Zer0-Dayy/Hydroponics-Monitoring-System/PCB Design/Documentation/PCB Design.png

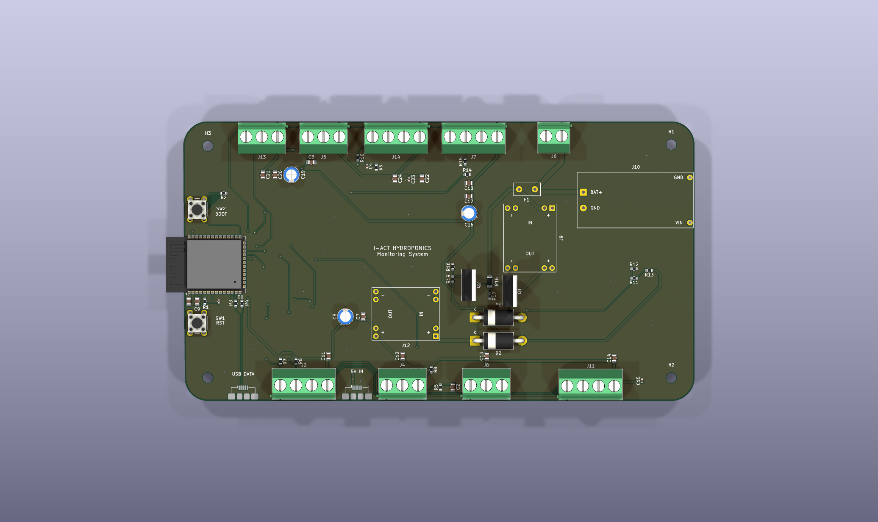
PCB Design/Documentation/PCB Design.png
