Zer0-Dayy/Hydroponics-Monitoring-System/PCB Design/Documentation/PCB Back.png

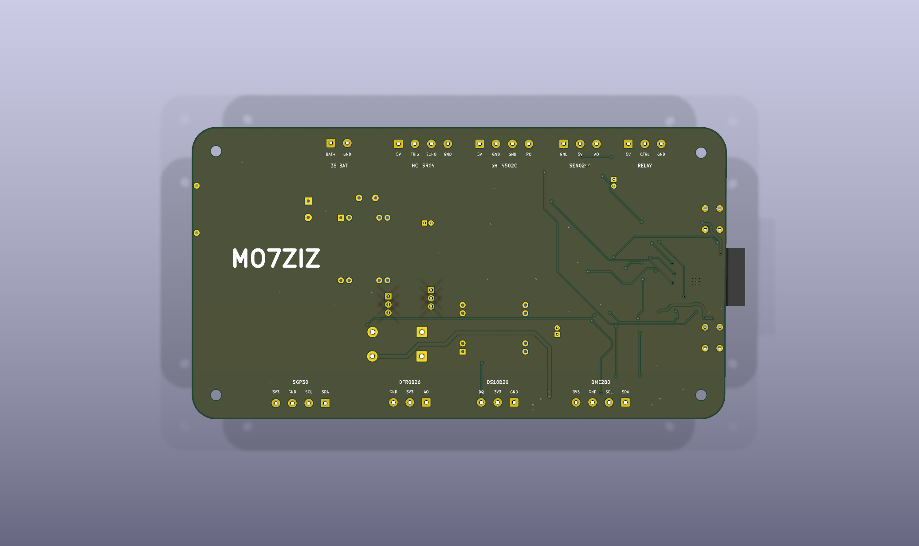
PCB Design/Documentation/PCB Back.png
