Zer0-Dayy/Hydroponics-Monitoring-System/README.md

# Hydroponics Monitoring System

The [project handover](Project%20Handover/Source%20Code/HANDOVER.md) contains earlier source material for reference.
