Zer0-Dayy/Hydroponics-Monitoring-System/Documentation/Power Tree Analysis.pdf

Choice | CN3303
Voltage | 5.00V | Voltage | 12.60V
Current | 3.00E+0 A | Current | 937.07E-3 A
65 W charger: 5 V / 3 A + 5 V / 2 A | Power | 15.00W | Power | 11.81W
Input Voltage | 5V | 3.56E+0 A | 3.00E+0 A | Charger | Boost | 3.00W | 952.38E-3 A | HX-3S-FL25A-A
937.07E-3 A | LiPo 3S 5200 mAh 35C
937.07E-3 A
I-Boost Budget | 0.95238095238
Security Coefficient | 1.2 | Efficiency | 80.0% | R (reference) | 0.100Ω | 0.094 V
Voltage | 12.600V | Voltage | 12.51V
Current | 952.38E-3 A | Current | 937.07E-3 A
Power | 12.00W | Power | 11.72W
587.08E-6 A | Q1 gate network | 489.24E-6 A 220R + 10k | 1
15.31E-3 A | Battery Auxiliaries | 12.76E-3 A Idle (A) | 0.000155
Choice | MP1584
Voltage | 5.00V | Voltage | 4.48V
Current | 423.04E-3 A | Current | 423.04E-3 A
Power | 2.12W | Power | 1.89W
423.04E-3 A | 1N5822 (D1) | 0.53V | 423.04E-3 A | 423.04E-3 A | P3V3 | Buck | 0.28W
487.61E-3 A | 426.00E-3 A | ESP32-S3
355.00E-3 A
WROOM-1 | 1
Efficiency | 90% | Efficiency | 85.0%
Voltage | 4.48V | Voltage | 3.300V | 856.80E-6 A | Air T / RH / P
714.00E-6 A
Current | 423.04E-3 A | Current | 487.61E-3 A | BME280 | 1
Power | 1.89W | Power | 1.61W
1.80E-3 A | Water temperature
1.50E-3 A
DS18B20 | 1
58.56E-3 A | Air quality (ref.)
48.80E-3 A
SGP30 | 1
396.00E-6 A | Ambient light
330.00E-6 A
DFR0026 | 1
96.06E-3 A | SL-C relay coil
80.05E-3 A
SRD-05VDC | 1
Voltage | 5.00V
Current | 37.20E-3 A
Power | 0.19W
37.20E-3 A | USB 5 V
37.20E-3 A | 18.00E-3 A | Ultrasonic
15.00E-3 A
| | HC-SR04 | 1
R (ideal) | 0.000Ω | 0.000 V
Voltage | 5.00V
Current | 37.20E-3 A
Power | 0.19W
Voltage | 5.00V
Current | 19.20E-3 A
Power | 0.10W
19.20E-3 A
Ferrite bead
19.20E-3 A | 12.00E-3 A | pH sensor
10.00E-3 A
| | PH-4502C | 1
DCR | 0.100Ω | 0.002 V
Voltage | 5.00V | 7.20E-3 A | TDS sensor
6.00E-3 A
Current | 19.20E-3 A | SEN0244 | 1
Power | 0.10W

| | | | | Choice | MP1584 | | | | | | Choice | MP1584
Voltage | 11.10V | Voltage | 11.08V | Voltage | 5.00V | Voltage | 4.99V | Voltage | 4.46V
Current | 225.35E-3 A | Current | 225.17E-3 A | Current | 424.04E-3 A | Current | 424.04E-3 A | Current | 424.04E-3 A
LiPo 3S 5200 mAh, 35C (11.1 V nominal) | Power | 2.50W | Power | 2.49W | Power | 2.12W | Power | 2.12W | 5V MAIN | Power | 1.89W
Input Voltage | 11.1V | 225.35E-3 A | HX-3S-FL25A-A / 2 A fuse | 225.35E-3 A | P5V00 | Buck | 0.37W

424.04E-3 A
| | | | | | | | IRLZ44N (Q2)

424.04E-3 A
1N5822 (D2) | 0.53V
424.04E-3 A | 424.04E-3 A
P3V3 | Buck | 0.28W
487.61E-3 A | 426.00E-3 A | ESP32-S3
355.00E-3 A
WROOM-1 | 1
Security Coefficient | 1.2 | R (reference) | 0.100Ω | 0.023 V | Efficiency | 85.0% | Rds | 0.025Ω | 0.011 V | Efficiency | 89% | Efficiency | 85.0%
Voltage | 11.08V | Voltage | 5.000V | Voltage | 4.99V | Voltage | 4.46V | Voltage | 3.300V | 856.80E-6 A | Air T / RH / P
714.00E-6 A
Current | 225.35E-3 A | Current | 424.04E-3 A | Current | 424.04E-3 A | Current | 424.04E-3 A | Current | 487.61E-3 A | BME280 | 1
Power | 2.50W | Power | 2.12W | Power | 2.12W | Power | 1.89W | Power | 1.61W
1.80E-3 A | Water temperature
1.50E-3 A
DS18B20 | 1
176.61E-6 A | Battery auxiliaries
147.18E-6 A
Idle (A) | 0.0000375 | 58.56E-3 A | Air quality (ref.)
48.80E-3 A
SGP30 | 1
396.00E-6 A | Ambient light
330.00E-6 A
USB absent: relay, HC-SR04 and pH/TDS OFF. | DFR0026 | 1
