Zer0-Dayy/Hydroponics-Monitoring-System/Documentation/Hydroponics Firmware.pdf

# Writing

# ESP32 Firmware

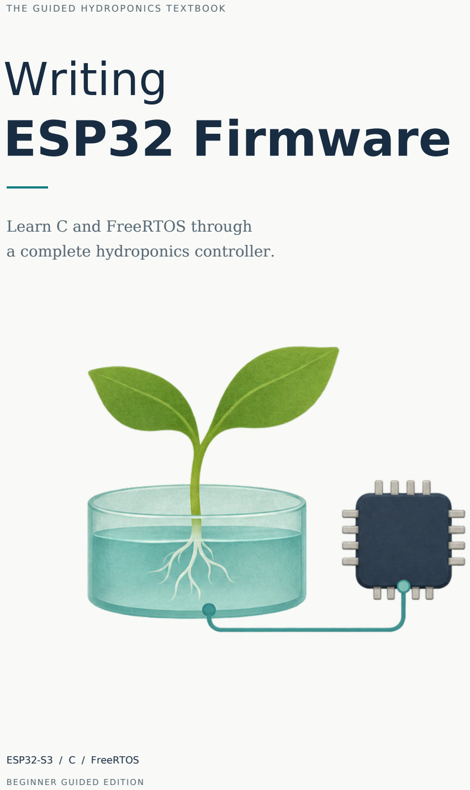
[picture p4: page 1]

THE GUIDED HYDROPONICS TEXTBOOK

## Learn C and FreeRTOS through

a complete hydroponics controller.

ESP32-S3 / C / FreeRTOS

BEGINNER GUIDED EDITION

# You are going to read

a complete controller.

### A line of firmware should tell you what changes, when it changes and which earlier fact makes that change valid. When a line is difficult, we will slow down and supply the

missing C or RTOS concept before asking you to follow it.

### The opening lessons build small examples you can calculate yourself. Then each chapter turns to the production files that use those ideas. We will read their complete source in

manageable sections. You will see declarations, normal paths, error paths and cleanup, rather than only the attractive part of a function.

### The program is a hydroponics controller for an ESP32-S3. It uses C for most application

code, FreeRTOS for task execution, and two C++ adapters for BLE and Wi-Fi libraries.

### Seven physical sensors produce ten metrics. Acquisition obtains observations; Safety

owns the relay decision; other services coordinate power, settings and communication.

### You need basic familiarity with variables, an if statement and a loop. Pointers, storage duration, queues, notifications, driver tables, callbacks and state machines are developed as the controller needs them. You can pause and use the linked earlier lesson

when a detail has faded.

### The source here is the reference implementation carried by the supplied Hydroponics firmware book. File paths and line numbers name that fixed source. We preserve its code while examining its assumptions. A comment about a design budget or a past

measurement is not a new measurement made by reading the program.

### Keep a notebook or editor beside the book. At each guard, predict which branch a concrete input takes. At each state update, name the object that changes. At each return, name the next caller that can make progress. Those small predictions connect

the language to the system.

WRITING ESP32 FIRMWARE | 2

# Read with two questions: why, then how?

### Lessons before the production files

### Begin each chapter with the worked concept lessons. The following source readings use that vocabulary immediately. The source contents pages let you reopen a file directly

when reviewing the controller.

### Every source range has a location

### The code boxes show the path and original line numbers. Every line in the supplied application, adapters, bring-up programs and native tests is present. A grey > marks a

visual continuation. It is not a character to type into the source.

### Use the links as memory aids

### Blue lesson references include printed page numbers. Function calls inside production listings also link to their implementation when the target is unambiguous. Your viewer's Back command returns from a jump. Margin notes appear only for a useful tip, pitfall or

reminder; other pages use the full reading width.

### Keep teaching code and production code distinct

### A teaching example simplifies one question. Production listings carry their real file paths. The small learning program is a separate target; its fabricated input helps you

observe task communication before connecting a probe.

### Keep the original files nearby

Reference_Firmware_Source.zip and Learning_Program.zip are embedded in this PDF.

### Extract them from a desktop PDF viewer's Attachments panel when you want to compile or compare the files. The printed ranges are for reading; the archive supplies exact

bytes.

### Ask what the next owner is allowed to assume

A copied value may still be stale. A READY driver may still report a failed observation. A

### queued command may still be waiting to apply. Each chapter follows those distinctions into the next relevant caller without requiring you to understand an unseen

implementation first.

# Contents

01 Make One Decision | 13

Begin with a value and a decision that you can trace yourself.

02 Read C As Instructions | 17

Read declarations, branches and arithmetic by predicting their results.

03 Use Addresses And Records | 22

Give a value an address, then put related values into one record.

04 Make State And Files Predictable | 28

Understand what survives a call and how a program is assembled.

05 Let Two Jobs Share A CPU | 39

Learn what the scheduler saves, selects and waits for.

06 Move Values Through Queues | 52

Make a sender and receiver exchange an actual copy.

07 Wake For A Reason Or A Deadline | 60

Use notifications for prompts, clocks for due times, and retained state for facts.

# Contents / continued

08 Protect Shared State | 70

Choose protection from the operation that must stay indivisible.

09 Write A Driver In Steps | 78

Replace a physical wait with remembered state and a due time.

10 Decide Whether A Reading Is Usable | 90

A number needs identity, timing and a validity verdict.

11 Build The Light Measurement | 114

Use one analog path to connect voltage, time, filtering and a Reading.

12 Read The BME280 Over I2C | 149

Separate bus transactions from conversion and compensation.

13 Wait For Water Temperature | 182

Use a long conversion without freezing the acquisition service.

14 Turn A pH Voltage Into A Claim | 213

Recover the module voltage, then justify its calibration.

# Contents / continued

15 Compensate The TDS Estimate | 234

Make a measurement dependency explicit instead of assuming 25 degrees.

16 Keep The SGP30 On Its Cadence | 269

Understand a driver whose past affects its present result.

17 Measure An Ultrasonic Pulse | 309

Separate microsecond edge timing from task scheduling.

18 Read The Acquisition Engine | 338

Bring the individual drivers together without giving up their timing rules.

19 Give Safety The Final Decision | 393

Combine a lamp request, alarm state and input validity in one output owner.

20 Survive A Power Transition | 463

Move ownership only after the old owner stops using shared hardware.

21 Save And Apply Configuration | 519

Separate accepting a request, storing it and using it.

# Contents / continued

22 Encode And Decode Messages | 567

Move between bounded bytes and explicit application requests.

23 Build The BLE Device Link | 628

Keep callback work short and deliver commands through their owners.

24 Manage A Wi-Fi Station | 675

Reconnect in bounded steps without borrowing the sensor path.

25 Bring The Controller To Life | 697

Start dependencies in order and observe meaningful progress.

26 Test The Pure Behaviour | 744

Supply controlled inputs and inspect the exact returned state.

27 Follow Complete Controller Events | 817

Connect code you have read into full execution paths.

# Production source contents

src/domain/types.h | 36
include/app_config.h | 47
src/drivers/sensor_driver.h | 84
src/drivers/sensor_driver.c | 89
src/domain/reading.h | 94
src/domain/reading.c | 99
src/services/snapshot_store.h | 105
src/services/snapshot_store.c | 106
src/domain/sensor_set.h | 108
src/domain/sensor_set.c | 110
src/hal/adc_channel.h | 118
src/hal/adc_channel.c | 120
src/domain/calibration.h | 122
src/domain/calibration.c | 125
src/drivers/light.h | 130
src/drivers/light.c | 133
test/bringup/bringup_harness.h | 142
test/bringup/light_main.c | 147
src/hal/i2c_bus.h | 155
src/hal/i2c_bus.c | 157
src/drivers/bme280.h | 162
src/drivers/bme280.c | 164
test/bringup/bme280_main.c | 179
src/hal/onewire_bus.h | 187
src/hal/onewire_bus.c | 189

# Production source contents

src/domain/ds18b20_codec.h | 196
src/domain/ds18b20_codec.c | 198
src/drivers/ds18b20.h | 200
src/drivers/ds18b20.c | 202
test/bringup/ds18b20_main.c | 210
src/drivers/ph.h | 218
src/drivers/ph.c | 222
test/bringup/ph_main.c | 229
src/domain/tds_codec.h | 238
src/domain/tds_codec.c | 239
src/drivers/tds.h | 240
src/drivers/tds.c | 244
test/bringup/tds_main.c | 251
test/bringup/water_main.c | 255
src/domain/sgp30_codec.h | 272
src/domain/sgp30_codec.c | 273
src/drivers/sgp30.h | 275
src/drivers/sgp30.c | 280
test/bringup/sgp30_main.c | 296
test/bringup/climate_main.c | 299
src/domain/ultrasonic.h | 314
src/domain/ultrasonic.c | 315
src/hal/pulse_capture.h | 316
src/hal/pulse_capture.c | 319
src/drivers/hcsr04.h | 325

# Production source contents

src/drivers/hcsr04.c | 327
test/bringup/hcsr04_main.c | 335
src/hal/clock.h | 345
src/hal/clock.c | 346
src/domain/schedule.h | 347
src/domain/schedule.c | 349
src/services/acquisition.h | 352
src/services/acquisition.c | 357
src/domain/alarm.h | 398
src/domain/alarm.c | 401
include/policy_config.h | 403
src/domain/alarm_sticky.h | 407
src/domain/alarm_sticky.c | 409
src/domain/event_journal.h | 411
src/domain/event_journal.c | 413
src/domain/lamp_control.h | 415
src/domain/lamp_control.c | 417
src/domain/safety_core.h | 420
src/domain/safety_core.c | 426
src/hal/gpio_safe.h | 435
src/hal/gpio_safe.c | 436
src/hal/relay.h | 437
src/hal/relay.c | 438
src/services/safety.h | 439
src/services/safety.c | 442

# Production source contents

test/bringup/lamp_main.c | 458
src/services/rail_state.h | 467
src/services/rail_state.c | 468
src/domain/power_mode.h | 470
src/domain/power_mode.c | 475
src/services/power_coordinator.h | 483
src/services/power_coordinator.c | 485
test/bringup/power_sense_main.c | 493
src/domain/cal_capture.h | 522
src/domain/cal_capture.c | 524
src/domain/config_blob.h | 526
src/domain/config_blob.c | 531
src/services/flash_gate.h | 539
src/services/flash_gate.c | 540
src/services/configuration.h | 542
src/services/configuration.c | 546
src/domain/frame_codec.h | 570
src/domain/frame_codec.c | 572
src/domain/protocol_codec.h | 576
src/domain/protocol_codec.c | 583
src/transports/protocol.h | 619
src/transports/protocol.c | 620
src/transports/frames.h | 621
src/transports/frames.c | 623
src/transports/ble_gatt.h | 633

# Production source contents

src/transports/ble_gatt.cpp | 637
src/transports/ble_transport.h | 649
src/transports/ble_transport.c | 651
src/domain/backoff.h | 677
src/domain/backoff.c | 678
src/transports/wifi_lan.h | 680
src/transports/wifi_lan.cpp | 681
src/transports/wifi_mqtt.h | 683
src/transports/wifi_mqtt.c | 685
include/board_profile.h | 701
platformio.ini | 706
src/hal/arduino_entry.h | 713
src/main.c | 714
src/diagnostics/logger.h | 718
src/diagnostics/logger.c | 719
src/diagnostics/progress.h | 723
src/diagnostics/progress.c | 724
src/services/supervisor.h | 725
src/services/supervisor.c | 727
tools/serial_log.py | 740
.gitattributes | 742
.gitignore | 743
test/native/test_domain/test_main.c | 746
test/native/test_power/test_main.c | 776
test/native/test_protocol/test_main.c | 787

CHAPTER 01 / MAKE ONE DECISION

# What must your program actually do?

### Suppose the water temperature is 24.5 degrees Celsius. Your first job is to obtain that number. Your second job is to decide whether it is suitable for a control decision. Those are different jobs: a disconnected probe can leave an old 24.5 in memory even while the

water is heating.

Teaching example - C
float waterC = 24.5f;
bool tooWarm = waterC >= 30.0f;

### Read the first line as: reserve an object named waterC that holds an approximate real number, and initialise it to 24.5. The f suffix asks for a float constant. Read the second line as: compare waterC with

30.0, then store the comparison result in tooWarm. For this input,

### tooWarm is false. If waterC becomes 31.0 before the comparison, the

result is true.

### Nothing in those two lines reads a sensor. You supplied the number yourself. This is useful: you can first check your decision with known inputs. Later, the sensor driver will supply the number. Keeping that substitution possible is the first reason to separate a decision from

hardware access.

### Why the real firmware carries more fields

### To act on a value, you will eventually need its unit, its age and an indication of whether the measurement succeeded. We will build that record after learning structures. For now, keep one question in mind: what evidence would make this number safe to use?

### In the project, DS18B20 is the water-temperature sensor. The driver produces observations; a service decides how to use them. You do not need either file yet. We will open the driver in the water-temperature chapter (p. 182), when a long conversion gives us

a reason to organise time.

TIP

The 30.0 threshold is a
teaching value. It is not a commissioned limit for
your plants.

COMMON PITFALL

A plausible number is not
proof of a connected or
working sensor.

CHAPTER 01 / MAKE ONE DECISION

# Why one long wait causes trouble

Start with one loop. It asks for a water-temperature conversion,

### waits 750ms, reads the result, and checks the lamp. Assume the

instruction that waits really prevents this loop from advancing.

Teaching pseudocode - helper bodies deliberately omitted
for (;;) {
beginWaterConversion();
waitUntilWaterIsReady(); // up to 750ms readWaterResult();
updateLampDecision();
}

### If you press a lamp-off button 1ms after the wait begins, this loop cannot reach the lamp decision for roughly another 749ms. Making the CPU clock twice as fast does not halve a sensor's physical

conversion time. The delay is in the order of operations.

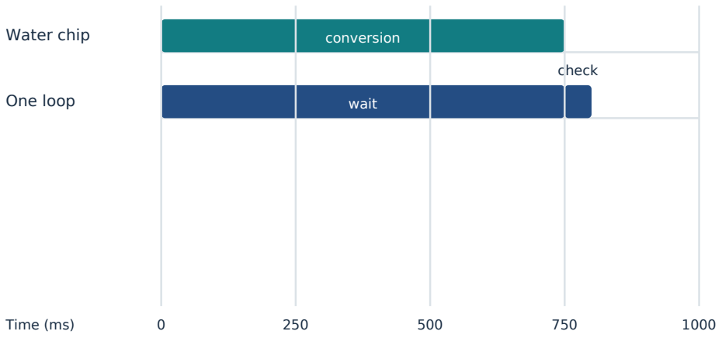
[picture p5: figure]
Water chip; conversion; One loop; wait; check; Time (ms)

Worked example: the sensor is busy while the loop postpones the lamp check.

You have two possible repairs. First, turn the sensor operation into steps: start it, remember when it should finish, and return to other work. Second, put independent work into separate RTOS tasks so one task can wait while another runs. Our firmware uses both repairs. A task organises a service; a stepped driver avoids making

that service wait for every physical conversion.

### Do not choose a task merely because you have a sensor. Seven sensors do not automatically require seven tasks. They may share

buses and benefit from one owner. We will earn that design later, after a two-task example makes waiting concrete.

REMEMBER

A loop only advances when
the current call returns.
Other RTOS tasks may run
if that call blocks through the RTOS.

CHAPTER 01 / MAKE ONE DECISION

# Separate the question from the pin

Teaching example - C
bool waterIsTooWarm(float waterC) { return waterC >= 30.0f;
}

### Call waterIsTooWarm(24.5f). The argument 24.5 is copied into the parameter waterC. The comparison produces false, and return hands that result to the caller. Call it with 31.0f and it returns true. The

function neither knows a GPIO number nor reads a bus.

### Now imagine the physical probe moves to a different pin. You should change the hardware setup, not the comparison. Conversely, a new agreed limit should not force you to rewrite the sensor protocol. That

is a concrete reason for the project's folders.

Folder | Question it answers
hal/ | How do I operate this ESP32 peripheral?
drivers/ | How do I ask this sensor for a measurement?
domain/ | What does this value or event mean?
services/ | When do operations run, and who owns their state?
transports/ | How do external messages enter and leave?

### HAL means hardware abstraction layer: a small set of functions that

hide the peripheral-specific calls. For example,

### adcChannelReadMilliVolts() obtains a voltage. The light driver uses that voltage to produce a Reading. Safety later decides whether the

lamp should be on. Each step has a different reason to change.

### For the next few chapters, we will write tiny functions like the one above. We will not start by memorising the folder tree. When we return to the tree in startup (p. 697), you will already understand the

operations it connects.

COMMON PITFALL

Putting every function in a separate file does not
create a good architecture. Separate responsibilities
that need different
information or change for
different reasons.

CHAPTER 01 / MAKE ONE DECISION

# Trace the value before adding machinery

### Here is a complete small C program for your computer. It uses invented input, so you can check the decision without a sensor or an

ESP32.

Teaching example - C
#include <stdbool.h>

#include <stdio.h>

static bool waterIsTooWarm(float waterC) { return waterC >= 30.0f;
}

int main(void) {
float waterC = 31.0f;
bool tooWarm = waterIsTooWarm(waterC); printf("warm=%d\n", (int)tooWarm); return 0;
}

### Execution enters main(), creates waterC, and calls the function with its value. The called function creates its parameter, evaluates 31.0 >= 30.0, and returns true. printf prints warm=1. The cast (int) makes the intended integer argument explicit. main returns zero to

report normal termination to your computer.

### On a PC with GCC, save this as first.c and run gcc -std=c11 -Wall -Wextra first.c -o first, then run ./first. Change only 31.0f to 24.5f; the printed result becomes warm=0. If you remove the function call, no

decision is computed automatically.

### The ESP32 project starts differently: Arduino calls setup(), and setup creates long-lived tasks. We will reach that entry point in the boot chapter (p. 697). The function call and value-copy rules you just

traced stay the same.

### You can now explain a tiny path from input to output. The next chapter adds enough C to express that path reliably. We will

introduce each operator where it changes the program's behaviour.

TIP

main() here is a PC entry
point. Do not paste it into the production firmware as another entry point.

CHAPTER 02 / READ C AS INSTRUCTIONS

# A declaration gives a value a place

Teaching example - C
#include <stdint.h>

#include <stdbool.h>

uint32_t elapsedMs = 750;
float waterC = 24.5f;
bool valid = true;

### uint32_t is an unsigned integer type with exactly 32 bits. It can represent 0 through 4294967295. It has no negative values. float can represent fractions, approximately. bool holds false or true. Choosing a type states which values you expect and which operations make

sense.

### The text after = is an initializer. It supplies an object's first value. An ordinary local declaration such as uint32_t elapsedMs; does not give you a meaningful starting number. Reading that local before

assigning a value is an error. Set a starting value when you create it.

### Names and types do different jobs

Teaching example - C
typedef uint64_t MonoMs;
MonoMs now = 1000;
MonoMs deadline = now + 750;

### typedef gives an existing type another name. MonoMs helps you remember that the number is monotonic milliseconds: elapsed time within this run, unaffected by a correction to the calendar clock. It does not create a clock and does not prevent you from accidentally

assigning microseconds. In this example, deadline becomes 1750. Our project defines this alias in src/domain/types.h.

### A semicolon ends a declaration or expression statement. Braces group a function body or control-flow body. Indentation helps you read the grouping; C uses the braces, not the indentation, to decide it. We will use braces even around short if bodies in teaching

examples.

### The exact-width types come from stdint.h; bool in this C11-style source comes from stdbool.h. An include makes those declarations

available to the compiler. It does not read a sensor or run a function.

COMMON PITFALL

uint32_t is a type, not a
unit. A variable containing 750 could mean
milliseconds, microseconds or ADC counts; your
naming and interface must
say which.

CHAPTER 02 / READ C AS INSTRUCTIONS

# Read a function call in both directions

Teaching example - C
static float echoToMm(uint32_t widthUs) { return (float)widthUs * 343.0f / 2000.0f; }

float distanceMm = echoToMm(1000);

At the call, evaluate the argument 1000. Copy it into widthUs. Enter the body. Convert the integer to float, multiply by 343.0, divide by 2000.0, then return 171.5. The caller stores that result in distanceMm. A return type tells you what comes back; the parameter list tells you what must go in.

void as a return type means there is no returned value. void in an otherwise empty parameter list means the function takes no parameters. A function can still change objects through pointer parameters; we will introduce that mechanism in output parameters (p. 23).

### A local name does not escape with the result

widthUs is a parameter local to this call. Returning its calculated value does not give the caller access to that parameter object. If another call uses 2000, it gets its own parameter value and returns 343.0. Keep this copy behaviour in mind: a normal argument does not let the function rewrite the caller's variable.

A grey > at the start of a displayed code line marks a wrapped continuation. It is a page-layout mark, not a character to type into your C source. The attached source retains its original lines.

The initial static makes this function name private to this C translation unit. For now, read it as: this helper is for this file. We will separate that meaning from persistent storage in the static lesson (p. 28).

This calculation will be useful in the ultrasonic chapter (p. 309). There, an interrupt will provide widthUs. The arithmetic will remain simple because we will have separated obtaining the pulse width from converting it.

### The speed 343m/s is the reference firmware's nominal value. It is not temperature

compensated.

CHAPTER 02 / READ C AS INSTRUCTIONS

# Reject a bad input before using it

Teaching example - C
bool accepted = false;
if (valid && waterC >= 30.0f) { accepted = true;
}

### && means logical AND. C evaluates valid first. If it is false, the second comparison is not evaluated. If it is true, C evaluates waterC >= 30.0f. Only two true operands enter the body. This evaluation

order is called short-circuit evaluation.

### Read valid && waterC >= 30.0f in order: first decide whether the observation is eligible; then compare its number. A guard is an early check that rejects an input before an operation that requires it. The next chapter will apply the same order to a pointer: check that an

object exists before reading through its address.

Expression | Meaning
a = b | Assign b to a.
a == b | Compare for equality.
a != b | Compare for inequality.
!ready | True when ready is false.
a || b | True when either operand is true.

### A comparison does not remember a previous decision. Each evaluation uses the values available then. To keep the lamp's previous command inside a threshold band, we will need a stored state, not just a longer condition. You will see that in lamp hysteresis

(p. 393).

COMMON PITFALL

if (ready = true) assigns
true and then tests it. It usually enters the branch. Use == for comparison, or
simply if (ready).

REMEMBER

&& and || can skip their
right operand. Put a
required safety check
before the operation it
protects.

CHAPTER 02 / READ C AS INSTRUCTIONS

# Units decide the arithmetic

Teaching example - C
uint32_t widthUs = 1000;
float wrong = widthUs / 2000;
float right = (float)widthUs / 2000.0f;

### Both operands of the first division are integers. The quotient is the integer 0; assigning it to float later gives 0.0. The second expression performs floating-point division and gives 0.5. The destination type

does not change an operation that has already happened.

### For distance, multiply by speed as well: 1000 microseconds times 343 metres per second equals 343000 micrometres. Divide by two for the outgoing and returning path, then by 1000 to convert micrometres to millimetres. That gives 171.5mm. The code combines

those last factors as /2000.0f.

### Bits are useful when several yes/no facts travel together

Teaching example - C
uint16_t flags = 0;
flags |= (1u << 3);
bool late = (flags & (1u << 3)) != 0;

1u << 3 moves the one bit three places left: binary 00001000,

### decimal 8. |= keeps existing set bits and adds this one. & keeps only

the bit positions present in both operands. Here late becomes true.

### The firmware uses this pattern for qualityFlags; a measurement may

be both uncompensated and late.

### Integer overflow is another reason to inspect operands. If a

multiplication needs 64 bits, cast an operand before multiplying.

### Writing uint64_t result = (uint64_t)a * b makes that multiplication

wide; casting the already-overflowed result would be too late.

COMMON PITFALL

0.1 is not stored exactly in ordinary binary float.
Compare measured values
with meaningful
tolerances, not equality
tests against every decimal you expect.

REMEMBER

& has two meanings:
bitwise AND between
values, and address-of
before one object. The
position tells you which
meaning applies.

CHAPTER 02 / READ C AS INSTRUCTIONS

# Read a byte before interpreting it

Teaching example - hexadecimal notation
uint16_t raw = 0x0190; | // the same number as 400
uint8_t high = 0x01; | // 1
uint8_t low | = 0x90; | // 144
// 1 * 256 + 144 = 400

The prefix 0x writes an integer in base 16. Its digits are 0 through 9,

### then A through F for ten through fifteen. Moving one digit left

multiplies its place value by 16. Thus 0x90 means 9 times 16, or 144.

### Hexadecimal does not change the number stored; it gives you a

convenient way to see groups of four bits.

On this target, a byte is eight bits. Two hexadecimal digits describe one byte, and a sixteen-bit quantity occupies two bytes. high and low above name the numerical parts of 400. A device protocol still decides which byte travels first. DS18B20 sends low first; the gas protocol sends its word's high byte first. We will decode each from its

own documented order.

### The suffix u, as in 1u, requests an unsigned integer constant. The f in 24.5f requests float. These suffixes affect C arithmetic types; neither suffix adds a physical unit. A field called raw could contain ADC counts, a temperature code or microseconds, so its interface must

state the interpretation.

REMEMBER

Representation comes first: bytes, order and scale. The physical unit comes from
the driver contract.

CHAPTER 03 / USE ADDRESSES AND RECORDS

# A pointer stores an address

Teaching example - C
float waterC = 24.5f;
float *p = &waterC;
*p = 26.0f;

### waterC is the object holding a float. &waterC asks for its address. p is a second object, a pointer, which stores that address. *p means the float object at the address stored in p. The final assignment therefore

changes waterC to 26.0. It does not replace p's address.

Pointer p
stores 0x1000

Object value
26.0 at 0x1000

*p

&value gives the address; *p uses the object there.

Illustrative addresses: the actual numeric addresses depend on the build.

### In a declaration, float *p says that p has pointer-to-float type. In an expression, *p accesses the pointed-to object. The same symbol appears in two different grammatical roles. Read the full statement

before deciding what the star does.

### Copying p copies an address. It does not create another waterC. If q = p, then *q and *p refer to the same float. Changing that object through either pointer is visible through the other. This will matter

when two tasks receive addresses into shared memory.

### A pointer is useful only while the target object exists and the address is appropriate for that type. NULL is a deliberate missing pointer. An uninitialised pointer is not a useful substitute for NULL. Do not

dereference either one.

### We will use & when asking a queue to copy an object, and * when a helper fills caller-owned storage. Neither operation means that a

task automatically gets private or protected memory.

COMMON PITFALL

float *p creates a pointer object. It does not reserve another float for p to point to. Supply the address of a real object before using *p.

CHAPTER 03 / USE ADDRESSES AND RECORDS

# Let a function fill your object

Teaching example - C
static bool readFake(float *out) { if (out == NULL) {
return false;
}
*out = 24.5f;
return true;
}

float waterC = 0.0f;
bool ok = readFake(&waterC);

### At the call, &waterC is copied into out. The pointer itself is passed by

value, just like the earlier integer parameter. Inside the function,

### *out = 24.5f follows that copied address and changes the caller's

waterC. The function returns true separately to report success.

### You now have two outputs with different purposes: waterC contains the measurement, and ok tells you whether the function supplied one. If readFake returns false, the caller must not pretend a fresh

result exists. This is the pattern behind many HAL functions.

### This will be useful when the ultrasonic HAL writes the captured width into a variable supplied by its caller. We will already understand the output-parameter syntax when we reach

pulseCapturePoll().

COMMON PITFALL

readFake(waterC) passes
the number.
readFake(&waterC) passes
its address. The function
declaration tells you which one it needs.

REMEMBER

Return values often report success or status; pointer parameters can carry the
actual data.

CHAPTER 03 / USE ADDRESSES AND RECORDS

# Keep facts about one result together

Teaching example - C
typedef struct {
float valueC;
uint64_t measuredMs;
bool valid;
} Sample;

Sample a = { .valueC = 24.5f, .measuredMs = 1000,
.valid = true };

### A structure groups several fields into one object. a.valueC selects the float field inside a. a.measuredMs selects its timestamp. The dot in the initializer names the field being initialised; the dot in a.valueC selects the field later. Initializers with field names make a long

record easier to check.

Teaching example - C
Sample b = a;
a.valueC = 99.0f;

### The assignment copies the record's field values. b.valueC remains 24.5. b does not become another name for a. This is the reason a queue can pass a small measurement by copy: the receiver can own

its own record after the sender continues.

### Be careful when a structure contains pointers. Copying such a structure copies its pointer fields, not the objects those pointers

identify. Two copied pointer fields can still reach the same buffer.

### Our simple Sample has only values, so it avoids that extra ownership

problem.

### The project's Reading is a larger record with the same purpose. It keeps a value, identity, unit, timing and validity information together. We will open its complete declaration in the Reading lesson

(p. 90), after we know why tasks need a message.

COMMON PITFALL

Do not send a native C
structure directly as a
network format. Padding,
byte order and type
representation need an
explicit encoding.

REMEMBER

The compiler may insert
padding between fields to
meet alignment rules.
sizeof(Sample) can exceed
the sum of field sizes.

CHAPTER 03 / USE ADDRESSES AND RECORDS

# Read the arrow and const precisely

Teaching example - C
Sample a = { .valueC = 24.5f, .valid = true }; Sample *p = &a;
p->valueC = 26.0f;

p->valueC means (*p).valueC: follow the pointer, then select a field.

### The arrow combines those two operations. a.valueC uses a structure object directly. p->valueC uses a pointer to one. The final line

changes a.valueC to 26.0.

Teaching example - C
const Sample *view = &a;
Sample *const fixed = &a;

### Through view, you may read the Sample but may not change its fields. You may assign view another address. fixed is a pointer whose stored address cannot change after initialisation, but its target remains writable. Thus fixed->valueC = 27.0f is allowed; fixed =

anotherPointer is not.

Declaration | What is restricted?
const Sample *p | Changes through p to the Sample.
Sample *const p | Changes to p's address.
const Sample *const p | Both forms of change through this declaration.

### const describes access through a declaration. It is not a lock. If another permitted pointer changes a, view can observe the new value. It also does not extend a's lifetime. We will use const Reading * when a rule should inspect a measurement without editing the

supplied record.

### When you see const SensorDriverOps *ops later, read it as a pointer to an operations table that this access path cannot modify. We will build that table only after a stepped driver gives us a reason to call

different implementations.

COMMON PITFALL

const does not make a
shared record immune to
concurrent writes.
Synchronisation is a
separate question.

CHAPTER 03 / USE ADDRESSES AND RECORDS

# Read a real output-parameter call

You can now read both the output pointers and the arrow in a real HAL helper. AdcChannel is a

### record describing one ADC channel. Its pin_ field holds the assigned GPIO number. We will

examine the ADC setup and clipping threshold in the analog chapter; here, follow where the returned information is written.

Original firmware - src/hal/adc_channel.c, lines 23-32
bool adcChannelReadMilliVolts(AdcChannel* ch, uint32_t* mv, bool* saturated) { if (mv) *mv = 0;
if (saturated) *saturated = false;
if (ch->pin_ < 0) return false;
// eFuse-calibrated conversion (esp_adc_cal). One conversion, a few tens of us. const uint32_t value = analogReadMilliVolts((uint8_t)ch->pin_);
if (mv) *mv = value;
if (saturated) *saturated = value >= kSaturationMv;
return true;
}

### Here mv and saturated are output pointers. The HAL can return a voltage through one and a

clipping indication through the other. if (mv) tests whether the pointer is non-null before writing through it. value is an ordinary local number returned by the Arduino ADC function.

The source allows omitted outputs by accepting NULL, but a teaching helper does not have to. Decide whether an output is required and enforce the contract. A pointer parameter alone does not tell you whether NULL is permitted.

### Follow a successful call with local variables voltageMv and clipped. The caller supplies &voltageMv and &clipped. Inside the function, mv and saturated hold those addresses. *mv

writes the voltage into the first caller object; *saturated writes a true/false clipping result into the second. The returned bool is a third result: whether the call could perform this operation.

### The earlier readFake example (p. 23) required its output pointer. This HAL permits either

output to be omitted. Read the null checks in each interface rather than assuming every pointer parameter follows the same rule.

CHAPTER 03 / USE ADDRESSES AND RECORDS

# Arrays provide storage; pointers do not count it

Teaching example - C
uint32_t samples[4] = {100, 101, 99, 102};
uint32_t first = samples[0];
size_t count = sizeof(samples) / sizeof(samples[0]);

### This array reserves four consecutive uint32_t objects. The valid indices are 0, 1, 2 and 3. samples[4] is outside the array. first becomes 100, and count becomes 4 because the expression still sees

the actual array object.

Teaching example - C
static float mean(const uint32_t *values, size_t n) { uint64_t sum = 0;
for (size_t i = 0; i < n; ++i) {
sum += values[i];
}
return n ? (float)sum / (float)n : 0.0f; }

### At a call such as mean(samples, 4), the array expression supplies a pointer to its first element. The function does not receive the array's size automatically. n is the length the caller promises. The loop visits exactly n elements. A false promise can make it read outside valid

storage.

++i adds one to i. The condition i < n is checked before each visit.

### The ?: operator chooses its middle expression when n is nonzero and

its last expression when n is zero. Here it prevents division by zero,

### although a production interface might report an explicit error

instead.

### size_t is an unsigned integer type used for object sizes and array lengths; sizeof produces a size_t result. Include stddef.h when a standalone C file needs that type. A size_t can hold a size supported

by the target, but it does not make an incorrect buffer length safe.

### Strings are byte arrays with a zero byte marking the end. A char buffer[8] can hold at most seven ordinary single-byte characters plus that terminator. A received radio payload is not automatically a terminated string; later we will pass an explicit length into its

decoder.

COMMON PITFALL

A pointer and a length
must agree. Checking n
alone does not prove that
values points to n real
elements.

REMEMBER

sizeof(pointer) is the size of an address object, not the length of the buffer behind it.

CHAPTER 04 / MAKE STATE AND FILES PREDICTABLE

# What static actually keeps

Teaching example - C
static uint32_t countVisits(void) { static uint32_t count = 0; ++count;
return count;
}

Call this function three times during one run. It returns 1, then 2,

### then 3. The local static count exists for the program's lifetime, even

while no call is executing. Its name is visible only inside this function. A normal local initialised to zero would start over on each call.

The first static, before the function's return type, has a different role.

### It gives the function name internal linkage: another separately compiled C file cannot call it by that name. It does not make a private

task stack or prevent two tasks from calling the function together.

Teaching example - C
static Sample latest; // file scope

At file scope, static keeps the name private to this translation unit.

### The object also has static storage duration. A file-scope object without static would still live for the program's lifetime; the visibility of its name would differ. Static-storage objects without an explicit

initializer are zero-initialised before application execution.

Persistent in this context means until reset or program termination.

### It does not mean saved in flash. To retain calibration across an ESP32 reboot, the Configuration service writes NVS, which we will

study in saved configuration (p. 520).

### If two tasks call countVisits(), they share the same count. ++count is a read-modify-write sequence. Without protection, concurrent calls can lose an increment. A private C name is not a synchronisation mechanism. This distinction will matter when we inspect the

acquisition module's static driver objects.

COMMON PITFALL

static is not one copy per task. A static local belongs to the program, even when
its declaration sits inside a task function.

CHAPTER 04 / MAKE STATE AND FILES PREDICTABLE

# Keep an address valid for long enough

Teaching counterexample - deliberately incorrect
static Sample *badAddress(void) {
Sample temporary = { .valueC = 24.5f }; return &temporary; // invalid after return }

### temporary has automatic storage duration. Once the function returns, that object's lifetime ends. Its old address does not become safe because the bytes happen to remain unchanged for a while. A

later call may reuse the storage. Do not use the returned pointer.

Storage | When does the object stop existing?
Automatic local | At the end of its enclosing block; each call has its own instance.
Static object | At program termination or reset in this firmware.
Allocated heap block | When released with the matching allocator's free operation.

### A task keeps its current automatic locals while it is blocked. Blocking is not returning from the function. The RTOS preserves the task's execution state so it can resume. This is why a local variable inside a

task loop can still be valid after xQueueReceive waits.

Heap allocation asks for storage at runtime. You must check failure,

### decide who owns the block, and free it exactly once when appropriate. The project often supplies static queue storage and task stacks instead. That makes much of its memory reservation visible

before tasks begin.

Static allocation does not prove that the reservation is large enough. Stack overflow is still possible, and a buffer index can still be wrong.

### We will inspect actual stack usage and checks in debugging memory

(p. 699).

REMEMBER

A queue that copies a
record can safely copy a
local before it goes out of scope. A queue that copies its pointer does not extend that local's life.

CHAPTER 04 / MAKE STATE AND FILES PREDICTABLE

# A header lets the compiler check a call

Teaching example - two files shown together
// water.h
#pragma once

#include <stdbool.h>

bool waterIsTooWarm(float waterC);

// water.c
#include "water.h"

bool waterIsTooWarm(float waterC) { return waterC >= 30.0f;
}

### The header declares the interface: function name, return type and parameter types. The .c file defines the body. A caller includes water.h so the compiler can check its arguments. The compiler builds each source file into an object file; the linker then resolves

calls between those object files.

### #include is a preprocessing operation. It makes header text available

while compiling. It does not call the functions declared there.

### pragma once prevents a header from being processed repeatedly in one translation unit on this toolchain. A translation unit is one source

file after its includes and preprocessing have been applied.

Teaching example - C
// in a header
extern uint32_t sampleCount; // in exactly one .c file
uint32_t sampleCount = 0;

COMMON PITFALL

Do not put ordinary
writable global definitions in a header included by
several .c files. You may
create multiple definitions rather than one shared
object.

CHAPTER 04 / MAKE STATE AND FILES PREDICTABLE

### A header lets the compiler check a call / continued

extern declares an externally defined object without making another ordinary definition here. Prefer functions that return copies of shared state when you can; a globally writable object makes ownership harder to see. The firmware's snapshotPeek() interface is an example we will read in the snapshot store (p. 57).

You will also see small function bodies written as static inline in a header. static gives each

### translation unit its own internally linked helper. inline allows the compiler to consider

expanding that helper at a call site; it does not guarantee that choice or create a task. The shared types header uses this form for small timestamp comparisons.

If compilation fails, ask whether a declaration or type is visible. If linking fails with an undefined reference, ask whether the defining source was built and whether its symbol has the expected linkage. These are different stages, so they need different repairs.

CHAPTER 04 / MAKE STATE AND FILES PREDICTABLE

# Name outcomes instead of guessing numbers

Teaching example - C
typedef uint8_t Status;
enum { STATUS_OK = 0, STATUS_PENDING, STATUS_FAULT };

Status st = STATUS_PENDING;
if (st == STATUS_PENDING) {
// The operation has not finished yet. }

### The anonymous enum supplies named integer constants. With the

explicit zero first, STATUS_PENDING is 1 and STATUS_FAULT is 2.

### The typedef makes Status an alias for uint8_t. This project uses that

pattern to keep record fields small and their intent readable.

### The name is a reading aid, not a distinct type barrier: Status and another uint8_t alias can still be assigned to one another in C. Use clear parameter names and checks where an accidental interchange

would matter.

### Completion and validity are different questions

### A driver can finish an operation and report that the measurement failed. In this project, DRIVER_READY means the driver has an outcome available. The returned Reading may carry HEALTH_TIMEOUT or HEALTH_FAULT. READY does not guarantee

a usable physical value.

### Why keep both? The acquisition engine needs to know when it can collect an outcome and start scheduling the next job. A consumer needs to know whether the stored number may be used. Combining

those questions into one boolean would hide useful information.

### The production driver interface will use a PollResult record

containing a status and the earliest sensible time to poll again.

### Before opening that interface, read two more C operations used throughout these files: selecting a named status and copying a byte

range. Then we can ask what an RTOS task does while it waits.

COMMON PITFALL

Do not write if (status)
unless the interface defines truthiness. STATUS_OK is
zero here, so a successful outcome would test false.

CHAPTER 04 / MAKE STATE AND FILES PREDICTABLE

# Choose one branch with switch

Teaching example - uses Status from the previous lesson
static const char *statusName(Status st) { switch (st) {
case STATUS_OK: | return "OK";
case STATUS_PENDING: return "PENDING";
default: | return "FAULT";
}
}

### switch evaluates st, then begins at the case whose integer constant matches. With STATUS_PENDING, execution starts at the second case and returns the string "PENDING". default handles a value that matches no listed case. Here the return type is a pointer to

characters that this function does not permit you to change.

A case label does not automatically end its branch. In this example,

### return ends the whole function. In a branch that should continue

after the switch, break exits just the switch. Without either,

### execution continues into the following case; this is called

fall-through.

Teaching fragment - accepted is a previously declared bool
switch (st) {
case STATUS_OK:
case STATUS_PENDING:
accepted = true;
break;
default:
accepted = false;
break;
}

### The two adjacent labels deliberately share one body. Either OK or

PENDING assigns true, then break skips the default branch. Later,

### reading.c groups several metric labels this way because one BME280 produces temperature, humidity and pressure. You now know why

several cases can lead to one return.

COMMON PITFALL

A missing break can
execute the next case
body. Check where every
branch actually ends.

CHAPTER 04 / MAKE STATE AND FILES PREDICTABLE

# Copy the bytes of a complete object

Teaching fragment - Sample was defined in the records lesson
#include <string.h>

Sample a = { .valueC = 24.5f,
.measuredMs = 1000, .valid = true }; Sample copied;
memset(&copied, 0, sizeof(copied)); memcpy(&copied, &a, sizeof(copied));

### memset receives a destination address, a byte value and a byte count. This call fills every byte of copied with zero. It does not fetch a

measurement. memcpy then receives destination, source and count; it replaces those bytes with the complete representation of a. string.h declares both functions.

After the copy, copied.valueC is 24.5, copied.measuredMs is 1000 and copied.valid is true. Changing a.valueC afterward does not change copied.valueC. For this record, copied = a would be the clearer ordinary assignment. The byte functions matter because you will also see fixed buffers, queue storage and checksum-covered

records.

The count is sizeof(copied), the size of the whole destination object,

### including any padding. sizeof(&copied) would instead give the size of a pointer and copy the wrong amount. Both addresses must name enough live storage; memcpy does not check your promise. Its ranges must not overlap. Use memmove when the ranges can

overlap, as when shifting an existing byte history.

### Zero-filled bytes are not a universal constructor for every C type. Use the type's initializer or reset helper when you need a meaningful

initial state. In this example the complete copy follows immediately, so we do not interpret the intermediate zero-filled record. Later,

### ConfigBlob deliberately initialises its bytes before calculating a

checksum that also covers padding.

REMEMBER

A byte count describes
storage. It does not prove that the address points to that much storage.

CHAPTER 04 / MAKE STATE AND FILES PREDICTABLE

# Choose code before the program runs

Teaching fragment - preprocessing choices
#define SAMPLE_PERIOD_MS 1000u

#ifdef FW_ENABLE_BLE

void startRadio(void);
#endif

### A macro is a name the preprocessor replaces while preparing a source file for compilation. SAMPLE_PERIOD_MS becomes the token 1000u wherever this macro is used. The define does not create a writable variable, reserve a timer or make a task periodic. A later

function call must use that value to do something.

### #ifdef asks whether a macro name is defined. Its enclosed text

reaches the compiler only in that case. #endif closes the choice;

### else can supply another branch. This differs from a C if statement: an ordinary if chooses while the program runs, whereas

preprocessing chooses which source is compiled into the image.

### A build option such as -D FW_ENABLE_BLE=1 defines the name without adding a define line to the source. With #ifdef, even defining it as zero still counts as defined. The firmware uses these choices to omit radio implementations from isolated bring-up images. You will

recognise those blocks before needing to understand their contents.

### The shared types header follows the enum lesson because it uses enum, typedef and static inline together. Later headers reuse those names through #include. The chain is now concrete: preprocessing supplies declarations, compilation checks each file, and linking

connects the built functions.

Reference: WG14: public C11 committee draft N1570 (https://www.open-std.org/jtc1/sc22/wg14/www/docs/n1570.pdf)

COMMON PITFALL

Changing a macro changes
the next build. It cannot
change the program
already flashed onto the
board.

CHAPTER 04 / MAKE STATE AND FILES PREDICTABLE

# Give time an explicit representation

### You can now read typedef, enum, static inline and a header declaration. This production header combines those ideas into the vocabulary every other file uses: timestamps, sensor identity, metric

identity and units.

### A Reading uses these names later; for now recognise which category each field belongs to. Review the enum lesson (p. 32) for the

numbered names before following their production lists.

src/domain/types.h / lines 1-14
1 // Basic shared types. Domain layer: pure C, no
> Arduino/FreeRTOS includes.
2 //
3 // Enumerations are stored as uint8_t (the typedefs below) > with the values in
4 // an anonymous enum. This keeps every record exactly the > size it had with the
5 // C++ `enum class X : uint8_t` types (queue item sizes, > RAM).
6 #pragma once
7 #include <stdbool.h>
8 #include <stdint.h>

9
10 // Monotonic milliseconds since boot. Used for every age and > deadline.
11 // Never wall-clock/NTP time (§8). 64-bit so it does not
> wrap in practice.
12 typedef uint64_t MonoMs;

13
14 static inline bool monoReached(MonoMs now, MonoMs deadline) monoReached > { return now >= deadline; }

MonoMs names a 64-bit unsigned integer whose unit is milliseconds.

### The alias makes intent visible while leaving ordinary integer arithmetic available. monoReached compares two timestamps; it does not wait or schedule anything. If now is 1749 and deadline is

1750, the return is false. At 1750 it is true.

The inline helper lives in the header so each caller sees its definition. static keeps a separate internal name in each translation unit.

### Neither keyword creates an RTOS task. We will supply now from the

monotonic clock rather than a calendar clock.

COMMON PITFALL

A type alias cannot detect a microsecond value
accidentally assigned to a millisecond variable.

CHAPTER 04 / MAKE STATE AND FILES PREDICTABLE

# Name sensors separately from measurements

src/domain/types.h / lines 15-41

15
16 typedef uint8_t SensorId; 17 enum {
18 | SENSOR_BME280 = 0,
19 | SENSOR_DS18B20,
20 | SENSOR_LIGHT, | // DFR0026
21 | SENSOR_HCSR04,
22 | SENSOR_PH, | // pH-4502C
23 | SENSOR_TDS, | // SEN0244
24 | SENSOR_SGP30, | // TVOC / CO2eq (replaced the MQ-7, D18)
25 | SENSOR_COUNT

26 };

27
28 // One entry per published metric. A sensor may produce > several metrics.
29 typedef uint8_t MetricId;
30 enum {
31 | METRIC_AIR_TEMPERATURE = 0, | // BME280
32 | METRIC_AIR_HUMIDITY, | // BME280
33 | METRIC_AIR_PRESSURE, | // BME280
34 | METRIC_WATER_TEMPERATURE, | // DS18B20
35 | METRIC_LIGHT_LEVEL, | // DFR0026 (mV until
> | calibrated, then lux)
36 | METRIC_WATER_DISTANCE, | // HC-SR04
37 | METRIC_PH, | // pH-4502C
38 | METRIC_TDS, | // SEN0244
39 | METRIC_TVOC, | // SGP30, ppb
40 | METRIC_CO2EQ, | // SGP30, ppm (estimate, not
> | measured CO2)
41 | METRIC_COUNT

### SensorId identifies a physical device. MetricId identifies one reported quantity. Count the BME280 entries: one sensor produces temperature, humidity and pressure. SGP30 contributes TVOC and

CO2eq. This is why the counts differ.

### The enumeration starts at an explicit zero and increments each following value. SENSOR_COUNT and METRIC_COUNT are sentinels used for array bounds; they are not real devices or observations. A loop with index < METRIC_COUNT visits every valid

metric index without visiting the sentinel.

COMMON PITFALL

SensorId and MetricId are
both uint8_t aliases. Their different names explain
intent but do not make
accidental interchange a C type error.

REMEMBER

Review named status
values (p. 32) for enum
numbering and number
notation (p. 21) for the
byte representation.

CHAPTER 04 / MAKE STATE AND FILES PREDICTABLE

# Keep the unit beside the number

src/domain/types.h / lines 42-57

42 };

43
44 typedef uint8_t Unit;
45 enum {
46 | UNIT_NONE = 0,
47 | UNIT_DEG_C,
48 | UNIT_PERCENT_RH,
49 | UNIT_PASCAL,
50 | UNIT_MILLIVOLT,
51 | UNIT_MILLIMETRE,
52 | UNIT_PH,
53 | UNIT_PPM,
54 | UNIT_ADC_RAW,
55 | UNIT_PPB,
56 | UNIT_LUX | // light after an on-device fit (WP8 calibration). Appended: values above
> | unchanged

57 };

The Unit constants label the interpretation of Reading.value. The same float storage can hold 24.5 degrees Celsius or 24.5 millivolts, but consumers must not compare those as though they meant the same physical quantity.

### Notice that UNIT_LUX is appended. Stable numeric identifiers matter when records or

protocols use existing values. In a new design you could use a different representation, but

### while reviewing this one, do not casually reorder an enum whose values cross a module or

communication boundary.

CHAPTER 05 / LET TWO JOBS SHARE A CPU

# Name the work the kernel will organise

### Firmware is the program that makes this controller operate its hardware after reset. In this project, the Arduino framework already starts FreeRTOS. Your setup function creates application tasks within that running system. You do not need to start a second

scheduler.

### RTOS means real-time operating system. Its kernel keeps task execution state and implements scheduling and communication operations. The scheduler selects which eligible task runs on each core. Application code still decides which reading is usable, which

deadline matters and what a failed operation should do.

Real-time asks whether a result arrives in time to serve its purpose.

### A water conversion can legitimately take 750ms. An ultrasonic edge needs a much finer timestamp. Giving both the same task priority or wait duration would ignore the physical jobs they perform. You will learn to separate elapsed conversion time, occupied CPU time and

allowed response delay.

Responsibility | Owner in this project
Keep task state and select execution | FreeRTOS kernel and scheduler
Start and collect sensor operations | The active acquisition worker
Choose the final relay command | Safety
Save accepted settings | Configuration

### Read the next task function as ordinary C executed in a

kernel-managed context. We will first watch it wait and resume.

### Then we will create a second task and follow the messages that

connect them.

Reference: Espressif: ESP-IDF FreeRTOS SMP, v4.4.2 (S3) (https://docs.espressif.com/projects/esp-idf/en/v4.4.2/esp32s3/api-guides/freertos-smp.html)

REMEMBER

A task has execution state. A sensor is a physical
device. The architecture
decides how many devices
one task manages.

CHAPTER 05 / LET TWO JOBS SHARE A CPU

# A task is a resumable function

Teaching fragment - checkLatestValue is a stand-in
static void readerTask(void *arg) { (void)arg;
for (;;) {
checkLatestValue();
vTaskDelay(pdMS_TO_TICKS(100)); }
}

### This function repeatedly checks a value and asks the RTOS to wait. A

task is more than the function body: the kernel also keeps its stack,

### current execution position, saved CPU registers and scheduling information. That saved context lets it pause here and resume after

the wait.

The stack is the task's working storage for nested calls and automatic local variables. For example, a local Sample inside readerTask must survive while that task is blocked in a wait. The kernel preserves the task's saved execution context so the same call can continue with its existing locals. A later function return, unlike a

wait, can end a local object's lifetime.

### At the delay, readerTask becomes Blocked. The kernel can run a

different Ready task on that core. When the delay expires,

### readerTask becomes Ready. It resumes only when the scheduler

selects it; expiry does not promise immediate execution.

### (void)arg deliberately ignores an unused parameter. The void * parameter is a generic pointer accepted by the task API. We will pass a real address through such a parameter when needed. for (;;) is an infinite loop: none of its three optional control expressions is

supplied.

### A normal helper returns to its caller. A long-lived task usually loops instead. If a finite task finishes its work, it should use the port's task-deletion API rather than return from its task entry function. In

our first controller both tasks live until reset.

### The RTOS does not rewrite your code into parallel instructions. Each

core still executes one task at a time, interrupted when necessary. On one core, two tasks make progress by taking turns. On two cores, two eligible tasks may actually execute at the same time.

Reference: Espressif: ESP-IDF FreeRTOS SMP, v4.4.2 (S3) (https://docs.espressif.com/projects/esp-idf/en/v4.4.2/esp32s3/api-guides/freertos-smp.html)

REMEMBER

Task context is the
execution state needed to
resume a task. A normal C
function call does not
create a task.

CHAPTER 05 / LET TWO JOBS SHARE A CPU

# Ready is permission, not execution

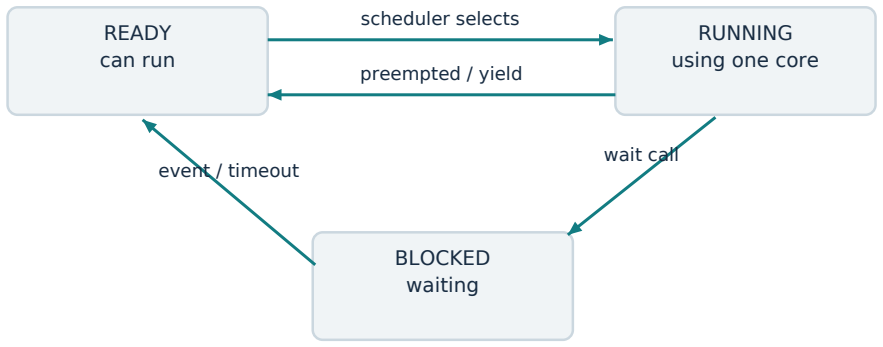
[picture p6: figure]
READY can run; RUNNING using one core; BLOCKED waiting; scheduler selects; preempted / yield; wait call; event / timeout

The three states needed for our examples. Suspended is a separate explicit state.

### Running means the task is currently executing on a core. Ready means it could execute if selected. Blocked means it is waiting for an event or a time limit and is not a scheduling candidate. Suspended means an explicit suspend operation has removed it from normal

scheduling until resumed.

Suppose Reader waits on an empty queue for 100ms. At 40ms,

### Producer inserts a value. Reader becomes Ready because the event arrived. If a higher-priority eligible task still needs the core, Reader remains Ready until that task blocks or is preempted by another

event.

### If no value arrives, the timeout instead makes Reader Ready at the relevant tick. When Reader eventually runs, the queue call can return failure. The return value tells you whether it actually obtained

an item; simply resuming is not proof of success.

### Blocked time consumes elapsed time, not CPU execution

### A blocked task still has its allocated stack and kernel record. It simply does not use instructions to repeatedly test its condition. If all application tasks block, the idle task gets the core; the system may

then use its configured power-saving behaviour.

### This will be useful for the ultrasonic driver: the acquisition task can wait until the next useful poll time while an interrupt records the echo edges. We will separate the event measurement from the task's

later processing of it.

Reference: Espressif: ESP-IDF FreeRTOS SMP, v4.4.2 (S3) (https://docs.espressif.com/projects/esp-idf/en/v4.4.2/esp32s3/api-guides/freertos-smp.html)

COMMON PITFALL

A task becoming Ready
does not mean the
instruction after its wait has executed. Keep that
delay in your
response-time reasoning.

CHAPTER 05 / LET TWO JOBS SHARE A CPU

# Priority chooses among eligible tasks

### In the application table, Safety has priority 6, acquisition has priority 4, and SerialLogger has priority 1. A larger number means a higher application task priority. When all three are Ready and pinned to

core1, Safety runs first. Once Safety blocks, acquisition can run. Once acquisition blocks, the logger can run.

Core | Ready application tasks | Highest eligible choice
0 | PowerCoord 5; BLE 2; Supervisor 1 | PowerCoord
1 | Safety 6; AcqNormal 4; Logger 1

Safety

This is a worked scheduling snapshot, not a complete system trace.

### ESP32 framework tasks and interrupts also exist. Core affinity restricts where an application task may run: a task pinned to core1 cannot fill unused time on core0. The two largest priority numbers across the whole application are therefore not always the two

running tasks.

Preemption means a higher-priority eligible task can replace the current task without waiting for it to finish its function. The kernel preserves the interrupted context. Time slicing gives eligible equal-priority tasks opportunities to run, but the ESP-IDF dual-core implementation has affinity-related details; do not depend on an

exact alternating order.

### Priority is not CPU speed. A priority-6 task executes the same addition at the same clock rate as a priority-1 task. Priority changes when it gets CPU time. If the high-priority task remains Ready

forever, lower-priority work can starve.

### The source table documents a reason for pinning Safety to core1: the project had observed Wi-Fi startup interference on core0. Treat that comment as project history, not a fresh latency measurement from

this edition. Pinning still does not remove every possible delay.

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

REMEMBER

Eligible means Ready and
allowed on this core.
Interrupts are not ordinary Ready tasks.

CHAPTER 05 / LET TWO JOBS SHARE A CPU

# Read the task-creation call

Teaching example - C
TaskHandle_t handle = NULL;
BaseType_t ok = xTaskCreatePinnedToCore( readerTask, "Reader", 4096, NULL,
2, &handle, 1);
if (ok != pdPASS) {
// Do not continue as if Reader exists. }

### The first argument is the entry function, not a call to it. readerTask names the function; readerTask(...) would call it now. The second is a

diagnostic name. On this ESP-IDF port, 4096 specifies stack bytes. NULL is the argument delivered to readerTask. 2 is the task priority. &handle lets the kernel write back a task handle. 1 pins it to core1.

### BaseType_t is a FreeRTOS integer typedef used for many API

outcomes and flags. Here ok records the task-creation outcome;

### pdPASS is the success value this API documents. Later queue calls compare their result with pdTRUE. Read each API's promised result

instead of treating these names as a measurement-valid flag.

### StaticTask_t, used by the static creation API, holds the kernel's task bookkeeping; the separate stack array holds the task's working

storage.

### A handle identifies a kernel object. It is not the measurement that the task produces. You use a task handle with APIs such as xTaskNotifyGive(). You use a queue handle with queue APIs. Keep those roles distinct even if both are represented by pointer-like

typedefs.

COMMON PITFALL

Creating a task twice
makes two execution
contexts. An initialisation function should guard
against accidental
repeated creation.

CHAPTER 05 / LET TWO JOBS SHARE A CPU

### Read the task-creation call / continued

### This dynamic creation API allocates the task's memory. The original firmware usually uses

xTaskCreateStaticPinnedToCore(), supplying persistent stack storage and a StaticTask_t control block itself. That gives the application control over the storage; the resulting task still uses the same scheduling states.

A created task can run before the creation function's caller has finished its next line. Initialise objects it depends on first. For our learning program, create the queue before creating either task. Later, production setup() also creates and publishes configuration before starting its consumers.

Stack depth units differ between vanilla FreeRTOS and ESP-IDF. Read the API for the pinned version you actually compile. Do not multiply a byte count by four because another tutorial used words.

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

CHAPTER 05 / LET TWO JOBS SHARE A CPU

# A wait is not a spin loop

Teaching example - C
while (!ready) {
// Rechecks continuously: remains Ready/Running. }

vTaskDelay(pdMS_TO_TICKS(100));
// Blocks this task for a tick-based interval.

### The while loop is a scheduling sketch: assume ready is obtained through a valid sharing mechanism. An ordinary bool shared between tasks is not, by itself, that mechanism. We will examine shared-state protection in the volatile lesson (p. 71). Here, compare

repeatedly checking a condition with asking the kernel to block.

The empty while loop spends CPU time loading ready and testing it.

### A blocking RTOS wait removes the task from the Ready set until its condition or timeout changes. That gives other tasks a useful

opportunity to run.

### The RTOS measures many waits in ticks. If the configured tick rate

were 100Hz, one tick would be 10ms; at 1000Hz it would be 1ms.

### pdMS_TO_TICKS converts a duration to the tick count used by the build. It does not create a microsecond timer. Read the configured

rate rather than assuming one.

### Conversion can round small values down to zero. A zero-time queue receive checks immediately. vTaskDelay(0) does not request a positive delay; it can yield to an eligible equal-priority task, but it does not make lower-priority work win over a still-Ready

higher-priority task. taskYIELD() has the same basic limitation.

### Even a positive one-tick delay is not a guaranteed minimum physical delay of one full tick period from the instant you call it; the call may

occur just before a tick. For minimum sensor conversion waits,

### remember the absolute due time and check the monotonic clock

again before reading.

### A measured interval and a wake request have different precision. We will use microsecond timestamps to measure an ultrasonic pulse and a coarse wait to decide when a task should inspect the finished result. That separation avoids trying to time a 1000us pulse with a

scheduler tick.

Reference: Espressif: ESP-IDF FreeRTOS SMP, v4.4.2 (S3), (https://docs.espressif.com/projects/esp-idf/en/v4.4.2/esp32s3/api-guides/freertos-smp.html) FreeRTOS: delay-until API (https://www.freertos.org/Documentation/02-Kernel/04-API-references/02-Task-control/02-vTaskDelayUntil)

REMEMBER

Yield means give the
scheduler another choice.
Block means stop being
eligible until something
changes.

CHAPTER 05 / LET TWO JOBS SHARE A CPU

# Select the running task on each core

Use a simplified scheduling snapshot with only five application tasks. PowerCoord has priority 5 on core0; BLE has priority 2 on core0. Safety has priority 6 on core1; acquisition has priority 4 on core1;

### logger has priority 1 on core1. Ignore interrupts, framework tasks

and equal-priority ties for this calculation.

Change | Core0 runs | Core1 runs
Initially: PowerCoord, BLE, acquisition and logger Ready; Safety Blocked | PowerCoord | Acquisition

Safety becomes Ready;
other states unchanged
PowerCoord | Safety

PowerCoord blocks;
Safety stays Ready
BLE | Safety

Safety blocks;
acquisition stays Ready
BLE | Acquisition

### In the first row, Safety's larger priority does not help because it is

Blocked. In the second, it preempts acquisition on core1.

### PowerCoord cannot move to core1, and acquisition cannot occupy core0 when PowerCoord blocks. Affinity and readiness are checked

before comparing priorities for that core.

These rows are predictions under stated conditions, not a measured controller trace. The table gives you a method to use when reading TaskSpec: list each core's eligible candidates, select its highest priority, and update the candidates after every block or wake. An unpinned task introduces an additional rule: one task cannot execute

on both cores at once.

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

REMEMBER

A high-priority Blocked task uses no core. A pinned
Ready task must wait for
its assigned core.

CHAPTER 05 / LET TWO JOBS SHARE A CPU

# Separate release periods from call budgets

### You have learned what a task and a timeout are. This header now shows the controller's actual scheduling and memory choices. Read the constants as the application's intended budgets; the later driver

and service chapters show how they are used.

### Configuration values do not enforce themselves. Find the call that

consumes each value before assuming it changes runtime behaviour.

include/app_config.h / lines 1-25
1 // Application timing, queue and task budgets.
2 // Source: Firmware Architecture §6 (tasks), §7 (schedule), > §8 (staleness),
3 // §9 (queues), §11 (power). These are DESIGN BUDGETS, not > measurements:
4 // replace with measured values as each stage is validated. 5 //
6 // Pure C (no Arduino headers).
7 #pragma once
8 #include <stdint.h>

9
10 // ---- Schedule (§7)
> | ----------------------------------------------------------
> | -
11 #define CFG_FRAME_PERIOD_MS ((uint32_t)1000) | //
> | ordinary sensors
12 #define CFG_BME280_PERIOD_MS ((uint32_t)250) | // fast
> | climate check
13 #define CFG_BME280_BUDGET_MS ((uint32_t)12) | //
> | conversion + read
14 #define CFG_DS18B20_CONVERSION_MAX_MS ((uint32_t)750) | //
> | 12-bit
15 #define CFG_DS18B20_BUDGET_MS ((uint32_t)20)
16 #define CFG_HCSR04_TIMEOUT_MS ((uint32_t)30)
17 #define CFG_ANALOG_GROUP_BUDGET_MS ((uint32_t)5) 18 #define CFG_SNAPSHOT_BUDGET_MS ((uint32_t)10) 19 #define CFG_FRAME_RESERVATION_MS ((uint32_t)150) 20 #define CFG_SERVICE_STEP_TARGET_MS ((uint32_t)5)

21
22 // ---- Staleness (§8)
> | ----------------------------------------------------------
> | --
23 #define CFG_STALE_BME280_MS ((uint32_t)1000)
24 #define CFG_STALE_ORDINARY_MS ((uint32_t)3000)

25

COMMON PITFALL

Do not add all elapsed
conversion times as if the worker spends CPU time on
every one of them.

CHAPTER 05 / LET TWO JOBS SHARE A CPU

### Separate release periods from call budgets / continued

### The ordinary frame repeats every 1000ms; climate slots repeat every 250ms. These say how often work is requested. A 750ms DS18B20 conversion allowance says how long a physical

conversion can take. A 20ms transaction budget describes a shorter piece of CPU or bus work. Those are different dimensions of the schedule.

include/app_config.h / lines 26-34
26 // ---- Queues (§9) ---------------------------------------------------------------27 #define CFG_ALARM_DETAIL_QUEUE_LEN ((uint32_t)16)
28 #define CFG_ALARM_JOURNAL_LEN ((uint32_t)64)
29 #define CFG_COMMAND_QUEUE_LEN ((uint32_t)8)
30 #define CFG_TELEMETRY_BACKLOG_LEN ((uint32_t)60)
31 #define CFG_LOG_QUEUE_LEN ((uint32_t)32)

32
33 // ---- Power transitions (§11) ---------------------------------------------------34 #define CFG_POWER_LOSS_DEBOUNCE_MS ((uint32_t)50)

A 5ms service-step target is a design goal, not proof that every call finishes in 5ms. When the source later admits a longer blocking operation, acquisition uses overlap guards rather than pretending that a macro made it short.

Here an ordinary frame means a recurring release of the ordinary sensor jobs. A climate slot

### is one opportunity to release the faster BME280 job. Starting a frame does not mean every

sensor finishes together. The communication chapter will also use frame for a length-prefixed

### message; that is a different use of the word. We will trace the actual sensor releases in

acquisition scheduling (p. 340).

CHAPTER 05 / LET TWO JOBS SHARE A CPU

# Choose how long information may wait

include/app_config.h / lines 35-58
35 #define CFG_POWER_RETURN_STABLE_MS ((uint32_t)500) 36 #define CFG_TRANSITION_ACK_MS ((uint32_t)200)
37 #define CFG_NETWORK_SHUTDOWN_ACK_MS ((uint32_t)2000)

38
39 // ---- Network (§15) -------------------------------------------------------------40 #define CFG_MQTT_BACKOFF_INITIAL_MS ((uint32_t)1000)
41 #define CFG_MQTT_BACKOFF_MAX_MS ((uint32_t)60000)
42 #define CFG_BLE_STATE_PERIOD_MS ((uint32_t)2000)
43 #define CFG_BLE_TELEMETRY_PERIOD_MS ((uint32_t)3000)

44
45 // ---- Safety / supervision (§10, §16) -------------------------------------------46 #define CFG_SAFETY_HEALTH_CHECK_MS ((uint32_t)100)
47 #define CFG_SUPERVISOR_PERIOD_MS ((uint32_t)1000)
48 #define CFG_TASK_WATCHDOG_MS ((uint32_t)5000)

49
50 // ---- Tasks (§6). Higher number = higher priority. Stack in bytes. --------------51 typedef uint8_t TaskId;
52 enum {
53 | TASK_ID_SAFETY = 0,
54 | TASK_ID_POWER_COORDINATOR,
55 | TASK_ID_ACQUISITION_NORMAL,
56 | TASK_ID_ACQUISITION_LOW_POWER,
57 | TASK_ID_WIFI_MQTT,
58 | TASK_ID_BLE_TRANSPORT,

The stale limits describe when a retained observation stops being eligible. The queue lengths describe storage capacity. Debounce and stable-return values describe power qualification. A task can wake for one purpose while checking another limit against the monotonic clock.

### The detail queue has 16 slots, while the journal retains 64 events. The two buffers serve

different readers and failure contracts. A full queue does not imply the journal is full, and increasing the journal does not prevent an immediate detail-queue overflow.

CHAPTER 05 / LET TWO JOBS SHARE A CPU

# Assign names to the task table

include/app_config.h / lines 59-85
59 | TASK_ID_CONFIGURATION,
60 | TASK_ID_SUPERVISOR,
61 | TASK_ID_SERIAL_LOGGER,
62 | TASK_ID_COUNT

63 };

64
65 typedef struct TaskSpec {
66 | const char* name;
67 | uint8_t core;
68 | uint8_t priority;
69 | uint32_t stackBytes;
70 } TaskSpec;

71
72 static inline const TaskSpec* cfgTaskSpec(TaskId id) { cfgTaskSpec
73 | // Indexed by TaskId. Keep order in sync with the enum
> | above.
74 | static const TaskSpec kTaskSpecs[TASK_ID_COUNT] = {
75 | // Core 1 since 28 Oct 2026 (D14 fallback): the Wi-Fi
> | driver's start-up
76 | // starved Safety on core 0 for 40-110 ms; on core 1
> | the worst case is
77 | // 145 us. Frozen-header change made on the project
> | owner's decision.
78 | {"Safety", 1, 6, 3 * 1024},
79 | {"PowerCoord", 0, 5, 4 * 1024},
80 | {"AcqNormal", 1, 4, 4 * 1024},
81 | {"AcqLowPower", 0, 4, 4 * 1024},
82 | {"WifiMqtt", 0, 2, 6 * 1024},
83 | {"BleTransport", 0, 2, 6 * 1024},
84 | {"Configuration", 0, 2, 4 * 1024},
85 | {"Supervisor", 0, 1, 3 * 1024},

TaskId supplies array indices for a fixed table of TaskSpec records.

### Each record groups a diagnostic name, core, priority and stack-byte budget. A caller passes its TaskId to cfgTaskSpec and obtains a

pointer to the matching constant record.

### The function returns an address, not a new task. A later service uses that address to obtain creation parameters. This is a useful place to pause: declaration, configuration lookup and task creation are three

separate operations.

COMMON PITFALL

The helper assumes id is
within its enum range. It is an internal lookup, not a
validator for arbitrary
external input.

CHAPTER 05 / LET TWO JOBS SHARE A CPU

# Read the actual priority and affinity choices

include/app_config.h / lines 86-92
86 | {"SerialLogger", 1, 1, 2 * 1024},
87 | };
88 | return &kTaskSpecs[id];

89 }

90
91 // ---- CPU frequency (§13) - 80 MHz low power is only a > candidate --------------------
92 #define CFG_CPU_MHZ_NORMAL ((uint32_t)160)

### Safety is assigned core 1 and priority 6; normal acquisition uses core 1 and priority 4. Power coordination uses core 0 and priority 5. The active worker, framework tasks and interrupts still determine the

real execution trace.

### The source comment records a past observation about Wi-Fi startup interference. It explains why this project chose an affinity. It is not a guarantee for another board, another SDK or another execution path. Use the table to predict eligibility, then use measurements to

assess delay.

COMMON PITFALL

The declared stackBytes
values use this port's byte convention. Keep that
convention consistent with the allocation and creation call.

CHAPTER 06 / MOVE VALUES THROUGH QUEUES

# Reserve space for messages

Teaching example - C
QueueHandle_t samples = xQueueCreate(
4, sizeof(Sample));
if (samples == NULL) {
// Allocation failed: no queue is available. }

### A queue is a kernel-managed buffer with a maximum number of items and a fixed item size. This call reserves four slots, each large enough for a Sample. The queue also has internal bookkeeping. It is

not just a plain array that both tasks update without coordination.

### The first parameter is the number of messages, not bytes. The

second is bytes per message, not a pointer to the type.

### sizeof(Sample) asks the compiler for the actual record size, including alignment padding. Every send and receive must use storage

compatible with that size.

### For a FIFO queue, a successful send to the back adds an item after

existing items; a receive removes the oldest one. FIFO means first in,

### first out. A queue can preserve order among accepted messages, but it cannot accept an unlimited stream if the consumer is slower than

the producer.

COMMON PITFALL

A successful queue
creation does not mean it
contains an item. A new
queue starts empty.

CHAPTER 06 / MOVE VALUES THROUGH QUEUES

### Reserve space for messages / continued

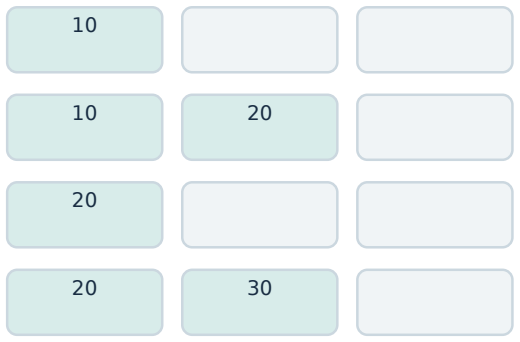
[picture p7: figure]

send 10

send 20

receive

send 30

Each row shows the queue after the named operation. The left slot is oldest.

The production snapshot store instead needs one latest value. It creates a one-item queue and overwrites that item. We will compare that contract with a FIFO after first following an ordinary send and receive.

The teaching program uses dynamic creation for a short listing. The production snapshot queue has caller-supplied static storage.

Reference: FreeRTOS: queue concepts (https://www.freertos.org/Documentation/02-Kernel/02-Kernel-features/02-Queues-mutexes-and-semaphores/01-Queues)

CHAPTER 06 / MOVE VALUES THROUGH QUEUES

# Sending copies bytes from your object

Teaching example - C
Sample sent = { .valueC = 24.5f,
.measuredMs = 1000, .valid = true }; BaseType_t ok = xQueueSend(samples, &sent, 0); sent.valueC = 99.0f;

### The queue was created with sizeof(Sample). If send succeeds, it copies that many bytes from the address &sent into a queue slot before returning. Changing sent.valueC afterward does not change the stored record. The final argument 0 says: do not wait for space if

the queue is full.

Change producer value to 99.0 The queue copy remains 24.5

The addresses are illustrative. The three records occupy different storage.

### The API accepts a pointer because it needs to know where the source bytes are. That does not mean the queue stores that pointer as the

message. The queue's configured item size decides what it copies.

COMMON PITFALL

&sent is the source
address for a record copy. &p is the source address
for a pointer copy. Match
both to the queue's item
size.

CHAPTER 06 / MOVE VALUES THROUGH QUEUES

### Sending copies bytes from your object / continued

Teaching contrast - a queue of pointers
QueueHandle_t addresses = xQueueCreate(4, sizeof(Sample *)); Sample *p = &sent;
xQueueSend(addresses, &p, 0);

This second queue copies only the pointer object p. Its receiver can still reach the same sent object, whose value may now be 99.0. You must define how long sent lives and who may modify it. For small sensor records, copying the value avoids that extra agreement.

This is why the Hydroponics Reading contains plain values rather than a pointer to a temporary text buffer. A queued copy can outlive the driver function that produced it.

Reference: FreeRTOS: queue concepts (https://www.freertos.org/Documentation/02-Kernel/02-Kernel-features/02-Queues-mutexes-and-semaphores/01-Queues)

CHAPTER 06 / MOVE VALUES THROUGH QUEUES

# Check what the wait actually returned

Teaching fragment - useSample/reportNoNewSample are stand-ins
Sample received = {0};
BaseType_t got = xQueueReceive(
samples, &received, pdMS_TO_TICKS(100)); if (got == pdTRUE) {
useSample(&received);
} else {
reportNoNewSample();
}

### If a message is already queued, receive copies it into received and removes it immediately. If the queue is empty, the task can block for

up to the requested tick interval. An arriving item can wake it early. The task then resumes according to priority and core eligibility.

### If the wait ends without an item, the call returns failure and does not supply a fresh Sample. The previous contents of received are not evidence of a new result. The else branch matters even if the last

successful value still looks plausible.

### Trace a successful wake

### At 0ms Reader calls receive on an empty queue. At 40ms Producer sends 24.5. Reader becomes Ready. When it runs, receive returns

pdTRUE, and received.valueC is 24.5. The queue slot is now free.

### The 100ms timeout was an upper waiting budget, not an instruction

to delay for the full 100ms.

### Trace a timeout

### No producer sends anything. The timeout expires; Reader becomes Ready. When it runs, receive returns failure. Your code must choose what to do: retry later, retain the previous display with an age, or declare missing data. The kernel does not choose the application's

fault policy.

### useSample() is a placeholder for the action being taught. It is not a

FreeRTOS API or an original project function.

Reference: FreeRTOS: queue concepts (https://www.freertos.org/Documentation/02-Kernel/02-Kernel-features/02-Queues-mutexes-and-semaphores/01-Queues)

REMEMBER

An output parameter only
contains a new result when the function's success
contract says it does.

CHAPTER 06 / MOVE VALUES THROUGH QUEUES

# Keep the latest state for many readers

Original firmware - src/services/snapshot_store.c, lines 10-24
bool snapshotStoreInit(void) {
if (s_queue == NULL) {
s_queue = xQueueCreateStatic(1, sizeof(Snapshot), > s_queueStorage, &s_queueControl);
}
| return s_queue != NULL;
}

void snapshotPublish(const Snapshot* snapshot) {
| if (s_queue != NULL) xQueueOverwrite(s_queue, snapshot);
}

bool snapshotPeek(Snapshot* out) {
| if (s_queue == NULL || out == NULL) return false;
| return xQueuePeek(s_queue, out, 0) == pdTRUE;
}

### This is the complete behaviour that matters in snapshot_store.c. The static storage declarations above it reserve one Snapshot item and

its queue control block. snapshotStoreInit creates the queue once.

### snapshotPublish replaces the current item. snapshotPeek copies the

current item into caller-owned storage and leaves the queue full.

### Use xQueueReceive when a message should be consumed. Use xQueuePeek when the item should remain available. Safety and BLE can each peek the latest Snapshot without stealing it from one another. Their copies may come from different publications if

acquisition updates the queue between the two peeks.

COMMON PITFALL

A latest-value mailbox
cannot preserve every
alarm transition. A later
healthy state could
overwrite a brief fault
before a reader sees it.

CHAPTER 06 / MOVE VALUES THROUGH QUEUES

### Keep the latest state for many readers / continued

xQueueOverwrite is intended for a queue of length one. It is a good match here because the question is: what is the newest retained system state? If acquisition publishes A, B and C before BLE reads, BLE gets C. Losing A and B is allowed by this interface.

A Snapshot is one coherent memory copy, not simultaneous sensing. Its ten readings may have different acquisition times. A water-temperature value can be older than the air-temperature

### value beside it. Consumers must check each reading's timing instead of assuming the frame

timestamp makes every field fresh.

We will return to this store in the result path (p. 343). For now you can read its purpose without knowing every field of Snapshot: one writer publishes a retained copy; several readers copy it without consuming it.

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

CHAPTER 06 / MOVE VALUES THROUGH QUEUES

# Choose what happens when the queue is full

### Suppose Producer sends 10 samples per second and Consumer handles 6 per second. The backlog grows by four samples per second. A queue with 16 initially empty slots fills after roughly 4s of this steady mismatch. A larger queue postpones the failure; it does

not fix the rate mismatch.

Need | Useful behaviour
Newest state only | One slot; overwrite the previous state.
Every accepted command in order | FIFO; reject or back-pressure when full.
A wake-up to inspect retained state | Notification; store the state separately.
A critical trip despite detail loss | Retained trip state plus a bounded detail path.

### A blocking send can slow the producer while space becomes available. That is back-pressure: the consumer's capacity limits the sender. It is useful when waiting is acceptable. It is a poor choice inside a measurement path that must promptly return to other

sensor deadlines.

A zero-wait send returns failure if no slot is free. The caller must then do something defined. Telemetry can count dropped records; a command interface can return busy. A safety trip needs a stronger fallback than silently losing the event. The original Safety service uses a retained sticky path, which we will explain only after alarms

themselves make sense.

### Queue length is therefore an architectural choice. Ask what information may be lost and what delay the sender can tolerate

before choosing the API. The RTOS protects the queue mechanism; you still choose its meaning.

TIP

Rate arithmetic here
assumes steady rates and
no initial backlog. Bursts need a separate worst-case backlog calculation.

COMMON PITFALL

Ignoring xQueueSend's
result turns a documented
capacity limit into silent data loss.

CHAPTER 07 / WAKE FOR A REASON OR A DEADLINE

# A notification tells one task to look

Teaching example - C
// Sender, after storing the new state: xTaskNotifyGive(readerHandle);

// Reader:
uint32_t count = ulTaskNotifyTake( pdTRUE, pdMS_TO_TICKS(100));

Each task has notification state managed by the kernel. In this usage,

### give increments a notification value. take waits for that value to become nonzero or for its timeout. It returns the value observed before consuming it. The notification is directed to one task

identified by readerHandle.

### If three gives arrive before take runs, the value can be 3. With

pdTRUE, take returns 3 and clears the value to zero. With pdFALSE,

### it returns 3 and decrements the value to 2; the next take can return

immediately. These are different consumption rules.

For a wake-up that means inspect the latest retained state, clearing all accumulated gives is often appropriate. The current state can already include all changes. For counted independent work, you may need one decrement per unit or a queue containing actual work records. A notification count does not hold three different

temperature values.

### If a give happens before the task starts waiting, the pending notification remains available. That helps avoid a simple lost-wakeup race. It does not fix a design that sends the wake-up before making

the referenced state visible.

### In the firmware, Safety wakes on a submitted event or after its

100ms health-check interval. The event detail is stored separately.

### When Safety wakes, it drains the available work and checks the

latest state. The wake-up is a prompt, not the event record.

Reference: FreeRTOS: ulTaskNotifyTake (https://www.freertos.org/Documentation/02-Kernel/04-API-references/05-Direct-to-task-notifications/03-ulTaskNotifyTake)

COMMON PITFALL

ulTaskNotifyTake returns
zero on timeout. A nonzero count means notifications
were pending, not that a
particular queue receive
must succeed.

CHAPTER 07 / WAKE FOR A REASON OR A DEADLINE

# Store the fact before waking its reader

Teaching producer fragment
xQueueOverwrite(latestQueue, &sample); xTaskNotifyGive(readerHandle);

### The ordering is deliberate. First place the sample in the queue; then send the prompt. A higher-priority Reader may run as soon as the give unblocks it. It should find the state that caused the wake already

available.

Teaching consumer fragment
ulTaskNotifyTake(pdTRUE, pdMS_TO_TICKS(100)); Sample local;
if (xQueuePeek(latestQueue, &local, 0) == pdTRUE) { inspectSample(&local);
}

### The consumer still checks peek. At boot, no sample may have been published. A timeout may cause the pass. Another allowed path may have sent a notification for a different reason. Checking the data

source keeps those cases explicit.

### Why not simply receive from a one-item FIFO? That works well for one consumer that should consume each accepted message. The retained queue plus notification is useful when several services should inspect the newest state, or when the same task must wake

for commands and periodic health checks as well as new data.

### If two publications happen before Reader runs, it can inspect only the newest retained sample and consume both prompts at once. That is correct only when intermediate states may be skipped. We will

keep alarm trip details on their separate path.

### This is the reason for a later line such as safetySubmitEvent(&event):

it first retains the safety information, then attempts the detail queue,

### then wakes Safety. We will read that actual ordering in alarm

delivery (p. 395).

COMMON PITFALL

Reversing these two
producer lines can wake a
reader that finds only the previous state.

REMEMBER

A wake-up answers when
to look. The queue or
protected object answers
what happened.

CHAPTER 07 / WAKE FOR A REASON OR A DEADLINE

# An early wake does not move a deadline

Suppose a sensor starts at 1000ms and may be read after 1750ms.

### You want to sleep until that due time, but a configuration change may wake you early. If you wake at 1300ms, only 300ms elapsed. The

chip still needs another 450ms.

Teaching fragment - small, bounded interval assumed
MonoMs due = 1750;
MonoMs now = monoNowMs();
if (now < due) {
uint32_t remaining = (uint32_t)(due - now); ulTaskNotifyTake(pdTRUE, pdMS_TO_TICKS(remaining)); }
now = monoNowMs();
if (now >= due) {
// It is now time to inspect completion. }

### The notification can end the wait early, so the code reads the clock again. It does not subtract a nominal wait duration and assume that time passed. An absolute deadline is a timestamp; a timeout

argument is the maximum time this particular wait should block.

### In a real worker loop, handle the event that woke you, calculate the next useful deadline, and wait again. If the interval can exceed uint32_t, bound it before casting rather than truncating a 64-bit difference. The firmware's ordinary schedule intervals are small, but

that fact should be part of your reasoning.

Tick rounding can produce a zero wait for a positive remaining interval. Then a loop that repeatedly recalculates the same near deadline can stay Ready until the clock advances. For a minimum physical wait, check absolute time and choose a deliberate rounding or peripheral-timer strategy. Do not interpret the RTOS conversion

macro as a deadline guarantee.

COMMON PITFALL

A notification is not a
deadline-expired event
unless your design
explicitly makes it one.

REMEMBER

monoNowMs() is the
project clock wrapper. Its definition is linked in the clock lesson (p. 93).

CHAPTER 07 / WAKE FOR A REASON OR A DEADLINE

# Keep periodic work on a time grid

### Imagine a task whose work takes 20ms. If it then delays 1000ms, its starts occur near 0, 1020, 2040 and 3060ms. The work duration

accumulates into the period. Variable work produces variable drift.

Teaching fragment - periodic RTOS task
TickType_t previous = xTaskGetTickCount();
for (;;) {
doOneShortPass();
vTaskDelayUntil(&previous, pdMS_TO_TICKS(1000)); }

### Delay-until uses a reference release time rather than adding the period after the work finishes. If the work stays within budget and scheduling allows, its intended releases remain on a 1000ms grid. It still cannot force a task to execute at an exact instant when a

higher-priority task occupies the core.

### The Hydroponics scheduler uses its own monotonic jobs and skips expired releases. Suppose the next BME280 slot was 250ms, the period is 250ms, and the worker gets to it at 820ms. Lateness is 570ms. Two further grid points, 500 and 750, have passed. It runs

one current job and advances the next due time to 1000ms.

### It does not issue three old conversions in a burst to pretend it measured the past. A skipped observation cannot be recreated by reading the sensor three times now. The schedule records the

skipped count so you can see that the timing budget was missed.

We will read scheduleJobMarkRun() in the acquisition chapter (p. 340). Here the important choice is already visible: periodic intent, late execution and missed observations are separate facts.

Reference: FreeRTOS: delay-until API (https://www.freertos.org/Documentation/02-Kernel/04-API-references/02-Task-control/02-vTaskDelayUntil)

COMMON PITFALL

An absolute schedule
prevents one kind of drift. It does not prove deadlines are met. Record lateness
and measure execution
time.

CHAPTER 07 / WAKE FOR A REASON OR A DEADLINE

# Run the two-task learning program

### Here is a complete small program you can run after the notification lessons. It uses synthetic water values so you can observe a retained record, a wake-up and a stale-data check before introducing sensor faults. The production source readings begin in the same chapters as

their corresponding devices.

Complete learning platformio.ini - reference S3 N16R8 board
[env:learning]
platform = espressif32@6.12.0
framework = arduino
board = esp32-s3-devkitc-1 board_build.arduino.memory_type = qio_opi board_build.flash_size = 16MB board_upload.flash_size = 16MB board_build.partitions = default_16MB.csv monitor_speed = 115200
build_flags = -D BOARD_HAS_PSRAM

### From the directory extracted from Learning_Program.zip, run pio run -e learning. Then use pio run -e learning -t upload -t monitor with the board's configured console connection. This version prints

through the framework's standard UART0 console at 115200baud.

### Check the correct port if you use a board connection configured

differently.

### Extract Learning_Program.zip, the separate attachment named on the navigation page. Run the commands from its directory containing platformio.ini and src/main.c. Its learning environment is not defined in Reference_Firmware_Source.zip. Read the next three source

sections as that one main.c.

### The synthetic input cycles through 24.0, 25.0, 26.0 and 27.0. warm is

a teaching decision, not a relay command.

REMEMBER

You can observe an RTOS
handoff without first
debugging a sensor.

CHAPTER 07 / WAKE FOR A REASON OR A DEADLINE

# Learning program / objects and producer

Learning main.c - lines 1-25
#include <stdbool.h>

#include <stdint.h>

#include <stdio.h>

#include <stdlib.h>

#include <esp_timer.h>

#include <freertos/FreeRTOS.h> #include <freertos/queue.h>

#include <freertos/task.h>

void setup(void) __asm__("_Z5setupv"); void loop(void) __asm__("_Z4loopv");

typedef struct {
float valueC;
uint64_t measuredMs;
uint32_t sequence;
bool valid;
} Sample;

static QueueHandle_t latest; static TaskHandle_t readerHandle;

static uint64_t nowMs(void) {
return (uint64_t)(esp_timer_get_time() / 1000); }

Learning main.c - lines 27-39
static void producer(void *arg) { (void)arg;
uint32_t sequence = 0;
for (;;) {
Sample s = { .valueC = 24.0f + (float)(sequence % 4), .measuredMs = nowMs(),
.sequence = sequence, .valid = true }; xQueueOverwrite(latest, &s); xTaskNotifyGive(readerHandle); ++sequence;
vTaskDelay(pdMS_TO_TICKS(1000)); }
}

COMMON PITFALL

The ordinary 1s delay in
this small lab includes
work-time drift. The
production engine uses its release grid because its
cadence requirements are
stricter.

CHAPTER 07 / WAKE FOR A REASON OR A DEADLINE

### Learning program / objects and producer / continued

The includes supply types and API declarations. The two assembler-labelled declarations match the symbols Arduino expects from its C++ entry code. Sample is the message type. latest is a queue handle, while readerHandle identifies the task to notify.

Each producer iteration creates a local Sample, copies it into the retained queue, then wakes Reader. sequence%4 is the remainder after division by four, producing 0, 1, 2, 3 repeatedly. Adding 24.0 gives the synthetic temperatures. The task's local s can be reused on the next iteration because overwrite already copied its bytes.

### Read the two __asm__ labels as a connection to the Arduino framework. They tell this GNU

compiler which linker names to give setup and loop so the framework can call them. They do not

### execute assembly instructions here. Keep them unchanged for the lab; the production entry

header (p. 713) explains why this particular build needs them.

CHAPTER 07 / WAKE FOR A REASON OR A DEADLINE

# Learning program / reader and freshness

Learning main.c - lines 41-59
static void reader(void *arg) { (void)arg;
uint32_t seen = UINT32_MAX;
bool wasStale = false;
for (;;) {
ulTaskNotifyTake(pdTRUE, pdMS_TO_TICKS(100)); Sample s;
if (xQueuePeek(latest, &s, 0) != pdTRUE) continue; bool stale = nowMs() - s.measuredMs > 1500;
bool warm = s.valid && !stale && s.valueC >= 26.0f; if (s.sequence != seen || stale != wasStale) { printf("seq=%lu water=%.1f state=%s warm=%d\n", (unsigned long)s.sequence, (double)s.valueC, stale ? "STALE" : "FRESH", (int)warm); seen = s.sequence;
wasStale = stale;
}
}
}

### Reader wakes either because Producer gave a notification or because its 100ms health-check timeout expired. It peeks rather than receives, so the latest record remains available during a later health check. If no sample exists yet, continue goes directly to the next loop

iteration and its wait.

### The age calculation uses the current monotonic time minus the sample timestamp. A record becomes stale only after its age is greater than 1500ms. warm requires three facts together: valid input, acceptable age and temperature at least 26.0. The

short-circuit AND checks them in that order.

### The print condition suppresses identical repeated output. It prints on a new sequence or a freshness-state change. UINT32_MAX is an initial sentinel so the first ordinary sequence, zero, is recognised as new. The printf casts match the chosen format specifiers; floating

arguments are promoted to double.

Notice what is private: Reader's s is a copy on Reader's own stack.

### Producer cannot alter that record by writing its own local. The queue handle is shared, but the RTOS controls access to its stored item. No

shared live pointer to a producer local is needed.

REMEMBER

This loop still checks
freshness when no new
sample arrives. That is the purpose of the timeout, not a requirement to process
empty data.

CHAPTER 07 / WAKE FOR A REASON OR A DEADLINE

# Learning program / startup and first trace

Learning main.c - lines 61-74
void setup(void) {
latest = xQueueCreate(1, sizeof(Sample));
if (latest == NULL) abort();
BaseType_t ok = xTaskCreatePinnedToCore(
reader, "Reader", 4096, NULL, 3, &readerHandle, 1); if (ok != pdPASS) abort();
ok = xTaskCreatePinnedToCore(
producer, "Producer", 4096, NULL, 2, NULL, 1);
if (ok != pdPASS) abort();
}

void loop(void) {
vTaskDelay(portMAX_DELAY); }

### Create the one-slot queue first. Then create Reader, which may run immediately and block waiting for data. Its handle is established before Producer can notify it. Create Producer last. Failure calls abort rather than pretending the partially started demonstration is

healthy.

COMMON PITFALL

Suspending or blocking
Producer does not stop
Reader. Accidentally
blocking Reader would test a different failure.

CHAPTER 07 / WAKE FOR A REASON OR A DEADLINE

### Learning program / startup and first trace / continued

Publication | Synthetic value | Expected fresh decision
sequence 0 | 24.0 | warm=0
sequence 1 | 25.0 | warm=0
sequence 2 | 26.0 | warm=1
sequence 3 | 27.0 | warm=1
sequence 4 | 24.0 | warm=0

Those are logical expected values, not a measured serial trace. Their observation times vary with tick phase, logging and scheduling. A latest-value queue allows intermediate publications to be skipped if Reader is delayed for long enough.

### To expose the stale path, add if (sequence == 6) vTaskDelay(portMAX_DELAY); immediately after ++sequence in Producer. Reader keeps its own 100ms health check. Once the retained result is older than 1500ms and Reader gets CPU time, it prints STALE with warm=0. The

numeric temperature can remain 25.0; its age changed, not its stored value.

Remove that deliberate stall for normal runs. Reset restarts the sequence. This one experiment connects elapsed time, a retained queue, notification coalescing and the meaning of a health check without depending on any physical sensor.

CHAPTER 08 / PROTECT SHARED STATE

# Two correct lines can lose an update

Teaching example - C
// Shared object, initially zero: static uint32_t count = 0;
// Task A and Task B each execute: ++count;

Think of ++count as read, add one, write. A reads zero. B reads zero.

### A computes one. B computes one. Both write one. Two increments occurred, but the stored result is one. This is a race: the result

depends on an interleaving that the code did not control.

On two cores the reads can overlap in real time. On one core, preemption between read and write can create the same problem.

### Pinning tasks to one core does not make a multi-instruction update

indivisible.

Step | Task A | Task B
1 | Read 0
2 | | Read 0
3 | Write 1
4 | | Write 1

### Even if a single aligned word load is indivisible on your target, a compound operation on it may not be. A multi-field record has another problem: a reader can see a new value with an old

timestamp if the writer updates the fields separately.

### You can avoid shared mutation by sending a record copy to one owner. When shared access is necessary, use a primitive whose contract covers the operation: an atomic operation for suitable small state, a brief critical section for a tiny shared update, or a mutex for

task-level exclusive access.

### The project uses queue copies for snapshots and short portMUX-protected regions for several cross-core records. We will

inspect that distinction before applying it to a driver handover.

COMMON PITFALL

Testing the race once and
seeing count=2 proves
only that one interleaving happened to work.

CHAPTER 08 / PROTECT SHARED STATE

# volatile does not make a conversation safe

Teaching counterexample - incomplete synchronisation
static volatile bool ready;
static Sample shared;

// Writer:
shared.valueC = 24.5f;
ready = true;

### volatile tells the compiler that accesses to that volatile object have observable significance. It is used for things such as hardware registers and some low-level interrupt-visible state. It does not automatically establish a correct shared-memory protocol for the

non-volatile Sample beside it.

### If another task waits for ready and then reads shared, you must also reason about ordering, visibility, concurrent writers and the lifetime of every field. Marking ready volatile does not turn shared into one

coherent published record. It does not make ++count atomic either.

For application code, a queue copy is often easier to reason about.

### The RTOS provides the communication operation; the sender finishes writing its local record before sending it. The receiver gets its own

copy when receive or peek succeeds.

### The original firmware contains volatile fields in specialised ISR and diagnostic paths. Do not copy that keyword into every shared variable and assume the problem is solved. Inspect each path's writer, reader, affinity, width and publication rules. A source

comment is a claim to review, not a substitute for that reasoning.

### const and volatile answer different questions. const restricts modification through a declaration. volatile affects how accesses are treated by the compiler. Neither one is the same as a mutex, a queue

or a complete atomic publication protocol.

COMMON PITFALL

A busy loop over a volatile flag can still starve the task expected to set it.

REMEMBER

Before choosing a keyword, name both actors and the
exact data they exchange.

CHAPTER 08 / PROTECT SHARED STATE

# A mutex gives one task temporary ownership

Teaching fragment - mutex previously created
if (xSemaphoreTake(busMutex, pdMS_TO_TICKS(20)) == pdTRUE) { performBoundedTransaction();
xSemaphoreGive(busMutex);
} else {
// No ownership was obtained. Do not use the bus. }

### A mutex is an exclusive-access object for tasks. A successful take gives this task permission to enter the protected operation. Another task attempting a blocking take can sleep until the mutex becomes available or its timeout expires. The holder must give it back on

every completion and error path.

### Why not protect only individual I2C bytes? Suppose the first task

writes a register address, a second task changes the device's pointer,

### then the first reads. The bytes may each be electrically valid while the logical transaction is wrong. Protect the whole operation that

must remain together.

### FreeRTOS mutexes provide priority inheritance: a low-priority holder can temporarily inherit a waiting higher priority under the mutex rules. That can reduce priority inversion, where urgent work waits behind less urgent work holding a resource. It does not make long

lock holds harmless or remove all possible deadlocks.

### The Hydroponics acquisition engine normally avoids bus competition by giving one worker all sensor drivers. Its flash gate is a different mutex: a ping holds it across the echo window so Configuration cannot start a flash write at the same time. The gate protects a

timing condition, not just a data structure.

### Mutexes are task-level objects. Do not take a blocking mutex in an interrupt. Interrupt code must finish promptly and use primitives

permitted in that context.

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

COMMON PITFALL

If Task A holds lock X and waits for Y while Task B
holds Y and waits for X,
neither can progress.
Define a consistent lock
order.

CHAPTER 08 / PROTECT SHARED STATE

# See why the lock holder may need a higher priority

### Take three tasks on one core: Low at priority 1, Medium at 4 and High at 6. Low already holds a mutex for a resource. High becomes Ready, preempts Low, tries to take that same mutex with a blocking

wait and becomes Blocked. High cannot finish until Low releases it.

### Without priority inheritance, a Ready Medium could keep winning over Low even though High is waiting for Low's resource. High's urgency would not help Low reach its release line. This dependency

is priority inversion.

Step with a FreeRTOS mutex | Effect in this one-mutex example
High blocks waiting for Low's mutex | Low temporarily inherits High's priority.
The scheduler selects the boosted Low | Low can finish its protected operation ahead of Medium.
Low gives its only held mutex | High can become Ready and acquire it; Low returns to its base priority.

### The mechanism shortens this particular delay. It cannot make a

blocked peripheral finish or repair a circular lock dependency.

### FreeRTOS uses simplified inheritance; multiple held mutexes have additional rules. Keep the lock order and completion paths understandable instead of relying on inheritance to repair an

arbitrary design.

### In the controller, the flash gate coordinates an echo interval with Configuration's flash write. The declaration of the lock does not tell you its whole cost. Follow the owner from successful take through

normal completion, timeout and cancellation to the matching give.

Reference: FreeRTOS: mutexes and priority inheritance (https://freertos.org/Real-time-embedded-RTOS-mutexes.html)

COMMON PITFALL

A binary semaphore does
not provide a mutex's
ownership and
priority-inheritance
contract.

CHAPTER 08 / PROTECT SHARED STATE

# Keep a critical section tiny

Teaching example - C
static portMUX_TYPE mux = portMUX_INITIALIZER_UNLOCKED; static uint32_t completed;

portENTER_CRITICAL(&mux);
++completed;
portEXIT_CRITICAL(&mux);

### In this ESP-IDF port, portMUX-based critical sections combine interrupt control on the current core with a spinlock that coordinates

the other core. A competing core can spin while the holder finishes. This is not the sleeping wait of a blocking mutex take.

### Use this for a few simple loads or stores, such as copying a small status record. Keep the protected region short, with a clear entry and exit. Both readers and writers that need the invariant must use the same protection. Locking only the writer does not stop an

unprotected reader from observing a partial update.

### Do not log, wait on a queue, write NVS, or run a sensor transaction while holding a portMUX. Any of those can take too long or call code that is not valid inside the critical section. Copy the required facts

under the lock; perform slow work afterward.

### For a large Snapshot, the project uses the queue mechanism instead of hand-writing a huge lock-protected copy protocol. For acquisition statistics, it uses a short critical section. Those choices follow the operation being protected, not a rule that one primitive is always

better.

### A driver will keep persistent state that one owner advances. Before reading that interface, compare the remaining signalling tools in this chapter. They organise events and conditions; they do not supply

another owner for the same driver.

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

REMEMBER

Critical sections on a
dual-core chip need
cross-core coordination.
Disabling interrupts on just one core is insufficient by itself.

CHAPTER 08 / PROTECT SHARED STATE

# Choose a token or an owner

### A binary semaphore holds either zero or one available token. An event producer can give it; a task can take it and optionally block while no token exists. Unlike a mutex, it is not an ownership lock

with priority inheritance.

Teaching fragment - include freertos/semphr.h
SemaphoreHandle_t done = xSemaphoreCreateBinary();
// New binary semaphore starts empty. Check done != NULL.

// Event producer in task context: xSemaphoreGive(done);

// Waiting task:
if (xSemaphoreTake(done, pdMS_TO_TICKS(100)) == pdTRUE) { // At least one completion token was obtained.
}

### If the producer gives twice before a take, a binary semaphore cannot retain two tokens. The second give can fail because the one-token capacity is full. This is suitable for a coalesced event, but not for

preserving every independent completion.

A counting semaphore can hold up to a configured maximum count.

### If you have three interchangeable free buffers, start with three tokens. Taking one reserves a buffer opportunity; giving one returns it. The semaphore tracks quantity, so you still need a separate way to

identify which specific buffer was reserved.

### A mutex instead expresses: this task owns this protected resource until it releases it. Its priority-inheritance behaviour is useful for task-level exclusion. Do not replace a bus mutex with a binary semaphore merely because both APIs have Take and Give in their

names.

### For waking one known worker, a direct task notification is often simpler and avoids another kernel object. Choose by the required semantics: ownership, event count, actual message contents, or a

retained state prompt.

Reference: FreeRTOS: binary semaphores (https://www.freertos.org/Documentation/02-Kernel/02-Kernel-features/02-Queues-mutexes-and-semaphores/02-Binary-semaphores)

COMMON PITFALL

A semaphore token does
not contain the sensor
result. You still need
defined storage and
publication for the data.

CHAPTER 08 / PROTECT SHARED STATE

# Wait for named conditions together

### An event group stores a set of bits. Each bit can represent a condition, such as network ready or configuration loaded. A task can

wait for any selected bit or all selected bits. The bits are conditions; repeated sets of the same bit do not count repeated events.

Teaching fragment - group created; include freertos/event_groups.h
const EventBits_t NET = 1u << 0;
const EventBits_t CFG = 1u << 1;
EventBits_t wanted = NET | CFG;
EventBits_t bits = xEventGroupWaitBits(
group, wanted, pdFALSE, pdTRUE, pdMS_TO_TICKS(500)); bool both = (bits & wanted) == wanted;

pdFALSE asks not to clear the requested bits on a successful exit.

### pdTRUE asks to wait for all requested bits. At 100ms, NET may be set while CFG is still clear. The task remains blocked. If CFG is set at

200ms, the all-bits condition is met and the task becomes Ready.

### If 500ms expires first, the returned bit value may contain NET

without CFG. Check the mask; do not treat every return as success.

### If you choose clear-on-exit, understand which bits are cleared when

the condition is met. Clearing changes what later waiters observe.

### This is useful for coarse readiness conditions. It is unsuitable for ten

distinct sensor results, command payloads, or a pulse-width history.

### Those need records or counters with the correct capacity. A group bit also does not prove that a condition remains true forever after a

task wakes.

### The reference acquisition design mainly uses notifications and copied records. Event groups are shown here so you can recognise an alternative RTOS tool without forcing it into a path that already

has a clear contract.

Reference: FreeRTOS: xEventGroupWaitBits (https://www.freertos.org/Documentation/02-Kernel/04-API-references/12-Event-groups-or-flags/04-xEventGroupWaitBits)

COMMON PITFALL

Event bits coalesce. Setting READY five times leaves
READY set once, not a
count of five.

CHAPTER 08 / PROTECT SHARED STATE

# Let a timer prompt work, then return

Teaching fragment - include freertos/timers.h
static void onTimer(TimerHandle_t timer) { (void)timer;
xTaskNotifyGive(workerHandle);
}

TimerHandle_t timer = xTimerCreate(
"Refresh", pdMS_TO_TICKS(1000), pdTRUE,
NULL, onTimer);
// Check timer != NULL, then check xTimerStart(timer, 0).

pdTRUE selects an auto-reload timer: after expiry it keeps running periodically until stopped or changed. A software-timer callback runs in the timer service task. A GPIO interrupt handler runs directly in interrupt context; this callback runs as task code in the shared timer service. The interrupt chapter will develop that distinction. Creating

a timer does not create a private task for its callback.

### That shared callback context must stay responsive. A blocking delay in one callback holds up other timer callbacks and command processing. Use a short action such as a notification, then let the

owning worker perform longer work.

### xTimerStart submits a command through the timer mechanism. A successful submission is not evidence that the callback has already run. Tick resolution and service-task scheduling affect when it executes. A 1s refresh prompt is an appropriate use; precise timing

of ultrasonic edges is not.

### The project instead stores many driver poll times in its acquisition scheduler. That keeps sensor scheduling decisions in one owner and makes overlap guards visible. You could use software timers to prompt that owner, but callbacks should not independently operate

the same driver objects.

### You now have several ways to arrange a future action. Use a task delay for the task's own waiting, a deadline scheduler for several stepped jobs, a software timer for a short deferred prompt, and a suitable peripheral or timestamped ISR for fine event timing. They

solve different time scales.

Reference: FreeRTOS: timer API header (https://github.com/FreeRTOS/FreeRTOS-Kernel/blob/main/include/timers.h)

COMMON PITFALL

Do not use a nonzero
queue or semaphore wait
from a software-timer
callback. It blocks the
shared timer service.

CHAPTER 09 / WRITE A DRIVER IN STEPS

# Remember enough to return later

Teaching example - C
typedef struct {
bool busy;
uint64_t dueMs;
float resultC;
} FakeDriver;

static void begin(FakeDriver *d, uint64_t nowMs) { d->busy = true;
d->dueMs = nowMs + 750;
}

### The sensor takes time, so begin stores the information a future call needs. If nowMs is 1000, the object remembers busy=true and dueMs=1750. The function then returns. The caller can service other

sensors or block the task instead of sitting in a wait loop.

At 1300ms, the driver is still busy and the due time has not arrived.

### At 1750ms or later, a poll function can collect the outcome. The driver object must live across those calls. That is why the acquisition module keeps its driver objects in static storage rather than as locals

that disappear after construction.

REMEMBER

Long elapsed conversion
time does not require long CPU execution time.

CHAPTER 09 / WRITE A DRIVER IN STEPS

### Remember enough to return later / continued

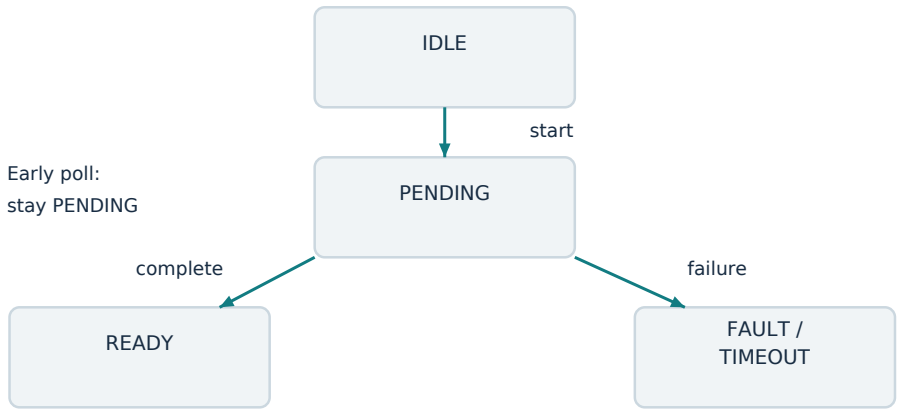
[picture p8: figure]
IDLE; PENDING; READY; FAULT /; TIMEOUT; start; complete; failure; Early poll:; stay PENDING

One operation moves from idle through pending to a completed or failed outcome.

A state machine is simply stored state plus rules for changing it when an event or time condition occurs. busy is enough for this toy. A more complex driver may store an enum for idle, measuring and reading a baseline. It still changes state one short step at a time.

begin does not create a task. The caller chooses when to call it and when to poll again. That distinction lets one acquisition task advance several independent physical operations.

CHAPTER 09 / WRITE A DRIVER IN STEPS

# Return both status and the next useful time

Teaching simplification - caller promises begin happened first
typedef struct {
bool ready;
uint64_t nextMs;
} FakePoll;

static FakePoll poll(FakeDriver *d, uint64_t nowMs) { if (d->busy && nowMs < d->dueMs) {
return (FakePoll){ false, d->dueMs }; }
d->busy = false;
d->resultC = 24.5f;
return (FakePoll){ true, nowMs }; }

### The return expressions are compound literals: (FakePoll){...} creates

a record value of the named type. The first return says: no result yet;

### do not bother again before dueMs. The second stores the invented

result and says it is available.

### Trace begin at 1000, poll at 1300, and poll at 1750. The first poll returns false with 1750. The second returns true with 1750 and stores 24.5. The caller did not need to poll every microsecond

between those times.

### The toy omits several checks to keep this trace small. A real driver must reject poll before start, handle a failed bus read, bound every call, and support cancellation. The original PollResult uses DRIVER_PENDING, DRIVER_READY and failure statuses rather than

a boolean.

### Cancellation matters when the rail disappears or a frame deadline passes. It must stop treating a later hardware event as part of the abandoned operation. In the ultrasonic chapter, disarming capture before the next ping prevents an old falling edge being credited to a

new measurement.

COMMON PITFALL

Returning PENDING without
a sensible future poll time can make the acquisition
worker spin. Returning a
far-future time can delay a result unnecessarily.

CHAPTER 09 / WRITE A DRIVER IN STEPS

# Let one caller use several drivers

Teaching fragment - driver is a persistent FakeDriver object
typedef struct {
void (*start)(FakeDriver *d, uint64_t nowMs); FakePoll (*poll)(FakeDriver *d, uint64_t nowMs); } FakeOps;

static const FakeOps ops = {
.start = begin,
.poll = poll
};

ops.start(&driver, 1000);

### void (*start)(...) declares a field named start that stores a pointer to a function. The pointed-to function returns void and accepts the listed parameters. The parentheses around *start are necessary: without

them, you would describe a different declaration.

### The initializer stores begin's address in the start field and poll's address in the poll field. It does not run either function. ops.start(...) later selects the stored function and calls it. This is indirect dispatch: the same calling code can choose a different implementation by

using a different table.

### Why do this? Acquisition needs to start, poll and collect results from

seven sensors. If every sensor exposes the same shape of interface,

### the acquisition loop can work through an array of driver pointers. It does not need a separate giant switch for every action on every

sensor.

### There is a cost: the table must point to functions with compatible types, and the correct state object must accompany each call. A bad cast does not make an incompatible function safe. The project uses a shared SensorDriver base and a table with a single agreed set of

signatures.

COMMON PITFALL

A function pointer is not a task handle. Calling
through it runs a normal
function in the calling task.

REMEMBER

Function name without call parentheses selects the
function. Parentheses with arguments request
execution.

CHAPTER 09 / WRITE A DRIVER IN STEPS

# Read the original operations table

Original firmware - src/drivers/sensor_driver.h, lines 51-62
DriverStatus (*init)(SensorDriver* self);

// Begin one measurement (e.g. trigger a conversion). Must
> | not block on it.
| DriverStatus (*start)(SensorDriver* self, MonoMs now);
| // Advance the measurement. Never blocks beyond the
> | documented budget.
| PollResult (*poll)(SensorDriver* self, MonoMs now);
| // Copy up to maxOut readings of the last completed
> | measurement.
| // Returns the number written. Health/quality are filled by
> | the driver;
| // powerEpoch/configRevision are stamped by the acquisition
> | service.
| uint8_t (*readResult)(SensorDriver* self, Reading* out,
> | uint8_t maxOut);

Original firmware - src/drivers/sensor_driver.h, lines 72-87
struct SensorDriver {
const SensorDriverOps* ops;
};

static inline SensorId sensorDriverId(const SensorDriver* d) { > return d->ops->id(d); }
static inline const char* sensorDriverName(const SensorDriver* > d) { return d->ops->name(d); }
static inline uint8_t sensorDriverMetricCount(const
> SensorDriver* d) { return d->ops->metricCount(d);

}
static inline DriverStatus sensorDriverInit(SensorDriver* d) { > return d->ops->init(d); }
static inline DriverStatus sensorDriverStart(SensorDriver* d, > MonoMs now) { return d->ops->start(d, now);

}
static inline PollResult sensorDriverPoll(SensorDriver* d, > MonoMs now) { return d->ops->poll(d, now);

}

COMMON PITFALL

A constructor fills the
object and its table pointer. It does not necessarily
configure the physical
sensor; init does that.

CHAPTER 09 / WRITE A DRIVER IN STEPS

### Read the original operations table / continued

SensorDriver contains an ops pointer. That pointer selects a constant SensorDriverOps table. In sensorDriverStart(), d->ops selects the table, ->start selects the function pointer in it, and (d, now) calls that function. now is the timestamp supplied by the acquisition owner.

Each concrete driver puts SensorDriver base as its first structure member. For example,

### LightDriver begins with SensorDriver base, then its configuration and private state. Its

constructor sets base.ops to the light table. Passing &light.base gives acquisition a generic view; the light implementation converts that initial-member pointer back to LightDriver * to reach its own fields.

This conversion relies on the actual object layout and the correct table/object pairing. It is not permission to cast any arbitrary pointer to any driver type. Keep base first and construct the object before calling through its table.

The interface asks init to configure the device, start to begin an operation, poll to advance it,

### readResult to copy completed records, cancel to abandon work, and preparePowerOff to make

interface pins suitable for a lost rail. These are ordinary calls made by the owning task.

We can now read sensor implementations without learning a new calling convention each time. Before opening the first one, we will define the result record they all return.

The source table also contains identity and metric-count functions. They let acquisition label a driver and allocate enough result space.

CHAPTER 09 / WRITE A DRIVER IN STEPS

# Distinguish progress from a valid measurement

### Every concrete driver must answer the same lifecycle questions. This is the shared interface that lets acquisition manage different devices

through an array of SensorDriver pointers.

### Read one operation at a time. The sensor chapters fill in the concrete

bodies behind this interface.

src/drivers/sensor_driver.h / lines 1-23
1 // Common sensor driver contract (Firmware Architecture §5, > §14).
2 // FROZEN CONTRACT - all seven drivers implement exactly > this interface.
3 //
4 // Rules for every driver:
5 // | - Know hardware, report status. No MQTT/BLE/WiFi
> | includes, no task
6 // | creation, no power-mode decisions, no relay changes.
7 // | - No hidden long delays. start() begins an operation;
> | poll() returns
8 // | Pending + the next time it is worth polling again. The
> | single
9 // | acquisition worker interleaves sensors using those
> | deadlines.
10 // | - Worst-case blocking of every call must be documented
> | and bounded.
11 // | - Configuration (bus, pins, address) is passed to the
> | constructor
12 // | (<name>DriverConstruct()).

13 //
14 // C object model: a driver is a struct whose FIRST member > is a SensorDriver.
15 // SensorDriver holds a pointer to the driver's const
> operations table (the
16 // "vtable"). Callers use the sensorDriver*() functions > below on a
17 // SensorDriver*, which dispatch through that table; the > driver casts the
18 // SensorDriver* back to its own type.
19 #pragma once
20 #include <stdbool.h>
21 #include <stdint.h>
22 #include "domain/reading.h"

23

COMMON PITFALL

Do not use if(status) as a universal success check;
DRIVER_OK is zero.

CHAPTER 09 / WRITE A DRIVER IN STEPS

### Distinguish progress from a valid measurement / continued

DriverStatus tells the caller what happened to the operation. OK means an operation such as

### start was accepted. PENDING means there is more work later. READY means an outcome can

be collected. The outcome itself still has a Health value, so READY can accompany a failed physical measurement.

src/drivers/sensor_driver.h / lines 24-37
24 typedef uint8_t DriverStatus;
25 enum {
26 | DRIVER_OK = 0, | // call accepted (init/start)
27 | DRIVER_PENDING, | // operation in progress, poll again at nextPollMs
28 | DRIVER_READY, | // result available via readResult()
29 | DRIVER_NOT_PRESENT, | // device missing / wrong identity
30 | DRIVER_FAULT, | // bus, CRC or range error
31 | DRIVER_TIMEOUT, | // exceeded its budget
32 | DRIVER_UNPOWERED, | // supply rail not available
33 | DRIVER_NOT_IMPLEMENTED | // stub (Stage 1 skeleton)

34 };

35
36 typedef struct PollResult {
37 DriverStatus status;

PollResult pairs that status with nextPollMs. If the driver is pending until 1750ms, returning that timestamp lets the caller do useful work or block until it becomes worth checking again.

CHAPTER 09 / WRITE A DRIVER IN STEPS

# Read a function-pointer member from its name

src/drivers/sensor_driver.h / lines 38-63
38 | MonoMs nextPollMs; | // meaningful when status ==
> | DRIVER_PENDING
39 } PollResult;

41 typedef struct SensorDriver SensorDriver;

43 typedef struct SensorDriverOps {
SensorId (*id)(const SensorDriver* self);
const char* (*name)(const SensorDriver* self);

// Number of Reading records this driver produces per > result.
uint8_t (*metricCount)(const SensorDriver* self);

// Probe and configure the device. May be called again > after a fault.
DriverStatus (*init)(SensorDriver* self);

// Begin one measurement (e.g. trigger a conversion). Must > not block on it.
DriverStatus (*start)(SensorDriver* self, MonoMs now);

// Advance the measurement. Never blocks beyond the > documented budget.
PollResult (*poll)(SensorDriver* self, MonoMs now);

// Copy up to maxOut readings of the last completed
> measurement.
// Returns the number written. Health/quality are filled > by the driver;
// powerEpoch/configRevision are stamped by the
> acquisition service.
uint8_t (*readResult)(SensorDriver* self, Reading* out, > uint8_t maxOut);

### In uint8_t (*readResult)(SensorDriver *self, Reading *out, uint8_t maxOut), readResult stores a function address. Calling it passes a generic driver pointer, destination records and a capacity, then

receives the number of records written.

COMMON PITFALL

A function table does not
enforce bounded
execution. Each concrete
implementation must keep
its promise.

CHAPTER 09 / WRITE A DRIVER IN STEPS

### Read a function-pointer member from its name / continued

src/drivers/sensor_driver.h / lines 64-70
64 | // Abandon any pending operation (deadline miss, quiesce request).
65 | void (*cancel)(SensorDriver* self);

66
67 | // Put the interface pins into a safe state before the rail is removed
68 | // (§12: no back-feeding an unpowered module).
69 | void (*preparePowerOff)(SensorDriver* self);
70 } SensorDriverOps;

init configures the hardware; start initiates one operation; poll advances it; readResult copies

### outcomes. cancel abandons a pending operation. preparePowerOff also makes interface pins

suitable for the lost rail. The driver owns protocol knowledge, while the acquisition owner chooses when to call these operations.

CHAPTER 09 / WRITE A DRIVER IN STEPS

# Follow the indirection without inventing a task

src/drivers/sensor_driver.h / lines 71-94

71
72 struct SensorDriver {
73 const SensorDriverOps* ops;

74 };

75
76 static inline SensorId sensorDriverId(const SensorDriver* d) sensorDriverId > { return d->ops->id(d); }
77 static inline const char* sensorDriverName(const sensorDriverName
> SensorDriver* d) { return d->ops->name(d); }
78 static inline uint8_t sensorDriverMetricCount(const sensorDriverMetricCount
> | SensorDriver* d) {
79 | return d->ops->metricCount(d);

80 }
81 static inline DriverStatus sensorDriverInit(SensorDriver* d) sensorDriverInit > { return d->ops->init(d); }
82 static inline DriverStatus sensorDriverStart(SensorDriver* sensorDriverStart
> | d, MonoMs now) {
83 | return d->ops->start(d, now);

84 }
85 static inline PollResult sensorDriverPoll(SensorDriver* d, sensorDriverPoll
> | MonoMs now) {
86 | return d->ops->poll(d, now);

87 }
88 static inline uint8_t sensorDriverReadResult(SensorDriver* sensorDriverReadResult
> | d, Reading* out, uint8_t maxOut) {
89 | return d->ops->readResult(d, out, maxOut);

90 }
91 static inline void sensorDriverCancel(SensorDriver* d) { sensorDriverCancel
> d->ops->cancel(d); }
92 static inline void sensorDriverPreparePowerOff(SensorDriver* sensorDriverPreparePowerOff > d) { d->ops->preparePowerOff(d); }

93
94 const char* driverStatusName(DriverStatus s); driverStatusName

SensorDriver contains one pointer to a constant operations table.

### sensorDriverStart reads that pointer, selects the start function and calls it with the original object address and now. The called body

executes in the current acquisition task.

### The thin inline wrappers make calling code readable without duplicating dispatch syntax everywhere. They assume a constructed

driver with a valid table; they do not check every pointer at runtime.

### A concrete constructor must establish base.ops before any wrapper

is used.

REMEMBER

The first-member base
conversion is explained in the lesson immediately
before this source reading.

CHAPTER 09 / WRITE A DRIVER IN STEPS

# Convert a status into a diagnostic string

This implementation supplies diagnostic names for the operation statuses. It is intentionally small because the lifecycle behaviour belongs to the concrete driver.

A readable log string is an interpretation of a stored enum; it is not a new status transition.

src/drivers/sensor_driver.c / lines 1-15
1 #include "drivers/sensor_driver.h"

3 const char* driverStatusName(DriverStatus s) { driverStatusName switch (s) {
case DRIVER_OK: return "OK";
case DRIVER_PENDING: return "PENDING";
case DRIVER_READY: return "READY";
case DRIVER_NOT_PRESENT: return "NOT_PRESENT"; case DRIVER_FAULT: return "FAULT";
case DRIVER_TIMEOUT: return "TIMEOUT";
case DRIVER_UNPOWERED: return "UNPOWERED";
case DRIVER_NOT_IMPLEMENTED: return "NOT_IMPLEMENTED";

}
return "?";

15 }

Each case returns a pointer to a string literal. Those literals have static storage duration, so the pointer remains valid after the function returns. The caller must treat the text as read-only.

The fallback handles an unexpected numeric value with a visible unknown marker. That makes diagnostics more robust, but it does not repair the invalid state that produced the value. Look at the status producer if this fallback appears in a log.

CHAPTER 10 / DECIDE WHETHER A READING IS USABLE

# Read the record in useful groups

Original firmware - src/domain/reading.h, lines 32-48
typedef struct Reading {
SensorId sensor;
MetricId metric;
Unit unit;
Health health;
uint16_t qualityFlags; | // QualityFlag bits
bool hasRaw;
float value; | // in `unit`; meaningless unless
> | health == Ok/Uncalibrated
int32_t raw; | // ADC counts / mV / raw register
> | value if hasRaw
MonoMs intervalStartMs; | // acquisition interval
MonoMs intervalEndMs;
MonoMs lastGoodMs; | // last usable result (OK or
> | UNCALIBRATED); 0 = never
uint32_t sequence; | // per-metric sample counter
uint32_t powerEpoch; | // rail epoch when measured (§12)
uint16_t configRevision;
uint16_t calibrationRevision;
} Reading;

### Start with sensor, metric and unit. A BME280 is one sensor, but it

publishes air temperature, humidity and pressure as three metrics. The unit tells you whether value is degrees Celsius, pascals,

### millivolts or something else. The same float type cannot tell those

apart.

REMEMBER

A record copy preserves
related fields together. It does not make the
underlying physical
measurements
simultaneous.

CHAPTER 10 / DECIDE WHETHER A READING IS USABLE

### Read the record in useful groups / continued

Next inspect health and qualityFlags. Health is the main verdict about this observation. Quality flags add qualifications such as uncompensated or saturated. hasRaw tells you whether raw is meaningful; raw's interpretation depends on the metric. For light it holds filtered pin millivolts, while for distance it holds pulse microseconds.

The interval fields bracket the operation. sequence distinguishes a newly published observation from a repeated peek at the same one. Acquisition increments the published sequence for failed observations as well, so a new fault does not disappear as an apparent resend of the previous good sample.

The revision fields identify the configuration and calibration used. powerEpoch identifies the rail history associated with the result. You do not need their full mechanisms yet; each is a tag that will let a consumer reject a result created under outdated conditions. We will give epoch its worked example in the power chapter (p. 463).

Reading is 56 bytes in this source layout. reading.c has a compile-time assertion for that size.

CHAPTER 10 / DECIDE WHETHER A READING IS USABLE

# Stored OK can become too old

Original firmware - src/domain/reading.c, lines 21-33
bool readingIsActionable(const Reading* r) { return r->health > == HEALTH_OK; }

Health readingHealthAt(const Reading* r, MonoMs now, uint32_t
> | staleLimitMs) {
| if (r->health != HEALTH_OK) return r->health;
| if (now > r->intervalEndMs && (now - r->intervalEndMs) >
> | staleLimitMs) {
| return HEALTH_STALE;
}
| return HEALTH_OK;
}

bool readingIsActionableAt(const Reading* r, MonoMs now,
> | uint32_t staleLimitMs) {
| return readingHealthAt(r, now, staleLimitMs) == HEALTH_OK;
}

### readingIsActionable() only checks stored health. readingHealthAt() also compares the observation's end time with the caller's current time. readingIsActionableAt() combines that age check with the OK requirement. Use the At form for decisions whose input can age

while no new sample arrives.

### Take an OK Reading whose intervalEndMs is 1000 and whose stale limit is 3000ms. At now=4000, its age is exactly 3000 and the source still returns OK. At 4001, the age is 3001 and it returns STALE. The

comparison is greater-than, not greater-than-or-equal.

### The function calculates an effective health; it does not write STALE into the original record. A different caller can evaluate the same retained record at another time. If the stored health is already

FAULT, the function returns FAULT before doing the age calculation.

### UNCALIBRATED means acquisition produced a useful raw or provisional value, but the numeric physical conversion is not accepted for ordinary rules. DEPENDENCY_INVALID means another

needed input, such as water temperature for TDS, was unsuitable.

### Neither should silently be relabelled OK because the float looks

reasonable.

### There is a specific exception for lamp control: its commissioned control quantity is pin millivolts, so it can use an uncalibrated light reading in those raw units. That is an explicit policy, not a rule that

every uncalibrated sensor may control an output.

COMMON PITFALL

lastGoodMs is historical
information. A current
FAULT does not become
actionable because a good
sample existed earlier.

CHAPTER 10 / DECIDE WHETHER A READING IS USABLE

# Measure ages with the monotonic clock

Original firmware - src/hal/clock.c, lines 1-5
#include "hal/clock.h"

#include <esp_timer.h>

MonoMs monoNowMs(void) { return (MonoMs)(esp_timer_get_time() / > 1000); }

esp_timer_get_time() provides microseconds since timer startup.

### Dividing by 1000 gives whole milliseconds. monoNowMs() names that conversion in one place so application code has a common time

source. MonoMs is the 64-bit unsigned alias introduced earlier.

### Use this clock for deadlines, age and elapsed intervals. Wall-clock time, such as a calendar time received from a network, can be corrected forward or backward. If a clock correction moves 20s backward, a freshness calculation based on that calendar time could

mistakenly keep an old reading fresh.

A monotonic timestamp still needs context. It starts again after reset;

### do not subtract a pre-reboot timestamp from a post-reboot timestamp as if they belonged to one continuous run. Logs and external consumers need a boot or session identity if they compare

records across restarts.

### Why use two resolutions?

### Sensor schedules and stale limits operate in milliseconds. An echo pulse is measured in microseconds. Converting the edge timestamps to milliseconds before subtracting would discard useful information: a 1000us pulse could collapse into only one tick or less of apparent

width. Keep the fine resolution until the width is calculated.

### The firmware's pulse HAL deliberately stores 32-bit microsecond timestamps and subtracts them unsigned. That shorter counter wraps; the interval operation can still work across one wrap for a suitably bounded pulse. We will calculate an example in the timeout

lesson (p. 313).

Reference: Espressif: high-resolution timer, v4.4.7 (S3) (https://docs.espressif.com/projects/esp-idf/en/v4.4.7/esp32s3/api-reference/system/esp_timer.html)

REMEMBER

The wrapper's resolution is 1ms. That does not
guarantee a task will wake or finish within 1ms.

CHAPTER 10 / DECIDE WHETHER A READING IS USABLE

# Name the observation verdict and its qualifications

### You have seen why a consumer needs more than a float. This header gives the production record its complete shape. Group the fields by

the question each one answers.

All drivers, acquisition, Safety and encoders share this contract.

COMMON PITFALL

A quality bit does not
cancel a health fault.
Consumers need a
declared acceptance policy for both fields.

CHAPTER 10 / DECIDE WHETHER A READING IS USABLE

### Name the observation verdict and its qualifications / continued

src/domain/reading.h / lines 1-28
1 // Reading contract and latest-snapshot record (Firmware Architecture §8). 2 // FROZEN CONTRACT - every driver, service and transport depends on it. 3 // Domain layer: pure C, no Arduino/FreeRTOS includes.
4 #pragma once
5 #include <stdbool.h>
6 #include <stdint.h>
7 #include "domain/types.h"

8
9 typedef uint8_t Health;
10 enum {
11 | HEALTH_STARTING = 0, | // no valid result yet
12 | HEALTH_WARMING, | // heater/filter/first conversion settling
13 | HEALTH_OK, | // fresh, valid, declared units/calibration
14 | HEALTH_STALE, | // last good value exceeded its age limit
15 | HEALTH_FAULT, | // transport, CRC, range or conversion error
16 | HEALTH_TIMEOUT, | // operation did not complete in its budget
17 | HEALTH_UNPOWERED, | // rail off or power epoch changed during measurement
18 | HEALTH_UNCALIBRATED, | // acquisition works, physical units not trustworthy
19 | HEALTH_DEPENDENCY_INVALID | // e.g. TDS without a valid water temperature

20 };

21
22 // Additional quality bits (combine with Health).
23 enum QualityFlag {
24 | kQualityNone = 0,
25 | kQualitySaturated = 1u << 0, | // ADC at/near rail
26 | kQualityUncompensated = 1u << 1, // compensation input missing
27 | kQualityFilterPartial = 1u << 2, // filter window not full
28 | kQualityLate = 1u << 3, | // completed after its deadline

Health is one main verdict: starting, warming, OK, stale, fault, timeout, unpowered, uncalibrated or dependency-invalid. QualityFlag adds independent details. Several quality bits can be set simultaneously because each occupies a different bit position.

src/domain/reading.h / lines 29-29

29 };

### The distinction prevents one enum from needing a separate value for every combination. A distance can be otherwise valid and still use nominal sound speed, so its health and

uncompensated flag answer different questions.

CHAPTER 10 / DECIDE WHETHER A READING IS USABLE

# Keep interpretation and history with the value

src/domain/reading.h / lines 30-48

30
31 // Fixed-size record, one per metric. Plain data: safe to > copy through queues.
32 typedef struct Reading {
33 | SensorId sensor;
34 | MetricId metric;
35 | Unit unit;
36 | Health health;
37 | uint16_t qualityFlags; | // QualityFlag bits
38 | bool hasRaw;
39 | float value; | // in `unit`; meaningless
> | unless health == Ok/Uncalibrated
40 | int32_t raw; | // ADC counts / mV / raw
> | register value if hasRaw
41 | MonoMs intervalStartMs; | // acquisition interval
42 | MonoMs intervalEndMs;
43 | MonoMs lastGoodMs; | // last usable result (OK or
> | UNCALIBRATED); 0 = never
44 | uint32_t sequence; | // per-metric sample counter
45 | uint32_t powerEpoch; | // rail epoch when measured
> | (§12)
46 | uint16_t configRevision;
47 | uint16_t calibrationRevision;
48 } Reading;

Reading stores identity, unit and health before the numeric fields.

### hasRaw says whether raw may be interpreted. intervalStartMs and intervalEndMs bracket the observation; lastGoodMs records the last

usable outcome; sequence identifies publication changes.

### powerEpoch, configRevision and calibrationRevision tag the conditions used for the result. They are not alternate clocks. A changed tag can make two equal numeric values represent different histories. We will use those tags when a configuration or rail

changes.

COMMON PITFALL

The old float can remain in memory after a new fault.
Health determines whether
that field currently
represents a usable
observation.

CHAPTER 10 / DECIDE WHETHER A READING IS USABLE

# A Snapshot is a retained collection

src/domain/reading.h / lines 49-68

49
50 // Latest-snapshot record published by the acquisition lease > holder (§8, §9).
51 // A coherent copy, NOT a simultaneous measurement of all
> sensors.
52 typedef struct Snapshot {
53 | uint32_t frameSequence;
54 | MonoMs publishedMs;
55 | uint32_t powerEpoch;
56 | Reading readings[METRIC_COUNT]; | // indexed by MetricId
57 } Snapshot;

58
59 // Initialise a record to STARTING with identity fields set. 60 void readingReset(Reading* r, SensorId sensor, MetricId readingReset
> metric, Unit unit);

61
62 // True if the stored health is OK. Does NOT check age: a > consumer that acts on
63 // the value (Safety, control rules) must use
> readingIsActionableAt() instead. readingIsActionableAt
64 bool readingIsActionable(const Reading* r); readingIsActionable

65
66 // True only for fresh, valid, calibrated data (eligible for > numeric rules):
67 // stored health OK and not older than staleLimitMs at `now` > (§10).
68 bool readingIsActionableAt(const Reading* r, MonoMs now, readingIsActionableAt
> uint32_t staleLimitMs);

### Snapshot groups the latest record for each metric in a fixed indexed array. publishedMs describes publication of that copy, not simultaneous conversion of all ten metrics. An air sample may have

completed much later than the retained water sample beside it.

The helper declarations expose reset and age-aware interpretation. readingIsActionable checks stored health only;

### readingIsActionableAt also considers the caller's now. A consumer

that can act after an arbitrary delay needs the latter question.

COMMON PITFALL

Do not refresh every metric merely by updating
Snapshot.publishedMs.

CHAPTER 10 / DECIDE WHETHER A READING IS USABLE

# Expose names and reset operations

src/domain/reading.h / lines 69-78

69
70 // Returns Stale if an Ok reading is older than staleLimitMs at `now`,
71 // otherwise the reading's current health.
72 Health readingHealthAt(const Reading* r, MonoMs now, uint32_t staleLimitMs); readingHealthAt

73
74 const char* healthName(Health h); healthName
75 const char* metricName(MetricId m); metricName
76 const char* unitName(Unit u); unitName

77
78 void snapshotReset(Snapshot* s); snapshotReset

The name helpers turn health, metric and unit identifiers into display strings. snapshotReset establishes the full collection's initial identity and starting states. These functions keep repeated initialisation and naming logic in one domain implementation.

The header declares what callers may request. It does not create a global Snapshot instance or start acquisition. We will now read the implementation to see exactly what each reset and age check changes.

CHAPTER 10 / DECIDE WHETHER A READING IS USABLE

# Start from a known record

### A helper this small is worth tracing completely. It establishes the boundary between a stored record and the consumer's current

interpretation.

### Keep a sample ending at 1000ms in mind while reading the age

checks.

src/domain/reading.c / lines 1-19
1 #include "domain/reading.h"

2
3 #include <string.h>

4
5 // The records must keep the layout they had in C++ (enum > class : uint8_t):
6 // they are copied through queues and sized into RAM
> budgets.
7 _Static_assert(sizeof(Reading) == 56, "Reading layout
> changed");
8 // 528 -> 584 bytes on 22 Oct 2026: MQ-7 CO signal replaced > by SGP30 TVOC + CO2eq.
9 _Static_assert(sizeof(Snapshot) == 584, "Snapshot layout > changed");

10
11 void readingReset(Reading* r, SensorId sensor, MetricId readingReset
> | metric, Unit unit) {
12 | memset(r, 0, sizeof(*r));
13 | r->sensor = sensor;
14 | r->metric = metric;
15 | r->unit = unit;
16 | r->health = HEALTH_STARTING;
17 | r->qualityFlags = kQualityNone;
18 | r->hasRaw = false;

19 }

### The compile-time size checks fail the build if Reading or Snapshot no

longer has the expected layout. memset zeroes the entire record,

### including padding, then explicit assignments establish identity and

HEALTH_STARTING.

### Zeroing alone would not communicate why a record is invalid. The explicit starting health says no accepted observation exists yet. The

record can be copied safely, but it is not yet a measurement.

COMMON PITFALL

A compile-time size
assertion checks layout,
not physical correctness or sufficient task stack space.

CHAPTER 10 / DECIDE WHETHER A READING IS USABLE

# Calculate effective health at the time of use

src/domain/reading.c / lines 20-33

20
21 bool readingIsActionable(const Reading* r) { return r->health == HEALTH_OK; } readingIsActionable

22
23 Health readingHealthAt(const Reading* r, MonoMs now, uint32_t staleLimitMs) { readingHealthAt
24 | if (r->health != HEALTH_OK) return r->health;
25 | if (now > r->intervalEndMs && (now - r->intervalEndMs) > staleLimitMs) {
26 | return HEALTH_STALE;
27 | }
28 | return HEALTH_OK;

29 }

30
31 bool readingIsActionableAt(const Reading* r, MonoMs now, uint32_t staleLimitMs) { readingIsActionableAt 32 return readingHealthAt(r, now, staleLimitMs) == HEALTH_OK; readingHealthAt

33 }

The stored-health helper returns true only for OK. readingHealthAt returns existing non-OK health immediately, then checks age only for OK. At exactly the stale limit the code retains OK; one millisecond beyond it becomes STALE.

The function does not edit the record through its const pointer. Different consumers can ask the same retained record about different now values. This is why a timed health check can discover staleness without waiting for another publication.

CHAPTER 10 / DECIDE WHETHER A READING IS USABLE

# Give diagnostics a stable vocabulary

src/domain/reading.c / lines 34-61

35 const char* healthName(Health h) { healthName
switch (h) {
case HEALTH_STARTING: return "STARTING"; case HEALTH_WARMING: return "WARMING"; case HEALTH_OK: return "OK";
case HEALTH_STALE: return "STALE";
case HEALTH_FAULT: return "FAULT";
case HEALTH_TIMEOUT: return "TIMEOUT";
case HEALTH_UNPOWERED: return "UNPOWERED";
case HEALTH_UNCALIBRATED: return "UNCALIBRATED";
case HEALTH_DEPENDENCY_INVALID: return "DEPENDENCY_INVALID";

}
return "?";

48 }

50 const char* metricName(MetricId m) { metricName
switch (m) {
case METRIC_AIR_TEMPERATURE: return "air_temperature"; case METRIC_AIR_HUMIDITY: return "air_humidity";
case METRIC_AIR_PRESSURE: return "air_pressure";
case METRIC_WATER_TEMPERATURE: return "water_temperature"; case METRIC_LIGHT_LEVEL: return "light_level";
case METRIC_WATER_DISTANCE: return "water_distance"; case METRIC_PH: return "ph";
case METRIC_TDS: return "tds";
case METRIC_TVOC: return "tvoc";
case METRIC_CO2EQ: return "co2eq";

### healthName and metricName use switches to return meaningful string literals. Read their mappings alongside types.h: the names are not inferred from the numeric values. An enum

constant and a protocol spelling are separate definitions that must stay consistent.

src/domain/reading.c / lines 62-65
case METRIC_COUNT: break;

}
return "?";

65 }

### The default path exposes an unexpected identifier as unknown. For a normal metric, the

returned literal can be used immediately in a bounded log or encoder. It should not be freed or modified.

CHAPTER 10 / DECIDE WHETHER A READING IS USABLE

# Label the numerical scale

src/domain/reading.c / lines 66-82

67 const char* unitName(Unit u) { unitName switch (u) {
case UNIT_NONE: return "";
case UNIT_DEG_C: return "degC"; case UNIT_PERCENT_RH: return "%RH"; case UNIT_PASCAL: return "Pa"; case UNIT_MILLIVOLT: return "mV"; case UNIT_MILLIMETRE: return "mm"; case UNIT_PH: return "pH";
case UNIT_PPM: return "ppm"; case UNIT_ADC_RAW: return "raw"; case UNIT_PPB: return "ppb"; case UNIT_LUX: return "lux";

}
return "?";

82 }

### unitName maps UNIT_PASCAL to Pa and UNIT_MILLIVOLT to mV, for example. It does not convert a number. A value of 101325 remains unchanged when you choose its label; any

conversion to another scale must be performed elsewhere.

Keeping naming separate from conversion avoids a display helper silently changing the control quantity. When reviewing telemetry, check the stored unit field as well as the name returned here.

CHAPTER 10 / DECIDE WHETHER A READING IS USABLE

# Recover the source device from a metric

src/domain/reading.c / lines 83-99

84 static SensorId metricSensor(MetricId m) { metricSensor switch (m) {
case METRIC_AIR_TEMPERATURE:
case METRIC_AIR_HUMIDITY:
case METRIC_AIR_PRESSURE: return SENSOR_BME280; case METRIC_WATER_TEMPERATURE: return SENSOR_DS18B20; case METRIC_LIGHT_LEVEL: return SENSOR_LIGHT;
case METRIC_WATER_DISTANCE: return SENSOR_HCSR04; case METRIC_PH: return SENSOR_PH;
case METRIC_TDS: return SENSOR_TDS;
case METRIC_TVOC:
case METRIC_CO2EQ: return SENSOR_SGP30; case METRIC_COUNT: break;

}
return SENSOR_COUNT;

99 }

Several case labels intentionally share one return. Temperature, humidity and pressure map to BME280; TVOC and CO2eq map to SGP30. This is a many-to-one relationship written directly as a switch.

### The sentinel return SENSOR_COUNT denotes no valid mapping. Callers must not use that sentinel as an array index without a range check. These mappings become useful when

configuration disables a whole sensor and every metric from it must change state.

CHAPTER 10 / DECIDE WHETHER A READING IS USABLE

# Reset all metric slots with their identities

src/domain/reading.c / lines 100-125

100
101 // The unit each driver publishes when calibrated. pH and light may publish 102 // mV while uncalibrated; the Reading's own unit field says which.
103 static Unit metricUnit(MetricId m) { metricUnit
104 | switch (m) {
105 | case METRIC_AIR_TEMPERATURE: return UNIT_DEG_C;
106 | case METRIC_AIR_HUMIDITY: return UNIT_PERCENT_RH;
107 | case METRIC_AIR_PRESSURE: return UNIT_PASCAL;
108 | case METRIC_WATER_TEMPERATURE: return UNIT_DEG_C;
109 | case METRIC_LIGHT_LEVEL: return UNIT_MILLIVOLT;
110 | case METRIC_WATER_DISTANCE: return UNIT_MILLIMETRE;
111 | case METRIC_PH: return UNIT_PH;
112 | case METRIC_TDS: return UNIT_PPM;
113 | case METRIC_TVOC: return UNIT_PPB;
114 | case METRIC_CO2EQ: return UNIT_PPM;
115 | case METRIC_COUNT: break;
116 | }
117 | return UNIT_NONE;

118 }

119
120 void snapshotReset(Snapshot* s) { snapshotReset
121 | memset(s, 0, sizeof(*s));
122 | for (uint8_t i = 0; i < METRIC_COUNT; ++i) {
123 | readingReset(&s->readings[i], metricSensor((MetricId)i), (MetricId)i, readingReset | metricSensor
> | metricUnit((MetricId)i)); metricUnit
124 | }

125 }

metricUnit supplies the initial unit expected for each metric. snapshotReset clears publication metadata, then walks through every valid metric index and calls readingReset with its sensor, metric and unit.

The light slot starts in millivolts because lux requires a fitted mapping. Later drivers may publish units and health that make their current calibration status explicit. The loop creates no sensor traffic; it only prepares RAM records.

CHAPTER 10 / DECIDE WHETHER A READING IS USABLE

# Publish and peek instead of exporting a writable global

This service gives other tasks a narrow way to obtain a complete retained copy. Its interface hides how the copy is stored.

Safety and the transports call this interface; they do not borrow the acquisition working object.

src/services/snapshot_store.h / lines 1-10
1 // Latest-snapshot mailbox (§8, §9). Length-one queue.
2 // Writer: the acquisition lease holder only (xQueueOverwrite). 3 // Readers: Safety, BLE, MQTT peek with zero wait - never consume. 4 #pragma once
5 #include <stdbool.h>
6 #include "domain/reading.h"

7
8 bool snapshotStoreInit(void); snapshotStoreInit
9 void snapshotPublish(const Snapshot* snapshot); snapshotPublish
10 bool snapshotPeek(Snapshot* out); // false if nothing published yet snapshotPeek

snapshotPublish accepts a const source because the store copies from it. snapshotPeek accepts a writable destination because the service fills caller-owned storage. A false result means no valid queue item was obtained; it does not supply a new Snapshot.

This ownership direction is visible in the parameter types. The interface never returns a pointer into its internal queue storage. The consumer receives a copy it can age-check without blocking the producer's future updates.

CHAPTER 10 / DECIDE WHETHER A READING IS USABLE

# Reserve the actual retained item

### The complete storage mechanism is one statically allocated queue item. You already know why overwrite and peek fit a latest-state

contract.

### Read the implementation with sizeof(Snapshot) as the item size, not

a pointer size.

src/services/snapshot_store.c / lines 1-15
1 #include "services/snapshot_store.h"

2
3 #include <freertos/FreeRTOS.h>
4 #include <freertos/queue.h>

5
6 static StaticQueue_t s_queueControl;
7 static uint8_t s_queueStorage[sizeof(Snapshot)]; 8 static QueueHandle_t s_queue = NULL;

9
10 bool snapshotStoreInit(void) { snapshotStoreInit
11 | if (s_queue == NULL) {
12 | s_queue = xQueueCreateStatic(1, sizeof(Snapshot), xQueueCreateStatic
> | s_queueStorage, &s_queueControl);
13 | }
14 | return s_queue != NULL;

15 }

### s_queueStorage has enough bytes for one Snapshot, and s_queueControl supplies the kernel bookkeeping. The queue handle begins null. The null guard makes repeated initialisation return the

existing queue rather than allocating another one.

### xQueueCreateStatic receives capacity one, item size, storage and control addresses. The item is initially absent: creating its storage is

not the same as publishing an initial Snapshot.

COMMON PITFALL

Static queue storage must
outlive the queue. A local array inside this init
function would not be
suitable.

CHAPTER 10 / DECIDE WHETHER A READING IS USABLE

# Copy into and out of the mailbox

src/services/snapshot_store.c / lines 16-24

16
17 void snapshotPublish(const Snapshot* snapshot) { snapshotPublish
18 if (s_queue != NULL) xQueueOverwrite(s_queue, snapshot); xQueueOverwrite

19 }

20
21 bool snapshotPeek(Snapshot* out) { snapshotPeek
22 | if (s_queue == NULL || out == NULL) return false;
23 | return xQueuePeek(s_queue, out, 0) == pdTRUE; xQueuePeek

24 }

Publish ignores a request if initialisation failed; otherwise overwrite installs the latest full copy. Peek rejects a missing queue or destination and asks for an immediate copy without removing the retained item.

### Multiple consumers can inspect the latest state independently. They may see different

publications if acquisition runs between their peeks, but each successful peek is one internally coordinated queue copy. A reader must still inspect individual Reading ages.

CHAPTER 10 / DECIDE WHETHER A READING IS USABLE

# Read a sensor set as several yes/no bits

Configuration and power policy often select whole groups of sensors. This header represents such a group as a bit mask.

### A sensor bit answers membership, while SensorId still identifies one

device.

src/domain/sensor_set.h / lines 1-27
1 // Fixed sensor set as the app sees it (FirmwareContract.md > v2, "Sensors").
2 // Pure C. Work package WP8 (Stage 5).
3 //
4 // Sensors are fixed by the board (pins in board_profile.h). > The app can only
5 // enable or disable them; the enabled set is a SensorMask > persisted by
6 // Configuration. Keys are the protocol names, stable across > firmware versions.
7 #pragma once
8 #include <stdbool.h>
9 #include <stddef.h>
10 #include <stdint.h>

11
12 #include "domain/reading.h"
13 #include "domain/types.h"

14
15 typedef uint8_t SensorMask; // bit per SensorId
16 #define SENSOR_MASK_ALL ((SensorMask)((1u << SENSOR_COUNT) -> 1u))
17 // Sensors on the external, switched 5 V rail (§14), gated > on the rail epoch.
18 #define SENSOR_MASK_RAIL_5V ((SensorMask)((1u <<
> SENSOR_HCSR04) | (1u << SENSOR_PH) | (1u << SENSOR_TDS)))

19
20 static inline bool sensorMaskHas(SensorMask mask, SensorId sensorMaskHas
> | s) {
21 | return s < SENSOR_COUNT && (mask & (1u << s)) != 0;

22 }

23
24 // Protocol key ("bme280", "ds18b20", "light", "hcsr04", > "ph", "tds", "sgp30").
25 const char* sensorKey(SensorId s); sensorKey
26 const char* sensorLabel(SensorId s); sensorLabel

27

### The mask constants combine 1u << SENSOR_... positions. OR builds a set; AND tests membership; complement can remove permitted

bits when intersected with a known all-sensors mask.
sensorMaskHas protects against shifting by an invalid sensor index.

COMMON PITFALL

Always constrain a
complemented mask to
supported bits. ~mask
alone also sets unrelated
high bits.

CHAPTER 10 / DECIDE WHETHER A READING IS USABLE

### Read a sensor set as several yes/no bits / continued

Worked mask - pH is SensorId 4 in types.h
uint8_t all = 0x7Fu; | // bits 0 through 6
uint8_t phBit = (uint8_t)(1u << 4); // 0x10
uint8_t withoutPh = (uint8_t)(all & ~phBit);
// withoutPh = 0x6F = 111

Read ~ as bitwise complement: it flips each bit of the promoted integer. It differs from logical !, which gives a true/false answer. AND with all keeps only the seven supported positions and clears bit 4. The result includes every supported sensor except pH. This same operation will produce Safety's disabled-sensor mask from the enabled set.

src/domain/sensor_set.h / lines 28-42
28 // What disabling this sensor does to the others (app warning), "" if nothing. 29 const char* sensorDependsNote(SensorId s); sensorDependsNote

30
31 // SENSOR_COUNT if the key (len bytes, not NUL-terminated) is unknown.
32 SensorId sensorFromKey(const char* key, size_t len); sensorFromKey

33
34 // Sensor that produces a metric; SENSOR_COUNT for an invalid metric.
35 SensorId sensorOfMetric(MetricId m); sensorOfMetric

36
37 // Consumer-side rail check (§12), on a snapshot copy: acquisition checks the 38 // epoch when it accepts a result, but the rail can fail after that. Every 5 V 39 // reading measured in another epoch than railEpoch, or any 5 V reading while 40 // the rail is not valid now, becomes UNPOWERED (never shown, captured or
41 // acted on). STARTING readings are left as they are.
42 void snapshotGateRail(Snapshot* s, bool railValid, uint32_t railEpoch); snapshotGateRail

The header also declares names, dependency descriptions and rail-gating helpers. These are

### mappings over existing records, not driver calls. Later the low-power policy can select

retained-rail sensors without teaching the protocol encoder about individual GPIOs.

CHAPTER 10 / DECIDE WHETHER A READING IS USABLE

# Map external names to checked identities

### This file translates between human-readable sensor keys, metric ownership and rail

membership. It lets services apply a whole-sensor decision consistently.

The mappings are shared policy facts. A transport should not duplicate a private, slightly different list.

src/domain/sensor_set.c / lines 1-26
1 #include "domain/sensor_set.h"

2
3 #include <string.h>

4
5 typedef struct SensorInfo {
6 | const char* key;
7 | const char* label;
8 | const char* dependsNote;
9 } SensorInfo;

10
11 // Indexed by SensorId.
12 static const SensorInfo kSensors[SENSOR_COUNT] = {
13 | {"bme280", "BME280 air temperature, humidity, pressure",
14 | "SGP30 loses humidity compensation"},
15 | {"ds18b20", "DS18B20 water temperature", "TDS loses temperature compensation"},
16 | {"light", "DFR0026 light level", "Automatic lamp stays OFF"},
17 | {"hcsr04", "HC-SR04 water level", ""},
18 | {"ph", "pH-4502C solution pH", ""},
19 | {"tds", "SEN0244 TDS", ""},
20 | {"sgp30", "SGP30 TVOC / CO2eq", ""},

21 };

22
23 const char* sensorKey(SensorId s) { return s < SENSOR_COUNT ? kSensors[s].key : "?"; } sensorKey

24
25 const char* sensorLabel(SensorId s) { return s < SENSOR_COUNT ? kSensors[s].label : "?"; sensorLabel
> | }

26

### The tables hold a machine key, a display label and a dependency note for each sensor. The

lookup helpers guard the index before selecting an entry. sensorFromKey accepts a pointer and an explicit byte count: the input need not end with a NUL byte. It requires both matching length and matching bytes.

### Map external names to checked identities / continued

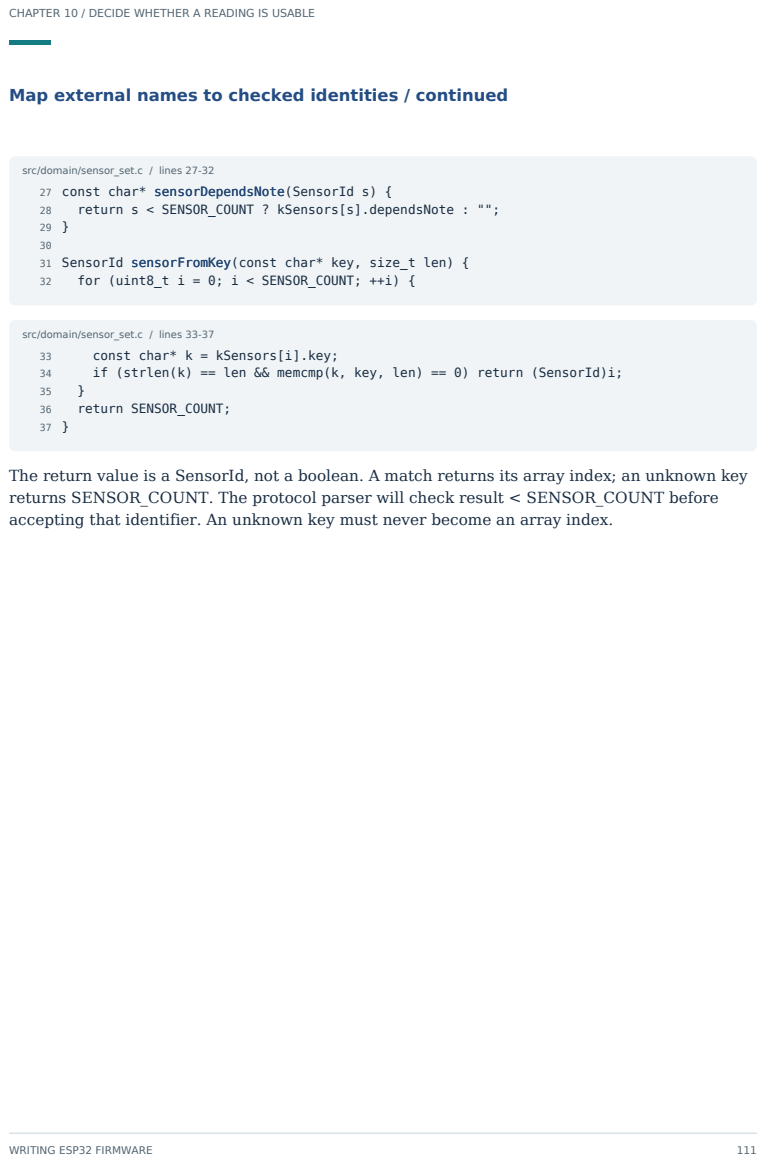
[picture p9: page 111]
return s < SENSOR_COUNT ? kSensors[s].dependsNote : "";; for (uint8_t i = 0; i < SENSOR_COUNT; ++i) {; const char* k = kSensors[i].key;; if (strlen(k) == len && memcmp(k, key, len) == 0) return (SensorId)i;; return SENSOR_COUNT;

CHAPTER 10 / DECIDE WHETHER A READING IS USABLE

src/domain/sensor_set.c / lines 27-32
27 const char* sensorDependsNote(SensorId s) { sensorDependsNote

31 SensorId sensorFromKey(const char* key, size_t len) { sensorFromKey

src/domain/sensor_set.c / lines 33-37

The return value is a SensorId, not a boolean. A match returns its array index; an unknown key
returns SENSOR_COUNT. The protocol parser will check result < SENSOR_COUNT before
accepting that identifier. An unknown key must never become an array index.

CHAPTER 10 / DECIDE WHETHER A READING IS USABLE

# Make old rail-dependent values visibly unusable

src/domain/sensor_set.c / lines 38-46

38
39 void snapshotGateRail(Snapshot* s, bool railValid, uint32_t railEpoch) { snapshotGateRail
40 | for (uint8_t m = 0; m < METRIC_COUNT; ++m) {
41 | Reading* r = &s->readings[m];
42 | if (!sensorMaskHas(SENSOR_MASK_RAIL_5V, sensorOfMetric((MetricId)m))) continue; sensorMaskHas | sensorOfMetric
43 | if (r->health == HEALTH_STARTING || r->health == HEALTH_UNPOWERED) continue;
44 | if (!railValid || r->powerEpoch != railEpoch) r->health = HEALTH_UNPOWERED;
45 | }

46 }

snapshotGateRail edits the caller's Snapshot copy. For a 5V sensor, a down rail or mismatched epoch makes the record UNPOWERED. The function does not write the original publication, toggle a supply or read an ADC.

Safety uses this as a second acceptance boundary: even a queued Snapshot that was valid when published can become invalid before the current decision. The caller's fresh rail state is therefore part of the interpretation.

CHAPTER 10 / DECIDE WHETHER A READING IS USABLE

# Keep the metric-to-sensor relationship explicit

src/domain/sensor_set.c / lines 47-63

48 SensorId sensorOfMetric(MetricId m) { sensorOfMetric switch (m) {
case METRIC_AIR_TEMPERATURE:
case METRIC_AIR_HUMIDITY:
case METRIC_AIR_PRESSURE: return SENSOR_BME280; case METRIC_WATER_TEMPERATURE: return SENSOR_DS18B20; case METRIC_LIGHT_LEVEL: return SENSOR_LIGHT;
case METRIC_WATER_DISTANCE: return SENSOR_HCSR04; case METRIC_PH: return SENSOR_PH;
case METRIC_TDS: return SENSOR_TDS;
case METRIC_TVOC:
case METRIC_CO2EQ: return SENSOR_SGP30; case METRIC_COUNT: break;

}
return SENSOR_COUNT;

63 }

### sensorOfMetric groups all BME280 metrics under BME280 and both gas metrics under SGP30, then handles the single-metric sensors. An

invalid metric returns SENSOR_COUNT.

When you add a metric, review this switch together with types.h,

### snapshotReset and protocol output. Otherwise the value may be measured correctly but fail to follow its sensor's enable, rail or

dependency policy.

COMMON PITFALL

There are mapping helpers
in reading.c as well.
Duplicated mappings need
coordinated updates when
the metric set changes.

CHAPTER 11 / BUILD THE LIGHT MEASUREMENT

# First obtain millivolts at the pin

### The light module changes its output voltage with illumination. The ESP32 ADC converts an input voltage into a digital result. The HAL hides the ADC-specific setup and returns calibrated millivolts. The

driver then decides how to label and filter them.

Original firmware - src/hal/adc_channel.c, lines 14-21
bool adcChannelBegin(AdcChannel* ch, int8_t pin) {
ch->pin_ = ADC_CHANNEL_NO_PIN;
if (pin < kAdc1FirstPin || pin > kAdc1LastPin) return false; analogReadResolution(12);
analogSetPinAttenuation((uint8_t)pin, ADC_11db);
ch->pin_ = pin;
return true;
}

### adcChannelBegin first marks the channel unassigned. It rejects pins outside this project's ADC1 range, sets 12-bit resolution and configures attenuation, then stores the valid pin number. Returning true means setup was accepted; it does not prove the sensor is

connected or that its voltage is physically accurate.

### 12 bits give 4096 possible raw codes, 0 through 4095. An ideal 3.3V full-scale converter would have a step near 0.806mV, but this ADC's transfer curve and attenuation require calibration. Do not convert every raw code with 3300/4095 and assume that is the board's

measured behaviour.

### The HAL calls analogReadMilliVolts(). ADC calibration maps conversion results to voltage; light calibration later maps voltage to lux. Those are two different calibrations. A good millivolt reading

does not by itself supply a lux model.

### For this board, the light signal goes through 10kOhm and has 1uF to ground at the input. The nominal RC time constant is 10ms. That circuit smooths the signal, but the driver still collects a time-spread

window because lamp flicker can remain.

Reference: Espressif: ADC, v4.4.7 (S3) (https://docs.espressif.com/projects/esp-idf/en/v4.4.7/esp32s3/api-reference/peripherals/adc.html)

TIP

Board pin assignments
belong to this ESP32-S3
snapshot. Use
board_profile.h rather than copying pins to another
ESP32 model.

COMMON PITFALL

Attenuation changes the
measurable input range. It does not authorise
exceeding a pin's electrical ratings.

CHAPTER 11 / BUILD THE LIGHT MEASUREMENT

# Spread samples across time

### The light driver takes ten samples, with each new sample due 11ms after the previous actual one. The first sample happens in start(). The remaining nine happen in later poll() calls. With no delay, the

window spans at least 9 x 11 = 99ms.

Original firmware - src/drivers/light.c, lines 59-66
// Spacing is measured from the previous actual sample, never
> | from the window
| // start: after a late poll, catching up would compress the
> | filter taps.
| const MonoMs due = self->lastSampleMs_ +
> | LIGHT_SAMPLE_SPACING_MS;
| if (now < due) {
| r.status = DRIVER_PENDING;
| r.nextPollMs = due;
| return r;
}

### due is calculated from lastSampleMs_, not from the window start plus a count. Suppose a sample was intended near 22ms but the task actually gets it at 28ms. The next sample is due at 39ms. Taking two immediate samples at 28ms to catch up would compress the

observation window.

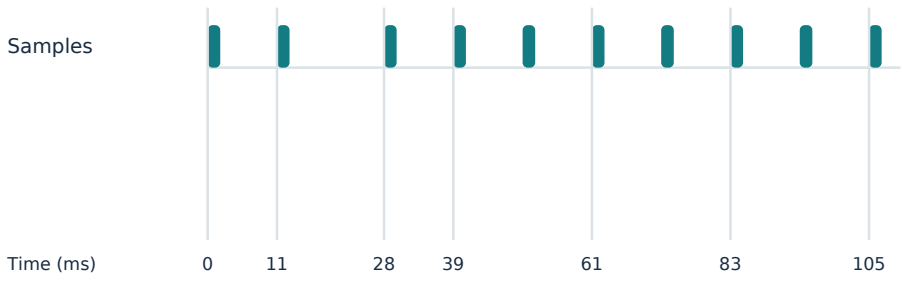
[picture p10: figure]
Samples; Time (ms)

Worked light window: one late sample moves the next useful tap, not the past.

### Why 11ms? With 100Hz flicker, the light waveform repeats every 10ms. Sampling exactly every 10ms could repeatedly hit the same phase. An 11ms interval walks through that phase instead. It does not guarantee perfect rejection of every lighting waveform, but it

gives the chosen filter a reason to use separated observations.

### When poll returns PENDING, the acquisition task can work on another sensor or wait. The window occupies elapsed time without making ten back-to-back ADC calls. You can now connect the driver's

nextPollMs to the deadline wait you already learned.

COMMON PITFALL

Ten rapid samples are not
equivalent to ten samples
spread across a flicker
cycle. The number of
samples alone does not
define a filter.

CHAPTER 11 / BUILD THE LIGHT MEASUREMENT

# Calculate a filtered value by hand

### The driver sorts ten millivolt samples and removes the two lowest and two highest. It averages the remaining six. This is a trimmed mean: isolated extreme values have less influence than they would in

an ordinary mean.

Worked data - sorted values, not executable C
10, 98, 99, 100, 100, 101, 101, 102, 103, 900 // Remove: 10, 98, 103, 900
// Keep: 99, 100, 100, 101, 101, 102
// Sum = 603; mean = 603 / 6 = 100.5mV

### An ordinary mean of all ten would be 171.4mV because of the 900mV spike. The trimmed mean is 100.5mV. That shows precisely which sort of disturbance this filter helps with. If all ten values are biased

upward, trimming does not recover the true light level.

Original firmware - src/domain/calibration.c, lines 34-48
float trimmedMeanU32(uint32_t* samples, uint8_t n, uint8_t
> trim) {
if (n <= 2u * trim) return 0.0f;
for (uint8_t i = 1; i < n; ++i) { // insertion sort: n is ~10 const uint32_t v = samples[i];
uint8_t j = i;
while (j > 0 && samples[j - 1] > v) {
samples[j] = samples[j - 1];
--j;
}
samples[j] = v;
}
uint64_t sum = 0;
for (uint8_t i = trim; i < n - trim; ++i) sum += samples[i]; return (float)sum / (float)(n - 2u * trim);
}

### The function uses insertion sort because the array is small. v holds the next value to insert. j moves backward while earlier values are larger, shifting them one slot right. The final assignment places v in its sorted position. The function sorts the supplied array in place; it

does not preserve the original order.

### The accumulator is uint64_t so adding several uint32_t values does not immediately overflow 32 bits. The denominator n - 2*trim is the number of retained values. The initial guard rejects a window with no retained values. For our ten-sample, two-trim case, that

denominator is six.

REMEMBER

A filter reduces selected
disturbances. It does not
prove connection,
calibration or freshness.

CHAPTER 11 / BUILD THE LIGHT MEASUREMENT

# Publish the unit you can justify

Original firmware - src/drivers/light.c, lines 87-94
Reading* r = &self->result_; r->intervalStartMs = self->startMs_; r->intervalEndMs = now;
r->hasRaw = true;
r->raw = (int32_t)(pinMv + 0.5f);
// Clipped = brighter than the ADC can show: a lower bound,
> | not a fault.
| r->qualityFlags = self->saturated_ ? kQualitySaturated :
> | kQualityNone;
| r->calibrationRevision = self->config_.calibration.revision;

### pinMv is the filtered result. raw stores rounded pin millivolts so the lamp policy can use the same control quantity even after a lux calibration. calibrationRevision records which fit produced the

physical value.

Without a valid light calibration, the driver publishes value=pinMv,

### unit=MILLIVOLT and health=UNCALIBRATED. It has measured a voltage, but has not established a trustworthy lux conversion. With a valid gain, it can publish lux and OK, provided the computed value is

finite.

### For a worked calibration, suppose a reference meter says 500lux while the filtered pin voltage is 100mV. A gain-through-zero model uses 5lux/mV. At 140mV it predicts 700lux. This is a chosen model; a single point does not establish linearity over the whole range or

every light spectrum.

Saturation has a metric-specific interpretation. The ADC may reach its ceiling in bright light. The light driver keeps a lower-bound indication and sets a quality flag rather than pretending it knows the full illumination. The lamp can interpret saturation as bright. That same approach would be wrong for a pH voltage clipped at the ADC

ceiling.

### A disconnected light signal is harder: the capacitor may retain a plausible voltage, and near-zero voltage can be real darkness. The driver cannot reliably identify every unplugged condition from these samples. Later policy cannot manufacture information the electrical

interface never supplied.

COMMON PITFALL

Do not label a voltage lux merely because a library or variable name sounds like
a physical unit.

CHAPTER 11 / BUILD THE LIGHT MEASUREMENT

# Keep the ADC state smaller than the sensor state

### Begin the production light path at the electrical boundary. This interface promises a pin-voltage result; it deliberately says nothing

about lux, pH or ppm.

### The three analog drivers reuse this adapter with different pins and

conversion policies.

COMMON PITFALL

The approximate range in
the source comment is a
board-characterisation
assumption, not a universal guarantee for every
attenuation and chip.

CHAPTER 11 / BUILD THE LIGHT MEASUREMENT

### Keep the ADC state smaller than the sensor state / continued

src/hal/adc_channel.h / lines 1-24
1 // ADC1 channel adapter (HAL). Work package WP3 (shared by light, pH and TDS). 2 // ADC1 only: ADC2 conflicts with Wi-Fi (§3). Returns calibrated millivolts at
3 // the ESP32 pin; divider recovery and units belong to domain/calibration.h.
4 //
5 // 12-bit, 11 dB attenuation (S3 usable range about 0-3100 mV), eFuse calibration. 6 // Worst-case blocking: one conversion per read, well under 1 ms.
7 #pragma once
8 #include <stdbool.h>
9 #include <stdint.h>

10
11 #define ADC_CHANNEL_NO_PIN ((int8_t)-1)

12
13 // Treat the members as private to adc_channel.c. Initialise with ADC_CHANNEL_INIT. 14 typedef struct AdcChannel {
15 int8_t pin_;
16 } AdcChannel;

17
18 #define ADC_CHANNEL_INIT {ADC_CHANNEL_NO_PIN}

19
20 // false if the pin is not an ADC1 pin (GPIO1-10 on the S3); the channel then 21 // stays unusable and every read fails.
22 bool adcChannelBegin(AdcChannel* ch, int8_t pin); adcChannelBegin
23 // One conversion. false on error. Reports saturation near full scale.
24 bool adcChannelReadMilliVolts(AdcChannel* ch, uint32_t* mv, bool* saturated); adcChannelReadMilliVolts

### AdcChannel stores only an assigned pin. ADC_CHANNEL_INIT gives it the unassigned sentinel

before setup. A negative sentinel fits int8_t; it would not mean the same thing if stored in an unsigned pin field.

The read function can fill a millivolt output and a saturation flag. Those are optional output

### addresses in this implementation. The boolean return concerns the adapter's accepted

operation; a plausible voltage alone cannot prove a physically connected probe.

CHAPTER 11 / BUILD THE LIGHT MEASUREMENT

# Make a channel unusable before validating it

### Now follow the adapter from validation to one conversion. Notice

which checks it can perform and which it cannot.

### The light driver will turn this result into a filtered window rather

than changing this shared HAL.

src/hal/adc_channel.c / lines 1-21
1 #include "hal/adc_channel.h"

2
3 #include <Arduino.h>
4 #include <stddef.h>

5
6 // ESP32-S3: ADC1 is GPIO1-10 (ADC2 conflicts with Wi-Fi, > §3).
7 static const int8_t kAdc1FirstPin = 1;
8 static const int8_t kAdc1LastPin = 10;

9
10 // At 11 dB (ADC_ATTEN_DB_12 in IDF 5) the S3 measures about > 0-3100 mV. Treat a
11 // calibrated result at or above this ceiling as clipped.
> Characterise per board.
12 static const uint32_t kSaturationMv = 3050;

13
14 bool adcChannelBegin(AdcChannel* ch, int8_t pin) { adcChannelBegin
15 | ch->pin_ = ADC_CHANNEL_NO_PIN;
16 | if (pin < kAdc1FirstPin || pin > kAdc1LastPin) return
> | false;
17 | analogReadResolution(12);
18 | analogSetPinAttenuation((uint8_t)pin, ADC_11db);
19 | ch->pin_ = pin;
20 | return true;

21 }

### The function first writes the unassigned sentinel, then validates the requested pin against this S3 ADC1 range. A rejected call therefore

does not leave a previously assigned pin accidentally usable.

### After setting resolution and attenuation, it records the valid pin. The function does not allocate a task, reserve a sample window or

perform light calibration. Those operations belong to later layers.

COMMON PITFALL

A hardware configuration
call affects a peripheral. Review its scope before
assuming every setting is
private to one AdcChannel
object.

CHAPTER 11 / BUILD THE LIGHT MEASUREMENT

# Return voltage and clipping as separate outputs

src/hal/adc_channel.c / lines 22-32

22
23 bool adcChannelReadMilliVolts(AdcChannel* ch, uint32_t* mv, bool* saturated) { adcChannelReadMilliVolts
24 | if (mv) *mv = 0;
25 | if (saturated) *saturated = false;
26 | if (ch->pin_ < 0) return false;
27 | // eFuse-calibrated conversion (esp_adc_cal). One conversion, a few tens of us.
28 | const uint32_t value = analogReadMilliVolts((uint8_t)ch->pin_);
29 | if (mv) *mv = value;
30 | if (saturated) *saturated = value >= kSaturationMv;
31 | return true;

32 }

The function clears requested outputs before checking the channel. It rejects an unassigned pin, then calls analogReadMilliVolts and compares the result with the chosen saturation threshold. A caller can distinguish a completed voltage conversion from the flag saying it is near the useful ceiling.

Notice a limitation of this API path: the wrapper has no separate hardware error result returned by analogReadMilliVolts. Its true return mainly means the channel was assigned and the call path completed. Do not describe it as independent proof that the ADC and probe both passed diagnostics.

CHAPTER 11 / BUILD THE LIGHT MEASUREMENT

# Describe a fitted line and its validity

### This header holds mathematical helpers shared by light, pH and TDS. Learn the data shape

now; the pH and TDS chapters will show why the same fields mean different physical mappings.

A calibration record is copied into a driver configuration. It is not a pointer to a live editing screen.

src/domain/calibration.h / lines 1-25
1 // Unit conversion and calibration stages (§3, §14). Pure C. 2 // Work packages: WP5 (pH/TDS), WP3 (light).
3 #pragma once
4 #include <stdbool.h>
5 #include <stdint.h>

6
7 // Recover the module output voltage from the ADC pin voltage through a
8 // resistor divider: Vmodule = Vadc * (Rtop + Rbottom) / Rbottom.
9 // Use MEASURED resistor values once available (§3).
10 float dividerRecoverMv(float adcMv, uint32_t rTopOhm, uint32_t rBottomOhm); dividerRecoverMv

11
12 // Linear fit y = slope * x + offset, with a revision for traceability.
13 typedef struct LinearCalibration {
14 | float slope;
15 | float offset;
16 | uint16_t revision;
17 | bool valid; | // false => publish raw with HEALTH_UNCALIBRATED
18 } LinearCalibration;

19
20 float linearApply(const LinearCalibration* c, float x); linearApply

21
22 // True if slope and offset are finite numbers. Every fit maker below refuses 23 // non-finite input or output; config_blob refuses a stored non-finite fit. 24 bool linearCalibrationFinite(const LinearCalibration* c); linearCalibrationFinite

25

LinearCalibration stores slope, offset, revision and valid. linearApply evaluates slope*x+offset. valid is an acceptance tag supplied by fit creation and configuration validation; the arithmetic helper does not infer it from how reasonable a result looks.

CHAPTER 11 / BUILD THE LIGHT MEASUREMENT

### Describe a fitted line and its validity / continued

src/domain/calibration.h / lines 26-34
26 // Two-point fit through (x1, y1) and (x2, y2), e.g. module mV read in two pH
27 // buffers. false (and *out left invalid) if the x values are too close.
28 bool linearFromTwoPoints(float x1, float y1, float x2, float y2, uint16_t revision, linearFromTwoPoints
29 | LinearCalibration* out);

30
31 // Sort `samples` in place, drop `trim` values at each end and return the mean
32 // of the rest (spike-rejecting filter, pH-4502C tutorial: 10 samples, mean of 33 // the middle 6). Returns 0 if n <= 2 * trim.
34 float trimmedMeanU32(uint32_t* samples, uint8_t n, uint8_t trim); trimmedMeanU32

The divider helper recovers the upstream module voltage. Its coefficients are resistor values,

### not calibration points. Keep electrical scaling and physical calibration as separate

transformations so you can test each with known numbers.

CHAPTER 11 / BUILD THE LIGHT MEASUREMENT

# Distinguish a reference fit from a compiled default

src/domain/calibration.h / lines 35-53

35
36 // ---- On-device calibration (WP8, Calibration page) ----------------------------37 // Which stored fits the user made on the device (ConfigBlob.calOverridden).
38 // A fit without its bit is the compiled default and is refreshed at boot.
39 #define CAL_BIT_PH 0x01u
40 #define CAL_BIT_TDS 0x02u
41 #define CAL_BIT_LIGHT 0x04u
42 #define CAL_BITS_ALL 0x07u

43
44 // One-point gain through the origin, y = (y1 / x1) * x (TDS K-factor, light
45 // lux per mV). false if x1 or y1 is not positive or the gain is outside
46 // [minGain, maxGain].
47 bool linearGainFromPoint(float x1, float y1, float minGain, float maxGain, uint16_t linearGainFromPoint
> | revision,
48 | LinearCalibration* out);

49
50 // Two-point pH buffer fit, rejected unless |slope| (pH per module mV) is in
51 // [minAbsSlope, maxAbsSlope] and the buffers are at least 1 pH apart.
52 bool phFitFromBuffers(float mv1, float ph1, float mv2, float ph2, float minAbsSlope, phFitFromBuffers
> | float maxAbsSlope,
53 | uint16_t revision, LinearCalibration* out);

### The CAL_BIT constants record which sensor fits came from a user calibration. They let

configuration refresh compiled defaults while preserving a deliberately fitted replacement. The bit mask is history about the fit's origin, not its mathematical formula.

The one-point helper constrains a gain through zero. The pH helper fits two points and checks both buffer separation and slope magnitude. Those restrictions embody chosen models; do not replace a two-point pH fit with a gain-only light model because both use LinearCalibration storage.

CHAPTER 11 / BUILD THE LIGHT MEASUREMENT

# Recover a voltage, then evaluate a line

### We will read every helper with numerical inputs. None of these functions touches a peripheral, which makes the same bodies

testable on a PC.

### The light driver calls the filter and line evaluation; later calibration

commands call the fit makers.

src/domain/calibration.c / lines 1-14
1 #include "domain/calibration.h"

2
3 #include <math.h>

4
5 float dividerRecoverMv(float adcMv, uint32_t rTopOhm, dividerRecoverMv
> | uint32_t rBottomOhm) {
6 | if (rBottomOhm == 0) return 0.0f;
7 | return adcMv * (float)(rTopOhm + rBottomOhm) /
> | (float)rBottomOhm;

8 }

9
10 float linearApply(const LinearCalibration* c, float x) { linearApply 11 return c->slope * x + c->offset;

12 }

13
14 bool linearCalibrationFinite(const LinearCalibration* c) { linearCalibrationFinite > return isfinite(c->slope) && isfinite(c->offset); }

### dividerRecoverMv rejects a zero lower resistor before division. With 10kOhm above and 15kOhm below, an ADC input of 1800mV corresponds to 3000mV at the module. linearApply then uses the

supplied line without changing its record.

### linearCalibrationFinite checks slope and offset with isfinite. NaN and infinity are floating-point representations, not usable calibration coefficients. A nonzero or valid-looking flag alone does not make

them acceptable.

COMMON PITFALL

The helper returns zero for an invalid divider
denominator; callers still need to establish whether
zero is a meaningful result or a rejected configuration.

CHAPTER 11 / BUILD THE LIGHT MEASUREMENT

# Create a line only when two points determine one

src/domain/calibration.c / lines 15-32

16 bool linearFromTwoPoints(float x1, float y1, float x2, float y2, uint16_t revision, linearFromTwoPoints LinearCalibration* out) {
out->slope = 1.0f;
out->offset = 0.0f;
out->revision = revision;
out->valid = false;
if (!isfinite(x1) || !isfinite(y1) || !isfinite(x2) || !isfinite(y2)) return false; const float dx = x2 - x1;
if (!(dx <= -1e-3f || dx >= 1e-3f)) return false;
const float slope = (y2 - y1) / dx;
const float offset = y1 - slope * x1;
if (!isfinite(slope) || !isfinite(offset)) return false; out->slope = slope;
out->offset = offset;
out->valid = true;
return true;

32 }

The output begins with an invalid, neutral-looking line. Each early return leaves valid false. The finite checks reject malformed numeric input, and the dx test rejects coincident or nearly coincident voltages before dividing.

Once slope and offset are finite, the function commits all fields and sets valid true. For (3000,7) and (3500,4), it produces -0.006 and 25. Calling code must check the boolean; merely seeing slope=1 after failure is not a successful identity calibration.

CHAPTER 11 / BUILD THE LIGHT MEASUREMENT

# Watch insertion sort change the array

src/domain/calibration.c / lines 33-48

33
34 float trimmedMeanU32(uint32_t* samples, uint8_t n, uint8_t trimmedMeanU32
> | trim) {
35 | if (n <= 2u * trim) return 0.0f;
36 | for (uint8_t i = 1; i < n; ++i) { | // insertion sort: n is
> | ~10
37 | const uint32_t v = samples[i];
38 | uint8_t j = i;
39 | while (j > 0 && samples[j - 1] > v) {
40 | samples[j] = samples[j - 1];
41 | --j;
42 | }
43 | samples[j] = v;
44 | }
45 | uint64_t sum = 0;
46 | for (uint8_t i = trim; i < n - trim; ++i) sum +=
> | samples[i];
47 | return (float)sum / (float)(n - 2u * trim);

48 }

### For each new element, v remembers the value while larger earlier entries move right. j stops at the beginning or at a value that should remain before v. The assignment after the while loop completes that

insertion.

### The sum excludes trim items from each end and uses uint64_t for

accumulation. For ten samples and trim two, six items remain.

### Sorting edits the input buffer; copy the samples first if another

consumer needs their original temporal order.

COMMON PITFALL

This filter rejects isolated extremes. It cannot correct a persistent offset shared by every sample.

CHAPTER 11 / BUILD THE LIGHT MEASUREMENT

# Build a bounded gain through zero

src/domain/calibration.c / lines 49-66

49
50 static void invalidFit(uint16_t revision, LinearCalibration* out) { invalidFit
51 | out->slope = 1.0f;
52 | out->offset = 0.0f;
53 | out->revision = revision;
54 | out->valid = false;

55 }

56
57 bool linearGainFromPoint(float x1, float y1, float minGain, float maxGain, uint16_t linearGainFromPoint
> | revision,
58 | LinearCalibration* out) {
59 | invalidFit(revision, out); invalidFit
60 | if (!(x1 > 0.0f) || !(y1 > 0.0f) || !isfinite(x1) || !isfinite(y1)) return false;
61 | const float gain = y1 / x1;
62 | if (!isfinite(gain) || !(gain >= minGain && gain <= maxGain)) return false;
63 | out->slope = gain;
64 | out->valid = true;
65 | return true;

66 }

invalidFit establishes the same failure state for all later paths. The helper requires positive finite x and y, computes y/x, and checks the agreed gain range before marking the result valid.

### A 500ppm reference over a nominal 400ppm prediction gives 1.25. The offset stays zero

because this helper's model is a gain, not an arbitrary line. A single reference does not tell you an independent offset.

CHAPTER 11 / BUILD THE LIGHT MEASUREMENT

# Add pH-specific plausibility to a general line

src/domain/calibration.c / lines 67-79

67
68 bool phFitFromBuffers(float mv1, float ph1, float mv2, float ph2, float minAbsSlope, phFitFromBuffers
> | float maxAbsSlope,
69 | uint16_t revision, LinearCalibration* out) {
70 | invalidFit(revision, out); invalidFit
71 | const float dph = ph2 - ph1;
72 | if (!(dph <= -1.0f || dph >= 1.0f)) return false; | // also NaN
73 | LinearCalibration fit;
74 | if (!linearFromTwoPoints(mv1, ph1, mv2, ph2, revision, &fit)) return false; linearFromTwoPoints
75 | const float mag = fit.slope < 0.0f ? -fit.slope : fit.slope;
76 | if (!(mag >= minAbsSlope && mag <= maxAbsSlope)) return false;
77 | *out = fit;
78 | return true;

79 }

phFitFromBuffers first requires the reference pH values to differ by at least one unit. It delegates the algebra to linearFromTwoPoints, then checks the absolute slope against policy bounds. Negative slopes are allowed because the electrical response can run opposite to pH.

Only the final assignment copies the accepted fit into out. The helper does not collect a new sensor sample or store anything in flash. Configuration later supplies captured points and decides whether to persist the result.

CHAPTER 11 / BUILD THE LIGHT MEASUREMENT

# Read the light-specific physical assumptions

This is the first full concrete driver object. Match its members to the actions you have already traced in the lesson.

### The configuration points to an already configured ADC channel, while the driver owns its

window and result.

src/drivers/light.h / lines 1-28
1 // dfr0026_light driver. Work package WP3 (Stage 2). Architecture §3, §14. 2 // Source: DFR0026.PDF (DFRobot Analog Ambient Light Sensor V2, pages 1-4). 3 //
4 // Retained 3.3 V rail. S -> 10 kOhm series -> ADC1 pin (GPIO1), 1 uF to GND 5 // (tau ~10 ms). No divider: pin mV = module output mV. More light, higher
6 // voltage. Datasheet range 1-6000 lux, but the output has no lux unit: the FAQ 7 // requires a reference-meter mapping (D13). Without one every result is mV. 8 // With an on-device fit (Calibration page: one reference-meter reading, gain 9 // through zero) the value is lux. raw stays pin mV either way, and the lamp 10 // thresholds use it (lamp_control), so calibrating never moves the lamp.

11 //
12 // Filter: LIGHT_SAMPLES conversions spaced LIGHT_SAMPLE_SPACING_MS apart,
13 // sorted, mean of the middle LIGHT_SAMPLES - 2*LIGHT_TRIM. Mains lamps flicker 14 // at 100 Hz (120 Hz on 60 Hz grids) and the RC only cuts 100 Hz to ~16 %, so 15 // the spacing is deliberately NOT a multiple of 10 ms: 11 ms steps the flicker 16 // phase by 1 ms per tap and the window covers the whole period. The window is 17 // spread over successive poll() calls, never taken as a burst (§9): each tap is 18 // due LIGHT_SAMPLE_SPACING_MS after the previous actual sample.

19 //
20 // Results (poll() returns READY for all; raw = filtered pin mV):
21 // | calibration.valid -> value = lux, UNIT_LUX, HEALTH_OK
22 // | otherwise | -> value = module mV, UNIT_MILLIVOLT, HEALTH_UNCALIBRATED
23 // | any sample clipped -> kQualitySaturated, value kept as a lower bound
24 // | | (bright light on a 3.3 V supply can exceed the S3's
25 // | | ~3.1 V range; this is not a fault)
26 // | ADC error | -> HEALTH_FAULT
27 // No no-signal threshold: ~0 mV is real darkness. With 1 uF on the pin and no 28 // pull-down, an unplugged S line holds its last level while the capacitor leaks;

The introductory contract explains the pin RC network, the absence of a justified lux mapping, and the decision to preserve raw millivolts for control. These comments describe why the same numeric field may use MILLIVOLT before calibration and LUX afterward.

src/drivers/light.h / lines 29-30
29 // the driver cannot tell that apart. Characterise it at bring-up.

30 //

The output cannot always distinguish unplugged signal from real darkness. That is a property of

### the electrical observations available to the code. Treat it as a diagnostic boundary when

reviewing the later health branches, rather than adding a zero-voltage rule without evidence.

CHAPTER 11 / BUILD THE LIGHT MEASUREMENT

# Connect elapsed filtering time to short calls

src/drivers/light.h / lines 31-55
31 // Worst-case blocking (one ADC conversion C, well under 1 ms):
32 // | init() | 1 C | (throwaway conversion, checks the channel)
33 // | start() | 1 C | (first sample of the window)
34 // | poll() | 1 C | Pending until the window is full (>= 99 ms)
35 // | others | none

36 //
37 // Implements the SensorDriver contract in drivers/sensor_driver.h. 38 #pragma once
39 #include "drivers/sensor_driver.h"
40 #include "hal/adc_channel.h"
41 #include "domain/calibration.h"

42
43 #define LIGHT_SAMPLES 10
44 #define LIGHT_TRIM 2
45 #define LIGHT_SAMPLE_SPACING_MS 11

46
47 typedef struct LightConfig {
48 | AdcChannel* adc; | // already begun on BOARD_PIN_LIGHT_ADC
49 | LinearCalibration calibration; | // x = pin mV, y = lux; invalid = publish mV
50 } LightConfig;

51
52 // Members after `base` are private to light.c.
53 typedef struct LightDriver {
54 | SensorDriver base; | // must stay first
55 | LightConfig config_;

The filter uses ten taps, trims two from each end and spaces actual taps by 11ms. start takes

### one conversion; each eligible poll takes at most one more. A minimum 99ms window can

therefore coexist with a much shorter per-call execution budget.

The header promises that partial work can be cancelled. A schedule deadline may end a window before all samples arrive; the service must not pretend that a full-window result was obtained.

CHAPTER 11 / BUILD THE LIGHT MEASUREMENT

# Identify which fields survive the next return

src/drivers/light.h / lines 56-71
56 | bool initialised_;
57 | bool busy_;
58 | bool saturated_;
59 | uint8_t count_;
60 | uint32_t samples_[LIGHT_SAMPLES]; | // pin mV
61 | MonoMs startMs_;
62 | MonoMs lastSampleMs_; | // next tap is due LIGHT_SAMPLE_SPACING_MS after this
63 | Reading result_;
64 } LightDriver;

65
66 // Constructor. Use &driver.base wherever a SensorDriver* is expected.
67 void lightDriverConstruct(LightDriver* self, const LightConfig* config); lightDriverConstruct

68
69 // New lux fit from the applied configuration (on-device calibration, WP8).
70 // Called by the acquisition owner between windows; applies from the next one.
71 void lightDriverSetCalibration(LightDriver* self, const LinearCalibration* calibration); lightDriverSetCalibration

base must remain first for generic dispatch. config_ holds an ADC pointer and a calibration

### copy. count_, samples_, startMs_ and lastSampleMs_ retain the in-progress window. result_

retains the latest completed outcome.

You can now predict construction: install the operations table, copy configuration, clear state, and reset result identity. Reinitialising the hardware should not erase the historical meaning of every earlier result unless the contract explicitly says so.

CHAPTER 11 / BUILD THE LIGHT MEASUREMENT

# Confirm the channel before accepting work

### Follow one complete window through the real implementation. Keep the ten sample times and one retained Reading separate in your

mind.

### Acquisition will call these bodies through SensorDriverOps; the code

here does not know a queue or relay.

COMMON PITFALL

A successful init does not establish a lux calibration or prove that the signal
cable is connected.

CHAPTER 11 / BUILD THE LIGHT MEASUREMENT

### Confirm the channel before accepting work / continued

src/drivers/light.c / lines 1-27
1 #include "drivers/light.h"

2
3 #include <math.h>

4
5 #include "domain/calibration.h"

6
7 static inline LightDriver* asLight(SensorDriver* d) { return (LightDriver*)d; } asLight

8
9 static PollResult finish(LightDriver* self, MonoMs now); finish

10
11 static SensorId lightId(const SensorDriver* d) { (void)d; return SENSOR_LIGHT; } lightId
12 static const char* lightName(const SensorDriver* d) { (void)d; return "dfr0026_light"; } lightName 13 static uint8_t lightMetricCount(const SensorDriver* d) { (void)d; return 1; } lightMetricCount

14
15 static DriverStatus lightInit(SensorDriver* d) { lightInit
16 | LightDriver* self = asLight(d); asLight
17 | self->initialised_ = false;
18 | self->busy_ = false;
19 | if (self->config_.adc == 0) return DRIVER_FAULT;
20 | // Throwaway conversion: fails if the channel was never begun on an ADC1 pin,
21 | // and keeps any one-time ADC characterisation cost out of poll().
22 | uint32_t mv = 0;
23 | bool saturated = false;
24 | if (!adcChannelReadMilliVolts(self->config_.adc, &mv, &saturated)) return adcChannelReadMilliVolts
> | DRIVER_FAULT;
25 | self->initialised_ = true;
26 | return DRIVER_OK;

27 }

The cast helper recovers LightDriver from its first-member base pointer. Identity helpers supply the physical sensor, diagnostic name and one-metric count. They return constants and do not inspect hardware.

lightInit clears active state, rejects a missing ADC pointer and performs one throwaway voltage conversion. That moves any one-time setup cost out of normal poll steps. Only the successful path sets initialised_ true.

CHAPTER 11 / BUILD THE LIGHT MEASUREMENT

# Take exactly one tap

src/drivers/light.c / lines 28-38

28
29 // Take one sample of the window at `now`. false on an ADC error. 30 static bool sample(LightDriver* self, MonoMs now) { sample
31 | uint32_t mv = 0;
32 | bool saturated = false;
33 | if (!adcChannelReadMilliVolts(self->config_.adc, &mv, &saturated)) return false; adcChannelReadMilliVolts
34 | self->samples_[self->count_++] = mv;
35 | self->lastSampleMs_ = now;
36 | self->saturated_ = self->saturated_ || saturated;
37 | return true;

38 }

### sample obtains one voltage, appends it at count_, records the actual sample time and

accumulates saturation with logical OR. Once any tap saturates, saturated_ remains true for the rest of that window.

The post-increment uses the old count as the index, then advances it. The caller's state machine must keep count below the array capacity. This helper does not check the index independently; its safe use depends on the start/poll logic.

CHAPTER 11 / BUILD THE LIGHT MEASUREMENT

# Start a new window with a real first sample

src/drivers/light.c / lines 39-52

40 static DriverStatus lightStart(SensorDriver* d, MonoMs now) { lightStart LightDriver* self = asLight(d); asLight
if (!self->initialised_) return DRIVER_FAULT; self->count_ = 0;
self->saturated_ = false;
self->startMs_ = now;
if (!sample(self, now)) { sample
self->initialised_ = false; return DRIVER_FAULT;

}
self->busy_ = true;
return DRIVER_OK;

52 }

The function rejects uninitialised state, resets the count and saturation tag, remembers now, and immediately obtains the first tap. Failure clears initialisation so the caller cannot keep starting as if the channel were healthy.

busy_ is set only after that first tap succeeds. start therefore returns OK with a real partial window, not merely an intention to sample later. The next poll time can be derived from the recorded actual tap time.

CHAPTER 11 / BUILD THE LIGHT MEASUREMENT

# Let timing decide whether another tap is useful

src/drivers/light.c / lines 53-79

54 static PollResult lightPoll(SensorDriver* d, MonoMs now) { lightPoll LightDriver* self = asLight(d); asLight
PollResult r = {DRIVER_FAULT, now};
if (!self->busy_) return r;

// Spacing is measured from the previous actual sample, never from the window // start: after a late poll, catching up would compress the filter taps. const MonoMs due = self->lastSampleMs_ + LIGHT_SAMPLE_SPACING_MS;
if (now < due) {
r.status = DRIVER_PENDING;
r.nextPollMs = due;
return r;

}
if (!sample(self, now)) { sample
self->busy_ = false;
self->initialised_ = false; self->result_.health = HEALTH_FAULT; self->result_.intervalStartMs = self->startMs_; self->result_.intervalEndMs = now;
return r;

}
if (self->count_ < LIGHT_SAMPLES) {
r.status = DRIVER_PENDING;
r.nextPollMs = self->lastSampleMs_ + LIGHT_SAMPLE_SPACING_MS; return r;

}

A poll without active work returns the initial FAULT outcome. Otherwise due equals the last actual sample time plus the spacing. Before due, the function returns PENDING without taking another conversion.

src/drivers/light.c / lines 80-81
return finish(self, now); finish

81 }

When a tap succeeds, count decides whether the window is complete. If not, another PENDING return supplies the next useful time. If the ADC helper fails, the function ends the window and records a new fault interval. This branch is different from simply receiving a plausible low light voltage.

CHAPTER 11 / BUILD THE LIGHT MEASUREMENT

# Filter the window and retain its electrical scale

src/drivers/light.c / lines 82-105

83 static PollResult finish(LightDriver* self, MonoMs now) { finish self->busy_ = false;
const float pinMv = trimmedMeanU32(self->samples_, LIGHT_SAMPLES, LIGHT_TRIM); trimmedMeanU32

Reading* r = &self->result_; r->intervalStartMs = self->startMs_; r->intervalEndMs = now;
r->hasRaw = true;
r->raw = (int32_t)(pinMv + 0.5f);
// Clipped = brighter than the ADC can show: a lower bound, not a fault. r->qualityFlags = self->saturated_ ? kQualitySaturated : kQualityNone; r->calibrationRevision = self->config_.calibration.revision;
if (self->config_.calibration.valid) {
r->unit = UNIT_LUX;
r->value = linearApply(&self->config_.calibration, pinMv); linearApply
if (r->value < 0.0f) r->value = 0.0f; r->health = HEALTH_OK;
100 | if (!isfinite(r->value)) { | // a broken fit is a fault, never a value
| r->health = HEALTH_FAULT;
PollResult bad = {DRIVER_READY, now};
| return bad;
| }
| } else {

### finish clears busy_ and computes the trimmed pin voltage. It stamps the interval, retains

rounded raw millivolts and records the saturation and calibration revision. These are the facts shared by both calibrated and uncalibrated outcomes.

With a valid fit, value changes to lux and negative predicted lux is clamped to zero. The finite check still rejects a broken coefficient path. HEALTH_OK is meaningful only after that check; assignment order inside this local result does not mean a consumer saw the earlier intermediate state.

CHAPTER 11 / BUILD THE LIGHT MEASUREMENT

# Keep an uncalibrated value honest

src/drivers/light.c / lines 106-114
106 | r->unit = UNIT_MILLIVOLT;
107 | r->value = pinMv; | // no divider: pin mV = module mV
108 | r->health = HEALTH_UNCALIBRATED; | // no lux mapping until a reference meter (D13)
109 | }
110 | r->lastGoodMs = now; | // last usable result (OK or UNCALIBRATED)
111 | ++r->sequence;
112 | PollResult pr = {DRIVER_READY, now};
113 | return pr;

114 }

### Without a valid mapping, the result stays in millivolts and is labelled UNCALIBRATED. The driver nevertheless updates lastGoodMs and its usable-sample sequence because the raw

observation can be useful to the lamp's specific raw-mV policy.

READY reports that the outcome is available. It does not erase the distinction between OK lux

### and UNCALIBRATED mV. Ordinary numeric alarm rules use their own acceptance policy and do

not inherit the lamp exception automatically.

CHAPTER 11 / BUILD THE LIGHT MEASUREMENT

# Copy results and abandon partial windows

src/drivers/light.c / lines 115-130

115
116 static uint8_t lightReadResult(SensorDriver* d, Reading* out, uint8_t maxOut) { lightReadResult
117 | if (maxOut < 1) return 0;
118 | out[0] = asLight(d)->result_; asLight
119 | return 1;

120 }

121
122 static void lightCancel(SensorDriver* d) { lightCancel
123 | LightDriver* self = asLight(d); asLight
124 | self->busy_ = false;
125 | self->count_ = 0;

126 }

127
128 // Retained rail, and the ADC pin is a high-impedance input behind 10 kOhm: 129 // nothing to drive. Drop any partial window.
130 static void lightPreparePowerOff(SensorDriver* d) { lightCancel(d); } lightPreparePowerOff | lightCancel

readResult checks capacity and copies one retained record. cancel drops busy_ and count_ so a partial window cannot continue. preparePowerOff delegates to that cancellation because this retained-rail analog input has no output line that needs to be driven low.

These functions do not publish a Snapshot. The owner first collects the copy and later adds service metadata. Keeping those responsibilities separate lets this same driver run in the small bring-up task.

CHAPTER 11 / BUILD THE LIGHT MEASUREMENT

# Install the table once, then update fits between windows

src/drivers/light.c / lines 131-156

131
132 static const SensorDriverOps kLightOps = {
133 | .id = lightId,
134 | .name = lightName,
135 | .metricCount = lightMetricCount,
136 | .init = lightInit,
137 | .start = lightStart,
138 | .poll = lightPoll,
139 | .readResult = lightReadResult,
140 | .cancel = lightCancel,
141 | .preparePowerOff = lightPreparePowerOff,

142 };

143
144 void lightDriverConstruct(LightDriver* self, const LightConfig* config) { lightDriverConstruct
145 | self->base.ops = &kLightOps;
146 | self->config_ = *config;
147 | self->initialised_ = false;
148 | self->busy_ = false;
149 | self->saturated_ = false;
150 | self->count_ = 0;
151 | self->startMs_ = 0;
152 | self->lastSampleMs_ = 0;
153 | readingReset(&self->result_, SENSOR_LIGHT, METRIC_LIGHT_LEVEL, UNIT_MILLIVOLT); readingReset
154 | self->result_.calibrationRevision = config->calibration.revision;

155 }

156

### kLightOps names each concrete function for the generic lifecycle. The constructor points

base.ops to that constant table, copies configuration and establishes predictable initial state and Reading identity.

src/drivers/light.c / lines 157-159
157 void lightDriverSetCalibration(LightDriver* self, const LinearCalibration* calibration) lightDriverSetCalibration
> | {
158 | self->config_.calibration = *calibration;

159 }

SetCalibration copies a complete fit. It does not take its own lock or cancel a current window; the acquisition owner is responsible for calling it at an appropriate boundary. This is an ownership precondition, not a hidden property of the struct assignment.

CHAPTER 11 / BUILD THE LIGHT MEASUREMENT

# Carry a driver and a period into one task

Before looking at the light test entry point, read the reusable task that runs one production driver. It is a small bridge from lessons to a working board experiment.

### The harness deliberately omits multi-sensor ownership handover and output policy so one

device can be observed in isolation.

test/bringup/bringup_harness.h / lines 1-27
1 // Minimal RTOS bring-up harness shared by every test/bringup/<sensor>_main.c. 2 // Architecture §17 stage 1-3, requirement R9.
3 //
4 // Runs ONE production driver from a task pinned like AcquisitionNormal
5 // (core 1, priority 4), on an absolute period (vTaskDelayUntil). Each period: 6 // init (retried until OK) -> start -> poll until READY/error -> readResult. 7 // Prints every reading with its health and the start->ready duration so the 8 // conversion budget in app_config.h can be checked against reality.
9 #pragma once
10 #include <Arduino.h>
11 #include <stdio.h>

12
13 #include "app_config.h"
14 #include "domain/reading.h"
15 #include "drivers/sensor_driver.h" 16 #include "hal/arduino_entry.h"
17 #include "hal/clock.h"

18
19 typedef struct BringupContext {
20 | SensorDriver* driver;
21 | uint32_t periodMs;
22 | // Optional, called from the harness task after every READY result (so it
23 | // may use driver getters without breaking single bus ownership). NULL = none.
24 | void (*afterResult)(SensorDriver* driver);
25 } BringupContext;

26
27 // One compact line per measurement, e.g.

BringupContext contains the generic driver pointer, requested period and an optional function pointer called after a READY result. The callback executes in the same harness task, so it can inspect driver-owned state without introducing another concurrent bus user.

A null callback means no extra action. Do not interpret it as a missing driver function: the normal lifecycle still runs through ops.

CHAPTER 11 / BUILD THE LIGHT MEASUREMENT

# Print a value only under a declared health policy

test/bringup/bringup_harness.h / lines 28-47
28 // | [bme280] 27.98 degC | 54.20 %RH | 101602.04 Pa | (11 ms)
29 // An UNCALIBRATED reading shows its raw-unit value with "(uncal)", e.g.
30 // | [ph4502c] 2498.31 mV (uncal) | (271 ms)
31 // Any other non-OK reading shows its metric and health instead of a value.
32 static inline void bringupPrintResult(const char* name, const Reading* r, uint8_t n, bringupPrintResult
33 | uint32_t elapsedMs) {
34 | printf("[%s] ", name);
35 | for (uint8_t i = 0; i < n; ++i) {
36 | if (i > 0) printf(" | ");
37 | if (r[i].health == HEALTH_OK) {
38 | printf("%.2f %s", (double)r[i].value, unitName(r[i].unit)); unitName
39 | } else if (r[i].health == HEALTH_UNCALIBRATED) {
40 | printf("%.2f %s (uncal)", (double)r[i].value, unitName(r[i].unit)); unitName
41 | } else {
42 | printf("%s=%s", metricName(r[i].metric), healthName(r[i].health)); metricName | healthName
43 | if (r[i].hasRaw) printf(" (raw %ld)", (long)r[i].raw);
44 | }
45 | }
46 | printf(" | (%lu ms)\n", (unsigned long)elapsedMs);

47 }

The formatter walks the returned records. OK values print their units; UNCALIBRATED values print with an explicit tag; other health states print the metric and verdict, optionally raw data.

The casts match variadic printf expectations. Floating arguments are passed as double, and the explicit long casts match integer formats. This is a diagnostic interface, not a new calibration step. A formatted number retains the meaning of the record supplied to it.

CHAPTER 11 / BUILD THE LIGHT MEASUREMENT

# Release one observation on an absolute period

test/bringup/bringup_harness.h / lines 48-72

48
49 static inline void bringupTask(void* arg) { bringupTask
50 | BringupContext* ctx = (BringupContext*)arg;
51 | SensorDriver* drv = ctx->driver;
52 | bool initialised = false;
53 | TickType_t lastWake = xTaskGetTickCount();

54
55 | for (;;) {
56 | vTaskDelayUntil(&lastWake, pdMS_TO_TICKS(ctx->periodMs)); vTaskDelayUntil

57
58 | if (!initialised) {
59 | DriverStatus st = sensorDriverInit(drv); sensorDriverInit
60 | printf("[%s] init -> %s\n", sensorDriverName(drv), driverStatusName(st)); sensorDriverName | driverStatusName
61 | if (st != DRIVER_OK) continue;
62 | initialised = true;
63 | }

64
65 | const MonoMs t0 = monoNowMs(); monoNowMs
66 | DriverStatus st = sensorDriverStart(drv, t0); sensorDriverStart
67 | if (st != DRIVER_OK) {
68 | printf("[%s] start -> %s\n", sensorDriverName(drv), driverStatusName(st)); sensorDriverName | driverStatusName
69 | if (st != DRIVER_PENDING) initialised = false;
70 | continue;
71 | }

72

The task recovers its context pointer, remembers the tick grid and waits until the next release. It retries init on later periods until accepted. It does not spin in an unlimited inner init loop.

test/bringup/bringup_harness.h / lines 73-76
73 | PollResult pr = sensorDriverPoll(drv, monoNowMs()); sensorDriverPoll | monoNowMs
74 | while (pr.status == DRIVER_PENDING) {
75 | const MonoMs now = monoNowMs(); monoNowMs
76 | if (now - t0 >= ctx->periodMs) { | // harness-level guard, not the driver budget

After init, t0 captures the start time. A rejected start prints its status and usually requires reinitialisation. The special PENDING handling preserves the lifecycle convention that some already-busy conditions should not cause immediate destructive reconfiguration.

CHAPTER 11 / BUILD THE LIGHT MEASUREMENT

# Poll with a task-level guard

test/bringup/bringup_harness.h / lines 77-99
sensorDriverCancel(drv); sensorDriverCancel
pr.status = DRIVER_TIMEOUT; break;

}
uint32_t waitMs = 1;
if (pr.nextPollMs > now) waitMs = (uint32_t)(pr.nextPollMs - now); TickType_t ticks = pdMS_TO_TICKS(waitMs);
vTaskDelay(ticks > 0 ? ticks : 1); vTaskDelay
85 | pr = sensorDriverPoll(drv, monoNowMs()); sensorDriverPoll | monoNowMs

}

const uint32_t elapsedMs = (uint32_t)(monoNowMs() - t0); monoNowMs
if (pr.status != DRIVER_READY) {
printf("[%s] poll -> %s after %lu ms\n", sensorDriverName(drv), sensorDriverName
| driverStatusName(pr.status), (unsigned long)elapsedMs); driverStatusName
if (pr.status == DRIVER_NOT_IMPLEMENTED || pr.status == DRIVER_NOT_PRESENT) {
| initialised = false;
| }
| continue;

}

| Reading out[4];
const uint8_t n = sensorDriverReadResult(drv, out, 4); sensorDriverReadResult

The loop checks the driver's next useful time, converts the interval to ticks and forces at least one tick when conversion would yield zero. That avoids a high-priority busy loop over a near deadline.

The harness cancels a pending operation after one configured period. This is its own outer guard, not a replacement for the driver's shorter protocol timeout. Error status is printed and the next period becomes another bounded opportunity to make progress.

CHAPTER 11 / BUILD THE LIGHT MEASUREMENT

# Collect a copy before calling the optional observer

test/bringup/bringup_harness.h / lines 100-110
100 | bringupPrintResult(sensorDriverName(drv), out, n, bringupPrintResult sensorDriverName
> | elapsedMs);
101 | if (ctx->afterResult != NULL) ctx->afterResult(drv);
102 | }

103 }

104
105 // Start the harness task with the AcquisitionNormal > placement from §6.
106 static inline void bringupStart(BringupContext* ctx) { bringupStart
107 | const TaskSpec* spec =
> | cfgTaskSpec(TASK_ID_ACQUISITION_NORMAL); cfgTaskSpec
108 | xTaskCreatePinnedToCore(bringupTask, "bringup",
> | spec->stackBytes, ctx,
109 | spec->priority, NULL, spec->core);

110 }

A READY result is copied into a four-record local array, then printed.

### The callback runs afterward, when the driver has a completed outcome rather than a half-written one. The array is safe here

because printing finishes before its stack lifetime ends.

### bringupStart uses acquisition's placement parameters to create the test task. Notice that this test helper does not check the creation return value. If no test output appears after setup, creation failure is one of the paths to investigate; the helper does not turn failure into a

usable task.

COMMON PITFALL

A bring-up helper is
executable code to review, not a guarantee that every failure has already been
reported well.

CHAPTER 11 / BUILD THE LIGHT MEASUREMENT

# Define one complete test object graph

The light experiment now becomes a small setup file using the production driver and harness. Read it with a real observation plan in mind.

The test replaces production main for its build environment; it does not run alongside it.

test/bringup/light_main.c / lines 1-26
1 // Bring-up entry point for light (WP3). pio run -e test_light -t upload -t monitor 2 // Retained 3.3 V rail. S -> 10 kOhm -> GPIO1 (ADC1_CH0), 1 uF to GND.
3 // Replaces src/main.c in this env only; links the production driver.
4 //
5 // Every line prints module mV with "(uncal)": there is no lux mapping (D13). 6 // Procedure (README "DFR0026 light bring-up"), note the mV for each step:
7 // | 1. Dark: cover the sensor completely.
8 // | 2. Room light, sensor uncovered.
9 // | 3. Phone torch close to the lens: find where it clips (~3050 mV at the pin;
10 // | the reading carries kQualitySaturated).
11 // | 4. Under LED or fluorescent light: note the spread between successive lines
12 // | (flicker rejection of the 11 ms tap spacing).
13 // | 5. Unplug S: watch how the reading decays (the 1 uF holds the last level).
14 #include <Arduino.h>
15 #include <stdio.h>

16
17 #include "app_config.h"
18 #include "board_profile.h" 19 #include "bringup_harness.h" 20 #include "hal/adc_channel.h"
21 #include "drivers/light.h"

22
23 static AdcChannel s_adc = ADC_CHANNEL_INIT;
24 static LightConfig s_config = {&s_adc};
25 static LightDriver s_driver;
26 static BringupContext s_ctx = {&s_driver.base, CFG_FRAME_PERIOD_MS, NULL};

### The source procedure asks you to compare darkness, room light, bright illumination and a

disconnected signal. Those cases test range, clipping, flicker and diagnostic limits.

s_config points to the static ADC object. s_driver owns its own state. s_ctx points to the driver's base and supplies the ordinary frame period. The objects persist after setup returns, so the created task does not inherit dangling addresses.

CHAPTER 11 / BUILD THE LIGHT MEASUREMENT

Construct first, configure the channel,

# then create work

test/bringup/light_main.c / lines 27-40

27
28 void setup(void) { setup
29 | lightDriverConstruct(&s_driver, &s_config); lightDriverConstruct
30 | delay(200);
31 | printf("\n=== bring-up: %s ===\n", sensorDriverName(&s_driver.base)); sensorDriverName
32 | if (!adcChannelBegin(&s_adc, BOARD_PIN_LIGHT_ADC)) { adcChannelBegin
33 | printf("GPIO%d is not an ADC1 pin\n", (int)BOARD_PIN_LIGHT_ADC);
34 | }
35 | printf("%d taps, %d ms apart, trimmed mean; printing module mV (uncal)\n",
36 | LIGHT_SAMPLES, LIGHT_SAMPLE_SPACING_MS);
37 | bringupStart(&s_ctx); bringupStart

38 }

39
40 void loop(void) { vTaskDelay(portMAX_DELAY); } loop | vTaskDelay

setup constructs the driver, waits for console visibility, configures the ADC channel and prints the chosen filter settings before starting the harness. Constructor and ADC setup solve different prerequisites.

### loop blocks because the task owns repeated work. During this test, use the reported raw

millivolts to establish electrical behaviour; do not expect lux until a reference mapping exists. The uncalibrated label is the intended result of this setup, not evidence that the task failed.

CHAPTER 12 / READ THE BME280 OVER I2C

# Follow one addressed read on the bus

### I2C uses SDA for data and SCL for the clock. The ESP32 is the controller here; the sensor is the addressed target. They share the lines with other I2C devices. On this board, external pull-ups return

released lines high, while a participant can pull them low.

A transfer sends eight data bits and then an acknowledgement clock.

### The receiver pulling SDA low on that ninth clock is ACK; leaving it high is NACK. ACK means the addressed participant acknowledged those bytes. It does not mean that a physical conversion is finished or

the requested sensor model was verified.

Part of a BME280 identity read | Meaning
START, device 0x76, write direction | Select the chip to receive a register number.
Register number 0xD0 | Select its identity register.
Repeated START, device 0x76, read direction | Change to reading without ending the combined transaction first.
Read one byte, then end the read | Obtain the identity value for the driver to check.

### A repeated START begins another addressed phase without an intervening STOP. The HAL library generates these wire actions. The

driver supplies address 0x76, register 0xD0, destination and length.

### In this source, the accepted BME280 identity byte is 0x60. Choosing

the right address and reading the right identity are separate checks.

### Now read i2cBusReadRegs in the source section. Match each parameter to the table before following the timeout and got==len checks. The bus helper obtains bytes; the BME280 driver decides

whether their identity and meaning are acceptable.

Reference: NXP: I2C-bus specification UM10204, (https://www.nxp.com/docs/en/user-guide/UM10204.pdf) Bosch Sensortec: BME280 datasheet (https://www.bosch-sensortec.com/media/boschsensortec/downloads/datasheets/bst-bme280-ds002.pdf)

REMEMBER

A device address selects a participant. A register
number selects a location
inside that participant.

CHAPTER 12 / READ THE BME280 OVER I2C

# Ask for bytes as one transaction

### I2C is a shared bus addressed by device. On this board the BME280 normally uses address 0x76 and the SGP30 uses 0x58. A device address selects the chip; a register address selects a location inside

that chip. Those addresses are not interchangeable.

Original firmware - src/hal/i2c_bus.c, lines 34-40
bool i2cBusReadRegs(I2cBus* bus, uint8_t address, uint8_t reg, > uint8_t* buf, size_t len) {
if (!bus->started_ || buf == NULL || len == 0) return false; // Register write, repeated start, read: one bounded
> transaction.
size_t got = 0;
i2cWriteReadNonStop(kI2cPort, address, &reg, 1, buf, len,
> | I2C_BUS_TIMEOUT_MS, &got);
return got == len; | // a partial or failed read is dropped
}

### To read registers, the HAL sends the register number and performs a repeated-start read into buf. &reg supplies the address of the register-number byte. buf already points to the caller's destination array. len is the requested byte count, and &got lets the library

report how many bytes arrived.

### The success check requires got==len. If you wanted eight bytes and got five, you cannot decode the missing three as if they were fresh data. A partial transaction is rejected rather than padded with

whatever previously occupied the buffer.

### A transaction needs a bounded timeout. Without one, an absent or stuck device could hold the acquisition worker inside a call forever. A PENDING driver does not rescue you from an unbounded HAL call

hidden inside poll().

### The single acquisition owner serialises the bus use. It can start a conversion on one chip, use the bus for another chip while the first converts internally, then return for the first result. Sharing elapsed

conversion time is safe only when the device protocols permit it.

COMMON PITFALL

An ACK only shows that
something acknowledged
that address. Read the
device identity before
assuming the expected
chip is present.

REMEMBER

The bus moves bytes. The
driver knows what those
bytes mean.

CHAPTER 12 / READ THE BME280 OVER I2C

# Trigger once, then return at the right time

Original firmware - src/drivers/bme280.c, lines 128-139
static DriverStatus bme280Start(SensorDriver* d, MonoMs now) { Bme280Driver* self = asBme280(d);
if (!self->initialised_) return DRIVER_FAULT;
if (!i2cBusWriteReg(self->config_.bus, self->config_.address, kRegCtrlMeas, kCtrlMeasForcedX1)) {
self->initialised_ = false;
return DRIVER_FAULT;
}
self->startMs_ = now;
self->busy_ = true;
return DRIVER_OK;
}

bme280Start writes the forced-mode control register. If the write fails, it clears initialised_ and

### returns a fault. Otherwise it stores startMs_, marks busy_ and returns OK. There is no

conversion-length sleep in this start path.

Original firmware - src/drivers/bme280.c, lines 148-154
// The measuring bit may not be set yet right after the trigger, so the // first status check waits until the maximum conversion time has passed. if (now < startMs + kFirstPollMs) {
PollResult r = {DRIVER_PENDING, startMs + kFirstPollMs};
return r;
}

The first poll is deferred until startMs + 10ms in this implementation. The source explains why:

### immediately after the trigger, the measuring status may not yet show the conversion in

progress. Checking too early could misread not-started as already-finished.

CHAPTER 12 / READ THE BME280 OVER I2C

### Trigger once, then return at the right time / continued

After that delay, poll reads configuration and status. If the chip is still measuring and the 12ms

### conversion budget has expired, it reports TIMEOUT. Otherwise it returns PENDING with

another near-future poll time. If the device has lost its expected humidity setting, it reports failure so the caller can reinitialise it.

When ready, one burst obtains all eight data bytes. The driver uses the device's coherent burst

### behaviour instead of making unrelated reads that could cross an update boundary. init had

already read factory coefficients needed to turn raw values into physical units.

The 250ms application release period is much longer than this roughly 10ms conversion. Do not

### confuse sample period with conversion duration. The first controls how often you ask; the

second controls how long a particular request takes.

These 10ms and 12ms choices describe the archived driver and its selected settings, not every possible BME280 configuration.

Reference: Bosch Sensortec: BME280 datasheet (https://www.bosch-sensortec.com/media/boschsensortec/downloads/datasheets/bst-bme280-ds002.pdf)

CHAPTER 12 / READ THE BME280 OVER I2C

# Turn an integer scale into a physical value

### A device can report fractions without returning a C float. It can store an integer that counts small fixed steps. If a temperature routine reports 2450 in hundredths of a degree, its value is 2450/100 = 24.50 degrees Celsius. You must know that scale before interpreting

the integer.

Worked fixed-point decoding - no peripheral access
uint32_t pressureQ = 25939200u;
float pressurePa = (float)pressureQ / 256.0f; // pressurePa = 101325.0

### In Q24.8 notation, the eight says that eight stored bits represent the fractional part. One whole unit is therefore 2 to the power 8, or 256 stored counts. The 24 names the integer-bit part of this representation. Dividing by 256 recovers the physical value; shifting

by eight is an integer operation that would discard the fraction.

Returned representation | Stored example | Decoded quantity
Hundredths of a degree | 2450 | 24.50 degrees Celsius
Pressure with eight fractional bits | 25939200 | 101325Pa

Humidity with ten
fractional bits
51200 | 50.0 percent RH

The compensation routines also use intermediate scales to keep arithmetic in integers. You do not need to reconstruct Bosch's full transfer model to follow the call chain. You do need to preserve coefficient signedness, intermediate width, call order and each routine's returned scale. Those are the code-review questions

explained beside the actual functions.

Reference: Bosch Sensortec: BME280 datasheet (https://www.bosch-sensortec.com/media/boschsensortec/downloads/datasheets/bst-bme280-ds002.pdf)

COMMON PITFALL

The C type uint32_t
supplies a range of
integers. It does not
encode the scale or the
physical unit.

CHAPTER 12 / READ THE BME280 OVER I2C

# Unpack bits, then apply the correct scale

Worked example - BME280 20-bit register packing
uint8_t bytes[3] = {0x65, 0x5A, 0xC0}; int32_t raw = ((int32_t)bytes[0] << 12) | (bytes[1] << 4)
| (bytes[2] >> 4);
// raw = 0x655AC = 415148

### The first byte supplies the top eight bits. Shifting it left 12 puts them at their final positions. The next byte contributes eight more bits

after a left shift of four. Only the top nibble of the third byte is used,

### so shifting right four discards its unused low bits. Bitwise OR joins

the non-overlapping fields.

### This raw integer is not degrees Celsius. The chip's factory coefficients correct its transfer characteristics. compensateT() runs first because it also writes tFine_, an intermediate value needed by pressure and humidity compensation. Reordering those calls could

use an old intermediate even if every function individually compiles.

The returned integer scales also differ. A temperature result of 2450 means 24.50 degrees Celsius because the driver divides by 100. A Q24.8 pressure value has eight fractional bits, so divide by 256. A humidity result with ten fractional bits is divided by 1024. These scale factors follow the selected compensation formulas, not a

general I2C rule.

### One completed conversion can therefore produce three Reading records with different metrics and units. Acquisition stores them at their metric indices in Snapshot. The SGP30 later uses the temperature and humidity as dependency inputs; we will explain that

connection in its own chapter.

Reference: Bosch Sensortec: BME280 datasheet (https://www.bosch-sensortec.com/media/boschsensortec/downloads/datasheets/bst-bme280-ds002.pdf)

COMMON PITFALL

Do not insert /1000
because a raw number
looks large. Follow the
documented scale from the
conversion routine to the
published unit.

CHAPTER 12 / READ THE BME280 OVER I2C

# Keep a bus configuration distinct from a device address

### This object records how the shared I2C controller was configured. It exposes bounded transactions rather than the entire Arduino Wire

object.

### BME280 and SGP30 use the same I2cBus instance under the

acquisition owner.

src/hal/i2c_bus.h / lines 1-24
1 // I2C bus adapter (HAL). Work package WP1 (with BME280). 2 // Single owner: only the acquisition lease holder calls it > (§9).
3 // Every transaction must have a bounded timeout;
> i2cBusRecover() performs a i2cBusRecover
4 // limited stuck-bus recovery (§16), never a blocking retry > loop.
5 //
6 // Worst-case blocking: I2C_BUS_TIMEOUT_MS per transaction > (probe/writeReg/
7 // readRegs/write/read); recover() ~0.2 ms of bit-banging > plus one begin(). begin
8 #pragma once
9 #include <stdbool.h>
10 #include <stddef.h>
11 #include <stdint.h>

12
13 #define I2C_BUS_TIMEOUT_MS ((uint16_t)5)

14
15 // Treat the members as private to i2c_bus.c. Initialise > with I2C_BUS_INIT.
16 typedef struct I2cBus {
17 | bool started_;
18 | int8_t sda_;
19 | int8_t scl_;
20 | uint32_t clockHz_;
21 } I2cBus;

22
23 #define I2C_BUS_INIT {false, -1, -1, 0}

24

### I2cBus retains pins, clock and started state. Each operation also receives a device address because a shared bus can serve several chips. Register reads and arbitrary command reads are different

helpers on that same bus.

COMMON PITFALL

Do not use an address-only ACK as proof of device
identity. The driver must
check the expected chip or feature identifier.

CHAPTER 12 / READ THE BME280 OVER I2C

### Keep a bus configuration distinct from a device address / continued

src/hal/i2c_bus.h / lines 25-37
25 bool i2cBusBegin(I2cBus* bus, int8_t sda, int8_t scl, uint32_t clockHz); i2cBusBegin
26 bool i2cBusProbe(I2cBus* bus, uint8_t address); i2cBusProbe
27 bool i2cBusWriteReg(I2cBus* bus, uint8_t address, uint8_t reg, uint8_t value); i2cBusWriteReg
28 bool i2cBusReadRegs(I2cBus* bus, uint8_t address, uint8_t reg, uint8_t* buf, size_t i2cBusReadRegs > len);
29 // Raw transfers for command-based devices (SGP30): each is one transaction
30 // ending in STOP, so a device that NACKs while busy is never held by a
31 // repeated start. A read returns true only if all `len` bytes arrived.
32 bool i2cBusWrite(I2cBus* bus, uint8_t address, const uint8_t* tx, size_t len); i2cBusWrite 33 bool i2cBusRead(I2cBus* bus, uint8_t address, uint8_t* buf, size_t len); i2cBusRead
34 // Call after a failed transaction. Does nothing (returns true) when SDA is 35 // high, i.e. the failure was only a NACK; recovers only a bus held low.
36 bool i2cBusRecover(I2cBus* bus); i2cBusRecover
37 void i2cBusEnd(I2cBus* bus); i2cBusEnd

The timeout belongs to a transaction. The driver's conversion deadline is a different limit above

### this adapter. An I2C read can fail quickly while a correctly requested chip conversion

legitimately remains pending.

CHAPTER 12 / READ THE BME280 OVER I2C

# Start or reuse the configured controller

Read the exact peripheral calls hidden by the bus interface. This is where a logical request becomes bytes on the configured controller.

One acquisition owner prevents two protocol sequences from interleaving on these helpers.

src/hal/i2c_bus.c / lines 1-20
1 #include "hal/i2c_bus.h"

2
3 #include <Arduino.h>
4 #include <driver/gpio.h>
5 #include <esp32-hal-i2c.h>

6
7 // Controller 0 (what the C++ version reached through the Arduino `Wire` 8 // object). Calls go straight to the core's C I2C layer, with the same 9 // per-transaction timeout Wire.setTimeOut() used to apply.
10 static const uint8_t kI2cPort = 0;

11
12 bool i2cBusBegin(I2cBus* bus, int8_t sda, int8_t scl, uint32_t clockHz) { i2cBusBegin
13 | if (bus->started_) i2cBusEnd(bus); i2cBusEnd
14 | bus->sda_ = sda;
15 | bus->scl_ = scl;
16 | bus->clockHz_ = clockHz;
17 | // As Wire.begin(): a controller that is already running counts as started.
18 | bus->started_ = i2cIsInit(kI2cPort) || i2cInit(kI2cPort, sda, scl, clockHz) == ESP_OK;
19 | return bus->started_;

20 }

The adapter selects controller 0. If its own object is marked started, it ends that session before

### changing pins or speed. It records the requested setup and accepts a controller already

initialised by the core or a successful new i2cInit call.

### The stored bus state is a software description; it is not a hardware mutex. A second

independently configured object targeting controller 0 could still disturb the same peripheral. The application's one-owner rule is part of the safe-use contract.

CHAPTER 12 / READ THE BME280 OVER I2C

# Keep the register pointer and read together

src/hal/i2c_bus.c / lines 21-40

21
22 bool i2cBusProbe(I2cBus* bus, uint8_t address) { i2cBusProbe
23 | if (!bus->started_) return false;
24 | // Address-only write: ACK => present.
25 | return i2cWrite(kI2cPort, address, NULL, 0,
> | I2C_BUS_TIMEOUT_MS) == ESP_OK;

26 }

27
28 bool i2cBusWriteReg(I2cBus* bus, uint8_t address, uint8_t i2cBusWriteReg
> | reg, uint8_t value) {
29 | if (!bus->started_) return false;
30 | const uint8_t tx[2] = {reg, value};
31 | return i2cWrite(kI2cPort, address, tx, sizeof(tx),
> | I2C_BUS_TIMEOUT_MS) == ESP_OK;

32 }

33
34 bool i2cBusReadRegs(I2cBus* bus, uint8_t address, uint8_t i2cBusReadRegs
> | reg, uint8_t* buf, size_t len) {
35 | if (!bus->started_ || buf == NULL || len == 0) return
> | false;
36 | // Register write, repeated start, read: one bounded
> | transaction.
37 | size_t got = 0;
38 | i2cWriteReadNonStop(kI2cPort, address, &reg, 1, buf, len,
> | I2C_BUS_TIMEOUT_MS, &got);
39 | return got == len; | // a partial or failed read is dropped

40 }

### Probe performs an address-only write. WriteReg sends two bytes: register address and value. ReadRegs uses the repeated-start helper to set the register pointer and obtain the requested bytes as one

bounded transaction.

### ReadRegs checks the number actually received. It does not accept a partially filled buffer. A caller should therefore branch on the

returned boolean before unpacking any register fields.

COMMON PITFALL

The array size passed to
sizeof must describe the
actual source or
destination object, not the size of a pointer
parameter.

CHAPTER 12 / READ THE BME280 OVER I2C

# Support command-oriented devices without inventing registers

src/hal/i2c_bus.c / lines 41-52

41
42 bool i2cBusWrite(I2cBus* bus, uint8_t address, const uint8_t* tx, size_t len) { i2cBusWrite
43 | if (!bus->started_ || tx == NULL || len == 0) return false;
44 | return i2cWrite(kI2cPort, address, tx, len, I2C_BUS_TIMEOUT_MS) == ESP_OK;

45 }

46
47 bool i2cBusRead(I2cBus* bus, uint8_t address, uint8_t* buf, size_t len) { i2cBusRead
48 | if (!bus->started_ || buf == NULL || len == 0) return false;
49 | size_t got = 0;
50 | i2cRead(kI2cPort, address, buf, len, I2C_BUS_TIMEOUT_MS, &got);
51 | return got == len; | // a partial or failed read is dropped

52 }

The arbitrary write and read helpers pass a byte buffer and length directly to the core. SGP30

### uses such command sequences rather than BME280-style register addresses. Both reject an

unstarted bus or an unusable buffer/length combination.

The destination may still contain old bytes after a failed call. Success is the permission to decode, not the presence of nonzero memory. This is the same output-contract discipline used for queues and analog reads.

CHAPTER 12 / READ THE BME280 OVER I2C

# Recover only when the physical line needs it

src/hal/i2c_bus.c / lines 53-74

54 // Release a slave holding SDA low: up to 9 SCL pulses, then a STOP. 55 // Bounded (~0.2 ms); no retry loop.
56 bool i2cBusRecover(I2cBus* bus) { i2cBusRecover
const int8_t sda = bus->sda_;
const int8_t scl = bus->scl_;
if (sda < 0 || scl < 0) return false;
// An idle bus has SDA high: the failure was a NACK (e.g. a device that is // absent or busy), not a stuck bus. Leave the controller running so the // other device on the bus is not disturbed (audit L5).
if (bus->started_ && gpio_get_level((gpio_num_t)sda) != 0) return true; if (bus->started_) i2cBusEnd(bus); i2cBusEnd

pinMode(sda, INPUT_PULLUP);
pinMode(scl, OUTPUT_OPEN_DRAIN);
digitalWrite(scl, HIGH);
delayMicroseconds(5);
for (uint8_t i = 0; i < 9 && digitalRead(sda) == LOW; ++i) { digitalWrite(scl, LOW);
delayMicroseconds(5);
digitalWrite(scl, HIGH);
delayMicroseconds(5);

Recovery first reads SDA. If the controller is running and SDA is already high, the source treats the failure as something such as a NACK and leaves the controller running. It avoids resetting the whole shared bus for every absent device.

If SDA is stuck, the adapter ends the controller and manually generates up to nine clock pulses, checking whether the device releases the line. The loop is bounded. Another device on the same bus can be affected, so this belongs to the shared owner rather than a random radio callback.

CHAPTER 12 / READ THE BME280 OVER I2C

# Generate a stop and rebuild the peripheral state

src/hal/i2c_bus.c / lines 75-95

}

// STOP: SDA low -> SCL high -> SDA high. pinMode(sda, OUTPUT_OPEN_DRAIN); digitalWrite(scl, LOW);
digitalWrite(sda, LOW);
delayMicroseconds(5);
digitalWrite(scl, HIGH);
delayMicroseconds(5);
digitalWrite(sda, HIGH);
delayMicroseconds(5);

pinMode(sda, INPUT_PULLUP);
const bool sdaReleased = digitalRead(sda) == HIGH; return i2cBusBegin(bus, sda, scl, bus->clockHz_) && sdaReleased; i2cBusBegin

90 }

92 void i2cBusEnd(I2cBus* bus) { i2cBusEnd
if (bus->started_ && i2cIsInit(kI2cPort)) i2cDeinit(kI2cPort); bus->started_ = false;

95 }

The manual sequence brings SDA from low to high while SCL is high, then restores SDA as an input and calls Begin again. The return combines successful restart with the observed line release.

End shuts down the selected controller when the object says it was started, then clears the

### software flag. Recovery cannot guarantee that an electrically damaged or miswired bus

becomes usable; the boolean lets the driver report that the attempt did not restore its required condition.

CHAPTER 12 / READ THE BME280 OVER I2C

# Read the selected conversion policy

The BME280 needs factory coefficients as well as conversion state. This header gives those persistent values named fields instead of leaving them in unexplained byte arrays.

One driver publishes three Reading records from one conversion.

src/drivers/bme280.h / lines 1-28
1 // bme280 driver. Work package WP1 (Stage 2). Architecture §4, §7, §14.
2 // Datasheet: Bosch BST-BME280-DS001 rev 1.24.
3 //
4 // Verify chip ID 0x60 (rejects BMP280); read compensation coefficients once 5 // in init(). Forced mode, x1 oversampling T/P/H, IIR off; Bosch integer
6 // compensation (§4.2.3). Produces AirTemperature, AirHumidity, AirPressure. 7 //
8 // Worst-case blocking (I2C_BUS_TIMEOUT_MS = T per transaction):
9 // | init() | ~13 ms + 16 T | (soft reset + bounded NVM-copy wait)
10 // | start() | 1 T | (one register write)
11 // | poll() | 2 T | (ctrl_hum/status + one 8-byte burst); Pending
12 // | | | until start+10 ms (t_max 9.3 ms), Timeout
13 // | | | after CFG_BME280_BUDGET_MS
14 // | others | no bus access
15 // Any bus fault, timeout or invalid sample clears the initialised state, so 16 // the next start() returns Fault and the caller re-runs init(). poll() also 17 // detects a module power-cycle (ctrl_hum back to reset 0): it fails the
18 // sample and clears the initialised state; the caller then re-runs init().

19 //
20 // Implements the SensorDriver contract in drivers/sensor_driver.h.
21 #pragma once
22 #include "drivers/sensor_driver.h"
23 #include "hal/i2c_bus.h"

24
25 typedef struct Bme280Config {
26 | I2cBus* bus;
27 | uint8_t address; | // BOARD_BME280_I2C_ADDRESS
28 } Bme280Config;

### The contract describes forced conversions, three result metrics and the intended blocking limits. A forced request lets acquisition choose release times rather than consuming an

independently cycling stream whose phase is unknown.

The I2C configuration contains a bus pointer and device address. Moving the address does not

### require changing the compensation mathematics. This is the separation between locating a

device and interpreting its result.

CHAPTER 12 / READ THE BME280 OVER I2C

# Keep coefficients, intermediate state and results separate

src/drivers/bme280.h / lines 29-55

29
30 #define BME280_METRICS 3 // results_ index: 0 T, 1 H, 2 P

31
32 typedef struct Bme280Calib {
33 | uint16_t t1;
34 | int16_t t2, t3;
35 | uint16_t p1;
36 | int16_t p2, p3, p4, p5, p6, p7, p8, p9;
37 | uint8_t h1, h3;
38 | int16_t h2, h4, h5;
39 | int8_t h6;
40 } Bme280Calib;

41
42 // Members after `base` are private to bme280.c. 43 typedef struct Bme280Driver {
44 | SensorDriver base; | // must stay first
45 | Bme280Config config_;
46 | Bme280Calib calib_;
47 | int32_t tFine_;
48 | MonoMs startMs_;
49 | bool initialised_;
50 | bool busy_;
51 | Reading results_[BME280_METRICS];
52 } Bme280Driver;

53
54 // Constructor. Use &driver.base wherever a SensorDriver* is expected.
55 void bme280DriverConstruct(Bme280Driver* self, const Bme280Config* config); bme280DriverConstruct

Bme280Calib distinguishes signed and unsigned coefficient fields. Bme280Driver stores that

### calibration, tFine_, a start timestamp, lifecycle flags and three retained results. The

fine-temperature intermediate is shared by the pressure and humidity formulas.

The constructor receives configuration and installs a generic base. It does not discover a new bus on every sample. Read the implementation next with these storage groups in mind: device setup, one operation and completed observations.

CHAPTER 12 / READ THE BME280 OVER I2C

# Name each register before using it

We will follow identification, reset, coefficient loading, one forced measurement and every

### compensation helper. You do not need to memorise the coefficient formulas; you do need to

understand their inputs, order, scale and failure checks.

Keep the BME280 datasheet open for register definitions when checking a packed field.

src/drivers/bme280.c / lines 1-27
1 #include "drivers/bme280.h"

2
3 #include <Arduino.h>
4 #include <string.h>

5
6 #include "app_config.h"

7
8 // Registers (datasheet §5.3).
9 static const uint8_t kRegCalib00 = 0x88; // ..0xA1, 26 bytes 10 static const uint8_t kRegChipId = 0xD0;
11 static const uint8_t kRegReset = 0xE0;
12 static const uint8_t kRegCalib26 = 0xE1; // ..0xE7, 7 bytes 13 static const uint8_t kRegCtrlHum = 0xF2;
14 static const uint8_t kRegStatus = 0xF3;
15 static const uint8_t kRegCtrlMeas = 0xF4;
16 static const uint8_t kRegConfig = 0xF5;
17 static const uint8_t kRegData = 0xF7; | // ..0xFE, 8 bytes (P, T, H)

18
19 static const uint8_t kChipId = 0x60;
20 static const uint8_t kResetCmd = 0xB6;
21 static const uint8_t kStatusMeasuring = 1u << 3;
22 static const uint8_t kStatusImUpdate = 1u << 0;

23
24 static const uint8_t kCtrlHumX1 = 0x01; | // osrs_h = x1
25 static const uint8_t kConfigNoFilter = 0x00; | // IIR off, t_sb unused in forced mode
26 static const uint8_t kCtrlMeasForcedX1 = (1u << 5) | (1u << 2) | 0x01; | // 0x25

27

The constants name register locations, expected identity, control bits and ranges. kCtrlMeasForcedX1 combines three bit fields with OR; it is not three sequential commands. u16le and s16le join little-endian calibration bytes with different signed interpretations.

src/drivers/bme280.c / lines 28-34
28 static const uint32_t kFirstPollMs = 10; | // > t_max 9.3 ms at x1/x1/x1 (§9.1)
29 static const uint8_t kResetWaitMaxMs = 10; | // bounded NVM-copy wait in init()

30
31 // Operating range (§1): -40..85 degC, 0..100 %RH, 300..1100 hPa.
32 static const int32_t kTminCenti = -4000, kTmaxCenti = 8500;
33 static const float kPminPa = 30000.0f, kPmaxPa = 110000.0f;

34

CHAPTER 12 / READ THE BME280 OVER I2C

### Name each register before using it / continued

src/drivers/bme280.c / lines 35-48
35 static inline uint16_t u16le(const uint8_t* b) { return (uint16_t)(b[0] | (b[1] << 8)); u16le
> | }
36 static inline int16_t s16le(const uint8_t* b) { return (int16_t)u16le(b); } s16le | u16le

37
38 static inline Bme280Driver* asBme280(SensorDriver* d) { return (Bme280Driver*)d; } asBme280

39
40 static bool readCalibration(Bme280Driver* self); readCalibration
41 static PollResult fail(Bme280Driver* self, DriverStatus status, Health health, MonoMs fail
> | now);
42 static int32_t compensateT(Bme280Driver* self, int32_t adcT); | // 0.01 degC, sets compensateT
> | tFine_
43 static uint32_t compensateP(Bme280Driver* self, int32_t adcP); | // Q24.8 Pa, 0 = invalid compensateP
44 static uint32_t compensateH(Bme280Driver* self, int32_t adcH); | // Q22.10 %RH compensateH

45
46 static SensorId bme280Id(const SensorDriver* d) { (void)d; return SENSOR_BME280; } bme280Id
47 static const char* bme280Name(const SensorDriver* d) { (void)d; return "bme280"; } bme280Name 48 static uint8_t bme280MetricCount(const SensorDriver* d) { (void)d; return bme280MetricCount
> BME280_METRICS; }

The forward declarations let later helper bodies be called before their definitions appear. They do not execute those bodies. The identity helpers then supply the fixed generic-driver metadata.

CHAPTER 12 / READ THE BME280 OVER I2C

# Identify the chip before accepting its state

src/drivers/bme280.c / lines 49-74

50 static DriverStatus bme280Init(SensorDriver* d) { bme280Init Bme280Driver* self = asBme280(d); asBme280
self->initialised_ = false;
self->busy_ = false;
I2cBus* bus = self->config_.bus;
const uint8_t address = self->config_.address;

uint8_t id = 0;
if (!i2cBusReadRegs(bus, address, kRegChipId, &id, 1)) { i2cBusReadRegs
i2cBusRecover(bus); i2cBusRecover
return DRIVER_FAULT;

}
if (id != kChipId) return DRIVER_NOT_PRESENT;

if (!i2cBusWriteReg(bus, address, kRegReset, kResetCmd)) return DRIVER_FAULT; i2cBusWriteReg
// t_startup <= 2 ms (Table 1). delay(n) may return up to 1 tick early, so // a failed read is "not ready yet" until the bounded wait runs out. delay(3);
bool ready = false;
for (uint8_t i = 0; i < kResetWaitMaxMs && !ready; ++i) {
uint8_t status = kStatusImUpdate;
ready = i2cBusReadRegs(bus, address, kRegStatus, &status, 1) && i2cBusReadRegs
(status & kStatusImUpdate) == 0; if (!ready) delay(1);

}

Init clears lifecycle flags and reads the identity register. A transport failure and the wrong chip identity return different statuses. A correct address ACK without the expected identity is insufficient.

The reset write is followed by a bounded wait for the NVM-copy status to clear. The chip may still be starting even if an early read fails. The loop gives it limited opportunities to become ready; it does not retry forever inside acquisition.

CHAPTER 12 / READ THE BME280 OVER I2C

# Verify configuration before setting initialised

src/drivers/bme280.c / lines 75-94
if (!ready) return DRIVER_TIMEOUT;

if (!readCalibration(self)) return DRIVER_FAULT; readCalibration

// Sleep mode after reset, so config writes are accepted (§5.4.6). // ctrl_hum takes effect on the ctrl_meas write in start() (§5.4.3). uint8_t check[2] = {0, 0};
if (!i2cBusWriteReg(bus, address, kRegCtrlHum, kCtrlHumX1) || i2cBusWriteReg
!i2cBusWriteReg(bus, address, kRegConfig, kConfigNoFilter) || i2cBusWriteReg
!i2cBusReadRegs(bus, address, kRegCtrlHum, &check[0], 1) || i2cBusReadRegs
!i2cBusReadRegs(bus, address, kRegConfig, &check[1], 1)) { i2cBusReadRegs
return DRIVER_FAULT;

}
if ((check[0] & 0x07) != kCtrlHumX1 || (check[1] & 0xFC) != kConfigNoFilter) { return DRIVER_FAULT;

}

self->initialised_ = true; return DRIVER_OK;

94 }

After coefficient loading, init writes humidity oversampling and the selected configuration, then reads them back. Masking compares only the relevant bits. A failed write, read or mismatch returns before initialised_ becomes true.

That final true assignment is the commit point for device setup. The next start depends on it. Do not move it ahead of the readback merely because the earlier writes returned success.

CHAPTER 12 / READ THE BME280 OVER I2C

# Decode factory coefficients with the right signedness

src/drivers/bme280.c / lines 95-122

95
96 static bool readCalibration(Bme280Driver* self) { readCalibration
97 | uint8_t a[26];
98 | uint8_t b[7];
99 | if (!i2cBusReadRegs(self->config_.bus, self->config_.address, kRegCalib00, a, i2cBusReadRegs
> | sizeof(a)) ||
100 | !i2cBusReadRegs(self->config_.bus, self->config_.address, kRegCalib26, b, i2cBusReadRegs
> | sizeof(b))) {
101 | return false;
102 | }
103 | Bme280Calib* c = &self->calib_;
104 | // Table 16. a[0] = 0x88, b[0] = 0xE1.
105 | c->t1 = u16le(&a[0]); u16le
106 | c->t2 = s16le(&a[2]); s16le
107 | c->t3 = s16le(&a[4]); s16le
108 | c->p1 = u16le(&a[6]); u16le
109 | c->p2 = s16le(&a[8]); s16le
110 | c->p3 = s16le(&a[10]); s16le
111 | c->p4 = s16le(&a[12]); s16le
112 | c->p5 = s16le(&a[14]); s16le
113 | c->p6 = s16le(&a[16]); s16le
114 | c->p7 = s16le(&a[18]); s16le
115 | c->p8 = s16le(&a[20]); s16le
116 | c->p9 = s16le(&a[22]); s16le
117 | c->h1 = a[25]; | // 0xA1
118 | c->h2 = s16le(&b[0]); | // 0xE1/0xE2 s16le
119 | c->h3 = b[2]; | // 0xE3
120 | c->h4 = (int16_t)(((int8_t)b[3] * 16) | (b[4] & 0x0F)); | // E4[11:4] E5[3:0]
121 | c->h5 = (int16_t)(((int8_t)b[5] * 16) | (b[4] >> 4)); | // E6[11:4] E5[7:4]
122 | c->h6 = (int8_t)b[6]; | // 0xE7

### Two burst reads cover the coefficient regions. The code then maps byte offsets to named

coefficient fields. Most use 16-bit little-endian helpers, but h4 and h5 span nibbles across adjacent bytes and need explicit signed handling.

src/drivers/bme280.c / lines 123-126

123
124 | // Blank NVM or a bus returning 0x00/0xFF would make these 0/0xFFFF.
125 | return c->t1 != 0 && c->p1 != 0 && c->t1 != 0xFFFF && c->p1 != 0xFFFF;

126 }

For h4, the signed high fragment is multiplied by 16 before the low nibble is ORed in. This avoids shifting a negative signed value left. The final nonzero/non-all-ones checks reject obvious blank or disconnected data, although they do not prove every possible corrupt coefficient set is detected.

CHAPTER 12 / READ THE BME280 OVER I2C

# Request one conversion without occupying its duration

src/drivers/bme280.c / lines 127-139

127
128 static DriverStatus bme280Start(SensorDriver* d, MonoMs now) { bme280Start
129 | Bme280Driver* self = asBme280(d); asBme280
130 | if (!self->initialised_) return DRIVER_FAULT;
131 | if (!i2cBusWriteReg(self->config_.bus, self->config_.address, kRegCtrlMeas, i2cBusWriteReg
132 | kCtrlMeasForcedX1)) {
133 | self->initialised_ = false;
134 | return DRIVER_FAULT;
135 | }
136 | self->startMs_ = now;
137 | self->busy_ = true;
138 | return DRIVER_OK;

139 }

Start rejects a driver that has not completed init. It writes the control value, clears initialisation on a write failure, then records startMs_ and busy_ only after the request succeeded.

The return does not contain temperature. Its job is to establish an in-progress operation whose next poll can compare now with the stored start. The bus is then free for another permitted transaction.

CHAPTER 12 / READ THE BME280 OVER I2C

# Check conversion progress after the initial guard

src/drivers/bme280.c / lines 140-162

141 static PollResult bme280Poll(SensorDriver* d, MonoMs now) { bme280Poll Bme280Driver* self = asBme280(d); asBme280
I2cBus* bus = self->config_.bus;
const uint8_t address = self->config_.address;
const MonoMs startMs = self->startMs_;

if (!self->busy_) return fail(self, DRIVER_FAULT, HEALTH_FAULT, now); fail

// The measuring bit may not be set yet right after the trigger, so the // first status check waits until the maximum conversion time has passed. if (now < startMs + kFirstPollMs) {
PollResult r = {DRIVER_PENDING, startMs + kFirstPollMs};
return r;

}

// ctrl_hum + status in one burst. ctrl_hum back at its reset value means the // module was power-cycled and lost its settings: fail, so the caller re-inits. uint8_t cs[2] = {0, 0};
if (!i2cBusReadRegs(bus, address, kRegCtrlHum, cs, sizeof(cs))) { i2cBusReadRegs
i2cBusRecover(bus); i2cBusRecover
return fail(self, DRIVER_FAULT, HEALTH_FAULT, now); fail

}

Poll recovers the concrete object and rejects a call without busy_. Before the first useful time it returns PENDING without reading status. After that guard, it reads expected humidity setup and measuring state together.

CHAPTER 12 / READ THE BME280 OVER I2C

### Check conversion progress after the initial guard / continued

src/drivers/bme280.c / lines 163-176
if ((cs[0] & 0x07) != kCtrlHumX1) return fail(self, DRIVER_FAULT, HEALTH_FAULT, now); fail const uint8_t status = cs[1];
if (status & kStatusMeasuring) {
if (now - startMs >= CFG_BME280_BUDGET_MS) { return fail(self, DRIVER_TIMEOUT, HEALTH_TIMEOUT, now); fail

}
PollResult r = {DRIVER_PENDING, now + 1}; return r;

}

// One burst read: shadowing keeps P/T/H consistent only within it (§4.1). uint8_t dat[8];
if (!i2cBusReadRegs(bus, address, kRegData, dat, sizeof(dat))) { i2cBusReadRegs
i2cBusRecover(bus); i2cBusRecover

A configuration reset is treated as failure, while a still-busy chip gets another poll until its conversion budget is exhausted. This distinguishes lost setup, failed transport and an operation that simply has not completed yet.

CHAPTER 12 / READ THE BME280 OVER I2C

# Read one coherent raw block and preserve bit positions

src/drivers/bme280.c / lines 177-203
return fail(self, DRIVER_FAULT, HEALTH_FAULT, now); fail

}
self->busy_ = false;
const int32_t adcP = ((int32_t)dat[0] << 12) | (dat[1] << 4) | (dat[2] >> 4);
const int32_t adcT = ((int32_t)dat[3] << 12) | (dat[4] << 4) | (dat[5] >> 4);
const int32_t adcH = ((int32_t)dat[6] << 8) | dat[7];

// All-ones means a floating bus (impossible as real T/P data: at x1 the low // 4 bits are 0). 0x80000/0x8000 are NOT checked: at x1 they are valid
// mid-scale readings (lost settings are detected via ctrl_hum above).
if (adcT == 0xFFFFF || adcP == 0xFFFFF || adcH == 0xFFFF) {
return fail(self, DRIVER_FAULT, HEALTH_FAULT, now); fail

}

// Temperature first: it provides tFine_ for P and H. const int32_t tCenti = compensateT(self, adcT); compensateT
if (tCenti < kTminCenti || tCenti > kTmaxCenti) { return fail(self, DRIVER_FAULT, HEALTH_FAULT, now); fail

}
const uint32_t pQ8 = compensateP(self, adcP); compensateP
const uint32_t hQ10 = compensateH(self, adcH); compensateH

const float values[BME280_METRICS] = { (float)tCenti / 100.0f,
(float)hQ10 / 1024.0f,
(float)pQ8 / 256.0f,

The burst fills eight bytes. The shifts reconstruct 20-bit pressure and temperature and 16-bit humidity. The all-ones guard rejects an obvious invalid response. Temperature compensation runs first because it updates tFine_.

The pressure and humidity routines then use that same intermediate. Call order is part of the algorithm. A compiler accepts reversed calls, but pressure and humidity could use stale state if you reorder them.

CHAPTER 12 / READ THE BME280 OVER I2C

# Turn scaled integers into three independent verdicts

src/drivers/bme280.c / lines 204-231

};
const int32_t raws[BME280_METRICS] = {adcT, adcH, adcP}; const bool valid[BME280_METRICS] = {
true,
208 | true, | // compensateH clamps to 0..100 %RH
pQ8 != 0 && values[2] >= kPminPa && values[2] <= kPmaxPa,

};

for (uint8_t i = 0; i < BME280_METRICS; ++i) {
Reading* r = &self->results_[i]; r->intervalStartMs = startMs; r->intervalEndMs = now;
r->hasRaw = true;
r->raw = raws[i];
r->qualityFlags = kQualityNone; if (valid[i]) {
r->health = HEALTH_OK;
r->value = values[i];
r->lastGoodMs = now;
++r->sequence;
| } else {
r->health = HEALTH_FAULT;

}

}

PollResult r = {DRIVER_READY, now};
| return r;

231 }

Temperature uses hundredths of a degree, pressure uses eight fractional bits and humidity uses ten. The float conversions divide by 100, 256 and 1024 respectively. The values array and raw array are ordered to match the three result identities established by construction.

### Each result gets interval and raw data. Accepted metrics update value and lastGoodMs; a rejected pressure can carry FAULT even when the same conversion's temperature is

acceptable. READY says the set of outcomes is available, not that every member passed.

CHAPTER 12 / READ THE BME280 OVER I2C

# Keep failure and temperature arithmetic local

src/drivers/bme280.c / lines 232-256

232
233 // Abort the measurement, mark every metric with `health` and force a re-init
234 // on the next start(). The last value is kept but never reported as Ok.
235 static PollResult fail(Bme280Driver* self, DriverStatus status, Health health, MonoMs fail
> | now) {
236 | self->busy_ = false;
237 | self->initialised_ = false;
238 | for (uint8_t i = 0; i < BME280_METRICS; ++i) {
239 | self->results_[i].health = health;
240 | self->results_[i].intervalStartMs = self->startMs_;
241 | self->results_[i].intervalEndMs = now;
242 | }
243 | PollResult r = {status, now};
244 | return r;

245 }

246
247 // Datasheet §4.2.3 (rev 1.1 reference code), fixed-point. 248 static int32_t compensateT(Bme280Driver* self, int32_t adcT) { compensateT
249 | const Bme280Calib* c = &self->calib_;
250 | const int32_t t1 = c->t1;
251 | int32_t var1 = ((((adcT >> 3) - (t1 << 1))) * (int32_t)c->t2) >> 11;
252 | int32_t var2 = (((((adcT >> 4) - t1) * ((adcT >> 4) - t1)) >> 12) *
253 | (int32_t)c->t3) >> 14;
254 | self->tFine_ = var1 + var2;
255 | return (self->tFine_ * 5 + 128) >> 8;

256 }

fail ends the operation, requires reinitialisation and marks all three result intervals with the requested health. It returns a PollResult consistent with that operation failure.

compensateT uses factory coefficients to obtain tFine_ and a centi-degree result. The casts and shifts preserve the fixed-point scale expected by the reference formula. The shift by 8 near the return divides by 256 at that stage; it does not mean the final value is already degrees Celsius.

CHAPTER 12 / READ THE BME280 OVER I2C

# Use wide intermediates before multiplication

src/drivers/bme280.c / lines 257-273

257
258 static uint32_t compensateP(Bme280Driver* self, int32_t adcP) { compensateP
259 | const Bme280Calib* c = &self->calib_;
260 | int64_t var1 = (int64_t)self->tFine_ - 128000;
261 | int64_t var2 = var1 * var1 * c->p6;
262 | var2 = var2 + ((var1 * c->p5) * 131072); | // << 17
263 | var2 = var2 + ((int64_t)c->p4 * 34359738368LL); | // << 35
264 | var1 = ((var1 * var1 * c->p3) >> 8) + ((var1 * c->p2) * 4096); | // << 12
265 | var1 = (((int64_t)1 << 47) + var1) * c->p1 >> 33;
266 | if (var1 == 0) return 0; | // avoid division by zero
267 | int64_t p = 1048576 - adcP;
268 | p = (((p << 31) - var2) * 3125) / var1;
269 | var1 = ((int64_t)c->p9 * (p >> 13) * (p >> 13)) >> 25;
270 | var2 = ((int64_t)c->p8 * p) >> 19;
271 | p = ((p + var1 + var2) >> 8) + ((int64_t)c->p7 * 16); | // << 4; p7 is signed
272 | return (uint32_t)p;

273 }

### Pressure compensation uses int64_t intermediates because coefficient products exceed a

comfortable 32-bit range. The conversion to a wider type occurs before the large arithmetic. A cast after overflow would not repair the lost value.

var1 is checked before division. Returning zero marks the pressure result invalid in the caller. The return scale is Q24.8 pascals, so the caller divides by 256. Follow that agreement rather than guessing a decimal scale from the size of the integer.

CHAPTER 12 / READ THE BME280 OVER I2C

# Clamp the humidity representation deliberately

src/drivers/bme280.c / lines 274-288

275 static uint32_t compensateH(Bme280Driver* self, int32_t adcH) { compensateH
const Bme280Calib* c = &self->calib_;
int32_t v = self->tFine_ - 76800;
// h4 is signed: multiply, not << 20 (a negative left shift is undefined in C). v = (((((adcH << 14) - ((int32_t)c->h4 * 1048576) -
((int32_t)c->h5 * v)) + 16384) >> 15) *
(((((((v * (int32_t)c->h6) >> 10) *
(((v * (int32_t)c->h3) >> 11) + 32768)) >> 10) + 2097152) * (int32_t)c->h2 + 8192) >> 14));
v = v - (((((v >> 15) * (v >> 15)) >> 7) * (int32_t)c->h1) >> 4); v = v < 0 ? 0 : v;
v = v > 419430400 ? 419430400 : v;
return (uint32_t)(v >> 12);

288 }

The humidity expression also depends on tFine_. Signed coefficient h4 is multiplied rather than shifted left. The lower and upper clamps constrain the fixed-point humidity representation before its final shift.

This dense arithmetic is a good place to preserve a known reference implementation and test known vectors. Simplifying parentheses without following every intermediate scale can silently change the function even when it still compiles. The driver later divides the returned Q-format integer by 1024.

CHAPTER 12 / READ THE BME280 OVER I2C

# Copy only the capacity the caller supplied

src/drivers/bme280.c / lines 289-306

289
290 static uint8_t bme280ReadResult(SensorDriver* d, Reading* out, uint8_t maxOut) { bme280ReadResult
291 | Bme280Driver* self = asBme280(d); asBme280
292 | if (out == NULL) return 0;
293 | const uint8_t n = maxOut < BME280_METRICS ? maxOut : BME280_METRICS;
294 | for (uint8_t i = 0; i < n; ++i) out[i] = self->results_[i];
295 | return n;

296 }

297
298 // A forced conversion finishes by itself and the chip returns to sleep.
299 static void bme280Cancel(SensorDriver* d) { asBme280(d)->busy_ = false; } bme280Cancel | asBme280

300
301 // The 3.3 V rail stays up in low power (§3); just require a fresh init(). 302 static void bme280PreparePowerOff(SensorDriver* d) { bme280PreparePowerOff
303 | Bme280Driver* self = asBme280(d); asBme280
304 | self->busy_ = false;
305 | self->initialised_ = false;

306 }

ReadResult chooses the smaller of maxOut and the three metrics, copies that many records and returns the count. A null destination returns zero. The caller must iterate only over the returned count.

Cancel clears busy_. PreparePowerOff also requires a later init. The physical forced conversion may finish internally; cancellation means the software no longer treats its eventual bytes as this accepted pending operation.

CHAPTER 12 / READ THE BME280 OVER I2C

# Construct identity once and preserve result history

src/drivers/bme280.c / lines 307-332

308 static const SensorDriverOps kBme280Ops = { .id = bme280Id,
.name = bme280Name,
.metricCount = bme280MetricCount, .init = bme280Init,
.start = bme280Start,
.poll = bme280Poll,
.readResult = bme280ReadResult,
.cancel = bme280Cancel,
.preparePowerOff = bme280PreparePowerOff,

318 };

320 // Readings are reset once here so sequence/lastGoodMs survive re-inits. 321 void bme280DriverConstruct(Bme280Driver* self, const Bme280Config* config) { bme280DriverConstruct self->base.ops = &kBme280Ops;
self->config_ = *config;
memset(&self->calib_, 0, sizeof(self->calib_));
self->tFine_ = 0;
self->startMs_ = 0;
self->initialised_ = false;
self->busy_ = false;
readingReset(&self->results_[0], SENSOR_BME280, METRIC_AIR_TEMPERATURE, UNIT_DEG_C); readingReset
readingReset(&self->results_[1], SENSOR_BME280, METRIC_AIR_HUMIDITY, UNIT_PERCENT_RH); readingReset
readingReset(&self->results_[2], SENSOR_BME280, METRIC_AIR_PRESSURE, UNIT_PASCAL); readingReset

332 }

The operations table links each lifecycle function. Construction installs it, copies the bus configuration, clears coefficient and execution state, and gives the three results their distinct identities and units.

Results are reset at construction rather than every init so their retained history can survive recovery attempts. Acquisition later supplies its own published observation sequence, including failures, without asking this driver to know about queues.

CHAPTER 12 / READ THE BME280 OVER I2C

# Prepare persistent objects and identify likely variants

Use this entry point to distinguish bus addressing, device identity and a complete compensated reading. Each is observable separately.

The generic harness supplies the repeated start/poll/read loop you already read.

test/bringup/bme280_main.c / lines 1-22
1 // Bring-up entry point for bme280 (WP1). pio run -e test_bme280 -t upload -t monitor 2 // 3.3 V rail. Expect 3 readings every 250 ms, took <= 12 ms.
3 // Replaces src/main.c in this env only; links the production driver.
4 #include <Arduino.h>
5 #include <stdio.h>

6
7 #include "app_config.h"
8 #include "board_profile.h" 9 #include "bringup_harness.h" 10 #include "hal/i2c_bus.h"
11 #include "drivers/bme280.h"

12
13 static I2cBus s_i2c = I2C_BUS_INIT;
14 static Bme280Config s_config; // address chosen at runtime in setup() setup
15 static Bme280Driver s_driver;
16 static BringupContext s_ctx = {&s_driver.base, CFG_BME280_PERIOD_MS, NULL};

17
18 static const char* chipName(uint8_t id) { chipName
19 | if (id == 0x60) return "BME280";
20 | if (id == 0x56 || id == 0x57 || id == 0x58) return "BMP280 (no humidity!)";
21 | return "unknown";

22 }

The bus, driver, configuration and context live for the program's lifetime. The context uses the

### faster climate period. chipName distinguishes the expected BME280 identity from BMP280

variants that lack humidity.

This helper only prints a diagnostic interpretation. The driver still enforces its own expected identity. A convenient label from this setup code does not bypass that check.

CHAPTER 12 / READ THE BME280 OVER I2C

# Probe addresses before constructing the chosen device

test/bringup/bme280_main.c / lines 23-45

24 void setup(void) { setup
delay(200);
printf("\n=== bring-up: bme280 (SDA %d, SCL %d, %lu Hz) ===\n", BOARD_PIN_I2C_SDA, BOARD_PIN_I2C_SCL, (unsigned long)BOARD_I2C_CLOCK_HZ);

const bool busOk = i2cBusBegin(&s_i2c, BOARD_PIN_I2C_SDA, BOARD_PIN_I2C_SCL, i2cBusBegin
BOARD_I2C_CLOCK_HZ);
printf("i2c begin -> %s\n", busOk ? "OK" : "FAILED");

// Pick whichever address ACKs (SDO strap); default if neither does. uint8_t address = BOARD_BME280_I2C_ADDRESS;
const bool ack76 = i2cBusProbe(&s_i2c, BOARD_BME280_I2C_ADDRESS); i2cBusProbe
const bool ack77 = i2cBusProbe(&s_i2c, BOARD_BME280_I2C_ADDRESS_ALT); i2cBusProbe
printf("probe 0x%02X -> %s, 0x%02X -> %s\n", BOARD_BME280_I2C_ADDRESS,
ack76 ? "ACK" : "-", BOARD_BME280_I2C_ADDRESS_ALT, ack77 ? "ACK" : "-"); if (!ack76 && ack77) address = BOARD_BME280_I2C_ADDRESS_ALT;

uint8_t id = 0;
if (i2cBusReadRegs(&s_i2c, address, 0xD0, &id, 1)) { i2cBusReadRegs
printf("chip id @0x%02X = 0x%02X (%s)\n", address, id, chipName(id)); chipName
} else {
printf("chip id @0x%02X -> read failed (check wiring/pull-ups)\n", address);

Setup begins the bus and probes both supported address straps. If only the alternate responds, it selects that one. It then reads the identity register and prints what arrived.

Probe success, register-read success and accepted chip identity are separate checkpoints. If neither address responds, retaining the default address lets the harness report init failure

### rather than making up a successful device. Read the output in that order when diagnosing

wiring.

CHAPTER 12 / READ THE BME280 OVER I2C

# Pass the selected address into the production driver

test/bringup/bme280_main.c / lines 46-54

46 }

47
48 | s_config.bus = &s_i2c;
49 | s_config.address = address;
50 | bme280DriverConstruct(&s_driver, &s_config); bme280DriverConstruct
51 | bringupStart(&s_ctx); bringupStart

52 }

53
54 void loop(void) { vTaskDelay(portMAX_DELAY); } loop | vTaskDelay

The chosen bus and address are stored in s_config before construction. The harness then runs the unmodified production driver. Setup does not perform compensation itself.

loop blocks, so a failure to produce repeated records belongs to the task, lifecycle or bus path. The expectation of three metrics every 250ms is a target to check against elapsed readings, not a consequence of printing that expectation in a comment.

CHAPTER 13 / WAIT FOR WATER TEMPERATURE

# Start the DS18B20 and leave it working

### The DS18B20 uses 1-Wire: a bus where the controller and sensor exchange timed bits on one data line. This project supplies the sensor externally from the retained 3.3V rail. The bus transaction needs CPU attention; the internal temperature conversion does not

need the bus held busy for its whole duration.

Original firmware - src/drivers/ds18b20.c, lines 79-91
static DriverStatus ds18b20Start(SensorDriver* d, MonoMs now) { Ds18b20Driver* self = asDs18b20(d);
if (!self->initialised_) return DRIVER_FAULT;
if (!selectDevice(self)) {
self->initialised_ = false; markNotPresent(self, now, now);
return DRIVER_NOT_PRESENT;
}
oneWireBusWriteByte(self->config_.bus, kCmdConvertT); self->startMs_ = now;
self->busy_ = true;
return DRIVER_OK;
}

### The driver checks initialisation, selects the discovered sensor, writes Convert T, stores the start time and returns. If selection fails, it

marks the sensor missing and does not claim a conversion began. startMs_ becomes the reference for the later conversion wait.

REMEMBER

Waiting for physical
conversion and
transmitting a 1-Wire
command are different
kinds of time.

CHAPTER 13 / WAIT FOR WATER TEMPERATURE

### Start the DS18B20 and leave it working / continued

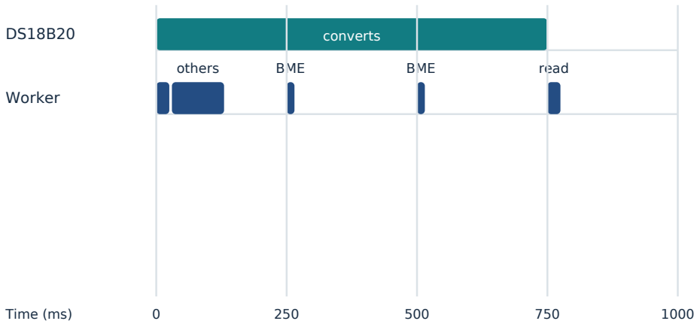
[picture p11: figure]
converts; Worker; others; BME; read; Time (ms)

Illustrative 1s frame: the water chip converts while the worker handles other jobs.

At the chosen 12-bit resolution, the project allows 750ms before reading. A frame releases ordinary jobs every 1000ms, so the water conversion can span most of a frame. That is elapsed time inside the chip, not a 750ms busy loop in the worker.

The drawing shows conceptual ordering, not a measured trace or a hard timing guarantee. In real code, individual 1-Wire calls can block briefly and may mask interrupts. Acquisition must place those calls carefully relative to the ultrasonic echo window. We will return to that conflict after learning echo capture.

Reference: Analog Devices: DS18B20 datasheet (https://www.analog.com/media/en/technical-documentation/data-sheets/ds18b20.pdf)

CHAPTER 13 / WAIT FOR WATER TEMPERATURE

# Validate the bytes before dividing them

Original firmware - src/drivers/ds18b20.c, lines 98-116
// Fixed worst-case conversion time: no bus traffic while
> | converting.
| const MonoMs due = self->startMs_ +
> | CFG_DS18B20_CONVERSION_MAX_MS;
| if (now < due) {
| r.status = DRIVER_PENDING;
| r.nextPollMs = due;
| return r;
}
| self->busy_ = false;
| uint8_t sp[DS18B20_SCRATCHPAD_LEN];
| if (!readScratchpad(self, sp)) {
| self->initialised_ = false;
| markNotPresent(self, self->startMs_, now);
| r.status = DRIVER_NOT_PRESENT;
| return r;
}
| finish(self, sp, now);
| r.status = DRIVER_READY;
| return r;
}

### Before due, poll returns PENDING with that same absolute timestamp. At or after due, it clears busy_, reads the scratchpad and calls finish(). The scratchpad is the sensor's small

result-and-configuration memory area.

A successful transaction is not enough. The codec checks a CRC, a check byte calculated from the message bytes. A mismatch means the received bytes do not match the expected codeword, so the driver rejects the observation before interpreting temperature. CRC detects many transmission errors; it does not prove the probe's

physical accuracy.

COMMON PITFALL

A familiar temperature
value is not a replacement for CRC and lifecycle
checks. Reset defaults can look like real
measurements.

CHAPTER 13 / WAIT FOR WATER TEMPERATURE

### Validate the bytes before dividing them / continued

Worked decode - temperature bytes after a valid CRC
uint8_t low = 0x90;
uint8_t high = 0x01;
int16_t raw = (int16_t)((uint16_t)high << 8 | low);
float waterC = (float)raw / 16.0f;
// 0x0190 = 400; 400 / 16 = 25.0 degrees Celsius

This device places the low byte first, unlike the big-endian words we will meet in the SGP30. The signed 16-bit result supports negative temperatures. For example, raw=-160 gives -10.0 degrees Celsius after division by 16.

The driver also checks the configured resolution and application range. It treats the +85-degree

### power-on register value as a fault in this hydroponics application because that value can

indicate a reset without a completed conversion. That is a project-specific diagnostic choice; +85 degrees Celsius is not universally an impossible DS18B20 measurement.

Reference: Analog Devices: DS18B20 datasheet (https://www.analog.com/media/en/technical-documentation/data-sheets/ds18b20.pdf)

CHAPTER 13 / WAIT FOR WATER TEMPERATURE

# Give the next sensor a copy, not a live pointer

### The TDS conversion needs water temperature. How should it get it? The acquisition owner already holds the latest water-temperature Reading in its working Snapshot. Before starting TDS, it calls

tdsDriverSetWaterTemperature() with that record.

Original firmware - src/drivers/tds.c, lines 179-185
void tdsDriverSetWaterTemperature(TdsDriver* self, const > Reading* waterTemperature) { self->waterTemperature_ = *waterTemperature;

}

void tdsDriverSetCalibration(TdsDriver* self, const > LinearCalibration* calibration) { self->config_.calibration = *calibration;

}

### The structure assignment makes a copy. TDS keeps that observation and its timestamp; it does not follow a changing pointer back into the Snapshot. That makes the dependency used for this measurement

stable while the next water conversion progresses.

### Suppose the previous water Reading ended at 900ms. TDS starts at 1100ms, before the new 750ms water conversion completes. At finish, it can use the previous 25.0-degree record if it remains fresh and OK. A dependency does not always have to come from the same

frame; it has to satisfy the declared validity and age limits.

### If the water sensor stops responding, the retained record eventually becomes stale. TDS then marks its own dependency invalid instead of silently using the last known temperature forever. This is the practical connection between timestamps, structure copies and

compensation.

### The source permits sharing an older-but-fresh dependency, so Snapshot cannot mean all sensors measured at one instant. When you review any calculated metric, identify both its direct input and

the retained inputs used to compensate it.

### The code path that supplies this copy lives in acquisition.c:

prepareInputs(). You will read that caller in the acquisition pass (p. 341).

REMEMBER

A copied dependency is
stable, but it still gets
older. Copying does not
refresh its timestamp.

CHAPTER 13 / WAIT FOR WATER TEMPERATURE

# Separate line timing from temperature interpretation

The long water conversion is implemented above a very short-bit protocol. This header makes the physical bus operations explicit.

### The driver selects one discovered DS18B20; this adapter does not create a task or own the

conversion schedule.

src/hal/onewire_bus.h / lines 1-24
1 // 1-Wire bus adapter (HAL). Work package WP2 (with DS18B20).
2 // Externally powered DS18B20 on BOARD_PIN_ONE_WIRE (4.7 kOhm pull-up). 3 //
4 // Bit-banged, open-drain GPIO (the pin only pulls low; the pull-up drives 5 // high). Standard-speed timing from the DS18B20 datasheet (slot 70 us). 6 // Each time slot runs with interrupts off on this core for at most ~70 us; 7 // the reset's 480 us low phase runs with interrupts on.
8 // Worst-case blocking: reset ~1 ms, one byte ~0.6 ms, search ~15 ms.
9 // No parasite power: there is no strong pull-up.
10 // WP7: do not run a 1-Wire transaction on the core that services the HC-SR04 11 // echo ISR while an echo is in flight - a masked edge is timestamped late 12 // (up to ~70 us, ~1 cm).
13 #pragma once
14 #include <stdbool.h>
15 #include <stddef.h>
16 #include <stdint.h>

17
18 // Treat the members as private to onewire_bus.c. Initialise with ONE_WIRE_BUS_INIT. 19 typedef struct OneWireBus {
20 int8_t pin_;
21 } OneWireBus;

22
23 #define ONE_WIRE_BUS_INIT {-1}

24

### OneWireBus stores the assigned pin. Begin configures the electrical mode; Reset detects

presence; byte functions encode timed bits; SearchFirst obtains one ROM identifier; Select addresses that device.

CHAPTER 13 / WAIT FOR WATER TEMPERATURE

### Separate line timing from temperature interpretation / continued

src/hal/onewire_bus.h / lines 25-34
25 // false if the pin is not a usable GPIO; the bus then stays unusable.
26 bool oneWireBusBegin(OneWireBus* bus, int8_t pin); oneWireBusBegin
27 // true = presence pulse detected. false also if the bus does not idle high 28 // (shorted to GND or missing pull-up).
29 bool oneWireBusReset(OneWireBus* bus); oneWireBusReset
30 void oneWireBusWriteByte(OneWireBus* bus, uint8_t value); oneWireBusWriteByte
31 uint8_t oneWireBusReadByte(OneWireBus* bus); oneWireBusReadByte
32 // Search ROM [F0h] for the first device (lowest branch at each discrepancy). 33 // Does its own reset. true if a code with a valid CRC was read into rom.
34 bool oneWireBusSearchFirst(OneWireBus* bus, uint8_t rom[8]); oneWireBusSearchFirst

src/hal/onewire_bus.h / lines 35-37
35 // Match ROM [55h] + code. Call right after a successful reset. 36 void oneWireBusSelect(OneWireBus* bus, const uint8_t rom[8]); oneWireBusSelect 37 uint8_t oneWireBusCrc8(const uint8_t* data, size_t len); oneWireBusCrc8

### CRC is exposed here for callers but implemented in the pure codec. A successful bus reset

means a presence response was observed, not that a new temperature conversion has finished. Those milestones remain separate throughout the driver.

CHAPTER 13 / WAIT FOR WATER TEMPERATURE

# Name the bit-slot timing before producing pulses

Read these microsecond slots carefully. They explain why the acquisition scheduler later keeps 1-Wire work away from an ultrasonic echo window.

The critical sections protect slot timing; the rest intervals are kept outside when possible.

src/hal/onewire_bus.c / lines 1-28
1 #include "hal/onewire_bus.h"

2
3 #include <Arduino.h>
4 #include <driver/gpio.h>
5 #include <string.h>

6
7 #include "domain/ds18b20_codec.h"

8
9 // ESP32-S3 GPIO numbers run 0-48.
10 static const int8_t kMaxGpio = 48;

11
12 static const uint8_t kCmdSearchRom = 0xF0;
13 static const uint8_t kCmdMatchRom = 0x55;

14
15 // Slot timing (us), DS18B20 datasheet AC characteristics: tSLOT 60-120, 16 // tLOW1 1-15, tLOW0 60-120, tRDV 15, tREC >= 1, tRSTL/tRSTH >= 480,
17 // presence low starts 15-60 us after release and lasts 60-240 us.
18 enum {
19 | kResetLowUs = 480,
20 | kPresenceSampleUs = 70,
21 | kResetHighRestUs = 410, | // 70 + 410 = tRSTH
22 | kWrite1LowUs = 6,
23 | kWrite1RestUs = 64,
24 | kWrite0LowUs = 60,
25 | kWrite0RestUs = 10,
26 | kReadLowUs = 3,
27 | kReadSampleUs = 10, | // sampled 13 us into the slot, inside tRDV
28 | kReadRestUs = 53

### The constants express reset low time, presence sampling, write-one and write-zero low

durations, and read sampling. A logical one and zero differ in pulse timing rather than in a stored byte sent to a hardware UART.

CHAPTER 13 / WAIT FOR WATER TEMPERATURE

### Name the bit-slot timing before producing pulses / continued

src/hal/onewire_bus.c / lines 29-34

29 };

30
31 // Interrupts off for one slot only (bit timing must not be stretched).
32 static portMUX_TYPE s_mux = portMUX_INITIALIZER_UNLOCKED;

33
34 static inline void busLow(const OneWireBus* bus) { gpio_set_level((gpio_num_t)bus->pin_, busLow > 0); }

src/hal/onewire_bus.c / lines 35-38
35 static inline void busRelease(const OneWireBus* bus) { busRelease > gpio_set_level((gpio_num_t)bus->pin_, 1); }
36 static inline bool busLevel(const OneWireBus* bus) { busLevel 37 return gpio_get_level((gpio_num_t)bus->pin_) != 0;

38 }

busLow actively pulls the open-drain line low. busRelease writes the released state, allowing the external pull-up to make it high. Reading the level therefore observes the shared line, not merely the controller's last requested output.

CHAPTER 13 / WAIT FOR WATER TEMPERATURE

# Configure open-drain operation and detect presence

src/hal/onewire_bus.c / lines 39-66

39
40 bool oneWireBusBegin(OneWireBus* bus, int8_t pin) { oneWireBusBegin
41 | bus->pin_ = -1;
42 | if (pin < 0 || pin > kMaxGpio) return false;
43 | gpio_config_t io;
44 | memset(&io, 0, sizeof(io));
45 | io.pin_bit_mask = 1ULL << (uint8_t)pin;
46 | io.mode = GPIO_MODE_INPUT_OUTPUT_OD; | // drive low or
> | release; read back the line
47 | io.pull_up_en = GPIO_PULLUP_DISABLE; | // external 4.7 kOhm
> | to 3.3 V
48 | io.pull_down_en = GPIO_PULLDOWN_DISABLE;
49 | io.intr_type = GPIO_INTR_DISABLE;
50 | if (gpio_config(&io) != ESP_OK) return false;
51 | bus->pin_ = pin;
52 | busRelease(bus); busRelease
53 | return true;

54 }

55
56 bool oneWireBusReset(OneWireBus* bus) { oneWireBusReset
57 | if (bus->pin_ < 0) return false;
58 | busRelease(bus); busRelease
59 | if (!busLevel(bus)) return false; | // stuck low: short or busLevel
> | no pull-up
60 | busLow(bus); busLow
61 | delayMicroseconds(kResetLowUs);
62 | portENTER_CRITICAL(&s_mux); portENTER_CRITICAL
63 | busRelease(bus); busRelease
64 | delayMicroseconds(kPresenceSampleUs);
65 | const bool presence = !busLevel(bus); busLevel
66 | portEXIT_CRITICAL(&s_mux); portEXIT_CRITICAL

### Begin rejects an invalid pin before configuring input/output open-drain mode. It disables internal pulls because the board uses an

external pull-up, then releases the line.

src/hal/onewire_bus.c / lines 67-69
67 | delayMicroseconds(kResetHighRestUs);
68 | return presence;

69 }

Reset first rejects a stuck-low idle line. It generates a reset pulse,

### releases the line and samples for a low presence response within a protected interval. The function returns that observed presence, not

a decoded ROM or temperature.

COMMON PITFALL

Timing protection on this
core can delay other
edge-sensitive work. A
short protocol slot is still a real interruption to other handlers.

CHAPTER 13 / WAIT FOR WATER TEMPERATURE

# Transmit and sample one bit in bounded steps

src/hal/onewire_bus.c / lines 70-90

70
71 static void writeBit(OneWireBus* bus, bool bit) { writeBit
72 | portENTER_CRITICAL(&s_mux); portENTER_CRITICAL
73 | busLow(bus); busLow
74 | delayMicroseconds(bit ? kWrite1LowUs : kWrite0LowUs);
75 | busRelease(bus); busRelease
76 | portEXIT_CRITICAL(&s_mux); portEXIT_CRITICAL
77 | delayMicroseconds(bit ? kWrite1RestUs : kWrite0RestUs);

78 }

79
80 static bool readBit(OneWireBus* bus) { readBit
81 | portENTER_CRITICAL(&s_mux); portENTER_CRITICAL
82 | busLow(bus); busLow
83 | delayMicroseconds(kReadLowUs);
84 | busRelease(bus); busRelease
85 | delayMicroseconds(kReadSampleUs);
86 | const bool bit = busLevel(bus); busLevel
87 | portEXIT_CRITICAL(&s_mux); portEXIT_CRITICAL
88 | delayMicroseconds(kReadRestUs);
89 | return bit;

90 }

writeBit chooses the low duration from the intended bit, releases the line, exits the critical section and waits the remaining slot time. readBit pulls low briefly, releases, waits to its sample point and records the shared level.

The protected portion covers the edge-to-sample relationship. The trailing rest is outside the critical section. This reduces how long interrupts are masked, but the caller still spends elapsed microseconds completing each slot.

CHAPTER 13 / WAIT FOR WATER TEMPERATURE

# Build bytes in least-significant-bit order

src/hal/onewire_bus.c / lines 91-104

91
92 void oneWireBusWriteByte(OneWireBus* bus, uint8_t value) { oneWireBusWriteByte
93 | if (bus->pin_ < 0) return;
94 | for (uint8_t i = 0; i < 8; ++i) writeBit(bus, (value >> i) & 1u); | // LSB first writeBit

95 }

96
97 uint8_t oneWireBusReadByte(OneWireBus* bus) { oneWireBusReadByte
98 | if (bus->pin_ < 0) return 0xFF;
99 | uint8_t value = 0;
100 | for (uint8_t i = 0; i < 8; ++i) {
101 | if (readBit(bus)) value |= (uint8_t)(1u << i); readBit
102 | }
103 | return value;

104 }

WriteByte shifts the source byte right by the bit index and sends its lowest bit. ReadByte tests

### each sampled bit and ORs 1u << i into the destination. This device protocol sends the

least-significant bit first.

An unassigned read returns 0xFF in this implementation. That sentinel can also be ordinary data, so the higher-level presence and CRC checks are necessary. Do not interpret one byte alone as a complete health verdict.

CHAPTER 13 / WAIT FOR WATER TEMPERATURE

# Resolve one branch of the ROM search

src/hal/onewire_bus.c / lines 105-123

106 bool oneWireBusSearchFirst(OneWireBus* bus, uint8_t rom[8]) { oneWireBusSearchFirst if (!oneWireBusReset(bus)) return false; oneWireBusReset
oneWireBusWriteByte(bus, kCmdSearchRom); oneWireBusWriteByte
uint8_t id[8] = {0};
for (uint8_t i = 0; i < 64; ++i) {
const bool bit = readBit(bus); readBit
const bool complement = readBit(bus); readBit
113 | if (bit && complement) return false; | // no device took part
// Different: every device has `bit` here. Equal (both 0): devices differ, // take the 0 branch, which is the first device in search order.
const bool direction = bit != complement ? bit : false;
if (direction) id[i / 8] |= (uint8_t)(1u << (i % 8));
| writeBit(bus, direction); writeBit

}
| if (oneWireCrc8(id, 7) != id[7]) return false; oneWireCrc8
| memcpy(rom, id, 8);
| return true;

123 }

### For each ROM position, the adapter reads a bit and its complement. Two ones mean no participating device; differing values select the available bit; two zeros mean competing

devices, so this implementation deliberately follows the zero branch.

It writes that choice back to keep only matching devices in the search. After 64 positions it validates the ROM CRC before copying the temporary identifier to the caller. SearchFirst finds one device in this policy, not every device on a multi-drop bus.

CHAPTER 13 / WAIT FOR WATER TEMPERATURE

# Address the chosen device explicitly

src/hal/onewire_bus.c / lines 124-130

124
125 void oneWireBusSelect(OneWireBus* bus, const uint8_t rom[8]) { oneWireBusSelect
126 | oneWireBusWriteByte(bus, kCmdMatchRom); oneWireBusWriteByte
127 | for (uint8_t i = 0; i < 8; ++i) oneWireBusWriteByte(bus, rom[i]); oneWireBusWriteByte

128 }

129
130 uint8_t oneWireBusCrc8(const uint8_t* data, size_t len) { return oneWireCrc8(data, len); oneWireBusCrc8 | oneWireCrc8
> | }

Select sends Match ROM and all eight identifier bytes so later commands address the selected

### sensor. The CRC wrapper reuses the domain implementation rather than keeping a second

private algorithm.

The adapter knows bytes and bus timing. The DS18B20 driver must still check family identity, configuration resolution, conversion timing and the scratchpad result. This boundary keeps physical timing separate from temperature acceptance.

CHAPTER 13 / WAIT FOR WATER TEMPERATURE

# Define what a valid DS18B20 record means

### The codec names the scratchpad layout and numerical interpretation without depending on

ESP32 hardware.

These functions are suitable for known-byte tests on a PC.

src/domain/ds18b20_codec.h / lines 1-24
1 // DS18B20 scratchpad decoding and 1-Wire CRC (WP2). Pure C, host-tested.
2 // Datasheet: Maxim DS18B20 (local copy in Electrical System Study/Datasheets/ 3 // DS18B20.pdf): Figure 9 (memory map), Figure 10 (configuration register), 4 // Table 1 (temperature format), "CRC Generation".
5 #pragma once
6 #include <stdbool.h>
7 #include <stddef.h>
8 #include <stdint.h>

9
10 #define DS18B20_FAMILY_CODE 0x28
11 #define DS18B20_SCRATCHPAD_LEN 9
12 #define DS18B20_POWER_ON_RAW ((int16_t)0x0550) | // +85 degC, reset value of the register
13 #define DS18B20_CONFIG_12BIT 0x7F | // R1 = R0 = 1, reserved bits as read
14 #define DS18B20_MIN_C (-55.0f)
15 #define DS18B20_MAX_C 125.0f

16
17 // Dallas/Maxim CRC-8 (x^8 + x^5 + x^4 + 1), LSB first, init 0. Running it over 18 // data plus its CRC byte gives 0.
19 uint8_t oneWireCrc8(const uint8_t* data, size_t len); oneWireCrc8

20
21 // ROM code: CRC over the first 7 bytes matches byte 7 and the family is 28h. 22 // Rejects the all-zero code a bus stuck low produces.
23 bool ds18b20RomValid(const uint8_t rom[8]); ds18b20RomValid

24

The constants name the family code, scratchpad size, chosen resolution, power-on raw value and application limits. The validation declarations distinguish ROM validity from scratchpad validity.

CHAPTER 13 / WAIT FOR WATER TEMPERATURE

### Define what a valid DS18B20 record means / continued

src/domain/ds18b20_codec.h / lines 25-35
25 // Scratchpad CRC matches AND the configuration register has its fixed bits 26 // (bit 7 = 0, bits 0-4 = 1). The second check rejects an all-zero read (bus 27 // stuck low), whose CRC is also 0.
28 bool ds18b20ScratchpadValid(const uint8_t scratchpad[DS18B20_SCRATCHPAD_LEN]); ds18b20ScratchpadValid

29
30 // True if the configuration register selects 12-bit resolution.
31 bool ds18b20Is12Bit(uint8_t config); ds18b20Is12Bit

32
33 // Signed temperature register (bytes 0-1), 1/16 degC per LSB at 12 bits.
34 int16_t ds18b20RawTemperature(const uint8_t scratchpad[DS18B20_SCRATCHPAD_LEN]); ds18b20RawTemperature 35 float ds18b20RawToDegC(int16_t raw); ds18b20RawToDegC

RawTemperature returns a signed integer; RawToDegC supplies its 1/16-degree scale. Keeping

### these steps separate makes endianness, signedness and scale individually inspectable. The

driver decides when those bytes may be read and whether a reset-like value is acceptable here.

CHAPTER 13 / WAIT FOR WATER TEMPERATURE

# Advance the CRC one incoming bit at a time

### Follow the bytes through CRC, configuration validation and a signed temperature. No RTOS

state is involved in this file.

Use the worked 0x0190 value from the lesson to check the final two functions.

src/domain/ds18b20_codec.c / lines 1-15
1 #include "domain/ds18b20_codec.h"

2
3 uint8_t oneWireCrc8(const uint8_t* data, size_t len) { oneWireCrc8
4 | uint8_t crc = 0;
5 | for (size_t i = 0; i < len; ++i) {
6 | uint8_t in = data[i];
7 | for (uint8_t b = 0; b < 8; ++b) {
8 | const uint8_t mix = (crc ^ in) & 0x01;
9 | crc >>= 1;
10 | if (mix) crc ^= 0x8C; | // reflected 0x31
11 | in >>= 1;
12 | }
13 | }
14 | return crc;

15 }

The accumulator begins at zero. Each iteration combines the next incoming bit with the CRC's low bit, shifts the CRC and conditionally XORs the reflected polynomial. The input byte shifts right so the next bit becomes available.

This is deterministic processing of supplied bytes. It does not read the 1-Wire line. If a received scratchpad changes one protected byte, recalculating this code and comparing its check byte can expose the corruption.

CHAPTER 13 / WAIT FOR WATER TEMPERATURE

# Check structure before interpreting signed temperature

src/domain/ds18b20_codec.c / lines 16-32

16
17 bool ds18b20RomValid(const uint8_t rom[8]) { ds18b20RomValid
18 return rom[0] == DS18B20_FAMILY_CODE && oneWireCrc8(rom, 7) == rom[7]; oneWireCrc8

19 }

20
21 bool ds18b20ScratchpadValid(const uint8_t scratchpad[DS18B20_SCRATCHPAD_LEN]) { ds18b20ScratchpadValid
22 | if (oneWireCrc8(scratchpad, 8) != scratchpad[8]) return false; oneWireCrc8
23 | return (scratchpad[4] & 0x9F) == 0x1F;

24 }

25
26 bool ds18b20Is12Bit(uint8_t config) { return (config & 0x60) == 0x60; } ds18b20Is12Bit

27
28 int16_t ds18b20RawTemperature(const uint8_t scratchpad[DS18B20_SCRATCHPAD_LEN]) { ds18b20RawTemperature
29 return (int16_t)(uint16_t)((uint16_t)scratchpad[1] << 8 | scratchpad[0]);

30 }

31
32 float ds18b20RawToDegC(int16_t raw) { return (float)raw / 16.0f; } ds18b20RawToDegC

ROM validation checks family and CRC. Scratchpad validation checks its CRC and the expected configuration-bit pattern. Resolution checking then determines whether the selected twelve-bit mode is active.

### RawTemperature combines high and low bytes into uint16_t before interpreting the signed

pattern as int16_t on this target. RawToDegC divides by 16. For raw = 400, the result is 25.0; for raw = -160, it is -10.0. The reset-value policy remains in the driver, not hidden in the arithmetic helper.

CHAPTER 13 / WAIT FOR WATER TEMPERATURE

# Read the conversion and reset assumptions

The driver holds a selected ROM, pending-conversion time and one retained temperature result. The header also explains the intended short blocking cost of each bus action.

The retained supply keeps this sensor available in the project's low-power sensor set.

src/drivers/ds18b20.h / lines 1-28
1 // ds18b20 driver. Work package WP2 (Stage 2). Architecture §7, §14.
2 // Datasheet: Maxim DS18B20 (local copy in Electrical System Study/Datasheets/ 3 // DS18B20.pdf). Domain math (CRC, decoding) in domain/ds18b20_codec.h.
4 //
5 // Retained 3.3 V supply (external power, no parasite mode), 1-Wire on GPIO14 6 // with a 4.7 kOhm pull-up. Produces WaterTemperature in degC.
7 //
8 // init() finds the first device with Search ROM, checks the ROM CRC and the 9 // family code (28h) and keeps that ROM: every later transaction uses Match 10 // ROM, so a second device on the bus is never read by mistake. It then reads 11 // the scratchpad and, if the EEPROM selected a lower resolution, writes 12-bit 12 // to the scratchpad only (no Copy Scratchpad: no EEPROM wear, re-applied on 13 // every init).
14 // start() sends Convert T and returns; poll() is Pending until
15 // CFG_DS18B20_CONVERSION_MAX_MS (750 ms, 12-bit tCONV max) has passed, then 16 // reads the 9-byte scratchpad once.

17 //
18 // Results, highest priority first (poll() returns READY for all of them):
19 // | scratchpad CRC or fixed config bits wrong -> HEALTH_FAULT, no raw
20 // | temperature register = 0550h (+85 degC power-on value) -> HEALTH_FAULT;
21 // | | the device reset without converting, so the next start()
22 // | | fails and init() re-applies the resolution
23 // | outside -55..+125 degC -> HEALTH_FAULT
24 // | otherwise | -> value in degC, HEALTH_OK
25 // raw = temperature register (1/16 degC) whenever the CRC is good.
26 // No presence pulse in start()/poll() -> DRIVER_NOT_PRESENT (re-init needed). 27 // Before the first result readResult() gives HEALTH_STARTING, never 0 degC.

28 //

The contract states the externally supplied operating mode and conversion allowance. It also describes why the power-on temperature register value is rejected for this water application.

src/drivers/ds18b20.h / lines 29-30
29 // Worst-case blocking (1-Wire HAL; slots run with interrupts off <= 70 us each):
30 // | init() | ~50 ms | (search ~15 ms, scratchpad read ~12 ms, and when the

A hardware datasheet can permit a value that the application treats as a diagnostic sign under its expected operating range. Keep that distinction explicit: the driver is enforcing this controller's policy, not redefining the device's universal capability.

CHAPTER 13 / WAIT FOR WATER TEMPERATURE

# Keep address selection and result history across calls

src/drivers/ds18b20.h / lines 31-57
31 // | | | resolution must be set: write ~9 ms + re-read ~12 ms)
32 // | start() | ~7 ms | (reset, Match ROM, Convert T)
33 // | poll() | ~12 ms | once the conversion time is over (reset, Match ROM,
34 // | | | Read Scratchpad, 9 bytes); Pending polls: none
35 // | others | none

36 //
37 // Implements the SensorDriver contract in drivers/sensor_driver.h. 38 #pragma once
39 #include "drivers/sensor_driver.h"
40 #include "hal/onewire_bus.h"

41
42 typedef struct Ds18b20Config {
43 | OneWireBus* bus; | // already begun on BOARD_PIN_ONE_WIRE
44 } Ds18b20Config;

45
46 // Members after `base` are private to ds18b20.c.
47 typedef struct Ds18b20Driver {
48 | SensorDriver base; | // must stay first
49 | Ds18b20Config config_;
50 | bool initialised_;
51 | bool busy_;
52 | bool hasRom_;
53 | uint8_t rom_[8];
54 | MonoMs startMs_;
55 | Reading result_;
56 } Ds18b20Driver;

57

The configuration points to an existing OneWireBus. The object retains ROM identity, whether

### discovery succeeded, lifecycle flags, start time and a result. GetRom copies the selected

identifier for diagnostics rather than returning writable internal storage.

src/drivers/ds18b20.h / lines 58-62
58 // Constructor. Use &driver.base wherever a SensorDriver* is expected.
59 void ds18b20DriverConstruct(Ds18b20Driver* self, const Ds18b20Config* config); ds18b20DriverConstruct

60
61 // ROM code selected by the last successful init(). false before that.
62 bool ds18b20DriverGetRom(const Ds18b20Driver* self, uint8_t rom[8]); ds18b20DriverGetRom

### As with light, the base member is first. Construction supplies generic dispatch, and init

performs actual discovery. A later reinit can select a device again without reconstructing the whole task.

CHAPTER 13 / WAIT FOR WATER TEMPERATURE

# Choose one device before every addressed operation

Now join the timed bus primitives with the conversion lifecycle. The important order is select, convert, leave, return and validate.

The first successful init establishes the addressed sensor and its resolution.

src/drivers/ds18b20.c / lines 1-26
1 #include "drivers/ds18b20.h"

2
3 #include <string.h>

4
5 #include "app_config.h"
6 #include "domain/ds18b20_codec.h"

7
8 static const uint8_t kCmdConvertT = 0x44;
9 static const uint8_t kCmdReadScratchpad = 0xBE;
10 static const uint8_t kCmdWriteScratchpad = 0x4E;

11
12 static inline Ds18b20Driver* asDs18b20(SensorDriver* d) { return (Ds18b20Driver*)d; } asDs18b20

13
14 static void finish(Ds18b20Driver* self, const uint8_t sp[DS18B20_SCRATCHPAD_LEN], MonoMs finish > now);

15
16 // No presence pulse: publish a FAULT verdict, as the other drivers do, so the
17 // last OK reading is not served as current. lastGoodMs keeps its value.
18 static void markNotPresent(Ds18b20Driver* self, MonoMs start, MonoMs now) { markNotPresent
19 | Reading* r = &self->result_;
20 | r->intervalStartMs = start;
21 | r->intervalEndMs = now;
22 | r->qualityFlags = kQualityNone;
23 | r->hasRaw = false;
24 | r->health = HEALTH_FAULT;

25 }

26

### markNotPresent records a failed observation interval without pretending zero degrees was

measured. The identity helpers provide generic metadata. selectDevice requires a discovered ROM, resets the bus and sends Match ROM before the next command.

src/drivers/ds18b20.c / lines 27-35
27 static SensorId ds18b20Id(const SensorDriver* d) { (void)d; return SENSOR_DS18B20; } ds18b20Id 28 static const char* ds18b20Name(const SensorDriver* d) { (void)d; return "ds18b20"; } ds18b20Name 29 static uint8_t ds18b20MetricCount(const SensorDriver* d) { (void)d; return 1; } ds18b20MetricCount

30
31 // Reset + Match ROM. false if no presence pulse.
32 static bool selectDevice(Ds18b20Driver* self) { selectDevice
33 | OneWireBus* bus = self->config_.bus;
34 | if (!oneWireBusReset(bus)) return false; oneWireBusReset
35 | oneWireBusSelect(bus, self->rom_); oneWireBusSelect

CHAPTER 13 / WAIT FOR WATER TEMPERATURE

### Choose one device before every addressed operation / continued

src/drivers/ds18b20.c / lines 36-48
36 return true;

37 }

38
39 // Read all 9 scratchpad bytes. false if no presence pulse; the content is
40 // checked by the caller.
41 static bool readScratchpad(Ds18b20Driver* self, uint8_t sp[DS18B20_SCRATCHPAD_LEN]) { readScratchpad
42 | if (!selectDevice(self)) return false; selectDevice
43 | oneWireBusWriteByte(self->config_.bus, kCmdReadScratchpad); oneWireBusWriteByte
44 | for (uint8_t i = 0; i < DS18B20_SCRATCHPAD_LEN; ++i) {
45 | sp[i] = oneWireBusReadByte(self->config_.bus); oneWireBusReadByte
46 | }
47 | return true;

48 }

readScratchpad then requests the scratchpad and obtains all bytes. It reports transport-level success here; the codec validation performed by its callers decides whether those bytes can be trusted.

CHAPTER 13 / WAIT FOR WATER TEMPERATURE

# Discover, validate and establish resolution

src/drivers/ds18b20.c / lines 49-74

50 static DriverStatus ds18b20Init(SensorDriver* d) { ds18b20Init Ds18b20Driver* self = asDs18b20(d); asDs18b20
self->initialised_ = false;
self->busy_ = false;
if (self->config_.bus == 0) return DRIVER_FAULT;

uint8_t rom[8];
if (!oneWireBusSearchFirst(self->config_.bus, rom)) return DRIVER_NOT_PRESENT; oneWireBusSearchFirst
58 | if (!ds18b20RomValid(rom)) return DRIVER_NOT_PRESENT; | // not a DS18B20 ds18b20RomValid
memcpy(self->rom_, rom, sizeof(rom));
self->hasRom_ = true;

uint8_t sp[DS18B20_SCRATCHPAD_LEN]; if (!readScratchpad(self, sp)) return DRIVER_NOT_PRESENT; readScratchpad
if (!ds18b20ScratchpadValid(sp)) return DRIVER_FAULT; ds18b20ScratchpadValid
if (!ds18b20Is12Bit(sp[4])) { ds18b20Is12Bit
// TH and TL are written back unchanged; the scratchpad only, not EEPROM. if (!selectDevice(self)) return DRIVER_NOT_PRESENT; selectDevice
oneWireBusWriteByte(self->config_.bus, kCmdWriteScratchpad); oneWireBusWriteByte
oneWireBusWriteByte(self->config_.bus, sp[2]); oneWireBusWriteByte
oneWireBusWriteByte(self->config_.bus, sp[3]); oneWireBusWriteByte
oneWireBusWriteByte(self->config_.bus, DS18B20_CONFIG_12BIT); oneWireBusWriteByte
if (!readScratchpad(self, sp)) return DRIVER_NOT_PRESENT; readScratchpad
73 | if (!ds18b20ScratchpadValid(sp) || !ds18b20Is12Bit(sp[4])) return DRIVER_FAULT; ds18b20ScratchpadValid | ds18b20Is12Bit

}

Init clears active state, searches one ROM and rejects the wrong family or bad identifier CRC. It copies the selected address only after that check. It then reads and validates the scratchpad.

src/drivers/ds18b20.c / lines 75-77
self->initialised_ = true; return DRIVER_OK;

77 }

If the resolution differs, it writes the desired configuration while preserving the existing alarm bytes, rereads and verifies the result. It does not burn EEPROM merely to establish this runtime configuration. The final true assignment means these setup conditions were satisfied.

CHAPTER 13 / WAIT FOR WATER TEMPERATURE

# Begin physical work after selection succeeds

src/drivers/ds18b20.c / lines 78-91

79 static DriverStatus ds18b20Start(SensorDriver* d, MonoMs now) { ds18b20Start Ds18b20Driver* self = asDs18b20(d); asDs18b20
if (!self->initialised_) return DRIVER_FAULT;
if (!selectDevice(self)) { selectDevice
self->initialised_ = false; markNotPresent(self, now, now); markNotPresent
return DRIVER_NOT_PRESENT;

}
oneWireBusWriteByte(self->config_.bus, kCmdConvertT); oneWireBusWriteByte
self->startMs_ = now;
self->busy_ = true;
return DRIVER_OK;

91 }

Start rejects uninitialised state, selects the device, writes Convert T and stores the start time. Selection failure marks a failed observation and requires recovery.

### Returning OK does not claim a temperature is ready. It says the caller can now manage a pending conversion using startMs_. No traffic is needed on this bus during the conversion

allowance in this implementation.

CHAPTER 13 / WAIT FOR WATER TEMPERATURE

# Use the deadline to decide when to read

src/drivers/ds18b20.c / lines 92-116

93 static PollResult ds18b20Poll(SensorDriver* d, MonoMs now) { ds18b20Poll Ds18b20Driver* self = asDs18b20(d); asDs18b20
PollResult r = {DRIVER_FAULT, now};
if (!self->busy_) return r;

// Fixed worst-case conversion time: no bus traffic while converting. const MonoMs due = self->startMs_ + CFG_DS18B20_CONVERSION_MAX_MS; if (now < due) {
r.status = DRIVER_PENDING;
r.nextPollMs = due;
return r;

}
self->busy_ = false;
uint8_t sp[DS18B20_SCRATCHPAD_LEN]; if (!readScratchpad(self, sp)) { readScratchpad
self->initialised_ = false; markNotPresent(self, self->startMs_, now); markNotPresent
r.status = DRIVER_NOT_PRESENT; return r;

}
finish(self, sp, now); finish
r.status = DRIVER_READY;
return r;

116 }

### Before start+750ms, the function returns PENDING with that exact due time. It does not

repeatedly probe completion bits. At or after due, it ends busy state and requests a scratchpad.

A failed read reports not-present and forces later init. A completed read passes through finish,

### which may produce a health fault even though the operation returns READY. This is the

concrete driver-status versus observation-health distinction.

CHAPTER 13 / WAIT FOR WATER TEMPERATURE

# Reject reset-like and corrupt results before acceptance

src/drivers/ds18b20.c / lines 117-144

118 static void finish(Ds18b20Driver* self, const uint8_t sp[DS18B20_SCRATCHPAD_LEN], MonoMs finish
> | now) {
| Reading* r = &self->result_;
r->intervalStartMs = self->startMs_;
| r->intervalEndMs = now;
r->qualityFlags = kQualityNone;
| r->hasRaw = false;

// READY in every case below: health carries the verdict.
| if (!ds18b20ScratchpadValid(sp)) { ds18b20ScratchpadValid
127 | r->health = HEALTH_FAULT; | // corrupted read; the content is not trusted
| return;

}
const int16_t raw = ds18b20RawTemperature(sp); ds18b20RawTemperature
| r->hasRaw = true;
| r->raw = raw;
if (raw == DS18B20_POWER_ON_RAW) {
// The register still holds its reset value: the device restarted and did // not convert. Water never reads exactly +85 degC here.
| r->health = HEALTH_FAULT;
137 | self->initialised_ = false; | // re-apply the resolution
| return;

}
const float degC = ds18b20RawToDegC(raw); ds18b20RawToDegC
if (degC < DS18B20_MIN_C || degC > DS18B20_MAX_C) {
| r->health = HEALTH_FAULT;
| return;

}

finish stamps interval fields and initially clears raw availability. CRC/config validation must pass

### before the signed raw value is stored. The power-on raw value then triggers a fault and

reinitialisation in this application.

src/drivers/ds18b20.c / lines 145-149
r->value = degC;
r->health = HEALTH_OK;
r->lastGoodMs = now;
++r->sequence;

149 }

Only an in-range conversion reaches value, OK, lastGoodMs and the driver's usable sequence increment. A failure can preserve an old numeric value in the record while changing health. A consumer must not ignore that new verdict.

CHAPTER 13 / WAIT FOR WATER TEMPERATURE

# Copy, cancel and require setup again

src/drivers/ds18b20.c / lines 150-162

150
151 static uint8_t ds18b20ReadResult(SensorDriver* d, Reading* out, uint8_t maxOut) { ds18b20ReadResult
152 | if (maxOut < 1) return 0;
153 | out[0] = asDs18b20(d)->result_; asDs18b20
154 | return 1;

155 }

156
157 // A conversion in progress finishes on its own; its result is never read.
158 static void ds18b20Cancel(SensorDriver* d) { asDs18b20(d)->busy_ = false; } ds18b20Cancel | asDs18b20

159
160 // Retained rail, and the open-drain pin only ever releases the line between 161 // slots: nothing to drive. Drop any pending conversion.
162 static void ds18b20PreparePowerOff(SensorDriver* d) { ds18b20Cancel(d); } ds18b20PreparePowerOff | ds18b20Cancel

readResult respects the caller's one-record capacity. Cancel drops the pending flag. PreparePowerOff also clears initialisation, so a later permitted use must rediscover or verify the sensor.

### The functions contain no queue calls. The same completed Reading can be collected by the

isolated harness or production acquisition. That reuse is possible because the driver reports outcomes rather than owning system policy.

CHAPTER 13 / WAIT FOR WATER TEMPERATURE

# Construct the instance and expose a ROM copy

src/drivers/ds18b20.c / lines 163-186

163
164 static const SensorDriverOps kDs18b20Ops = {
165 | .id = ds18b20Id,
166 | .name = ds18b20Name,
167 | .metricCount = ds18b20MetricCount,
168 | .init = ds18b20Init,
169 | .start = ds18b20Start,
170 | .poll = ds18b20Poll,
171 | .readResult = ds18b20ReadResult,
172 | .cancel = ds18b20Cancel,
173 | .preparePowerOff = ds18b20PreparePowerOff,

174 };

175
176 void ds18b20DriverConstruct(Ds18b20Driver* self, const Ds18b20Config* config) { ds18b20DriverConstruct
177 | self->base.ops = &kDs18b20Ops;
178 | self->config_ = *config;
179 | self->initialised_ = false;
180 | self->busy_ = false;
181 | self->hasRom_ = false;
182 | memset(self->rom_, 0, sizeof(self->rom_));
183 | self->startMs_ = 0;
184 | readingReset(&self->result_, SENSOR_DS18B20, METRIC_WATER_TEMPERATURE, UNIT_DEG_C); readingReset

185 }

186

The operations table ties the lifecycle together. Construction clears ROM and state and resets one water-temperature Reading. GetRom returns false until an address exists, otherwise copies eight bytes into caller storage.

src/drivers/ds18b20.c / lines 187-191
187 bool ds18b20DriverGetRom(const Ds18b20Driver* self, uint8_t rom[8]) { ds18b20DriverGetRom
188 | if (!self->hasRom_) return false;
189 | memcpy(rom, self->rom_, sizeof(self->rom_));
190 | return true;

191 }

The returned boolean is the condition under which that diagnostic buffer is new. The caller should compare or print it only after success. The production path does not need to expose the driver object itself to other tasks.

CHAPTER 13 / WAIT FOR WATER TEMPERATURE

# Remember which identity was already printed

This test adds a ROM observer to the shared harness so discovery and temperature are visible without a full system boot.

The observer runs in the driver-owning harness task after results complete.

test/bringup/ds18b20_main.c / lines 1-28
1 // Bring-up entry point for ds18b20 (WP2). pio run -e test_ds18b20 -t upload -t monitor 2 // Retained 3.3 V supply, DQ on GPIO14 with a 4.7 kOhm pull-up to 3.3 V.
3 // 12-bit conversion (750 ms max) runs inside the 1 s period.
4 // Replaces src/main.c in this env only; links the production driver.
5 //
6 // Prints the selected ROM code once, then one temperature per second. 7 // "init -> NOT_PRESENT": no presence pulse (DQ open, no supply, missing 8 // pull-up) or the first device is not a DS18B20 (family 28h).
9 #include <Arduino.h>
10 #include <stdio.h>
11 #include <string.h>

12
13 #include "app_config.h"
14 #include "board_profile.h" 15 #include "bringup_harness.h" 16 #include "hal/onewire_bus.h"
17 #include "drivers/ds18b20.h"

18
19 static OneWireBus s_bus = ONE_WIRE_BUS_INIT; 20 static Ds18b20Config s_config = {&s_bus};
21 static Ds18b20Driver s_driver;

22
23 // Print the ROM code whenever init() selected a different one. 24 static void printRomIfNew(SensorDriver* driver) { printRomIfNew
25 | (void)driver;
26 | static uint8_t last[8];
27 | static bool printed = false;
28 | uint8_t rom[8];

The callback gets a fresh ROM copy, compares it with a persistent last array and prints only on the first identity or a changed identity. memcmp compares bytes; memcpy updates the retained copy.

CHAPTER 13 / WAIT FOR WATER TEMPERATURE

### Remember which identity was already printed / continued

test/bringup/ds18b20_main.c / lines 29-35
29 | if (!ds18b20DriverGetRom(&s_driver, rom)) return; ds18b20DriverGetRom
30 | if (printed && memcmp(rom, last, sizeof(rom)) == 0) return;
31 | memcpy(last, rom, sizeof(rom));
32 | printed = true;
33 | printf("# ds18b20 ROM %02X-%02X%02X%02X%02X%02X%02X crc %02X\n", rom[0], rom[6],
> | rom[5],
34 | rom[4], rom[3], rom[2], rom[1], rom[7]);

35 }

### The local rom array is safe because the callback finishes using it before returning. The

persistent last array survives later calls. This is a useful example of two different storage durations in one short function.

CHAPTER 13 / WAIT FOR WATER TEMPERATURE

# Supply the callback as data, then start the harness

test/bringup/ds18b20_main.c / lines 36-49

36
37 static BringupContext s_ctx = {&s_driver.base, CFG_FRAME_PERIOD_MS, printRomIfNew};

38
39 void setup(void) { setup
40 | ds18b20DriverConstruct(&s_driver, &s_config); ds18b20DriverConstruct
41 | delay(200);
42 | printf("\n=== bring-up: %s ===\n", sensorDriverName(&s_driver.base)); sensorDriverName
43 | if (!oneWireBusBegin(&s_bus, BOARD_PIN_ONE_WIRE)) { oneWireBusBegin
44 | printf("GPIO%d cannot be used for 1-Wire\n", (int)BOARD_PIN_ONE_WIRE);
45 | }
46 | bringupStart(&s_ctx); bringupStart

47 }

48
49 void loop(void) { vTaskDelay(portMAX_DELAY); } loop | vTaskDelay

The context stores printRomIfNew without calling it. Setup constructs the driver, configures the

### pin and starts the common task. The task later decides when a READY result permits the

callback.

### The diagnostic procedure can distinguish no discovery from CRC rejection or delayed

conversion. If the device reappears with a different ROM, the next successful result can make that change visible without introducing another bus-reading task.

CHAPTER 14 / TURN A PH VOLTAGE INTO A CLAIM

# Undo the divider before applying the fit

### The pH module's output is divided before reaching GPIO7. In this source board profile, the top resistor is 10kOhm and the lower resistor is 15kOhm. The ADC pin therefore sees 15/(10+15)=0.6 of

the module voltage.

Original firmware - src/domain/calibration.c, lines 5-8
float dividerRecoverMv(float adcMv, uint32_t rTopOhm, uint32_t
> | rBottomOhm) {
| if (rBottomOhm == 0) return 0.0f;
| return adcMv * (float)(rTopOhm + rBottomOhm) /
> | (float)rBottomOhm;
}

### If the filtered ADC voltage is 1800mV, recover 1800 x 25/15 = 3000mV at the module. A fit calibrated against module millivolts must use 3000, not 1800. Applying it to the ADC voltage would shift

every pH result even if the line-fitting code were correct.

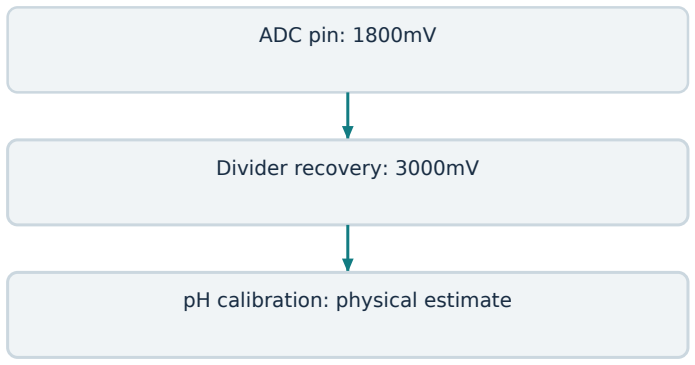
[picture p12: figure]
ADC pin: 1800mV; Divider recovery: 3000mV; pH calibration: physical estimate

The numerical example follows one observation. Calibration is deliberately separate from ADC setup.

The helper guards against a zero bottom resistance before dividing.

### Its parameters are resistor values in ohms, not measured node voltages. The casts make the arithmetic floating-point. The sum and

ratio are then applied to the input voltage.

### The driver takes a spread sample window and filters it before

recovering the module voltage. Filtering reduces selected noise.

### Divider recovery changes the electrical scale. Calibration changes voltage into the reported physical quantity. Keep those operations

separate in your explanation and in your checks.

COMMON PITFALL

A resistor tolerance
changes the real divider
ratio. Nominal recovery is a model; precision work
needs measured ratios or
calibration that absorbs
their effect.

CHAPTER 14 / TURN A PH VOLTAGE INTO A CLAIM

# Fit two known solutions, then test the fit

### Use a worked, invented calibration: the module gives 3000mV in pH7 buffer and 3500mV in pH4 buffer. For a line y=m*x+b, the slope is

(4-7)/(3500-3000)=-0.006 pH/mV. The offset is 7-(-0.006 x 3000)=25.

Worked calibration model - invented points
float ph = -0.006f * moduleMv + 25.0f;
// moduleMv = 3250 -> pH = 5.5

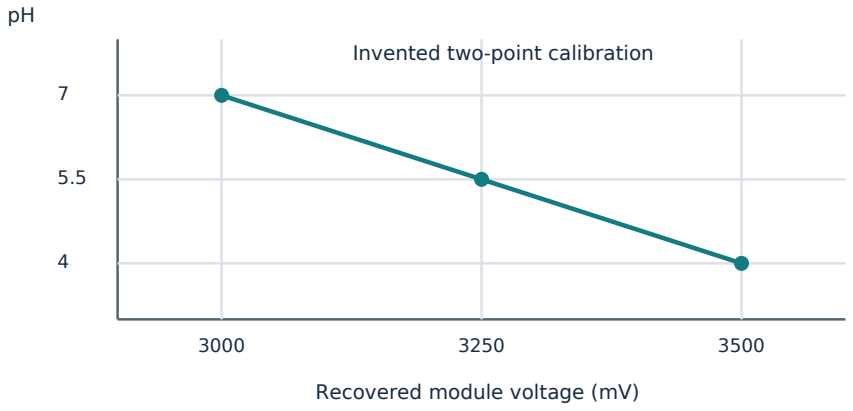
[picture p13: figure]
Recovered module voltage (mV); Invented two-point calibration

Worked calibration points and their midpoint. These are invented data, not probe measurements.

### The negative slope is not a coding mistake in this example: higher module voltage corresponds to lower pH. The sign comes from the measured pair order. Always calculate it rather than choosing a

positive sign because it looks simpler.

COMMON PITFALL

Do not use two readings
from the same solution as
two independent reference
points. A tiny voltage
difference can create an
enormous slope.

CHAPTER 14 / TURN A PH VOLTAGE INTO A CLAIM

### Fit two known solutions, then test the fit / continued

linearFromTwoPoints() rejects non-finite inputs and two x coordinates that are too close. phFitFromBuffers() also requires the buffer pH values to be sufficiently separated and the slope

### magnitude to lie within the project's allowed range. These guards prevent division by an

almost-zero voltage difference and implausible fits.

Two points determine a line; they do not validate it away from those points. A third known

### reference can test whether the chosen model remains reasonable. The book's numbers are a

calculation lesson, not measured calibration values for your probe.

### The archived firmware has a compiled nominal pH fit. It deliberately labels results

UNCALIBRATED until a buffer-based fit overrides it. That label prevents a tutorial coefficient from silently becoming evidence that this particular probe was calibrated.

The driver applies the fit after filtering a complete raw window. Configuration ownership (p.
519) will explain why a replacement fit is copied at the acquisition boundary rather than edited from a radio callback.

CHAPTER 14 / TURN A PH VOLTAGE INTO A CLAIM

# Read the order of the result checks

Original firmware - src/drivers/ph.c, lines 97-115
// READY in every case below: health carries the verdict, raw > the level.
PollResult pr = {DRIVER_READY, now};
if (pinMv < (float)PH_NO_SIGNAL_PIN_MV) {
r->health = HEALTH_UNPOWERED;
return pr;
}
if (self->saturated_) {
r->health = HEALTH_FAULT;
return pr;
}

if (!cfg->calibration.valid) { r->unit = UNIT_MILLIVOLT;
r->value = moduleMv;
r->health = HEALTH_UNCALIBRATED;
r->lastGoodMs = now; | // last usable result (OK or
> | UNCALIBRATED), as the SGP30
++r->sequence; | // a fresh sample, in raw units
return pr;
}

The result is READY in every branch here: the observation ended.

### Health explains the outcome. A pin level below the configured no-signal threshold is labelled UNPOWERED by this driver. A saturated ADC level is a fault because a clipped pH voltage cannot

support the intended conversion.

REMEMBER

DRIVER_READY means
collect the outcome.
HEALTH_OK means this
observation passed the
driver's acceptance checks.

CHAPTER 14 / TURN A PH VOLTAGE INTO A CLAIM

### Read the order of the result checks / continued

If no calibration is valid, the driver publishes recovered module millivolts and UNCALIBRATED. If a calibration exists, it applies the line, checks for a finite result, checks the range for a

### non-provisional fit, and then publishes pH. A provisional nominal fit can remain

UNCALIBRATED even though its unit is pH.

The checks must precede acceptance. Once the ADC clips, averaging more clipped values will not reconstruct the lost voltage. Once a computed value is NaN or infinity, comparing it with a normal plant threshold is not a sound acceptance policy.

The driver-level no-signal test is a heuristic specific to this module path. Acquisition also checks the external 5V rail history before publishing. Those checks answer different questions: the analog level may suggest a dead output, while the rail epoch can prove that a power transition happened during the operation.

When reviewing this code, follow value, unit and health together. The presence of a float in value does not promise that consumers are permitted to use it. Existing memory may retain an earlier number after a new failure.

CHAPTER 14 / TURN A PH VOLTAGE INTO A CLAIM

# Keep nominal conversion separate from acceptance

### The pH driver reuses the analog window pattern, but its conversion and fault meanings differ from light. Read the contract before

assuming the same voltage has the same significance.

### The input calibration uses recovered module millivolts, while raw

retains pin millivolts.

src/drivers/ph.h / lines 1-23
1 // ph4502c driver. Work package WP5 (Stage 3). Architecture > §3, §7, §14.
2 // Source: PH-Sensor-4502C.pdf (a tutorial, not a
> manufacturer specification).
3 //
4 // Switched 5 V rail. PO -> 10k/15k divider -> ADC1 pin > (GPIO7). DO/TO unused.
5 // Pin mV -> divider recovery -> module mV -> two-point
> buffer fit -> pH.
6 // Module output is 0-5 V, so at most 3 V at the pin (inside > the S3's ~3.1 V
7 // range at 11 dB). With the offset pot set so a shorted BNC > reads 2.5 V at PO
8 // (pH 7), the tutorial's nominal slope is about -5.7 pH/V. 9 //
10 // Filter (tutorial sketch): PH_SAMPLES conversions spaced > PH_SAMPLE_SPACING_MS
11 // apart, sorted, mean of the middle PH_SAMPLES - 2*PH_TRIM. > The window is spread
12 // over successive poll() calls, never taken as a burst
> (§9): each tap is due
13 // PH_SAMPLE_SPACING_MS after the previous actual sample, so > a late poll delays
14 // the rest of the window instead of compressing it.
15 // No temperature compensation: the tutorial reports < 0.01 > pH below 30 degC.

16 //
17 // Results:
18 // | calibration.valid | -> value in pH, HEALTH_OK (FAULT
> | outside 0-14)
19 // | + calibrationProvisional -> value in pH,
> | HEALTH_UNCALIBRATED (a nominal
20 // | | fit, e.g. shorted-BNC offset +
> | tutorial slope)
21 // | | (also outside 0-14: the nominal
> | fit may not match the
22 // | | probe yet; capturable for
> | calibration, never actionable)
23 // | otherwise | -> value = module mV,
> | UNIT_MILLIVOLT, HEALTH_UNCALIBRATED

COMMON PITFALL

A source comment
claiming a temperature
error does not implement
temperature
compensation. This driver
has no water-temperature
input.

CHAPTER 14 / TURN A PH VOLTAGE INTO A CLAIM

### Keep nominal conversion separate from acceptance / continued

src/drivers/ph.h / lines 24-28
24 // | window mean < PH_NO_SIGNAL_PIN_MV -> HEALTH_UNPOWERED (a 0 V output is a
25 // | dead rail or open lead, never "very acidic", §10).
26 // | Also seen before the offset pot is set: factory
27 // | offset puts pH 7 near 0 V.
28 // | any sample clipped -> kQualitySaturated + HEALTH_FAULT

The contract lists three possible output interpretations: calibrated pH, provisional pH and uncalibrated module voltage. It also identifies the no-signal and clipping checks. READY means any of those outcomes can be collected.

src/drivers/ph.h / lines 29-31
29 // poll() returns READY for all of these; the health carries the verdict. 30 // raw = filtered pin mV in every case.

31 //

The cited module reference in this source is a tutorial, not a uniquely authoritative specification for every board sold under the same module name. The implementation's offset and no-signal assumptions should be checked on the actual module.

CHAPTER 14 / TURN A PH VOLTAGE INTO A CLAIM

# Store the divider and fit with the window state

src/drivers/ph.h / lines 32-58
32 // Worst-case blocking (one ADC conversion C, well under 1 ms):
33 // | init() | 1 C | (throwaway conversion, checks the channel)
34 // | start() | 1 C | (first sample of the window)
35 // | poll() | 1 C | Pending until the window is full (>= 270 ms)
36 // | others | none

37 //
38 // Implements the SensorDriver contract in drivers/sensor_driver.h. 39 #pragma once
40 #include "drivers/sensor_driver.h"
41 #include "hal/adc_channel.h"
42 #include "domain/calibration.h"

43
44 #define PH_SAMPLES 10
45 #define PH_TRIM 2
46 #define PH_SAMPLE_SPACING_MS 30
47 // Provisional: below this at the pin the module is treated as unpowered.
48 // pH 14 is ~1.3 V at PO (~0.8 V at the pin), so 100 mV is far from real data. 49 #define PH_NO_SIGNAL_PIN_MV 100

50
51 typedef struct PhConfig {
52 | AdcChannel* adc; | // already begun on BOARD_PIN_PH_ADC
53 | uint32_t dividerTopOhm; | // BOARD_PH_DIVIDER_TOP_OHM
54 | uint32_t dividerBottomOhm; | // BOARD_PH_DIVIDER_BOTTOM_OHM
55 | LinearCalibration calibration; | // x = module mV, y = pH
56 | bool calibrationProvisional; | // true: fit not checked against buffers
57 } PhConfig;

58

PhConfig adds divider values and calibrationProvisional to the ADC pointer and line record. The object then keeps the familiar count, samples, timing and retained result fields.

CHAPTER 14 / TURN A PH VOLTAGE INTO A CLAIM

### Store the divider and fit with the window state / continued

src/drivers/ph.h / lines 59-73
59 // Members after `base` are private to ph.c. 60 typedef struct PhDriver {
61 | SensorDriver base; | // must stay first
62 | PhConfig config_;
63 | bool initialised_;
64 | bool busy_;
65 | bool saturated_;
66 | uint8_t count_;
67 | uint32_t samples_[PH_SAMPLES]; | // pin mV
68 | MonoMs startMs_;
69 | MonoMs lastSampleMs_; | // next tap is due PH_SAMPLE_SPACING_MS after this
70 | Reading result_;
71 } PhDriver;

72
73 // Constructor. Use &driver.base wherever a SensorDriver* is expected.

src/drivers/ph.h / lines 74-78
74 void phDriverConstruct(PhDriver* self, const PhConfig* config); phDriverConstruct

75
76 // New fit from the applied configuration (on-device calibration, WP8).
77 // Called by the acquisition owner between windows; applies from the next one.
78 void phDriverSetCalibration(PhDriver* self, const LinearCalibration* calibration, bool phDriverSetCalibration > provisional);

The spacing is 30ms: ten taps require at least 270ms from the first to the last. The provisional

### flag allows a numerical pH estimate to remain explicitly uncalibrated until buffer-based

verification replaces it. Changing the flag changes eligibility, not the arithmetic storage type.

CHAPTER 14 / TURN A PH VOLTAGE INTO A CLAIM

# Prepare the channel without certifying the probe

Follow the complete pH path from one tap to its verdict. Compare the shared window pattern with light, then pay attention to the different finish policy.

The owner applies calibration changes between windows through the public setter.

src/drivers/ph.c / lines 1-27
1 #include "drivers/ph.h"

2
3 #include <math.h>

4
5 static const float kPhMin = 0.0f, kPhMax = 14.0f;

6
7 static inline PhDriver* asPh(SensorDriver* d) { return (PhDriver*)d; } asPh

8
9 static PollResult finish(PhDriver* self, MonoMs now); finish

10
11 static SensorId phId(const SensorDriver* d) { (void)d; return SENSOR_PH; } phId
12 static const char* phName(const SensorDriver* d) { (void)d; return "ph4502c"; } phName 13 static uint8_t phMetricCount(const SensorDriver* d) { (void)d; return 1; } phMetricCount

14
15 static DriverStatus phInit(SensorDriver* d) { phInit
16 | PhDriver* self = asPh(d); asPh
17 | self->initialised_ = false;
18 | self->busy_ = false;
19 | if (self->config_.adc == 0 || self->config_.dividerBottomOhm == 0) return
> | DRIVER_FAULT;
20 | // Throwaway conversion: fails if the channel was never begun on an ADC1 pin,
21 | // and keeps any one-time ADC characterisation cost out of poll().
22 | uint32_t mv = 0;
23 | bool saturated = false;
24 | if (!adcChannelReadMilliVolts(self->config_.adc, &mv, &saturated)) return adcChannelReadMilliVolts
> | DRIVER_FAULT;
25 | self->initialised_ = true;
26 | return DRIVER_OK;

27 }

The cast and identity helpers establish the concrete instance and generic metadata. Init clears current execution flags, rejects a missing ADC pointer and performs a test conversion.

### This confirms the adapter can be used under its contract. It does not establish buffer calibration, temperature compensation or probe immersion. Those are different claims from

initialised_ being true.

CHAPTER 14 / TURN A PH VOLTAGE INTO A CLAIM

# Accumulate evidence across one new window

src/drivers/ph.c / lines 28-52

29 // Take one sample of the window at `now`. false on an ADC error. 30 static bool sample(PhDriver* self, MonoMs now) { sample
uint32_t mv = 0;
bool saturated = false;
if (!adcChannelReadMilliVolts(self->config_.adc, &mv, &saturated)) return false; adcChannelReadMilliVolts
self->samples_[self->count_++] = mv; self->lastSampleMs_ = now;
self->saturated_ = self->saturated_ || saturated; return true;

38 }

40 static DriverStatus phStart(SensorDriver* d, MonoMs now) { phStart PhDriver* self = asPh(d); asPh
if (!self->initialised_) return DRIVER_FAULT; self->count_ = 0;
self->saturated_ = false;
self->startMs_ = now;
if (!sample(self, now)) { sample
self->initialised_ = false; return DRIVER_FAULT;

}
self->busy_ = true;
return DRIVER_OK;

52 }

sample stores a pin-voltage tap, advances count, records actual time and retains any clipping flag. Start resets the window and takes its first tap before accepting the operation.

A failed first conversion ends that attempt and clears initialisation. A successful start leaves persistent state for later polls; its local pointer is only an access path to that state, not a new driver copy.

CHAPTER 14 / TURN A PH VOLTAGE INTO A CLAIM

# Delay future taps after a late one

src/drivers/ph.c / lines 53-79

54 static PollResult phPoll(SensorDriver* d, MonoMs now) { phPoll PhDriver* self = asPh(d); asPh
PollResult r = {DRIVER_FAULT, now};
if (!self->busy_) return r;

// Spacing is measured from the previous actual sample, never from the window // start: after a late poll, catching up would compress the filter taps. const MonoMs due = self->lastSampleMs_ + PH_SAMPLE_SPACING_MS;
if (now < due) {
r.status = DRIVER_PENDING;
r.nextPollMs = due;
return r;

}
if (!sample(self, now)) { sample
self->busy_ = false;
self->initialised_ = false; self->result_.health = HEALTH_FAULT; self->result_.intervalStartMs = self->startMs_; self->result_.intervalEndMs = now;
return r;

}
if (self->count_ < PH_SAMPLES) {
r.status = DRIVER_PENDING;
r.nextPollMs = self->lastSampleMs_ + PH_SAMPLE_SPACING_MS; return r;

}

### Poll compares now with the last actual sample time plus 30ms. It does not try to recreate

missed taps by taking an immediate burst. A failed tap records a fault interval; an incomplete window returns the next useful timestamp.

src/drivers/ph.c / lines 80-81
return finish(self, now); finish

81 }

After the tenth sample, finish becomes responsible for filter, divider recovery and physical interpretation. The polling function itself does not compare a pH limit or write the relay.

CHAPTER 14 / TURN A PH VOLTAGE INTO A CLAIM

# Recover voltage before classifying an unusable output

src/drivers/ph.c / lines 82-106

83 static PollResult finish(PhDriver* self, MonoMs now) { finish self->busy_ = false;
const PhConfig* cfg = &self->config_;
const float pinMv = trimmedMeanU32(self->samples_, PH_SAMPLES, PH_TRIM); trimmedMeanU32
const float moduleMv = dividerRecoverMv(pinMv, cfg->dividerTopOhm, dividerRecoverMv
> | cfg->dividerBottomOhm);
| Reading* r = &self->result_;
| r->intervalStartMs = self->startMs_;
| r->intervalEndMs = now;
| r->hasRaw = true;
| r->raw = (int32_t)(pinMv + 0.5f);
| r->qualityFlags = self->saturated_ ? kQualitySaturated : kQualityNone;
| r->calibrationRevision = cfg->calibration.revision;
| // READY in every case below: health carries the verdict, raw the level.
| PollResult pr = {DRIVER_READY, now};
| if (pinMv < (float)PH_NO_SIGNAL_PIN_MV) {
| r->health = HEALTH_UNPOWERED;
| return pr;
| }
| if (self->saturated_) {
| r->health = HEALTH_FAULT;
| return pr;
| }

### Finish computes a trimmed pin voltage and recovers module voltage using the configured

divider. It retains raw pin millivolts and the calibration revision before choosing a health branch.

The no-signal threshold and saturation are checked before numerical pH acceptance. A clipped waveform cannot be repaired by a line fit. The no-signal classification is the driver's heuristic for this configured analog path; acquisition separately checks the known rail history.

CHAPTER 14 / TURN A PH VOLTAGE INTO A CLAIM

# Preserve the distinction between fit availability and trust

src/drivers/ph.c / lines 107-134

107
108 | if (!cfg->calibration.valid) {
109 | r->unit = UNIT_MILLIVOLT;
110 | r->value = moduleMv;
111 | r->health = HEALTH_UNCALIBRATED;
112 | r->lastGoodMs = now; | // last usable result (OK or UNCALIBRATED), as the SGP30
113 | ++r->sequence; | // a fresh sample, in raw units
114 | return pr;
115 | }
116 | const float ph = linearApply(&cfg->calibration, moduleMv); linearApply
117 | r->unit = UNIT_PH;
118 | if (!isfinite(ph)) { | // a broken fit is a fault, never a value
119 | r->health = HEALTH_FAULT;
120 | return pr;
121 | }
122 | if ((ph < kPhMin || ph > kPhMax) && !cfg->calibrationProvisional) {
123 | r->health = HEALTH_FAULT;
124 | return pr;
125 | }
126 | // Out of range on the provisional (nominal) fit: the fit may simply not
127 | // match this probe yet. Published UNCALIBRATED (never actionable), so the
128 | // Calibration page can still capture it and fix the fit.
129 | r->value = ph;
130 | ++r->sequence;
131 | r->lastGoodMs = now;
132 | if (cfg->calibrationProvisional) { | // pH units, but not buffer-verified (D13)
133 | r->health = HEALTH_UNCALIBRATED;
134 | return pr;

### With no valid fit, the driver publishes module millivolts and UNCALIBRATED. Otherwise it

evaluates pH and rejects non-finite arithmetic. A non-provisional fit must also stay inside the allowed pH range.

src/drivers/ph.c / lines 135-138

135 | }
136 | r->health = HEALTH_OK;
137 | return pr;

138 }

### A provisional nominal fit can publish even an out-of-range numerical estimate as

UNCALIBRATED so the calibration workflow can inspect its raw input and replace the fit. The point is visibility for calibration, not permission for a numeric control rule to act on it.

CHAPTER 14 / TURN A PH VOLTAGE INTO A CLAIM

# Copy only a completed outcome and discard partial work

src/drivers/ph.c / lines 139-154

139
140 static uint8_t phReadResult(SensorDriver* d, Reading* out, uint8_t maxOut) { phReadResult
141 | if (maxOut < 1) return 0;
142 | out[0] = asPh(d)->result_; asPh
143 | return 1;

144 }

145
146 static void phCancel(SensorDriver* d) { phCancel
147 | PhDriver* self = asPh(d); asPh
148 | self->busy_ = false;
149 | self->count_ = 0;

150 }

151
152 // The ADC pin is a high-impedance input behind the divider: nothing to drive 153 // before the 5 V rail goes down. Drop any partial window.
154 static void phPreparePowerOff(SensorDriver* d) { phCancel(d); } phPreparePowerOff | phCancel

### ReadResult copies the retained observation when capacity permits. Cancel clears busy and

sample count. PreparePowerOff uses that cancellation because the ADC signal is an input, not a line the driver should drive into an unpowered module.

These paths preserve the lifecycle boundary: no later poll should finish the abandoned partial

### window. The service will decide whether the published record should become UNPOWERED or

TIMEOUT for the wider system event.

CHAPTER 14 / TURN A PH VOLTAGE INTO A CLAIM

# Construct the instance and copy a coherent replacement fit

src/drivers/ph.c / lines 155-180

155
156 static const SensorDriverOps kPhOps = {
157 | .id = phId,
158 | .name = phName,
159 | .metricCount = phMetricCount,
160 | .init = phInit,
161 | .start = phStart,
162 | .poll = phPoll,
163 | .readResult = phReadResult,
164 | .cancel = phCancel,
165 | .preparePowerOff = phPreparePowerOff,

166 };

167
168 void phDriverConstruct(PhDriver* self, const PhConfig* config) { phDriverConstruct
169 | self->base.ops = &kPhOps;
170 | self->config_ = *config;
171 | self->initialised_ = false;
172 | self->busy_ = false;
173 | self->saturated_ = false;
174 | self->count_ = 0;
175 | self->startMs_ = 0;
176 | self->lastSampleMs_ = 0;
177 | readingReset(&self->result_, SENSOR_PH, METRIC_PH, UNIT_PH); readingReset
178 | self->result_.calibrationRevision = config->calibration.revision;

179 }

180

The table supplies the generic callbacks. Construction resets state and one pH result, while

### retaining the selected calibration revision. SetCalibration copies both the line and its

provisional status.

src/drivers/ph.c / lines 181-184
181 void phDriverSetCalibration(PhDriver* self, const LinearCalibration* calibration, bool phDriverSetCalibration
> | provisional) {
182 | self->config_.calibration = *calibration;
183 | self->config_.calibrationProvisional = provisional;

184 }

Those two changes belong together: the same coefficients may have different trust after actual reference work. The setter does not serialise competing tasks; the acquisition owner must apply the pair at its declared boundary.

CHAPTER 14 / TURN A PH VOLTAGE INTO A CLAIM

# Separate placeholders from measured calibration points

### This experiment makes the module-voltage input visible beside the pH estimate. You can

therefore inspect a fit without losing sight of what the ADC actually observed.

### The procedure in the source is a particular commissioning workflow, not values already

measured for a new probe.

test/bringup/ph_main.c / lines 1-25
1 // Bring-up entry point for ph (WP5). pio run -e test_ph -t upload -t monitor 2 // Switched 5 V rail must be ON. PO -> 10k/15k -> GPIO7 (ADC1_CH6).
3 // Replaces src/main.c in this env only; links the production driver.
4 //
5 // Procedure (README "pH-4502C calibration"). Every reading is followed by a 6 // "module NNNN mV" line: the module PO voltage the buffer fit is made from, 7 // whatever the pH line shows (nominal fit, buffer fit or none).
8 // | 1. Offset: probe off, BNC shorted. Turn the pot nearest the BNC until the
9 // | module line reads ~2500 mV - that is the module PO voltage (pH 7).
10 // | A factory-set module starts near 0 V and prints "ph=UNPOWERED": check
11 // | the 5 V rail, then keep turning the pot until mV values appear.
12 // | 2. Probe in, rinse, pH 6.86 buffer, wait >= 2 min, note the module mV.
13 // | Rinse, pH 4.01 buffer, wait >= 2 min, note the module mV.
14 // | 3. Put both mV values below and re-flash: readings switch to pH / OK.
15 // Without buffers: pH comes from the nominal fit below and prints "(uncal)". 16 #include <Arduino.h>
17 #include <stdio.h>

18
19 #include "app_config.h"
20 #include "board_profile.h"
21 #include "bringup_harness.h" 22 #include "hal/adc_channel.h" 23 #include "domain/calibration.h" 24 #include "drivers/ph.h"

25

### The buffer millivolt macros are initially zero, meaning not yet measured. The alternative

nominal fit uses a recorded offset and tutorial slope. Neither placeholder becomes a new buffer measurement because the program is compiled.

test/bringup/ph_main.c / lines 26-34
26 // Module mV measured in each buffer (step 2). 0 = not measured yet: uncalibrated. 27 #define PH_BUFFER_A_PH 6.86f
28 #define PH_BUFFER_A_MV 0.0f
29 #define PH_BUFFER_B_PH 4.01f
30 #define PH_BUFFER_B_MV 0.0f
31 #define PH_CALIBRATION_REVISION 1

32
33 // Nominal fit, used until both buffer values are set. Offset: module mV with the 34 // BNC shorted (pH 7), measured 17 Oct 2026. Re-measure if the offset pot moves.

CHAPTER 14 / TURN A PH VOLTAGE INTO A CLAIM

### Separate placeholders from measured calibration points / continued

test/bringup/ph_main.c / lines 35-40
35 // Slope: tutorial sketch, pH = -5.70 * V. Accuracy roughly +/-0.5-1 pH. 36 #define PH_NOMINAL_MV_AT_PH7 2758.0f
37 #define PH_NOMINAL_PH_PER_MV (-0.0057f)

38
39 static AdcChannel s_adc = ADC_CHANNEL_INIT;
40 static PhConfig s_config = {&s_adc, BOARD_PH_DIVIDER_TOP_OHM, > BOARD_PH_DIVIDER_BOTTOM_OHM,

s_config stores the divider and an initially invalid fit; setup chooses the actual policy before construction. If the analog offset is changed, any calibration tied to the previous voltage relationship must be revisited.

CHAPTER 14 / TURN A PH VOLTAGE INTO A CLAIM

# Inspect raw voltage through the same driver owner

test/bringup/ph_main.c / lines 41-49
41 | {1.0f, 0.0f, 0, false}, false}; | // set in setup() setup
42 static PhDriver s_driver;
43 // The module mV for the procedure, from the pin mV the driver publishes as raw. 44 static void printModuleMv(SensorDriver* driver) { printModuleMv
45 | Reading r;
46 | if (sensorDriverReadResult(driver, &r, 1) != 1 || !r.hasRaw) return; sensorDriverReadResult
47 | printf(" | module %.0f mV\n",
48 | (double)dividerRecoverMv((float)r.raw, BOARD_PH_DIVIDER_TOP_OHM, dividerRecoverMv
> | BOARD_PH_DIVIDER_BOTTOM_OHM));

49 }

The callback requests one copied result, checks raw availability and recovers module millivolts for printing. It does not call the ADC independently.

That keeps one observation path: the pH line and the module-voltage line come from the same filtered result. A parallel ADC read could observe a different instant and confuse calibration comparisons.

CHAPTER 14 / TURN A PH VOLTAGE INTO A CLAIM

# Choose a measured two-point fit or a provisional fallback

test/bringup/ph_main.c / lines 50-69

51 static BringupContext s_ctx = {&s_driver.base, CFG_FRAME_PERIOD_MS, printModuleMv};

53 void setup(void) { setup
if (PH_BUFFER_A_MV > 0.0f && PH_BUFFER_B_MV > 0.0f) { linearFromTwoPoints(PH_BUFFER_A_MV, PH_BUFFER_A_PH, PH_BUFFER_B_MV, PH_BUFFER_B_PH, linearFromTwoPoints
PH_CALIBRATION_REVISION, &s_config.calibration); } else {
s_config.calibration.slope = PH_NOMINAL_PH_PER_MV;
s_config.calibration.offset = 7.0f - PH_NOMINAL_PH_PER_MV * PH_NOMINAL_MV_AT_PH7; s_config.calibration.revision = 0;
s_config.calibration.valid = true;
s_config.calibrationProvisional = true;

}
phDriverConstruct(&s_driver, &s_config); phDriverConstruct
delay(200);
printf("\n=== bring-up: %s ===\n", sensorDriverName(&s_driver.base)); sensorDriverName
if (!adcChannelBegin(&s_adc, BOARD_PIN_PH_ADC)) { adcChannelBegin
printf("GPIO%d is not an ADC1 pin\n", (int)BOARD_PIN_PH_ADC);

}

When both buffer voltages are positive, setup calls the general two-point fit maker. Otherwise it

### builds the nominal line and sets provisional true. Construction then copies the selected

configuration.

The test does not check the fit-maker boolean directly, but a failed maker leaves its calibration invalid. The later print path exposes that state. In a user-facing command path, explicit error reporting is stronger than relying only on a later diagnostic line.

CHAPTER 14 / TURN A PH VOLTAGE INTO A CLAIM

# Report which interpretation the experiment is using

test/bringup/ph_main.c / lines 70-84
if (s_config.calibrationProvisional) {
printf("nominal pH (not buffer-calibrated): pH 7 at %.0f mV, %.4f pH/mV\n", (double)PH_NOMINAL_MV_AT_PH7, (double)PH_NOMINAL_PH_PER_MV);
} else if (s_config.calibration.valid) {
// Tutorial nominal is about -0.0057 pH/mV; far from it means a bad buffer reading. printf("calibration rev %u: pH = %.6f * mV + %.3f\n", (unsigned)s_config.calibration.revision, (double)s_config.calibration.slope, (double)s_config.calibration.offset);
} else {
printf("uncalibrated: printing module PO voltage in mV\n");

}
bringupStart(&s_ctx); bringupStart

82 }

84 void loop(void) { vTaskDelay(portMAX_DELAY); } loop | vTaskDelay

After ADC setup, the source prints whether it is using nominal pH, a valid fitted revision or raw module voltage. These labels explain the unit and health you should expect from the harness.

### The shared task then performs repeated windows. Observe settling and record reference

voltage under the procedure's conditions; do not use an instant after probe movement as though the physical signal had already stabilised.

CHAPTER 15 / COMPENSATE THE TDS ESTIMATE

# Follow the polynomial with units intact

Original firmware - src/domain/tds_codec.c, lines 3-13
float tdsCompensationCoefficient(float waterTempC) { return 1.0f + 0.02f * (waterTempC - 25.0f);
}

float tdsPpmFromModuleMv(float moduleMv, float coefficient) { if (moduleMv <= 0.0f || coefficient <= 0.0f) return 0.0f; const float v = moduleMv / 1000.0f;
const float ppm = (133.42f * v * v * v - 255.86f * v * v +
> | 857.39f * v) * 0.5f;
return ppm / coefficient; | // compensate the conductivity,
> | not the voltage
}

### The input is module millivolts. Dividing by 1000.0 changes it to volts

before the polynomial. For moduleMv=1000 and coefficient=1, v=1.

### The polynomial becomes (133.42-255.86+857.39) x 0.5 =

367.475ppm.

### For a water temperature of 30 degrees Celsius, the project coefficient is 1 + 0.02 x (30-25) = 1.10. The reported nominal estimate is then 367.475/1.10 = 334.07ppm. The source divides the

polynomial result by the temperature coefficient.

### The placement matters. A polynomial is nonlinear: applying it to v/1.10 generally does not equal applying it to v and dividing the result by 1.10. Do not move compensation to another point in the

expression without checking the intended model.

The source uses a nominal conversion plus an optional fitted gain.

### TDS here is an estimate based on the electrical response and the selected model. It does not identify individual dissolved ions, and its

calibration is not automatically transferable to every solution.

### This is a useful file to test on your PC: it has no ADC access and no

RTOS calls. Known numeric inputs should produce known outputs.

### That is the benefit of keeping the arithmetic in domain/ while the

driver handles timing and validity.

Reference: DFRobot: SEN0244 reference (https://wiki.dfrobot.com/sen0244)

COMMON PITFALL

Feeding 1000 as volts
rather than millivolts
makes the cubic term
enormous. Parameter units
are part of the function's contract.

CHAPTER 15 / COMPENSATE THE TDS ESTIMATE

# Reject a calculation with a bad dependency

Original firmware - src/drivers/tds.c, lines 85-99
static bool temperatureUsable(const TdsDriver* self, MonoMs
> now) {
const Reading* t = &self->waterTemperature_;
return readingIsActionableAt(t, now, CFG_STALE_ORDINARY_MS) && t->value >= TDS_MIN_WATER_TEMP_C && t->value <=
> TDS_MAX_WATER_TEMP_C;
}

static PollResult finish(TdsDriver* self, MonoMs now) {
| self->busy_ = false;
const TdsConfig* cfg = &self->config_;
const float pinMv = trimmedMeanU32(self->samples_,
> | TDS_SAMPLES, TDS_TRIM); | // = module mV

const bool compensated = temperatureUsable(self, now);
| const float coefficient = compensated ?
> | tdsCompensationCoefficient(self->waterTemperature_.value) :
> | 1.0f;
float ppm = tdsPpmFromModuleMv(pinMv, coefficient);

### temperatureUsable checks both freshness and the allowed temperature range. It does not merely ask whether a float exists. The

driver has a copied water-temperature record from prepareInputs(),

### so its own finish time decides whether that dependency is still

acceptable.

### If the dependency is not usable, the implementation can still calculate a nominal number with coefficient 1.0, but it labels the outcome DEPENDENCY_INVALID. That number may be useful for diagnostics. It must not quietly become an ordinary calibrated

control input.

REMEMBER

Compensation is a
dependency on another
observation, not just an
extra multiplication.

CHAPTER 15 / COMPENSATE THE TDS ESTIMATE

### Reject a calculation with a bad dependency / continued

After the calculation, the driver rejects non-finite results, saturation and estimates beyond its declared full-scale range. With a usable dependency but no valid reference calibration, it publishes UNCALIBRATED. Only the accepted, calibrated path reaches OK.

### Take two cases with the same 1000mV input. Case A has an OK 25-degree Reading from 200ms

ago. Case B has a FAULT temperature record whose old value field still says 25.0. Case A can use coefficient 1.0 as a valid dependency. Case B cannot: the number alone is the same, but the evidence is different.

This is the architectural reason for carrying the complete Reading between modules. A pointer to a float would discard the age and health needed to distinguish those cases.

The ordinary stale limit in this snapshot is 3000ms. The driver checks it at the time of use.

CHAPTER 15 / COMPENSATE THE TDS ESTIMATE

# Know which faults the signal cannot reveal

### At 0mV, the polynomial returns zero. A low-conductivity solution can produce a low output, but a disconnected or unpowered analog path may also produce one. A voltage-only interface may not contain

enough information to distinguish them.

Do not invent a universal rule that every zero voltage is a broken probe. Conversely, do not claim that every in-range voltage proves a healthy probe. The driver can check clipping, finite arithmetic, rated range, temperature dependency and known rail validity. It cannot directly prove that the electrodes are immersed or connected

correctly in every failure condition.

### Use a fault experiment to establish observability

### During isolated bring-up, record the output in a known solution, with the probe removed, with the signal unplugged, and with module power removed. Observe whether the conditions produce distinct levels or time patterns. A firmware diagnostic needs a

distinguishable signal to classify those cases reliably.

### If two conditions overlap, document the limitation or improve the electrical interface. A more complicated if statement cannot recover missing evidence. This is one reason the project also records rail status and retained health rather than reducing everything to a

single ppm field.

For reference calibration, a gain-only model compares a known reference ppm with the nominal prediction. If the reference is 500ppm and the nominal prediction is 400ppm, gain=1.25. The policy constrains the allowed gain. After applying it, test a different reference point instead of treating a perfect fit at the first point as

full validation.

COMMON PITFALL

A flat, stable trace can
mean a stable solution, a
clipped input, a
disconnected input or a
frozen acquisition path.
Use sequence, timing and
fault tests together.

CHAPTER 15 / COMPENSATE THE TDS ESTIMATE

# Name the input scale before using the formula

### This interface isolates the nominal TDS model and its accepted temperature and full-scale

limits.

The driver supplies filtered millivolts and a validated temperature coefficient.

src/domain/tds_codec.h / lines 1-27
1 // SEN0244 TDS conversion (WP5). Pure C, host-tested.
2 // Source: DFRobot Gravity Analog TDS Sensor SEN0244 (local copy in
3 // Electrical System Study/Datasheets/SEN0244.PDF) for the curve, and DFRobot's 4 // GravityTDS library for where the temperature compensation is applied:
5 // | ppm(T) | = (133.42 V^3 - 255.86 V^2 + 857.39 V) * 0.5
6 // | coefficient = 1 + 0.02 * (T - 25)
7 // | ppm25 | = ppm(T) / coefficient
8 // The datasheet's sample sketch divides the VOLTAGE by the coefficient
9 // instead. Because the curve is not linear, that over-corrects: on 24 Oct 2026 10 // the same tap water at 11.4 / 33.6 / 11.6 degC gave 683 / 584 / 713 ppm with 11 // the sketch's method and 631 / 620 / 653 ppm compensating the ppm (EC), as 12 // the library does. Conductivity is what changes by ~2 %/degC.
13 // The sample's VREF/1024 scaling is not ported: the ADC HAL already returns 14 // calibrated millivolts, and the module output reaches the pin undivided. 15 #pragma once

16
17 #define TDS_FULL_SCALE_PPM 1000.0f | // rated range 0-1000 ppm, +/-10 % F.S.
18 #define TDS_MIN_WATER_TEMP_C 0.0f | // below: frozen water, not a usable input
19 #define TDS_MAX_WATER_TEMP_C 55.0f | // datasheet probe limit

20
21 // Temperature compensation coefficient, 1.0 at 25 degC.
22 float tdsCompensationCoefficient(float waterTempC); tdsCompensationCoefficient

23
24 // Module output (mV) to TDS (ppm) referred to 25 degC: the curve's ppm divided 25 // by `coefficient` (1.0 = no compensation). 0 for a non-positive voltage or 26 // coefficient.
27 float tdsPpmFromModuleMv(float moduleMv, float coefficient); tdsPpmFromModuleMv

The declarations distinguish the water-temperature coefficient from the millivolt-to-ppm model. The limits belong to the selected sensor/model assumptions. A float parameter does not carry its unit mechanically, so the names and caller must keep millivolts and degrees straight.

The codec can calculate a value for supplied numbers without knowing whether they came from fresh sensors. The driver makes that acceptance decision around the arithmetic.

CHAPTER 15 / COMPENSATE THE TDS ESTIMATE

# Compensate the model output at the intended stage

Read the entire nominal conversion with the lesson's 1000mV example.

The optional fitted gain is applied by the driver after this helper returns.

src/domain/tds_codec.c / lines 1-12
1 #include "domain/tds_codec.h"

2
3 float tdsCompensationCoefficient(float waterTempC) { tdsCompensationCoefficient 4 return 1.0f + 0.02f * (waterTempC - 25.0f);

5 }

6
7 float tdsPpmFromModuleMv(float moduleMv, float coefficient) { tdsPpmFromModuleMv
8 | if (moduleMv <= 0.0f || coefficient <= 0.0f) return 0.0f;
9 | const float v = moduleMv / 1000.0f;
10 | const float ppm = (133.42f * v * v * v - 255.86f * v * v + 857.39f * v) * 0.5f;
11 | return ppm / coefficient; | // compensate the conductivity, not the voltage

12 }

At 25 degrees the coefficient is 1.0; at 30 it is 1.10. The polynomial first converts module

### millivolts to volts, produces the nominal ppm estimate, then divides that estimate by the

coefficient.

A cubic is nonlinear, so changing the input voltage before the polynomial is not generally

### equivalent. The guards return zero for nonpositive voltage or coefficient; they do not by themselves provide an observation-health verdict. The caller must still reject invalid

configuration and dependencies.

CHAPTER 15 / COMPENSATE THE TDS ESTIMATE

# Read the order of failure meanings

### The TDS object adds a retained water-temperature record to the analog window you already

understand. That extra record is the architectural difference to watch.

The temperature setter copies data supplied by acquisition and never touches the DS18B20 bus.

src/drivers/tds.h / lines 1-28
1 // sen0244_tds driver. Work package WP5 (Stage 3). Architecture §8, §14.
2 // Source: DFRobot Gravity Analog TDS Sensor SEN0244 datasheet (wiki + sample). 3 //
4 // Switched 5 V rail. A -> GPIO6 (ADC1_CH5), 100 nF to GND, no divider: pin mV 5 // = module mV. Output 0-2.3 V nominal, inside the S3's ~3.1 V range at 11 dB. 6 // Pin mV -> datasheet cubic -> temperature compensation of the ppm (EC, as 7 // DFRobot GravityTDS; domain/tds_codec.h)
8 // -> optional K-factor (calibration: x = nominal ppm, y = ppm) -> ppm.
9 //
10 // Filter: TDS_SAMPLES conversions spaced TDS_SAMPLE_SPACING_MS apart, sorted, 11 // mean of the middle TDS_SAMPLES - 2*TDS_TRIM (stands in for the sample's
12 // median). The sample takes 30 taps 40 ms apart (~1.2 s), which overruns the 13 // 1 s frame, so the window is shortened to ~560 ms. Spread over successive 14 // poll() calls, never a burst (§9), spacing measured from the previous tap.

15 //
16 // Temperature compensation needs a fresh DS18B20 reading via
17 // tdsDriverSetWaterTemperature(): OK and not older than CFG_STALE_ORDINARY_MS 18 // at the end of the window, within 0-55 degC (probe limit). Otherwise the
19 // value is computed uncompensated - never silently assumed to be 25 degC.

20 //
21 // Results (unit ppm, raw = filtered pin mV in every case), highest first:
22 // | any tap clipped or ppm > 1000 -> kQualitySaturated + HEALTH_FAULT (value
23 // | | kept; above the rated range, never actionable)
24 // | no valid temperature | -> kQualityUncompensated + HEALTH_DEPENDENCY_INVALID
25 // | !calibration.valid | -> HEALTH_UNCALIBRATED (nominal datasheet curve, D13)
26 // | otherwise | -> HEALTH_OK
27 // poll() returns READY for all of these; the health carries the verdict.

28 //

CHAPTER 15 / COMPENSATE THE TDS ESTIMATE

### Read the order of failure meanings / continued

### The contract gives clipping or excessive ppm priority over missing temperature, then

distinguishes a nominal uncalibrated model from a reference-calibrated result. The raw voltage stays available across those verdicts for diagnosis.

src/drivers/tds.h / lines 29-32
29 // Not detectable here: 0 V is distilled water, a probe in air, an open lead or 30 // a dead rail alike, so there is no UNPOWERED threshold. Rail state is left to 31 // acquisition (rail epoch, WP9).

32 //

It also says why there is no zero-voltage UNPOWERED threshold: several physical conditions can produce the same low signal. Known rail state is therefore handled above the driver rather than inferred from an indistinguishable analog level.

CHAPTER 15 / COMPENSATE THE TDS ESTIMATE

# Keep a stable dependency for this calculation

src/drivers/tds.h / lines 33-60
33 // Worst-case blocking (one ADC conversion C, well under 1
> | ms):
34 // | init() | 1 C | (throwaway conversion, checks the
> | channel)
35 // | start() | 1 C | (first sample of the window)
36 // | poll() | 1 C | Pending until the window is full (>=
> | 560 ms)
37 // | others | none

38 //
39 // Implements the SensorDriver contract in > drivers/sensor_driver.h.
40 #pragma once
41 #include "drivers/sensor_driver.h"
42 #include "hal/adc_channel.h"
43 #include "domain/calibration.h"

44
45 #define TDS_SAMPLES 15
46 #define TDS_TRIM 5
47 #define TDS_SAMPLE_SPACING_MS 40

48
49 typedef struct TdsConfig {
50 | AdcChannel* adc; | // already begun on
> | BOARD_PIN_TDS_ADC
51 | LinearCalibration calibration; | // K-factor: x = nominal
> | ppm, y = ppm
52 } TdsConfig;

53
54 // Members after `base` are private to tds.c. 55 typedef struct TdsDriver {
56 | SensorDriver base; | // must stay first
57 | TdsConfig config_;
58 | bool initialised_;
59 | bool busy_;
60 | bool saturated_;

### Fifteen taps 40ms apart span at least 560ms; trimming five from each end leaves five values for the mean. The state object retains the

sample window and a complete Reading for water temperature.

src/drivers/tds.h / lines 61-66
61 | uint8_t count_;
62 | uint32_t samples_[TDS_SAMPLES]; | // pin mV
63 | MonoMs startMs_;
64 | MonoMs lastSampleMs_; | // next tap is due
> | TDS_SAMPLE_SPACING_MS after this
65 | Reading waterTemperature_;
66 | Reading result_;

COMMON PITFALL

A copied dependency
becomes older while your
own operation runs.
Validate it at use, not only at assignment.

CHAPTER 15 / COMPENSATE THE TDS ESTIMATE

### Keep a stable dependency for this calculation / continued

src/drivers/tds.h / lines 67-78
67 } TdsDriver;

68
69 // Constructor. Use &driver.base wherever a SensorDriver* is expected.
70 void tdsDriverConstruct(TdsDriver* self, const TdsConfig* config); tdsDriverConstruct

71
72 // Compensation input from the latest DS18B20 reading (copied, not shared).
73 // Checked for health and age when the window finishes; no ADC access here.
74 void tdsDriverSetWaterTemperature(TdsDriver* self, const Reading* waterTemperature); tdsDriverSetWaterTemperature

75
76 // New K-factor from the applied configuration (on-device calibration, WP8).
77 // Called by the acquisition owner between windows; applies from the next one.
78 void tdsDriverSetCalibration(TdsDriver* self, const LinearCalibration* calibration); tdsDriverSetCalibration

That dependency includes health and time, not merely valueC. The setter can copy a previously completed result before the new TDS window starts, and finish can decide whether that same record is still fresh when it is used.

CHAPTER 15 / COMPENSATE THE TDS ESTIMATE

# Establish a usable ADC channel

### The early lifecycle resembles the other analog drivers. We will read it completely, then

concentrate on the point where another sensor's evidence changes the outcome.

All dependency and calibration setters still belong to the single driver owner.

src/drivers/tds.c / lines 1-28
1 #include "drivers/tds.h"

2
3 #include <math.h>

4
5 #include "app_config.h"
6 #include "domain/tds_codec.h"

7
8 static inline TdsDriver* asTds(SensorDriver* d) { return (TdsDriver*)d; } asTds

9
10 static PollResult finish(TdsDriver* self, MonoMs now); finish

11
12 static SensorId tdsId(const SensorDriver* d) { (void)d; return SENSOR_TDS; } tdsId
13 static const char* tdsName(const SensorDriver* d) { (void)d; return "sen0244_tds"; } tdsName 14 static uint8_t tdsMetricCount(const SensorDriver* d) { (void)d; return 1; } tdsMetricCount

15
16 static DriverStatus tdsInit(SensorDriver* d) { tdsInit
17 | TdsDriver* self = asTds(d); asTds
18 | self->initialised_ = false;
19 | self->busy_ = false;
20 | if (self->config_.adc == 0) return DRIVER_FAULT;
21 | // Throwaway conversion: fails if the channel was never begun on an ADC1 pin,
22 | // and keeps any one-time ADC characterisation cost out of poll().
23 | uint32_t mv = 0;
24 | bool saturated = false;
25 | if (!adcChannelReadMilliVolts(self->config_.adc, &mv, &saturated)) return adcChannelReadMilliVolts
> | DRIVER_FAULT;
26 | self->initialised_ = true;
27 | return DRIVER_OK;

28 }

The generic cast and metadata helpers identify this one-metric driver. Init clears active state,

### rejects a missing ADC pointer and performs a throwaway conversion before accepting later

windows.

The optional calibration starts as a record in config_. It is not established by ADC initialisation, and a valid ADC result is not a reference solution measurement.

CHAPTER 15 / COMPENSATE THE TDS ESTIMATE

# Retain taps and clipping across returns

src/drivers/tds.c / lines 29-53

30 // Take one sample of the window at `now`. false on an ADC error. 31 static bool sample(TdsDriver* self, MonoMs now) { sample
uint32_t mv = 0;
bool saturated = false;
if (!adcChannelReadMilliVolts(self->config_.adc, &mv, &saturated)) return false; adcChannelReadMilliVolts
self->samples_[self->count_++] = mv; self->lastSampleMs_ = now;
self->saturated_ = self->saturated_ || saturated; return true;

39 }

41 static DriverStatus tdsStart(SensorDriver* d, MonoMs now) { tdsStart TdsDriver* self = asTds(d); asTds
if (!self->initialised_) return DRIVER_FAULT; self->count_ = 0;
self->saturated_ = false;
self->startMs_ = now;
if (!sample(self, now)) { sample
self->initialised_ = false; return DRIVER_FAULT;

}
self->busy_ = true;
return DRIVER_OK;

53 }

sample appends one millivolt result and accumulates saturation. Start resets count, clipping and timing, then takes the first tap. The object persists while the task returns to other work.

The state machine ensures a later poll, not a second concurrent caller, supplies each next sample. Separate stacks would not protect samples_ if two owners advanced this same object.

CHAPTER 15 / COMPENSATE THE TDS ESTIMATE

# Respect the next actual sample time

src/drivers/tds.c / lines 54-80

55 static PollResult tdsPoll(SensorDriver* d, MonoMs now) { tdsPoll TdsDriver* self = asTds(d); asTds
PollResult r = {DRIVER_FAULT, now};
if (!self->busy_) return r;

// Spacing is measured from the previous actual sample, never from the window // start: after a late poll, catching up would compress the filter taps. const MonoMs due = self->lastSampleMs_ + TDS_SAMPLE_SPACING_MS;
if (now < due) {
r.status = DRIVER_PENDING;
r.nextPollMs = due;
return r;

}
if (!sample(self, now)) { sample
self->busy_ = false;
self->initialised_ = false; self->result_.health = HEALTH_FAULT; self->result_.intervalStartMs = self->startMs_; self->result_.intervalEndMs = now;
return r;

}
if (self->count_ < TDS_SAMPLES) {
r.status = DRIVER_PENDING;
r.nextPollMs = self->lastSampleMs_ + TDS_SAMPLE_SPACING_MS; return r;

}

Poll returns early when no operation exists or the next 40ms spacing has not elapsed. ADC-helper failure ends the window and stamps a fault interval. A successful but partial window returns PENDING; a complete one calls finish.

src/drivers/tds.c / lines 81-82
return finish(self, now); finish

82 }

There is no delay loop inside the driver. The returned timestamp is the mechanism that lets an acquisition task wait efficiently while still servicing other drivers.

CHAPTER 15 / COMPENSATE THE TDS ESTIMATE

# Choose compensation only from acceptable evidence

src/drivers/tds.c / lines 83-110

83
84 // True if the stored water temperature can drive compensation at `now`. 85 static bool temperatureUsable(const TdsDriver* self, MonoMs now) { temperatureUsable
86 | const Reading* t = &self->waterTemperature_;
87 | return readingIsActionableAt(t, now, CFG_STALE_ORDINARY_MS) && readingIsActionableAt
88 | t->value >= TDS_MIN_WATER_TEMP_C && t->value <= TDS_MAX_WATER_TEMP_C;

89 }

90
91 static PollResult finish(TdsDriver* self, MonoMs now) { finish
92 | self->busy_ = false;
93 | const TdsConfig* cfg = &self->config_;
94 | const float pinMv = trimmedMeanU32(self->samples_, TDS_SAMPLES, TDS_TRIM); | // = trimmedMeanU32
> | module mV

95
96 | const bool compensated = temperatureUsable(self, now); temperatureUsable
97 | const float coefficient =
98 | compensated ? tdsCompensationCoefficient(self->waterTemperature_.value) : 1.0f; tdsCompensationCoefficient
99 | float ppm = tdsPpmFromModuleMv(pinMv, coefficient); tdsPpmFromModuleMv
100 | if (cfg->calibration.valid) ppm = linearApply(&cfg->calibration, ppm); linearApply

101
102 | Reading* r = &self->result_;
103 | r->intervalStartMs = self->startMs_;
104 | r->intervalEndMs = now;
105 | r->hasRaw = true;
106 | r->raw = (int32_t)(pinMv + 0.5f);
107 | r->unit = UNIT_PPM;
108 | r->value = ppm;
109 | r->qualityFlags = compensated ? kQualityNone : kQualityUncompensated;
110 | r->calibrationRevision = cfg->calibration.revision;

temperatureUsable checks the copied temperature's health, age and allowed physical range. Finish computes the filtered pin voltage, uses a coefficient only when that dependency passes, applies the nominal polynomial and then an optional calibration line.

The result retains raw voltage and tags uncompensated output explicitly. A number calculated with coefficient 1.0 because temperature was missing is not the same evidence as an accepted 25-degree dependency that legitimately gives coefficient 1.0.

CHAPTER 15 / COMPENSATE THE TDS ESTIMATE

# Let the strongest rejection win before setting OK

src/drivers/tds.c / lines 111-135

111
112 | // READY in every case below: health carries the verdict, raw the level.
113 | PollResult pr = {DRIVER_READY, now};
114 | if (!isfinite(ppm)) { | // a broken fit is a fault, never a value
115 | r->health = HEALTH_FAULT;
116 | return pr;
117 | }
118 | if (self->saturated_ || ppm > TDS_FULL_SCALE_PPM) {
119 | r->qualityFlags |= kQualitySaturated;
120 | r->health = HEALTH_FAULT; | // above the rated 0-1000 ppm: never actionable
121 | return pr;
122 | }
123 | if (!compensated) {
124 | r->health = HEALTH_DEPENDENCY_INVALID;
125 | return pr;
126 | }
127 | ++r->sequence;
128 | r->lastGoodMs = now; | // last usable result (OK or UNCALIBRATED)
129 | if (!cfg->calibration.valid) { | // nominal datasheet curve, no reference check (D13)
130 | r->health = HEALTH_UNCALIBRATED;
131 | return pr;
132 | }
133 | r->health = HEALTH_OK;
134 | return pr;

135 }

Non-finite arithmetic returns FAULT. Clipping or a value beyond full scale sets the saturation

### qualification and FAULT. Missing temperature returns DEPENDENCY_INVALID before a

nominal or calibrated value can be accepted.

Only a usable dependency advances the usable-result history. Without a valid reference fit the

### result remains UNCALIBRATED; otherwise it becomes OK. Those ordered returns explain why

simply looking at the ppm float cannot reconstruct the measurement's eligibility.

CHAPTER 15 / COMPENSATE THE TDS ESTIMATE

# End a window without driving its analog input

src/drivers/tds.c / lines 136-151

136
137 static uint8_t tdsReadResult(SensorDriver* d, Reading* out, uint8_t maxOut) { tdsReadResult
138 | if (maxOut < 1) return 0;
139 | out[0] = asTds(d)->result_; asTds
140 | return 1;

141 }

142
143 static void tdsCancel(SensorDriver* d) { tdsCancel
144 | TdsDriver* self = asTds(d); asTds
145 | self->busy_ = false;
146 | self->count_ = 0;

147 }

148
149 // The ADC pin is a high-impedance input (100 nF to GND): nothing to drive 150 // before the 5 V rail goes down. Drop any partial window.
151 static void tdsPreparePowerOff(SensorDriver* d) { tdsCancel(d); } tdsPreparePowerOff | tdsCancel

ReadResult copies one retained Reading when capacity permits. Cancel drops busy and count. PreparePowerOff delegates to cancel because the input has no output control line to make safe.

The service can independently label this observation UNPOWERED when a rail epoch changed. This division prevents the ADC driver from guessing a known power event from voltage alone.

CHAPTER 15 / COMPENSATE THE TDS ESTIMATE

# Construct both result identities and update dependencies by copy

src/drivers/tds.c / lines 152-178

152
153 static const SensorDriverOps kTdsOps = {
154 | .id = tdsId,
155 | .name = tdsName,
156 | .metricCount = tdsMetricCount,
157 | .init = tdsInit,
158 | .start = tdsStart,
159 | .poll = tdsPoll,
160 | .readResult = tdsReadResult,
161 | .cancel = tdsCancel,
162 | .preparePowerOff = tdsPreparePowerOff,

163 };

164
165 void tdsDriverConstruct(TdsDriver* self, const TdsConfig* config) { tdsDriverConstruct
166 | self->base.ops = &kTdsOps;
167 | self->config_ = *config;
168 | self->initialised_ = false;
169 | self->busy_ = false;
170 | self->saturated_ = false;
171 | self->count_ = 0;
172 | self->startMs_ = 0;
173 | self->lastSampleMs_ = 0;
174 | readingReset(&self->waterTemperature_, SENSOR_DS18B20, METRIC_WATER_TEMPERATURE, readingReset
> | UNIT_DEG_C);
175 | readingReset(&self->result_, SENSOR_TDS, METRIC_TDS, UNIT_PPM); readingReset
176 | self->result_.calibrationRevision = config->calibration.revision;

177 }

178

### Construction installs the operations table, initialises the window and resets both waterTemperature_ and the TDS result. The dependency begins STARTING rather than silently

assuming 25 degrees.

src/drivers/tds.c / lines 179-185
179 void tdsDriverSetWaterTemperature(TdsDriver* self, const Reading* waterTemperature) { tdsDriverSetWaterTemperature 180 self->waterTemperature_ = *waterTemperature;

181 }

182
183 void tdsDriverSetCalibration(TdsDriver* self, const LinearCalibration* calibration) { tdsDriverSetCalibration 184 self->config_.calibration = *calibration;

185 }

### The two setters copy complete records: one for a measured dependency and one for a

calibration fit. Neither fetches the data itself or acquires a bus. Ownership and timing of these calls remain visible in acquisition.

CHAPTER 15 / COMPENSATE THE TDS ESTIMATE

# Create a nominal driver with no invented temperature

### The isolated TDS experiment deliberately begins without a water sensor. That makes the

dependency-invalid path observable instead of hiding it with a default temperature.

A manual thermometer input in this experiment is a test substitution, not a production DS18B20 reading.

test/bringup/tds_main.c / lines 1-28
1 // Bring-up entry point for tds (WP5). pio run -e test_tds -t upload -t monitor 2 // Switched 5 V rail must be ON. A -> GPIO6 (ADC1_CH5), 100 nF to GND.
3 // Replaces src/main.c in this env only; links the production driver.
4 //
5 // Procedure (README "SEN0244 TDS bring-up"):
6 // | 1. Probe in the liquid, away from the container wall (datasheet), stir
7 // | gently and wait for the reading to settle. Water below 55 degC only.
8 // | 2. Without a water temperature every line is "tds=DEPENDENCY_INVALID
9 // | (raw <pin mV>)": this env runs the TDS driver alone, without the DS18B20.
10 // | 3. Measure the water with a thermometer, put it in TDS_MANUAL_WATER_TEMP_C
11 // | and re-flash: lines switch to "<ppm> ppm (uncal)" (nominal curve).
12 // "tds=FAULT (raw ...)" means above 1000 ppm (raw >~ 2160 mV at 25 degC), not 13 // a wiring fault: an ADC error shows as "poll -> FAULT" instead.
14 #include <Arduino.h>
15 #include <stdio.h>

16
17 #include "app_config.h"
18 #include "board_profile.h" 19 #include "bringup_harness.h" 20 #include "hal/adc_channel.h" 21 #include "hal/clock.h"
22 #include "drivers/tds.h"

23
24 // Water temperature from a thermometer, degC. 0 = off (no compensation). 25 // BRING-UP ONLY: stands in for the DS18B20 and is re-stamped as fresh every 26 // frame. Production feeds the real DS18B20 reading.
27 #define TDS_MANUAL_WATER_TEMP_C 0.0f

28

CHAPTER 15 / COMPENSATE THE TDS ESTIMATE

### Create a nominal driver with no invented temperature / continued

The manual temperature macro is zero to disable substitution. The configuration has no valid K-factor, so even an accepted compensated model would remain UNCALIBRATED.

test/bringup/tds_main.c / lines 29-33
29 static AdcChannel s_adc = ADC_CHANNEL_INIT;
30 static TdsConfig s_config = {&s_adc, {1.0f, 0.0f, 0, false}}; | // nominal curve, no
> | K-factor
31 static TdsDriver s_driver;

32
33 // Feed the manual temperature as a fresh OK DS18B20 reading.

### The source procedure explains expected NO TEMP and over-range outcomes. A fault label can

mean a measured model limit was exceeded, not necessarily that an electrical wire broke. Use raw voltage and the returned operation status to distinguish those paths.

CHAPTER 15 / COMPENSATE THE TDS ESTIMATE

# Make the test substitution explicit in the record

test/bringup/tds_main.c / lines 34-45
34 static void feedManualTemperature(SensorDriver* driver) { feedManualTemperature
35 | (void)driver;
36 | Reading t;
37 | readingReset(&t, SENSOR_DS18B20, METRIC_WATER_TEMPERATURE, UNIT_DEG_C); readingReset
38 | const MonoMs now = monoNowMs(); monoNowMs
39 | t.health = HEALTH_OK;
40 | t.value = TDS_MANUAL_WATER_TEMP_C;
41 | t.intervalStartMs = now;
42 | t.intervalEndMs = now;
43 | t.lastGoodMs = now;
44 | tdsDriverSetWaterTemperature(&s_driver, &t); tdsDriverSetWaterTemperature

45 }

The helper resets a water-temperature Reading with DS18B20 identity, stamps the current time and marks the manually supplied value OK before copying it into TDS. It is a deliberate fake dependency for isolated bring-up.

Refreshing its timestamp every result keeps that test constant fresh. Doing this in production would conceal a stopped real sensor. The implementation is acceptable as an experiment only because its origin and scope are explicit.

CHAPTER 15 / COMPENSATE THE TDS ESTIMATE
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
