Zer0-Dayy/Hydroponics-Monitoring-System/Documentation/SysML Diagrams.pdf

# Hydroponics Monitoring System

SysML diagrams and integrity review | Model 1.0 | 16 October 2026

This package defines one connected architecture model for the redesigned monitoring system. It contains 15 diagram sheets covering all seven requested diagram types, with stable requirement IDs, typed internal interfaces, and behavior tied to the current power and firmware design.

### Model boundary and baseline

The system contains one ESP32-S3 field node, the Python BLE commissioning application, and the monitoring backend/dashboard. External power, the measured hydroponic environment, the laptop platform, and the controlled load form its context.

The baseline is the current Redesign Specification Rev 5, including the compact voltage notation and uppercase BLE update. Hardware assignments follow the current pin and power drawings. The older firmware architecture contributes the ownership, scheduling and recovery concepts, adapted to ESP32-S3 and SGP30.

View | Sheets | Diagram IDs
Requirement diagram | 3 | REQ-01 to REQ-03
Block definition diagram | 3 | BDD-01 to BDD-03
Internal block diagram | 2 | IBD-01 and IBD-02
Activity diagram | 2 | ACT-01 and ACT-02
Sequence diagram | 3 | SD-01 to SD-03
State machine diagram | 1 | STM-01
Use case diagram | 1 | UC-01

### Reading the diagrams

BDD boxes define types; IBD labels identify part usages as name : Type. Filled diamonds mark the composite whole. Dashed dependency arrows point to their supplier, including the source requirement or included use case. Proxy ports expose the logical interface contracts detailed in BDD-03 and the interface register.

### Verification status

All 18 implementation requirements have design-responsibility and planned-test links. The shared model passes the recorded structural, control-flow, typing and bounded protocol checks. These checks verify the diagram model; the ten electrical and firmware test cases remain specified for execution on the prototype.

Diagram sheets use A3 landscape for readable engineering notation. Registers and review pages use A4. The PDF bookmarks navigate directly to each view.

Hydroponics Monitoring System | SysML model 1.0 | 16 October 2026 | 1 / 21

# REQ-01 Functional requirements and project goals

req [package Requirements]

«requirement»
Hydroponics monitoring system

id = "R0"
text = "Deliver integrated sensing, local control, outage continuity, BLE commissioning and remote monitoring with traceable validation."

All dashed dependencies in this view are «deriveReqt» relationships. Arrowheads point from the derived requirement to its source.

«requirement»
Integrated controller

id = "G1"
text = "Deliver the custom ESP32-S3 controller PCB."

«deriveReqt»

«requirement»
Controller implementation

id = "R01"
text = "Use ESP32-S3-WROOM-1-N16R8 on the custom PCB, with the current power and sensor interfaces."

«requirement»
Board interface contract

id = "R02"
text = "Implement the fixed GPIO map, protected signal interfaces, USB access, reset and boot controls."

«requirement»
Qualified measurements

id = "G2"
text = "Integrate and qualify the seven sensor functions."

«deriveReqt»

«requirement»
Seven sensor functions

id = "R03"
text = "Acquire BME280, DS18B20, DFR0026, SGP30, HC-SR04, pH-4502C, and SEN0244 data."

«requirement»
Measurement qualification

id = "R04"
text = "Attach units, age, quality and calibration revision; reject invalid compensation and preserve last-good data separately."

«requirement»
Local commissioning

id = "G5"
text = "Configure and maintain the controller through the Python BLE application."

«deriveReqt»

«requirement»
Secure BLE access

id = "R11"
text = "Use authenticated encrypted BLE, deliberate commissioning access, write-only credentials, and explicit request results."

«requirement»
Configuration transactions

id = "R12"
text = "Validate, stage, | persist a versioned
configuration, and apply | at a safe boundary;
recover the last valid commit."

«requirement»
Supported device management

id = "R13"
text = "Accept only supported types and board slots; reject conflicts, duplicate identities and invalid ranges without reflashing."

«requirement»
Remote monitoring

id = "G6"
text = "Provide live data, history, alarms, and node health."

«deriveReqt»

«requirement»
Dashboard information

id = "R14"
text = "Present live data, history, alarms, quality, age, calibration status, connectivity and power mode."

«requirement»
Network fault tolerance

id = "R15"
text = "Continue local sensing, BLE and local rules during network loss; use bounded reconnects and offline history."

Derivation arrows point from the derived requirement to its source. Requirements recur in other views by the same ID. Full satisfaction and verification coverage is in the trace matrix.

Hydroponics Monitoring System | Model 1.0 | Design baseline; execution evidence pending | 2 / 21

# REQ-02 Continuity and local behavior requirements

req [package Requirements]

«requirement»
Hydroponics monitoring system

id = "R0"
text = "Deliver integrated sensing, local control, outage continuity, BLE commissioning and remote monitoring with traceable validation."

All dashed dependencies in this view are «deriveReqt» relationships. Arrowheads point from the derived requirement to its source.

«requirement» Outage continuity | «requirement» Predictable local behavior | «requirement» Verified delivery
id = "G3" text = "Keep the retained measurements and BLE available on battery." | id = "G4" text = "Bound timing and resource use; keep local decisions independent of communications." | id = "G7" text = "Deliver the integrated system with traceable validation records."

«deriveReqt»

«requirement»
Retained monitoring

id = "R05"
text = "On battery, retain ESP32-S3, BME280, DS18B20, DFR0026, SGP30, and BLE."

«requirement»
External rail availability

id = "R06"
text = "On operating-feed loss, mark pH, TDS and HC-SR04 UNPOWERED; the external-5V relay coil is unavailable."

«requirement»
Safe transition ownership

id = "R07"
text = "Reject external-rail samples across epoch changes. Grant buses only after matching owner-release acknowledgement."

«deriveReqt»

«requirement»
Acquisition cadence

id = "R08"
text = "Use a 1 s frame, 250 ms BME280 sampling and 1 s SGP30 commands in both modes when available."

«requirement»
Local response targets

id = "R09"
text = "Targets under radio load: sample-to-action <= 10 ms; sustained BME280 software detection/action <= 300 ms."

«requirement»
Bounded resource ownership

id = "R10"
text = "Enforce one bus owner, single writers, copied records, finite waits, bounded queues and progress monitoring."

«requirement»
Relay arbitration

id = "R16"
text = "Only Safety writes GPIO15; apply power availability, local interlocks, authorization, expiry and maximum-on time."

«deriveReqt»

«requirement»
Integrated validation

id = "R17"
text = "Complete electrical, sensor, calibration, timing, outage and 24 h mixed-mode tests with recorded measurements."

«requirement»
Reproducible release

id = "R18"
text = "Deliver PCB, firmware, protocol, applications and test records with hardware, software, configuration and calibration revision IDs."

Timing figures are acceptance targets. The system-level validation requirement does not assert that any hardware or firmware test has passed.

Hydroponics Monitoring System | Model 1.0 | Design baseline; execution evidence pending | 3 / 21

# REQ-03 Satisfaction and verification relationships

req [package Assurance]

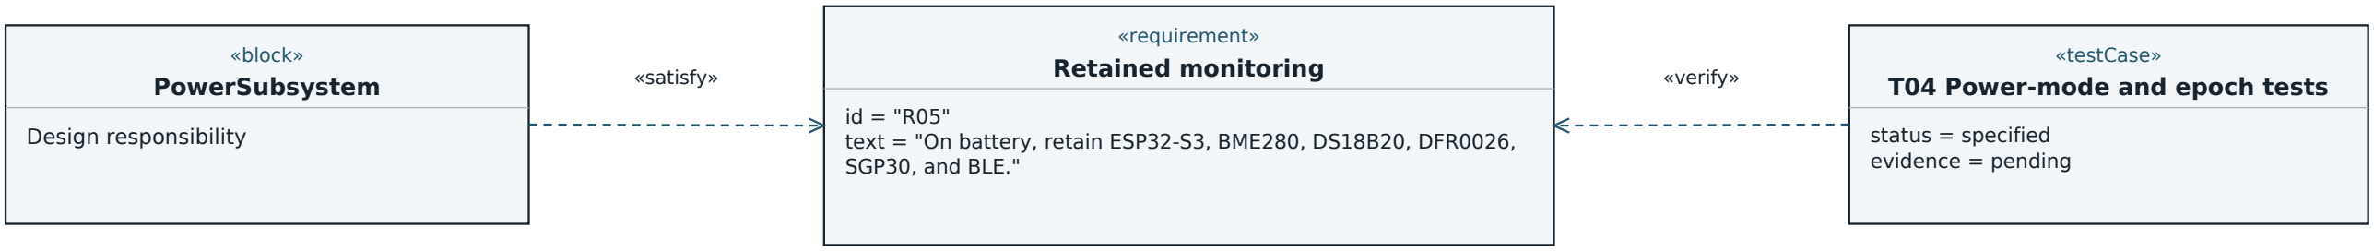
[picture p14: figure]
«block» PowerSubsystem; Design responsibility; «requirement» Retained monitoring; SGP30, and BLE."; «testCase» T04 Power-mode and epoch tests; status = specified evidence = pending; «satisfy»; «verify»

text = "On battery, retain ESP32-S3, BME280, DS18B20, DFR0026,

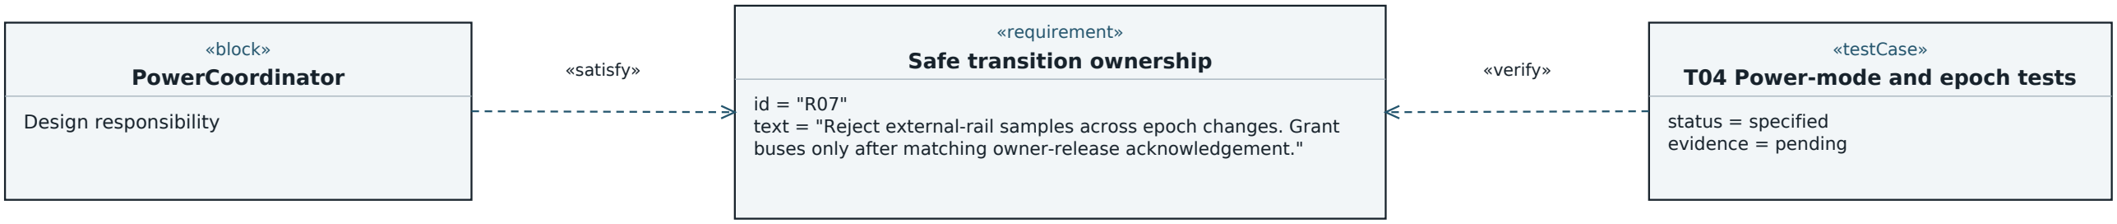
[picture p15: figure]
«block» PowerCoordinator; Design responsibility; «requirement» Safe transition ownership; «testCase» T04 Power-mode and epoch tests; status = specified evidence = pending; «satisfy»; «verify»

text = "Reject external-rail samples across epoch changes. Grant buses only after matching owner-release acknowledgement."

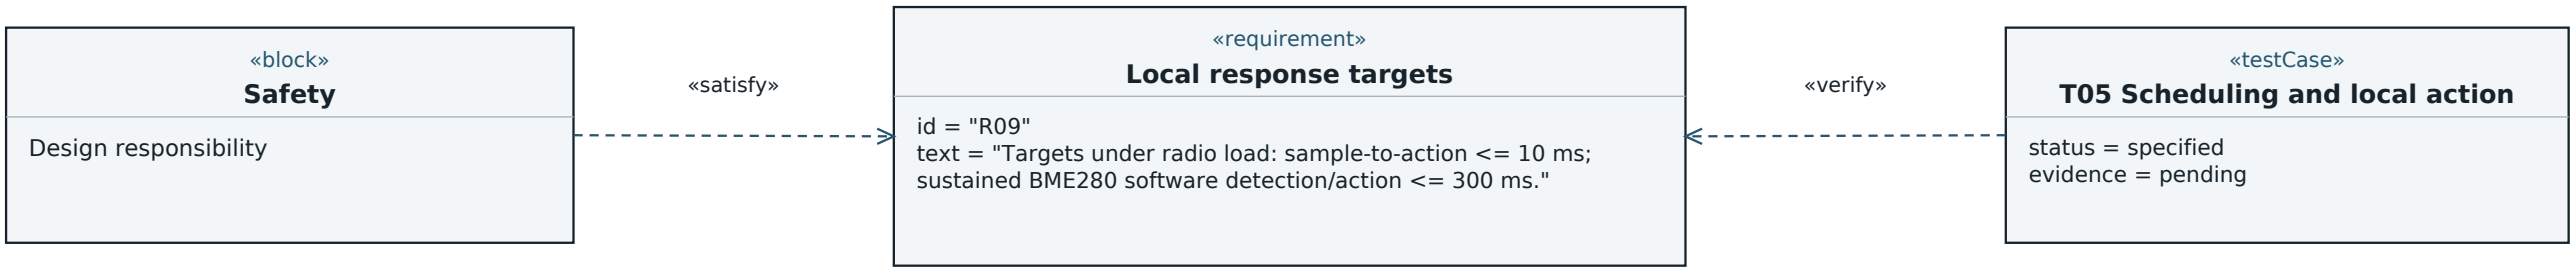
[picture p16: figure]
«block» Safety; Design responsibility; «requirement» Local response targets; «testCase» T05 Scheduling and local action; status = specified evidence = pending; «satisfy»; «verify»

text = "Targets under radio load: sample-to-action <= 10 ms; sustained BME280 software detection/action <= 300 ms."

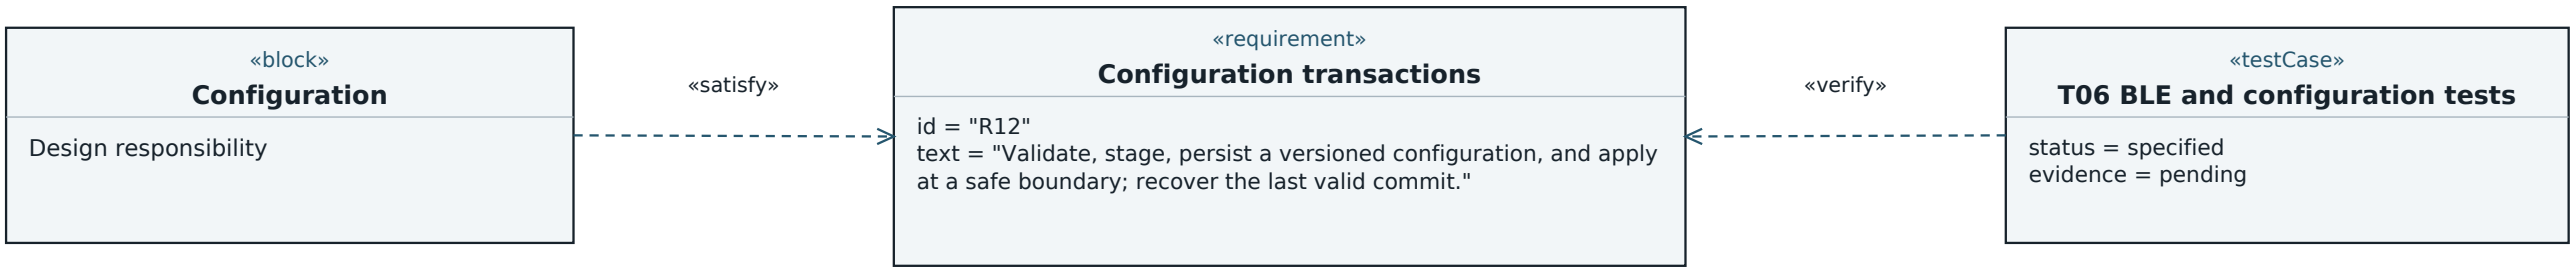
[picture p17: figure]
«block» Configuration; Design responsibility; «requirement» Configuration transactions; «testCase» T06 BLE and configuration tests; status = specified evidence = pending; «satisfy»; «verify»

text = "Validate, stage, persist a versioned configuration, and apply at a safe boundary; recover the last valid commit."

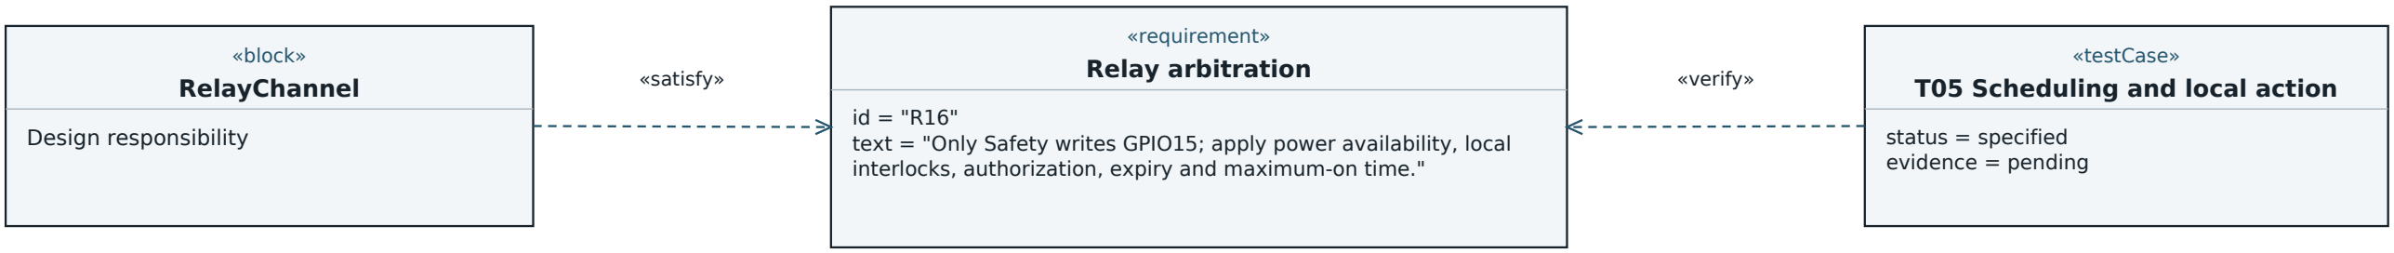
[picture p18: figure]
«block» RelayChannel; Design responsibility; «requirement» Relay arbitration; «testCase» T05 Scheduling and local action; status = specified evidence = pending; «satisfy»; «verify»

text = "Only Safety writes GPIO15; apply power availability, local interlocks, authorization, expiry and maximum-on time."

Both dependency arrowheads terminate at the requirement. «satisfy» records design responsibility; «verify» identifies a planned test case. All execution evidence remains pending.

Hydroponics Monitoring System | Model 1.0 | Design baseline; execution evidence pending | 4 / 21

# BDD-01 System composition

bdd [block HydroponicsMonitoringSystem]

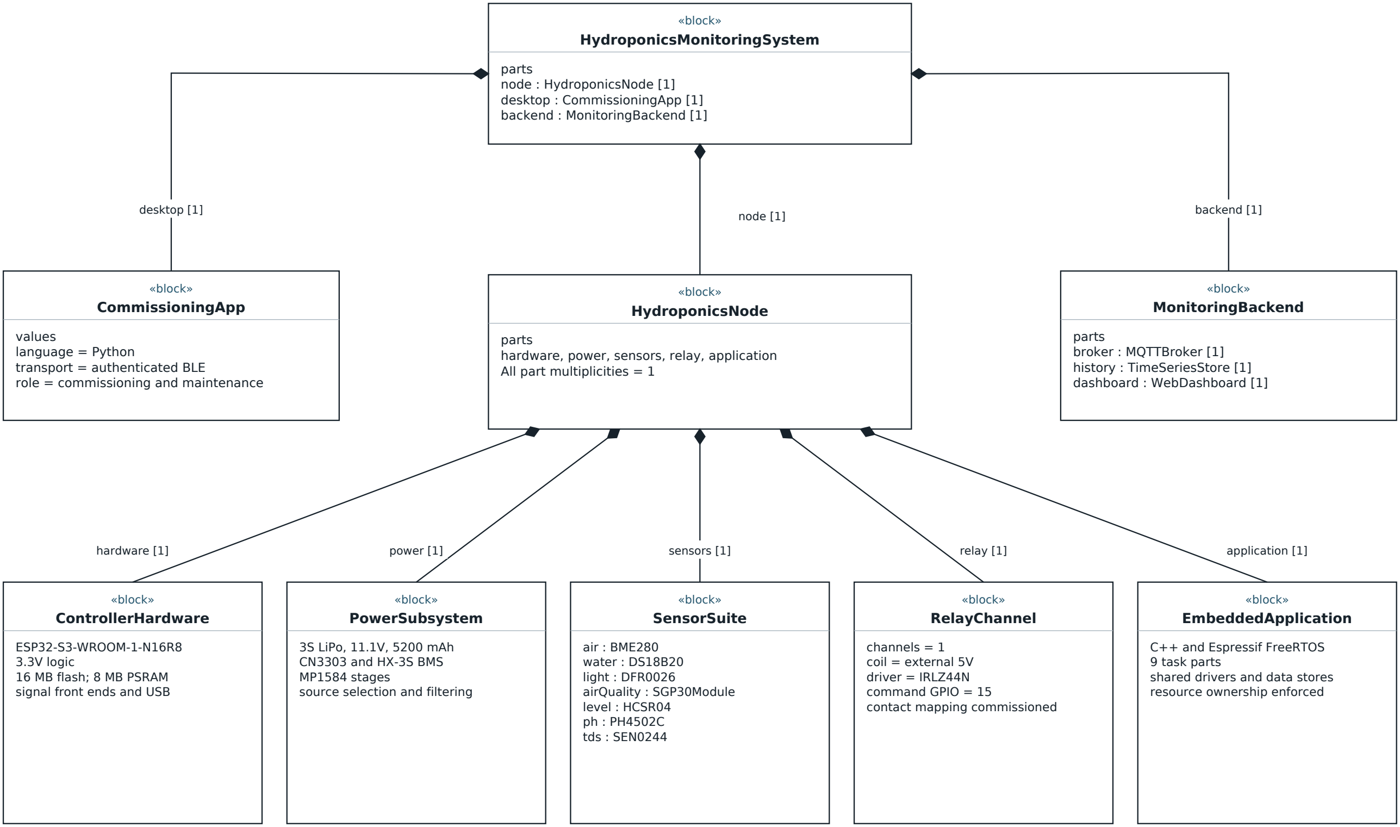
[picture p19: figure]
«block» HydroponicsMonitoringSystem; parts node : HydroponicsNode [1] desktop : CommissioningApp [1] backend : MonitoringBackend [1]; «block» HydroponicsNode; parts hardware, power, sensors, relay, application All part multiplicities = 1; «block» CommissioningApp; values language = Python transport = authenticated BLE role = commissioning and maintenance; «block» MonitoringBackend; parts broker : MQTTBroker [1] history : TimeSeriesStore [1] dashboard : WebDashboard [1]; node [1] desktop [1]; backend [1]; «block» ControllerHardware; ESP32-S3-WROOM-1-N16R8 3.3V logic 16 MB flash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

Filled diamonds are at the composite whole. Every shown part has multiplicity 1; SensorSuite contains seven named sensor parts. The charger, measured environment, laptop platform, and controlled load are external context.

Hydroponics Monitoring System | Model 1.0 | Design baseline; execution evidence pending | 5 / 21

# BDD-02 Embedded task definitions and ownership

bdd [block EmbeddedApplication]

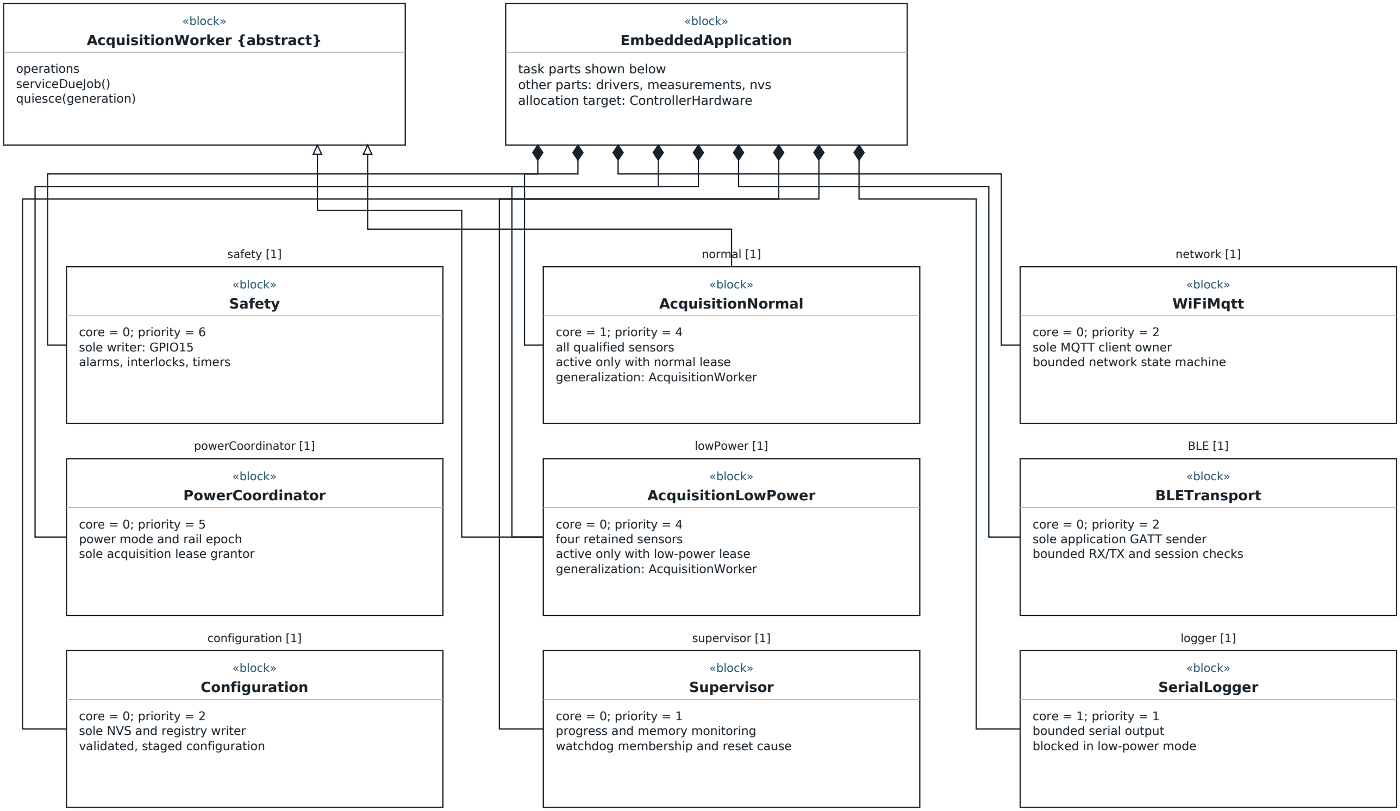
[picture p20: figure]
«block» EmbeddedApplication; task parts shown below other parts: drivers, measurements, nvs allocation target: ControllerHardware; «block» AcquisitionWorker {abstract}; operations serviceDueJob() quiesce(generation); «block» Safety; core = 0; priority = 6 sole writer: GPIO15 alarms, interlocks, timers; safety [1]; «block» AcquisitionNormal; core = 1; priority; all qualified sensors; active only with normal; lease; generalization: AcquisitionWorker; normal [1]; «block» WiFiMqtt; core = 0; priority = 2 sole MQTT client owner bounded network state machine; network [1]; «block» PowerCoordinator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

This view selects the nine task parts; driver and data-store parts remain in the canonical model. The two AcquisitionWorker specializations share an engine and are mutually exclusive. Priorities are initial design values.

Hydroponics Monitoring System | Model 1.0 | Design baseline; execution evidence pending | 6 / 21

# BDD-03 Interface and data contracts

bdd [package Interfaces and Data]

«interfaceBlock»
DCPower

flow properties
out supply : DCSupply
DCSupply includes voltage and return
Power5V, Power3V3, PackDCFeed, SelectedPower PackPower has inout supply for the pack link.

«interfaceBlock»
I2CBus

flow properties
inout commands : I2CFrame
inout measurements : I2CFrame SDA = GPIO21; SCL = GPIO47 BME280 0x76; SGP30 0x58

«interfaceBlock»
OneWireBus

flow properties
inout command_and_data : OneWireFrame DS18B20 DQ = GPIO14
externally powered at 3.3V

«interfaceBlock»
Analog3V3

flow properties
out level : ADCInputVoltage
upstream AnalogRaw carries Voltage front ends establish the fitted ADC range

«interfaceBlock»
Digital3V3

flow properties
out level : Logic3V3
TRIG, conditioned ECHO, relay command and conditioned external-power presence

«interfaceBlock»
USBBus

flow properties
inout data : USBPacket
GPIO19 D−; GPIO20 D+
22 Ω series resistors

«block»
ReadingRecord

value properties
sensorId; metricId; value; unit acquisitionStart; acquisitionEnd; lastGoodTime sampleSequence; externalRailEpoch configurationRevision; calibrationRevision quality : ReadingQuality
raw ADC value retained where applicable

«block»
ControlRequest

value properties
requestId; operation; bounded payload authenticatedIdentity; sessionGeneration expectedConfigurationRevision; expiry
result : INVALID | BUSY | REJECTED | APPLIED | FAILED
Credentials are write-only and excluded from logs.

These interface blocks type the logical proxy ports in the IBDs. Unidirectional consumers use conjugated (~) types; inout buses support requests and responses. Supply bundles include positive and return conductors. Record types describe copied data, not pointers shared between tasks.

Hydroponics Monitoring System | Model 1.0 | Design baseline; execution evidence pending | 7 / 21

# IBD-01 Power distribution and retained supplies

ibd [block PowerSubsystem]

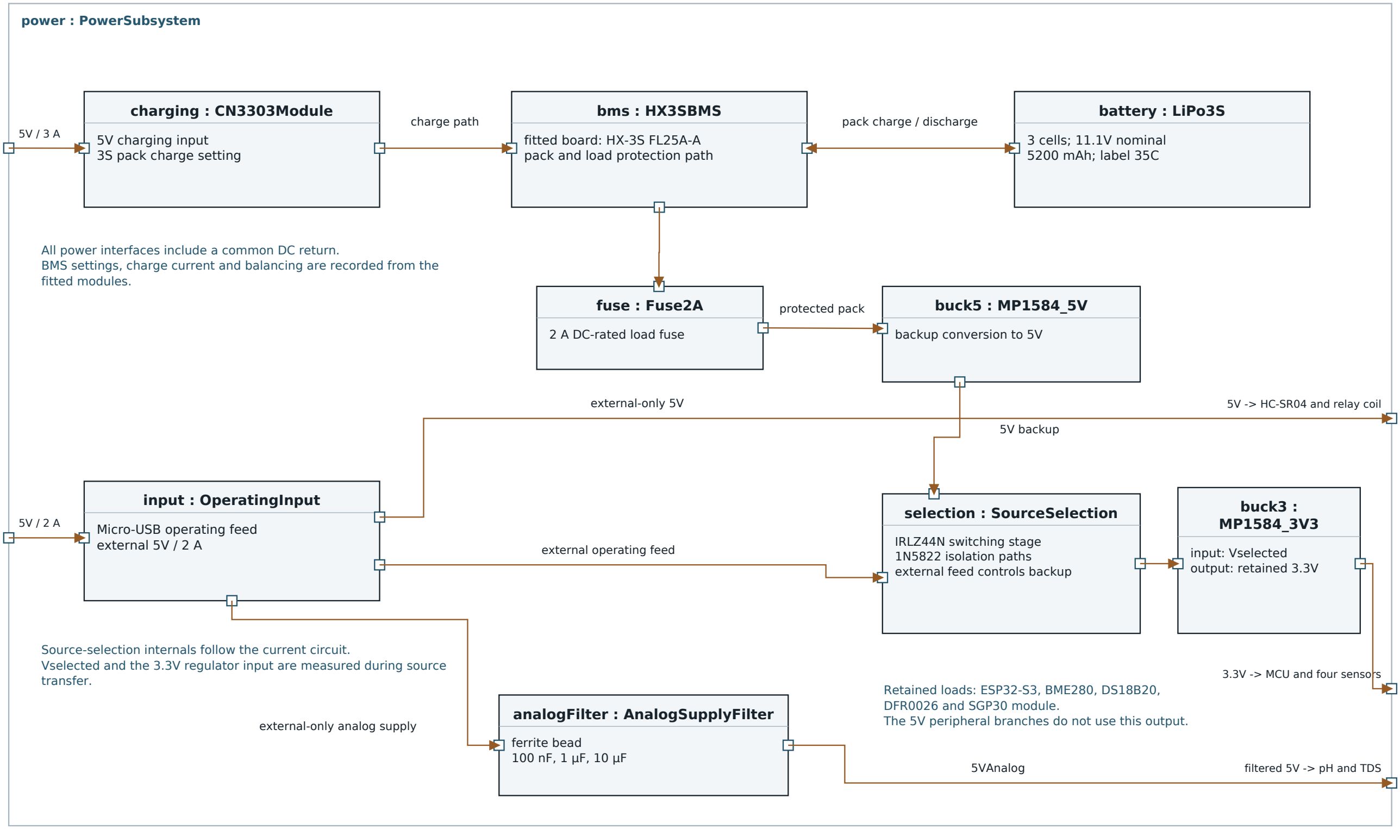
[picture p21: figure]
power : PowerSubsystem; charging : CN3303Module; 5V charging input 3S pack charge setting; bms : HX3SBMS; fitted board: HX-3S FL25A-A pack and load protection path; battery : LiPo3S; 3 cells; 11.1V nominal 5200 mAh; label 35C; fuse : Fuse2A; 2 A DC-rated load fuse; buck5 : MP1584_5V; backup conversion to 5V; input : OperatingInput; Micro-USB operating feed external 5V / 2 A; selection : SourceSelection; IRLZ44N switching stage 1N5822 isolation paths external feed controls backup; buck3 : MP1584_3V3; input: Vselected output: retained 3.3V; analogFilter : AnalogSupplyFilter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

All power interfaces include a common DC return.
BMS settings, charge current and balancing are recorded from the

Source-selection internals follow the current circuit.
Vselected and the 3.3V regulator input are measured during source

The 5V peripheral branches do not use this output.

Proxy ports are typed logical power bundles including a common return. Orange item-flow arrows indicate delivered power; the pack connection is bidirectional. Nominal rail labels do not include path losses. Exact terminal wiring remains governed by the schematic.

Hydroponics Monitoring System | Model 1.0 | Design baseline; execution evidence pending | 8 / 21

# IBD-02 Sensor signals and fixed GPIO interfaces

ibd [block HydroponicsNode]

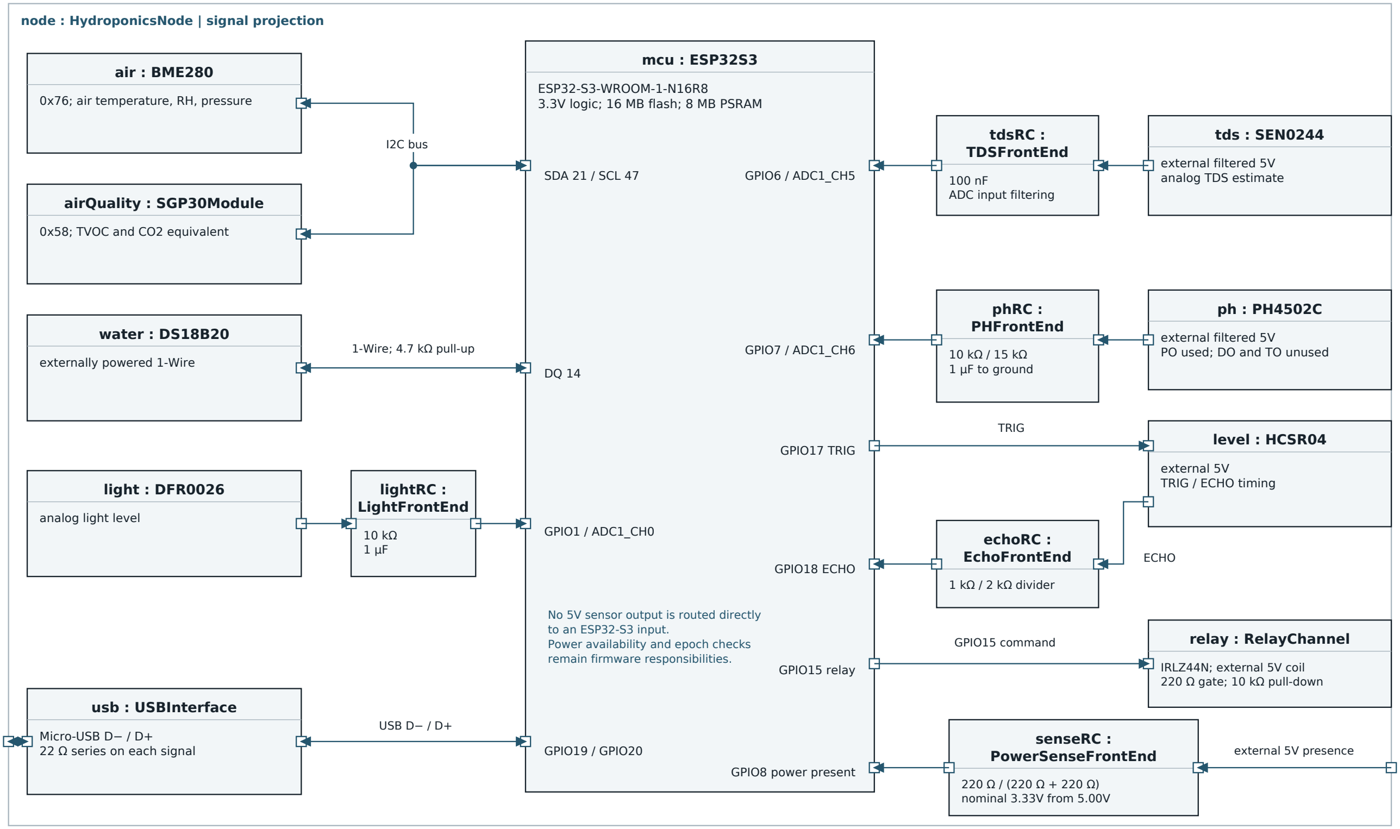
[picture p22: figure]
mcu : ESP32S3; ESP32-S3-WROOM-1-N16R8 3.3V logic; 16 MB flash; 8 MB PSRAM; air : BME280; 0x76; air temperature, RH, pressure; airQuality : SGP30Module; 0x58; TVOC and CO2 equivalent; water : DS18B20; externally powered 1-Wire; light : DFR0026; analog light level; lightRC : LightFrontEnd; tds : SEN0244; external filtered 5V analog TDS estimate; tdsRC : TDSFrontEnd; 100 nF ADC input filtering; external filtered 5V PO used; DO and TO unused; phRC : PHFrontEnd; 10 kΩ / 15 kΩ 1 µF to ground; level : HCSR04; external 5V TRIG / ECHO timing; echoRC : EchoFrontEnd; 1 kΩ / 2 kΩ divider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

node : HydroponicsNode | signal projection

This is a signal-focused projection: supply connectors are defined in IBD-01. Square proxy ports expose logical interface types. Left sensors use retained 3.3V; right sensors and the relay coil use external 5V. GPIO35-37 remain reserved for PSRAM.

Hydroponics Monitoring System | Model 1.0 | Design baseline; execution evidence pending | 9 / 21

# ACT-01 Service one due sensor job

act [activity AcquisitionWorker::serviceDueJob]

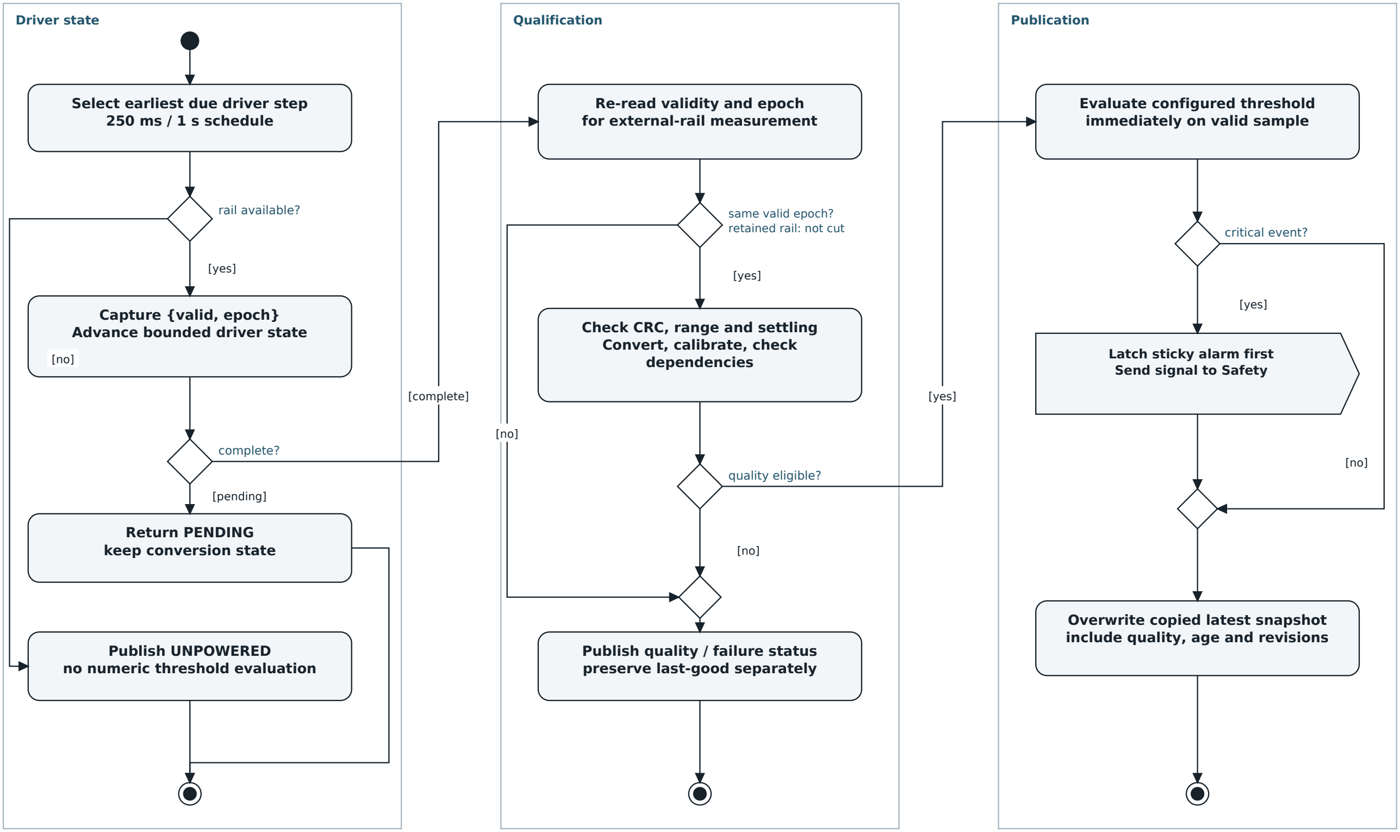
[picture p23: figure]
Driver state; Qualification; Publication; Select earliest due driver step 250 ms / 1 s schedule; rail available?; Capture {valid, epoch}; Advance bounded; driver state; complete?; Return PENDING keep conversion state; Publish; UNPOWERED; no numeric threshold evaluation; Re-read validity and epoch for external-rail measurement; same valid epoch? retained rail: not cut; Check CRC, range; and settling; Convert, calibrate, check dependencies; quality eligible?; Publish quality / failure status preserve last-good separately; Evaluate configured threshold immediately on valid sample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

Precondition: this worker holds the exclusive bus lease. Partitions show responsibilities executed by that same worker. Each activity-final returns to the scheduler; PENDING retains driver state. The send-signal action does not wait for Safety or a transport.

Hydroponics Monitoring System | Model 1.0 | Design baseline; execution evidence pending | 10 / 21

# ACT-02 Process a local alarm or control wake

act [activity Safety::processWake]

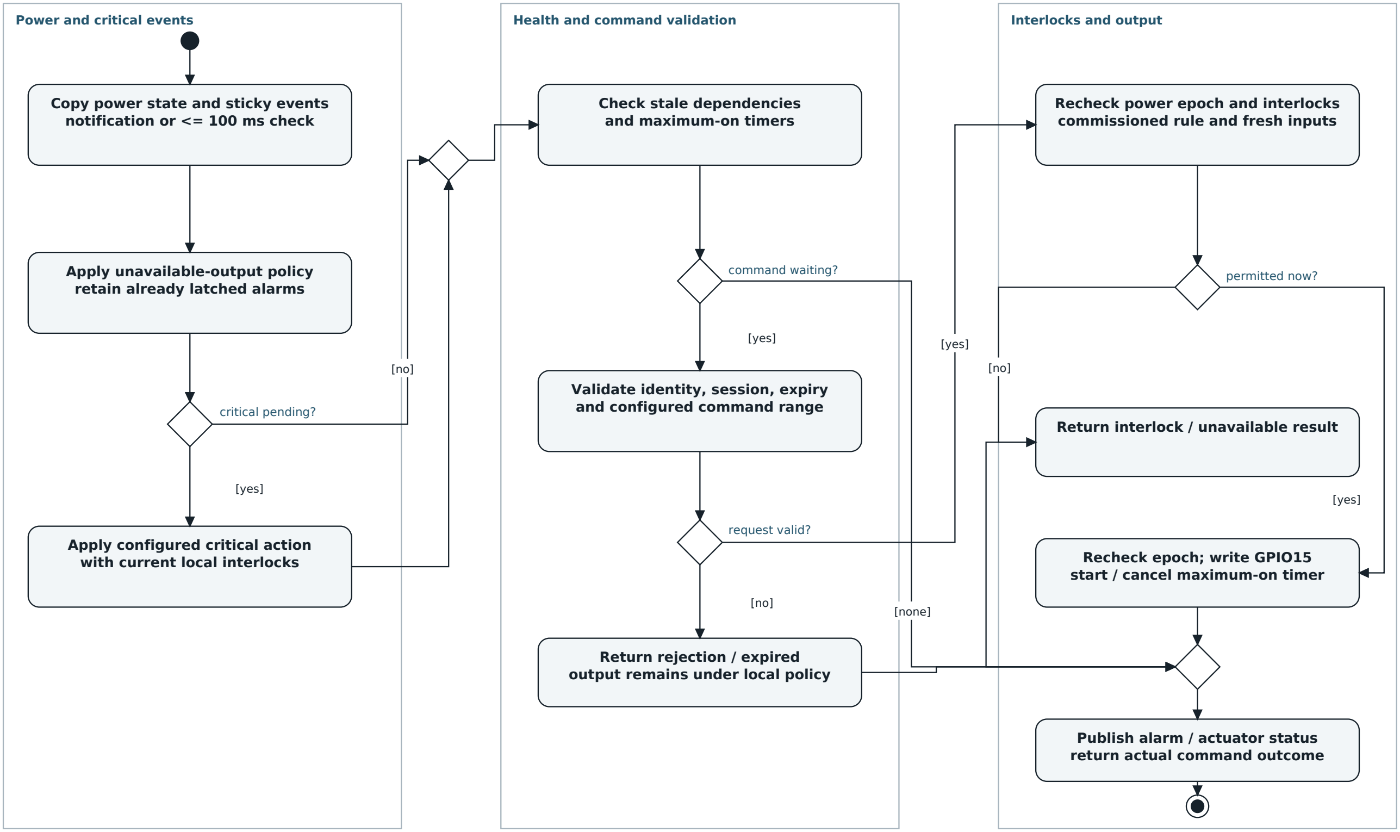
[picture p24: figure]
Power and critical events; Health and command validation; Interlocks and output; Copy power state and sticky events notification or <= 100 ms check; Apply unavailable-output policy retain already latched alarms; critical pending?; Apply configured critical action with current local interlocks; Check stale dependencies and maximum-on timers; command waiting?; Validate identity, session, expiry and configured command range; request valid?; Return rejection / expired output remains under local policy; Recheck power epoch and interlocks commissioned rule and fresh inputs; permitted now?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

Safety is the sole GPIO15 writer. Critical pending state is handled before commands. A full detail queue cannot erase the sticky alarm. The current rail epoch and interlocks are checked again immediately before actuation; a remote request cannot override them.

Hydroponics Monitoring System | Model 1.0 | Design baseline; execution evidence pending | 11 / 21

# SD-01 BLE network configuration transaction

sd [interaction ConfigureNetwork]

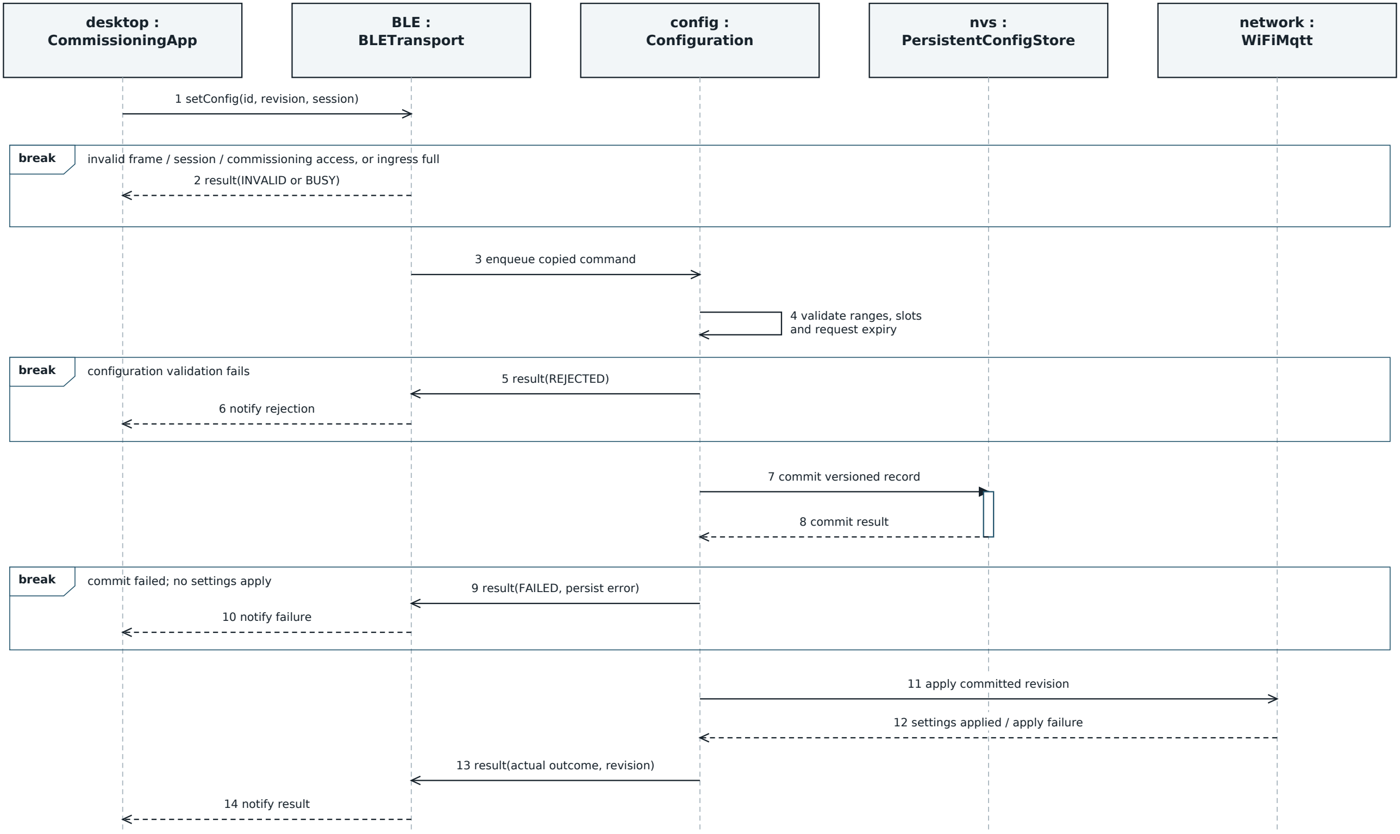
[picture p25: figure]
desktop : CommissioningApp; BLE : BLETransport; config : Configuration; nvs : PersistentConfigStore; network : WiFiMqtt; 1 setConfig(id, revision, session); 2 result(INVALID or BUSY); 3 enqueue copied command; 4 validate ranges, slots and request expiry; break; configuration validation fails; 5 result(REJECTED); 6 notify rejection; 7 commit versioned record; 8 commit result; commit failed; no settings apply; 9 result(FAILED, persist error); 10 notify failure; 11 apply committed revision; 12 settings applied / apply failure; 13 result(actual outcome, revision); 14 notify result

break invalid frame / session / commissioning access, or ingress full

The request is asynchronous at ingress. Each break fragment aborts the rest of this interaction when its guard is true. APPLIED means that network settings were applied; it does not imply a broker connection. Driver-context changes require the quiesce/release protocol before apply.

Hydroponics Monitoring System | Model 1.0 | Design baseline; execution evidence pending | 12 / 21

# SD-02 Valid sample and immediate local alarm handling

sd [interaction ProcessSample]

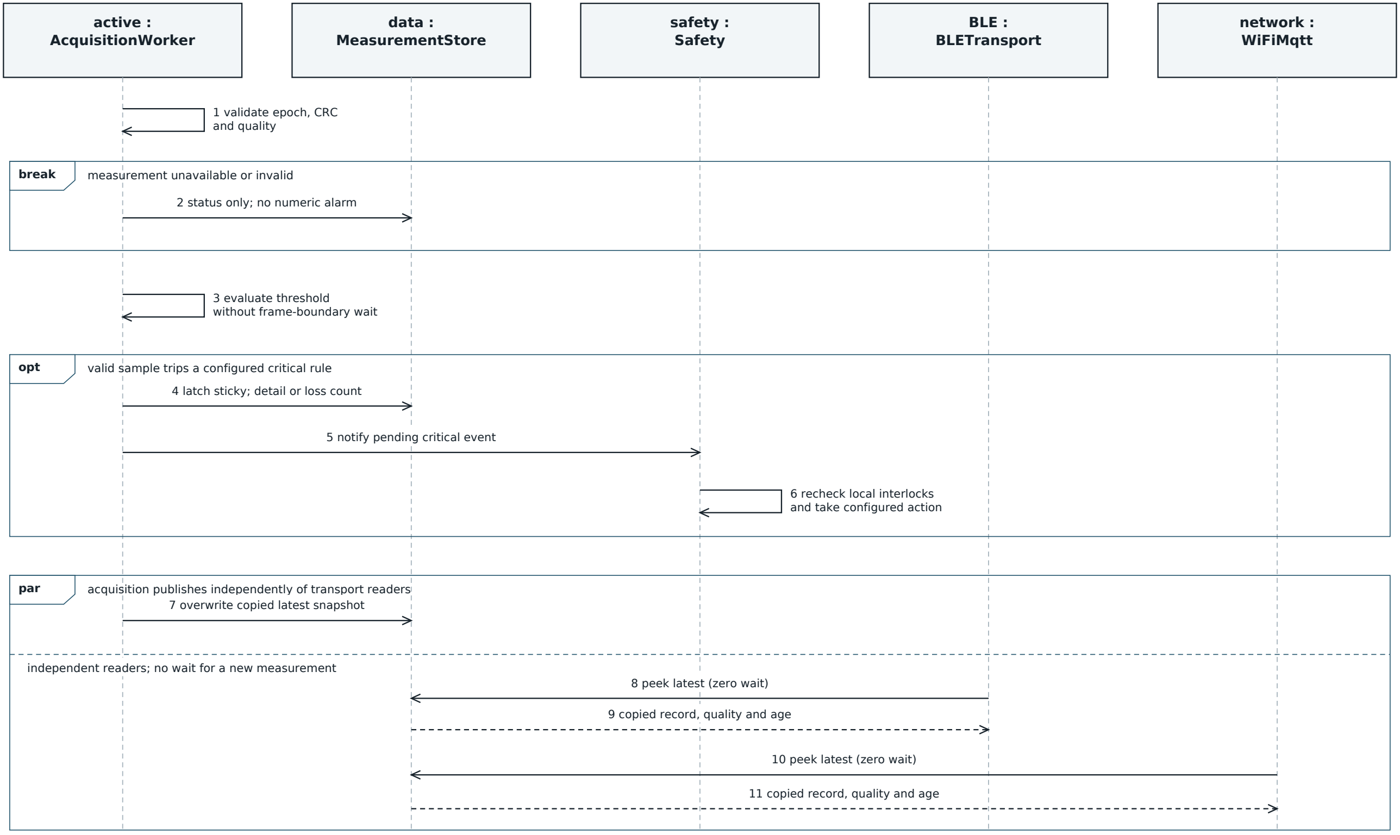
[picture p26: figure]
active : AcquisitionWorker; data : MeasurementStore; safety : Safety; BLE : BLETransport; network : WiFiMqtt; 1 validate epoch, CRC and quality; break; measurement unavailable or invalid; 2 status only; no numeric alarm; 3 evaluate threshold without frame-boundary wait; 4 latch sticky; detail or loss count; 5 notify pending critical event; 6 recheck local interlocks and take configured action; 7 overwrite copied latest snapshot; 8 peek latest (zero wait); 9 copied record,; quality and age; 10 peek latest (zero wait); 11 copied record, quality and age

opt | valid sample trips a configured critical rule
par | acquisition publishes independently of transport readers

independent readers; no wait for a new measurement

Local alarm handling precedes network delivery. Sticky alarm state survives detail-queue saturation. In the par fragment acquisition and zero-wait consumers execute independently; a consumer may receive the previous snapshot with its true age. Timing values are targets, not measured durations.

Hydroponics Monitoring System | Model 1.0 | Design baseline; execution evidence pending | 13 / 21

# SD-03 External power loss and acquisition handover

sd [interaction EnterLowPower]

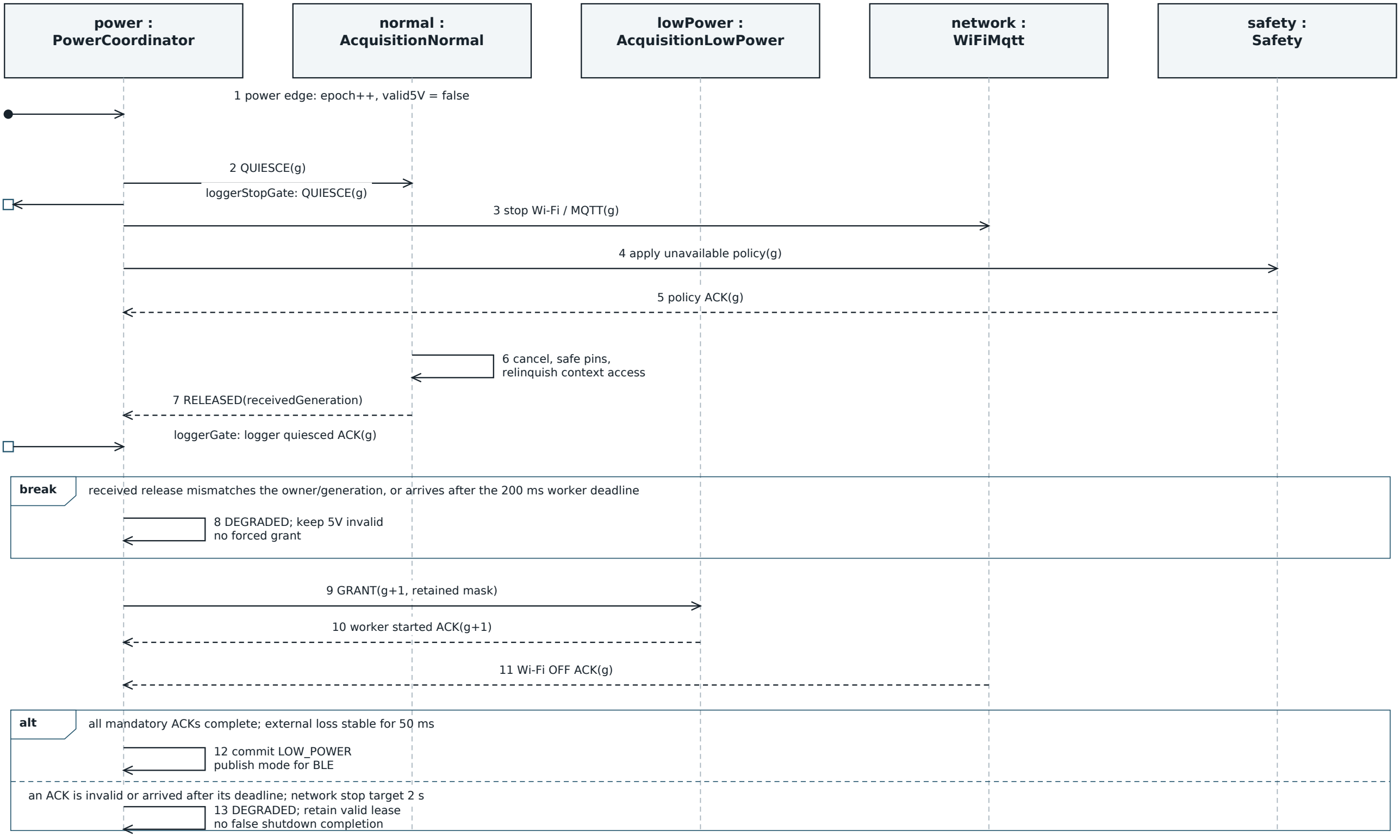
[picture p27: figure]
power : PowerCoordinator; normal : AcquisitionNormal; lowPower : AcquisitionLowPower; network : WiFiMqtt; safety : Safety; 1 power edge: epoch++, valid5V = false; 2 QUIESCE(g); loggerStopGate: QUIESCE(g); 3 stop Wi-Fi / MQTT(g); 4 apply unavailable policy(g); 5 policy; ACK(g); 6 cancel, safe pins, relinquish context access; 7 RELEASED(receivedGeneration); loggerGate: logger quiesced ACK(g); 8 DEGRADED; keep 5V invalid no forced grant; 9 GRANT(g+1,; retained mask); 10 worker started ACK(g+1); 11 Wi-Fi OFF ACK(g); 12 commit LOW_POWER publish mode for BLE

break received release mismatches the owner/generation, or arrives after the 200 ms worker deadline

alt all mandatory ACKs complete; external loss stable for 50 ms

an ACK is invalid | or arrived after its deadline; network stop target 2 s
| 13 DEGRADED; retain valid lease no false shutdown completion

This trace shows received-ACK outcomes; missing-ACK deadlines are STM-01 T10/T11. Epoch invalidation precedes debounce. GRANT(g+1) requires matching RELEASED(g). Retained acquisition may start before network shutdown completes, but LOW_POWER is committed only after timely mandatory ACKs.

Hydroponics Monitoring System | Model 1.0 | Design baseline; execution evidence pending | 14 / 21

# STM-01 Power operating modes and recovery

stm [state machine PowerCoordinator]

Transition contract

T1 | bootComplete [cfgOK && present] / Initialize normal lease; start normal services.
T2 | bootComplete [cfgOK && absent] / Initialize retained lease; Wi-Fi OFF; 5V unavailable.
T3 | bootComplete [!cfgOK] / Conservative retained-only policy; report not ready.
T4 | powerLost [observed edge] / ISR increments epoch and invalidates 5V; request quiescence.
T5 | transitionReady [absent50ms && mandatoryACKs && retainedLease] / Commit LOW_POWER; publish state.
T6 | powerPresent [observed edge] / Keep 5V invalid; begin stability and rail checks.
T7 | restoreComplete [present500ms && railsSettled && normalLease && requiredACKs] / Enable external-rail validity; reconnect network asynchronously.
T8 | powerLost [observed edge] / Abort restore; increment epoch; quiesce current owner.
T9 | powerPresent [observed edge] / Reconcile ownership; require stable power before normal grant.
T10 | ackDeadline [requiredACKMissing] / Keep 5V invalid; never force a new owner.
T11 | ackDeadline [requiredACKMissing] / Hold invalid rail; preserve exclusive ownership.
T12 | recoveryValidated [allOwnershipReconciled && cfgOK] / Reinitialize safely with no outstanding owner; re-evaluate power.

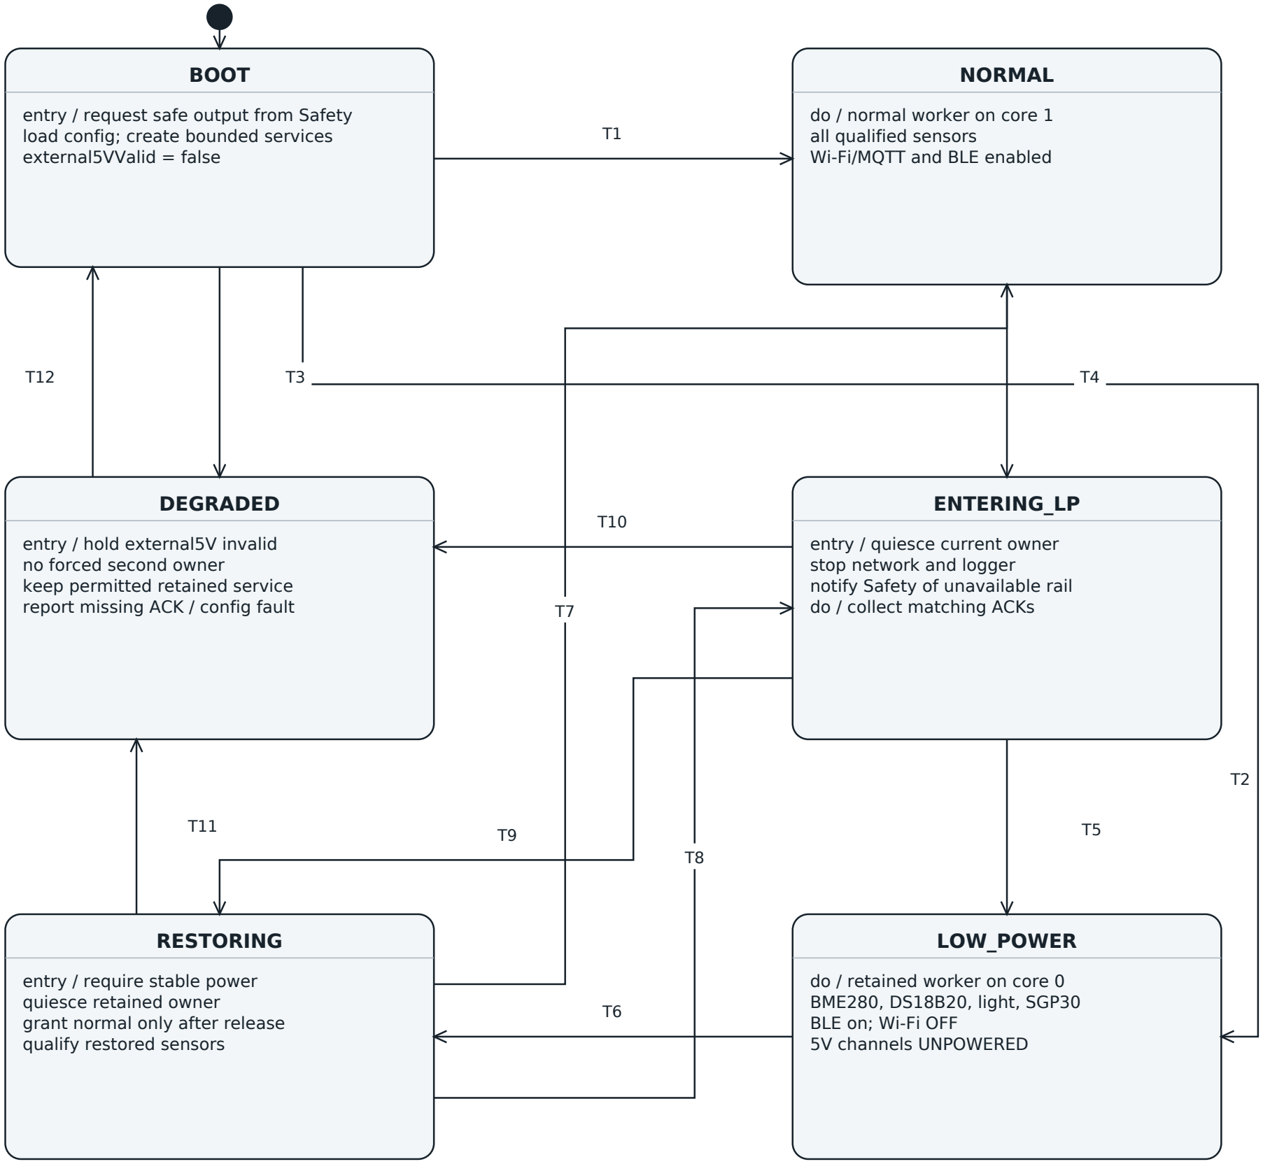
[picture p28: figure]
BOOT; entry / request safe output from Safety load config; create bounded services external5VValid = false; NORMAL; do / normal worker on core 1 all qualified sensors Wi-Fi/MQTT and BLE enabled; ENTERING_LP; entry / quiesce current owner stop network and logger notify Safety of unavailable rail do / collect matching ACKs; LOW_POWER; do / retained worker on core 0 BME280, DS18B20, light, SGP30 BLE on; Wi-Fi OFF 5V channels UNPOWERED; RESTORING; entry / require stable power quiesce retained owner grant normal only after release qualify restored sensors; DEGRADED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

Transition IDs on the graph resolve to the complete trigger / guard / effect table. cfgOK includes validated configuration and known power sense. Ownership handover is always quiesce -> matching release -> grant. There is no final state because the controller is reactive.

Hydroponics Monitoring System | Model 1.0 | Design baseline; execution evidence pending | 15 / 21

# UC-01 Operational and maintenance use cases

uc [subject HydroponicsMonitoringSystem]

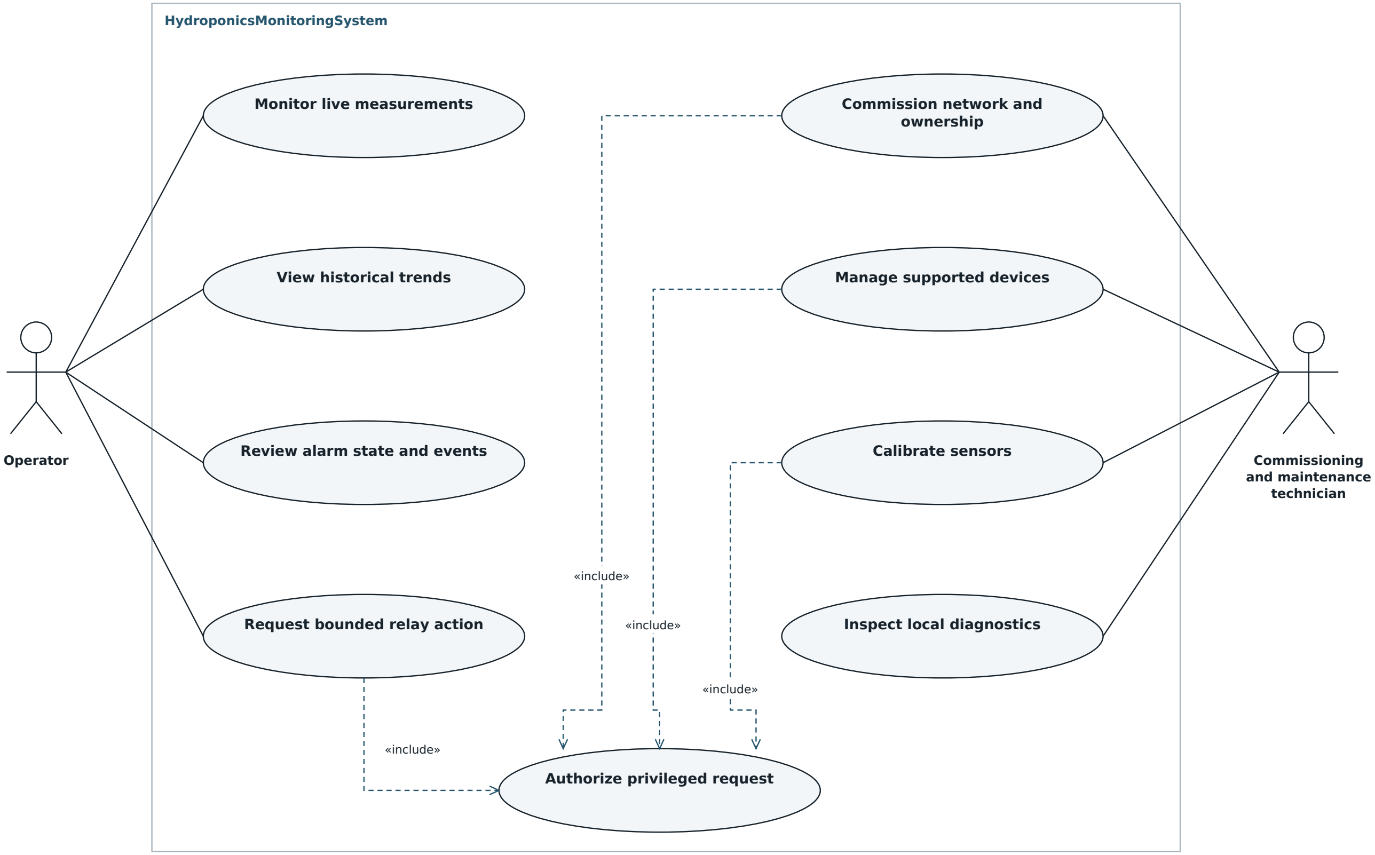
[picture p29: figure]
HydroponicsMonitoringSystem; Operator; Commissioning; and maintenance technician; Monitor live measurements; View historical trends; Review alarm state and events; Request bounded relay action; Commission network and ownership; Manage supported devices; Calibrate sensors; Inspect local diagnostics; Authorize privileged request; «include»

Actors remain outside the whole-system boundary, which contains the field node, desktop application and backend. «include» arrows point to the shared authorization behavior. Actor responsibilities do not replace the commissioned permission policy. Remote history requires backend access; local BLE remains available on battery.

Hydroponics Monitoring System | Model 1.0 | Design baseline; execution evidence pending | 16 / 21

# Requirements traceability

«satisfy» and «verify» relationships for every implementation requirement

ID and goal | Requirement | Design responsibility | Planned verification
R01 / G1 | Controller implementation | ControllerHardware, PowerSubsystem | T01
R02 / G1 | Board interface contract | ControllerHardware | T01
R03 / G2 | Seven sensor functions | SensorSuite, SensorDriverSet | T03
R04 / G2 | Measurement qualification | SensorDriverSet, MeasurementStore | T03, T09
R05 / G3 | Retained monitoring | PowerSubsystem, PowerCoordinator, BLETransport | T02, T04
R06 / G3 | External rail availability | PowerSubsystem, PowerCoordinator, Safety | T02, T04
R07 / G3 | Safe transition ownership | PowerCoordinator, AcquisitionWorker | T04
R08 / G4 | Acquisition cadence | AcquisitionWorker, SensorDriverSet | T03, T05
R09 / G4 | Local response targets | AcquisitionWorker, Safety | T05
R10 / G4 | Bounded resource ownership | EmbeddedApplication, MeasurementStore, Supervisor | T07, T08
R11 / G5 | Secure BLE access | CommissioningApp, BLETransport | T06
R12 / G5 | Configuration transactions | Configuration, PersistentConfigStore | T06
R13 / G5 | Supported device management | Configuration, CommissioningApp | T06
R14 / G6 | Dashboard information | MonitoringBackend, WebDashboard | T07
R15 / G6 | Network fault tolerance | WiFiMqtt, BLETransport, MeasurementStore | T07
R16 / G4 | Relay arbitration | Safety, RelayChannel | T04, T05, T06
R17 / G7 | Integrated validation | HydroponicsMonitoringSystem | T01, T02, T03, T04, T05, T06, T07, T08, T09
R18 / G7 | Reproducible release | HydroponicsMonitoringSystem | T10

The links express intended responsibility and verification coverage. A planned test link is not execution evidence. Full requirement text appears in REQ-01/02; the source archive also provides a traceability CSV with diagram coverage.

Hydroponics Monitoring System | SysML model 1.0 | 16 October 2026 | 17 / 21

# Planned verification cases

Execution status for T01 to T10 is pending

Test case | Required evidence
T01 PCB and pin inspection | Inspect schematic/layout and continuity against the fixed board profile.
T02 Electrical power validation | Measure charge behavior, rails, transfer, ripple, thermal rise and protection.
T03 Sensor integration | Check identity, cadence, startup, timeout, disconnect and reference response.
T04 Power-mode and epoch tests | Inject loss/return/bounce at driver steps; test ownership, availability and stale ACK rejection.
T05 Scheduling and local action | Trace frame jitter and sample-to-action/detection targets under concurrent Wi-Fi/BLE traffic.
T06 BLE and configuration tests | Test access control, framing, invalid commands, persistence, safe apply and relay authorization.
T07 Network and queue overload | Remove AP/broker for 30 min; congest transports and queues; inspect bounds and local operation.
T08 Fault and endurance tests | Inject stalls; perform 24 h mixed-mode run; record reset, memory, timing and current.
T09 Calibration evidence | Check pH buffers, TDS reference/temperature, tank geometry and light calibration if lux is reported.
T10 Release record audit | Inspect delivered files, revision identifiers, dependencies, calibration and configuration records.

### Timing and operating targets

The acquisition frame is 1 s, with BME280 checks every 250 ms and SGP30 commands every 1 s. Initial targets include ≤ 5 ms frame-release jitter, ≤ 10 ms accepted-sample-to-action, and ≤ 300 ms sustained BME280 software detection/action under concurrent radio traffic. Thermal response and actuator mechanics are measured separately.

Power-transition targets start at 50 ms loss debounce, 500 ms stable return, 200 ms worker acknowledgement, and 2 s network shutdown. Hardware measurements determine the final settings. Battery runtime is measured at the complete-board level.

Hydroponics Monitoring System | SysML model 1.0 | 16 October 2026 | 18 / 21

# Internal interface register

Logical proxy-port contracts used by IBD-01 and IBD-02

Interface | Flow contract | Application
DC power contracts | Power5V; Power3V3; PackDCFeed; PackPower; SelectedPower | Supply and common return. PackPower is bidirectional; other contracts have producer/consumer roles. SelectedPower retains path losses.
I2CBus | inout commands and measurements | Shared GPIO21 SDA / GPIO47 SCL; BME280 0x76 and SGP30 module 0x58. 4.7 kΩ pull-ups to 3.3V.
OneWireBus | inout command_and_data | DS18B20 on GPIO14, externally powered at 3.3V, with a 4.7 kΩ pull-up.
AnalogRaw | out level : Voltage | Sensor/module output before the fitted signal front end.
Analog3V3 | out level : ADCInputVoltage | Conditioned analog signal for ADC1: GPIO1 light, GPIO6 TDS, GPIO7 pH. Actual range and calibration are verified.
Digital3V3 | out level : Logic3V3 | GPIO17 TRIG, conditioned GPIO18 ECHO, GPIO15 relay command, and conditioned GPIO8 external-power presence.
Echo5V | out pulse : Logic5V | HC-SR04 ECHO before the 1 kΩ / 2 kΩ divider.
USBBus | inout data : USBPacket | GPIO19 D− / GPIO20 D+, with 22 Ω series resistance on each signal.

### Direction and delegation

For a unidirectional interface, the producer uses the declared outward flow and the consumer uses the conjugated (~) contract. Assembly connectors pair compatible ends. Delegation connects a boundary port to an internal part port with the same external role. The I2C, 1-Wire and USB buses allow bidirectional exchange.

The machine-readable connector register resolves every endpoint to a declared block port. The power view and signal view are complementary projections; a supply omitted from the signal view remains defined by the rail topology.

Hydroponics Monitoring System | SysML model 1.0 | 16 October 2026 | 19 / 21

# Model integrity review

Automated review of the shared model and drawing geometry

The reviewed model contains 26 requirements, including seven goals and 18 implementation requirements; 49 block classifiers; 14 interface contracts; and 30 typed internal connections. Every requested diagram type is represented.

Check category | Passed | Failed
Requirements | 100 | 0
Composition | 100 | 0
Hardware | 9 | 0
Ownership | 6 | 0
Diagram references | 333 | 0
Geometry | 1987 | 0
Notation | 801 | 0
Interfaces | 193 | 0
Activity semantics | 67 | 0
Sequence contracts | 33 | 0
State semantics | 33 | 0
Use cases | 25 | 0
Bounded protocol review | 46 | 0

### Bounded behavior review

The abstract lease protocol was explored over generations 0 to 3: 47 reachable states and 470 event steps. No reachable state had two owners; stale acknowledgements changed no ownership, and timeout created no new owner. An injected unsafe-grant variant produced two owners and was detected by the same review harness.

The epoch review evaluated 40 non-wrapping combinations of start/end validity and counter values. Only 4 cases were accepted, all with a valid unchanged epoch. A loss-and-return case with both boolean checks true was rejected by the epoch condition.

### What the result establishes

The result establishes model references, coverage, connector compatibility, guarded control flow, explicit merges, sequence ordering, and the stated bounded protocol properties. Drawing bounds, node overlap and connectors crossing unrelated nodes are checked, followed by visual page inspection. It does not execute firmware, measure electrical behavior, or certify native SysML/XMI-tool conformance.

Hydroponics Monitoring System | SysML model 1.0 | 16 October 2026 | 20 / 21

# Model decisions and design references

Interpretations needed to keep the views consistent

MD01 The system boundary includes one field node, the Python commissioning application and the monitoring backend. External power, the measured environment and the controlled load remain outside.

MD02 Unknown power sensing or invalid configuration is represented by DEGRADED with conservative retained-only policy. It does not report a completed low-power transition.

MD03 External 5V validity is invalidated on an observed edge before software debounce; restored channels qualify individually. Normal sensing does not wait for MQTT connection or every sensor warm-up.

MD04 Proxy-port types describe logical power and signal bundles. The IBDs preserve the selected topology and do not replace the electrical schematic or establish module performance.

MD05 Generation-tagged release is required before any new acquisition grant. DEGRADED permits no forced transfer from an unacknowledged owner.

MD06 Diagram relationships express design intent. A satisfy or verify dependency does not assert a completed hardware test. No OMG/XMI tool-conformance certification is claimed.

MD07 A DEGRADED recovery returns through BOOT only after ownership is reconciled and configuration/sense are valid. This formalizes a bounded recovery path without granting a second owner.

### Commissioning inputs

The fitted module settings, actual rail and source-transfer behavior, sensor calibration, real alarm limits, relay load/contact mapping, safe output policy, build configuration and measured timing remain release records. The current source-selection circuit and both MP1584 stages are retained for experimental validation. Hardware hysteresis remains a later iteration.

### Design sources

Redesign Specification Rev 5, sections 1-11; current Pin Layout, page 1; current Power Circuit Diagram, page 1; Firmware Architecture Rev 2, with its older hardware assumptions superseded by the current drawings. Exact source copies and SHA-256 checksums accompany the editable package.

Notation references: OMG SysML 1.6 specification entry (https://www.omg.org/spec/SysML/1.6/About-SysML) and OMG SysML v1 diagram overview. (https://www.omg.org/sysml/sysmlv1/) The supplied drawing and JSON formats support this review package; they are not an XMI repository.

Hydroponics Monitoring System | SysML model 1.0 | 16 October 2026 | 21 / 21
