Zer0-Dayy/Hydroponics-Monitoring-System/PCB Design/BOM/KiCad BOM.csv

Reference | Value | Footprint | Qty | Tolerance | Power
C1 | 1uF | ProjectPCB:C_0402_1005Metric__C1 | 1
C2 | 10uF | ProjectPCB:C_0805_2012Metric__C2 | 1
C3 | 100nF | ProjectPCB:C_0805_2012Metric_Pad1.18x1.45mm_HandSolder__C3 | 1
C4 | 1uF | ProjectPCB:C_0402_1005Metric__C4 | 1
C7 | 10nF | ProjectPCB:C_0805_2012Metric__C7 | 1
C8 | 470uF | ProjectPCB:CP_Radial_D5.0mm_P2.00mm__C8 | 1
C9 | 10uF | ProjectPCB:C_0805_2012Metric__C9 | 1
C10 | 100nF | ProjectPCB:C_0805_2012Metric__C10 | 1
C11 | 100nF | ProjectPCB:C_0805_2012Metric__C11 | 1
C12 | 100nF | ProjectPCB:C_0805_2012Metric__C12 | 1
C13 | 100nF | ProjectPCB:C_0805_2012Metric__C13 | 1
C14 | 100nF | ProjectPCB:C_0805_2012Metric__C14 | 1
C15 | 1uF | ProjectPCB:C_0402_1005Metric__C15 | 1
C16 | 470uF | ProjectPCB:CP_Radial_D5.0mm_P2.00mm__C16 | 1
C17 | 10uF | ProjectPCB:C_0805_2012Metric__C17 | 1
C18 | 100nF | ProjectPCB:C_0805_2012Metric__C18 | 1
C19 | 470uF | ProjectPCB:CP_Radial_D5.0mm_P2.00mm__C19 | 1
C20 | 10uF | ProjectPCB:C_0805_2012Metric__C20 | 1
C21 | 100nF | ProjectPCB:C_0805_2012Metric__C21 | 1
C22 | 100nF | ProjectPCB:C_0805_2012Metric__C22 | 1
C23 | 1uF | ProjectPCB:C_0402_1005Metric__C23 | 1
C24 | 10uF | ProjectPCB:C_0805_2012Metric__C24 | 1
D1 | 1N5822 | ProjectPCB:D_DO-201AD_P15.24mm_Horizontal__D1 | 1
D2 | 1N5822 | ProjectPCB:D_DO-201AD_P15.24mm_Horizontal__D2 | 1
F1 | Fuse | ProjectPCB:Fuse_Littelfuse_395Series__F1 | 1
J1 | 10104110-0001LF | ProjectPCB:USB_Micro-B_Amphenol_10104110_Horizontal | 1
J2 | BME280 | ProjectPCB:TerminalBlock_Phoenix_MKDS-1,5-4-5.08_1x04_P5.08mm_Horizontal__J2 | 1
J3 | 10104110-0001LF | ProjectPCB:USB_Micro-B_Amphenol_10104110_Horizontal | 1
J4 | DS18B20 | ProjectPCB:TerminalBlock_Phoenix_MKDS-1,5-3-5.08_1x03_P5.08mm_Horizontal__J4 | 1
J5 | SEN0244 | ProjectPCB:TerminalBlock_Phoenix_MKDS-1,5-3-5.08_1x03_P5.08mm_Horizontal__J5 | 1
J6 | Battery Power | ProjectPCB:TerminalBlock_Phoenix_MKDS-1,5-2-5.08_1x02_P5.08mm_Horizontal__J6 | 1
J7 | HC-SR04 | ProjectPCB:TerminalBlock_Phoenix_MKDS-1,5-4-5.08_1x04_P5.08mm_Horizontal__J7 | 1
J8 | DFR0026 | ProjectPCB:TerminalBlock_Phoenix_MKDS-1,5-3-5.08_1x03_P5.08mm_Horizontal__J8 | 1
J9 | MP1584 5V_Battery | ProjectPCB:MP1584EN_Module__J9 | 1
J10 | MRB045 | ProjectPCB:Charger_3S_TypeC_MRB045__J10 | 1
J11 | SGP30 | ProjectPCB:TerminalBlock_Phoenix_MKDS-1,5-4-5.08_1x04_P5.08mm_Horizontal__J11 | 1
J12 | MP1584 3V3 | ProjectPCB:MP1584EN_Module__J12 | 1
J13 | Relay | ProjectPCB:TerminalBlock_Phoenix_MKDS-1,5-3-5.08_1x03_P5.08mm_Horizontal__J13 | 1
J14 | pH-4502C | ProjectPCB:TerminalBlock_Phoenix_MKDS-1,5-4-5.08_1x04_P5.08mm_Horizontal__J14 | 1
Q1 | IRLZ44N | ProjectPCB:TO-220-3_Vertical__Q1 | 1
Q2 | IRLZ44N | ProjectPCB:TO-220-3_Vertical__Q2 | 1
R1 | 10 K-Ohms | ProjectPCB:R_0603_1608Metric__R1 | 1
R2 | 10 K-Ohms | ProjectPCB:R_0603_1608Metric__R2 | 1
R3 | 22 | ProjectPCB:R_0603_1608Metric__R3 | 1
R4 | 22 | ProjectPCB:R_0603_1608Metric__R4 | 1
R5 | 10k | ProjectPCB:R_0603_1608Metric__R5 | 1
R6 | 4.7 k-Ohms | ProjectPCB:R_0603_1608Metric__R6 | 1
R7 | 4.7 k-Ohms | ProjectPCB:R_0603_1608Metric__R7 | 1
R8 | 4.7 K-Ohms | ProjectPCB:R_0603_1608Metric__R8 | 1
R9 | 15k | ProjectPCB:R_0603_1608Metric__R9 | 1
R10 | 10k | ProjectPCB:R_0603_1608Metric__R10 | 1
R11 | 6.8k | ProjectPCB:R_0603_1608Metric__R11 | 1 | 1%
R12 | 6.8k | ProjectPCB:R_0603_1608Metric__R12 | 1 | 1%
R13 | 10k | ProjectPCB:R_0603_1608Metric__R13 | 1 | 1%
R14 | 15k | ProjectPCB:R_0603_1608Metric__R14 | 1 | 1%
R15 | 10k | ProjectPCB:R_0603_1608Metric__R15 | 1 | 1%
R16 | 1 K-Ohms | ProjectPCB:R_1206_3216Metric__R16 | 1 |  | 0.25W minimum
R17 | 100 K-Ohms | ProjectPCB:R_0603_1608Metric__R17 | 1
R18 | 10 K-Ohms | ProjectPCB:R_0603_1608Metric__R18 | 1
R19 | 220 Ohms | ProjectPCB:R_0603_1608Metric__R19 | 1
SW1 | RST | ProjectPCB:SW_PUSH_6mm_H7.3mm__SW1 | 1
SW2 | BOOT | ProjectPCB:SW_PUSH_6mm_H7.3mm__SW2 | 1
U1 | ESP32-S3-WROOM-1 | ProjectPCB:ESP32-S3-WROOM-1__U1 | 1
