Zer0-Dayy/Hydroponics-Monitoring-System/PCB Design/BOM/PCB Components.csv

References | Qty | Value | Package / specification | 2B Trading link | CoThings link | Match / action | Notes
C1, C4, C15, C23 | 4 | 1uF | 0402; >=10V | https://2btrading.tn/resistance/8449-kit-d-assortiment-de-resistances-a-puce-smt-0805-1-smd.html |  | Kit only | 0402 capacitor kit only; confirm 1uF rating or request loose supply.
C2, C9, C17, C20, C24 | 5 | 10uF | 0805; 10V X7R | https://2btrading.tn/condensateur/8833-cs2012x7r106k100nre-10v-10uf-10-0805-multilayer-ceramic-capacitors-mlcc-smdsmt.html |  | Listed | CS2012X7R106K100NRE; quantity not confirmed.
C3, C10, C11, C12, C13, C14, C18, C21, C22 | 9 | 100nF | 0805; >=10V | https://2btrading.tn/condensateur/8834-ct41g-0805-2x1-50v-01f-mn-50v-100nf-2x1-20-0805-multilayer-ceramic-capacitors-mlcc-smdsmt.html |  | Listed | 50V 2X1 +/-20% listed; confirm dielectric/stock. C3 uses larger lands.
C7 | 1 | 10nF | 0805; 50V X7R | https://2btrading.tn/condensateur/343-condensateur-ceramique-multicouche-mlcc-50v-10nf-x7r-10-0805-cc0805krx7r9bb103.html |  | Listed | CC0805KRX7R9BB103; quantity not confirmed.
C8, C16, C19 | 3 | 470uF | Radial; D5mm; P2mm | https://2btrading.tn/65-condensateur?page=9 | https://cothings.net/products/condensateur-electrolytique-16v-470f-1-pcs | Verify dimensions | Local listings omit can diameter and pitch. Measure parts before ordering assembly. See fabrication notes.
D1, D2 | 2 | 1N5822 | DO-201AD; P15.24mm | https://2btrading.tn/diode/3396-1n5822-3a-40v-schottky-barrier-rectifiers.html |  | Listed | 1N5822; 3A/40V; cathode band at pad 1.
F1 | 1 | Fuse | 2A; 395 radial; P5.08mm | https://2btrading.tn/113-fusible?page=4 |  | Exact part missing | 5.08mm radial footprint. Specify the DC voltage and interrupt rating for the actual battery. Verify body fit.
J1, J3 | 2 | 10104110-0001LF | Amphenol Micro-B, horizontal SMT | https://2btrading.tn/connectiques/4689-connecteur-micro-usb-5pos.html |  | Confirm exact footprint | J1 data, J3 5V input. Generic 2B part needs matching signal and all four SMT shell pads.
J2, J7, J11, J14 | 4 | 4-way terminal | 4-way terminal; P5.08mm | https://2btrading.tn/bornier-fiche/3115-bornier-4vis-508mm-bleu.html |  | Verify dimensions | Connector only; external sensors are not PCB assembly parts.
J4, J5, J8, J13 | 4 | 3-way terminal | 3-way terminal; P5.08mm | https://2btrading.tn/80-bornier-fiche?page=2 |  | Verify dimensions | Category listing only; confirm body/lead geometry.
J6 | 1 | 2-way terminal | 2-way terminal; P5.08mm | https://2btrading.tn/connectiques/8319-bornier-2vis-508mm-orange.html |  | Verify dimensions | Confirm body/lead geometry and wire-entry direction.
Q1, Q2 | 2 | IRLZ44N | TO-220-3; IRLZ44N | https://2btrading.tn/transistor-igbt/10846-irlz44-n-channel-mosfet-60v-50a-to-220.html |  | Confirm N suffix | Listing is IRLZ44 without N. Exact marking/datasheet required before substitution.
R1, R2, R5, R10, R18 | 5 | 10k ohm | 0603; 5% | https://2btrading.tn/resistance/1105-821-resistance-smd-0603.html |  | Select value | Family listing: choose the stated value; variant quantity unconfirmed.
R3, R4 | 2 | 22 ohm | 0603; 5% | https://2btrading.tn/resistance/1105-821-resistance-smd-0603.html |  | Select value | Family listing: choose the stated value; variant quantity unconfirmed.
R6, R7, R8 | 3 | 4.7k ohm | 0603; 5% | https://2btrading.tn/resistance/1105-821-resistance-smd-0603.html |  | Select value | Family listing: choose the stated value; variant quantity unconfirmed.
R9 | 1 | 15k ohm | 0603; 5% | https://2btrading.tn/resistance/1105-821-resistance-smd-0603.html |  | Select value | Family listing: choose the stated value; variant quantity unconfirmed.
R11, R12 | 2 | 6.8k ohm | 0603; 1% | https://2btrading.tn/resistance/5403-kit-resistances-format-livre-smd-0603-1-8500-pieces.html |  | Kit only | Example MPN RC0603FR-076K8L. Confirm kit contents or request loose 1% parts.
R13, R15 | 2 | 10k ohm | 0603; 1% | https://2btrading.tn/resistance/5403-kit-resistances-format-livre-smd-0603-1-8500-pieces.html |  | Kit only | Example MPN RC0603FR-0710KL. Confirm kit contents or request loose 1% parts.
R14 | 1 | 15k ohm | 0603; 1% | https://2btrading.tn/resistance/5403-kit-resistances-format-livre-smd-0603-1-8500-pieces.html |  | Kit only | Example MPN RC0603FR-0715KL. Confirm kit contents or request loose 1% parts.
R16 | 1 | 1k ohm | 1206; 1k; >=0.25W | https://2btrading.tn/resistance/1388-827-resistance-smd-cms-1206-5-250mw.html |  | Select value | Select 1k; 250mW family. About 0.159W at 12.6V.
R17 | 1 | 100k ohm | 0603; 5% | https://2btrading.tn/resistance/1105-821-resistance-smd-0603.html |  | Select value | Family listing: choose the stated value; variant quantity unconfirmed.
R19 | 1 | 220 ohm | 0603; 5% | https://2btrading.tn/resistance/1105-821-resistance-smd-0603.html |  | Select value | Family listing: choose the stated value; variant quantity unconfirmed.
SW1, SW2 | 2 | Tactile pushbutton | 6x6mm THT; H7.3mm | https://2btrading.tn/commutateurs/9676-bouton-poussoir-tactile-6x6-tl1105vf160q.html |  | Verify dimensions | SW1 reset, SW2 boot. Confirm TL1105VF160Q lead spacing, contacts and height.
U1 | 1 | ESP32-S3-WROOM-1 | Bare WROOM-1; PCB antenna | https://2btrading.tn/accueil/10357-module-esp32-s3-wroom-1-wifi-80211abgn-bluetooth-v50-24ghz-pcb-trace-8mb.html |  | Confirm suffix | 8MB-flash module listed; confirm full suffix and firmware memory configuration.
