Zer0-Dayy/Hydroponics-Monitoring-System/PCB Design/Documentation/Assembly Preview.png

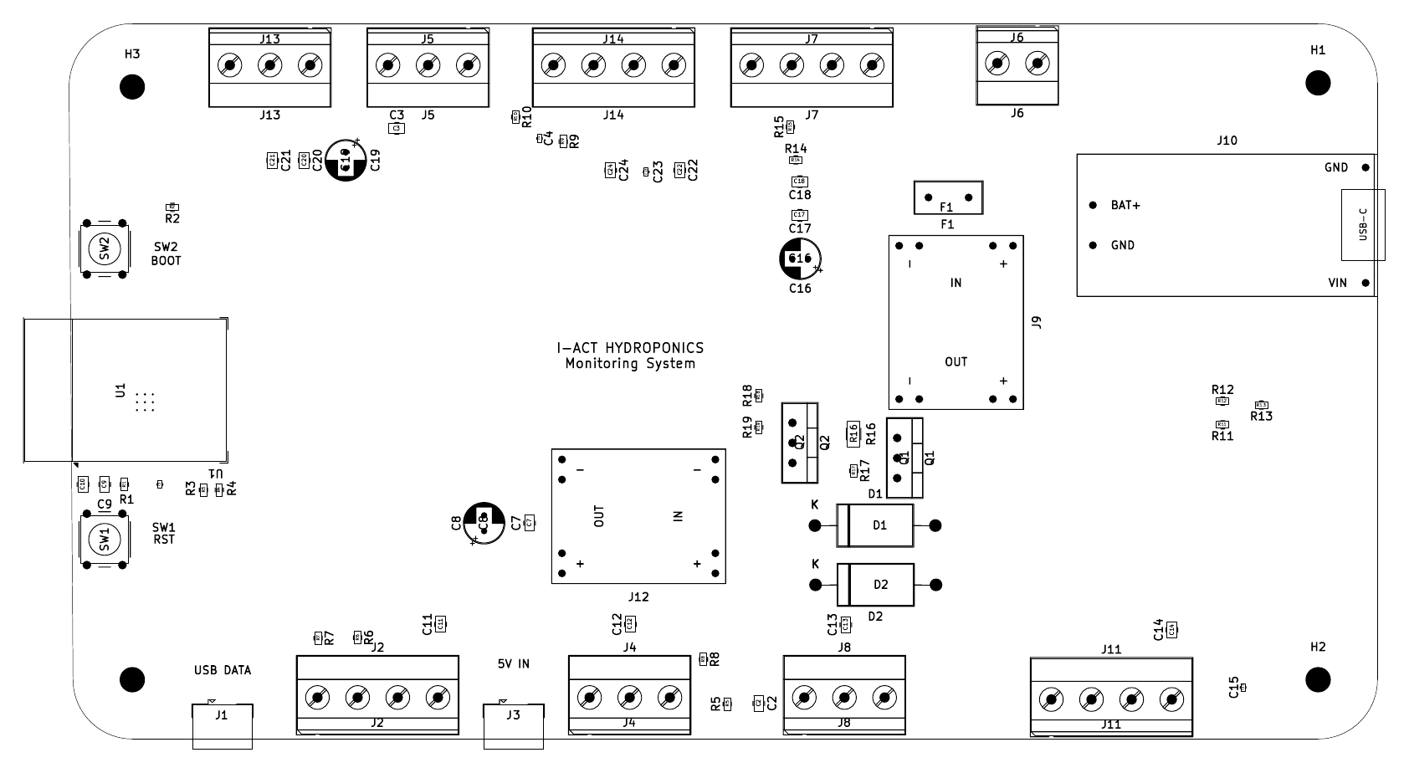
PCB Design/Documentation/Assembly Preview.png
