Zer0-Dayy/Hydroponics-Monitoring-System/PCB Design/Documentation/PCB Design.pdf

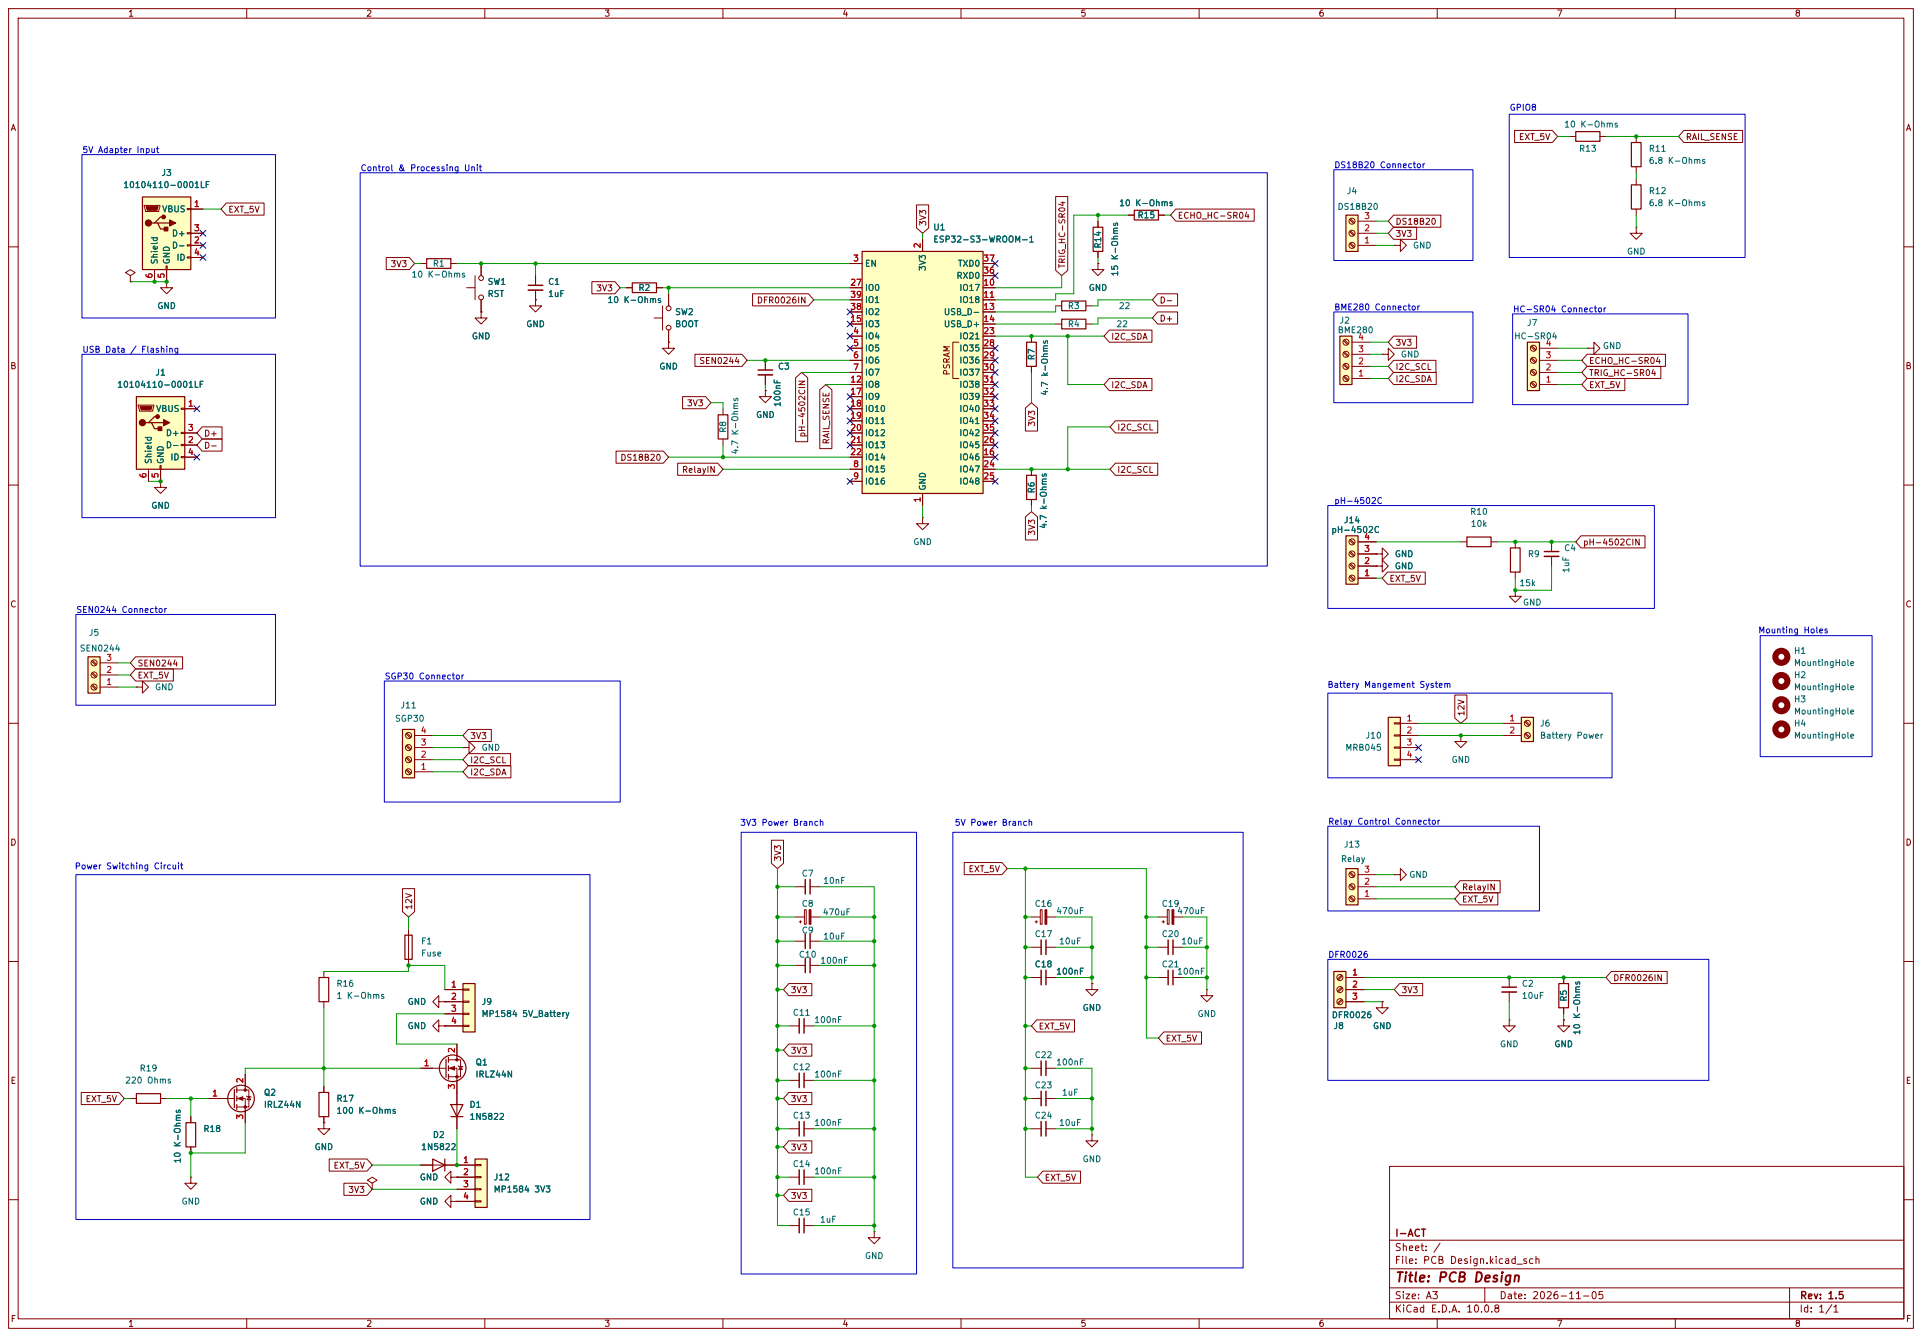
[picture p31: page 1]

pH-4502C USB Data / Flashing SEN0244 Connector

Size: A3 | Rev: 1.5 | F Date: 2026-11-05
KiCad E.D.A. 10.0.8 | Id: 1/1
