Zer0-Dayy/Hydroponics-Monitoring-System/Documentation/Pin Layout.pdf

## ESP32-S3-WROOM-1-N16R8 (3.3 V logic)

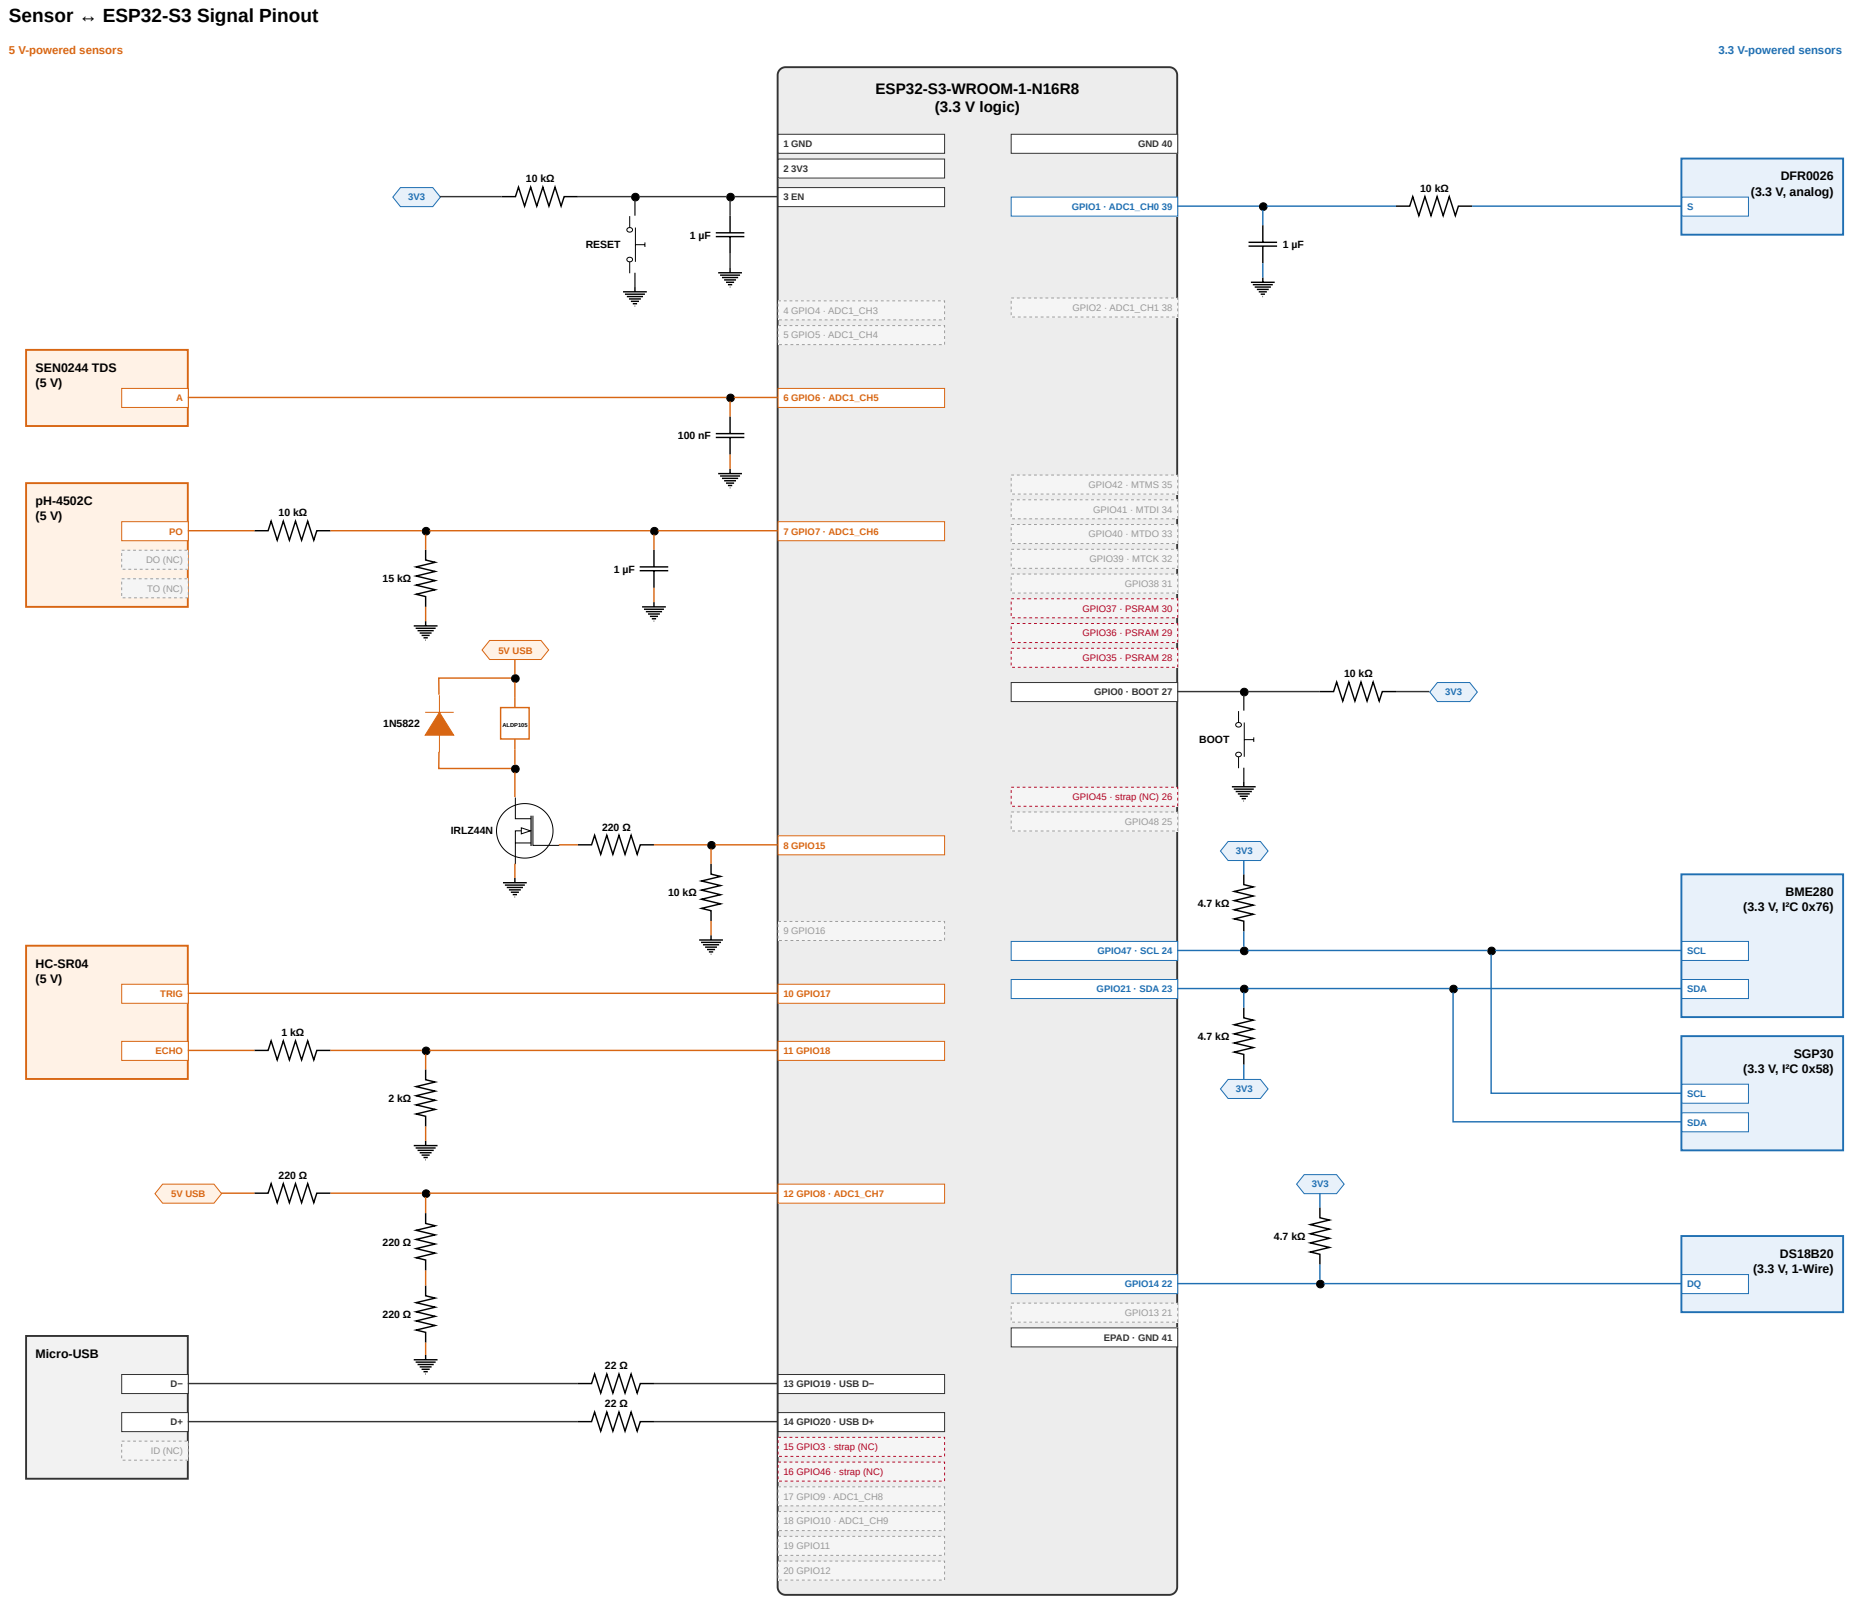
[picture p32: page 1]
1 GND; 4 GPIO4 · ADC1_CH3; 5 GPIO5 · ADC1_CH4; 6 GPIO6 · ADC1_CH5; 7 GPIO7 · ADC1_CH6; 8 GPIO15; 9 GPIO16; 10 GPIO17; 11 GPIO18; 12 GPIO8 · ADC1_CH7; 13 GPIO19 · USB D−; 14 GPIO20 · USB D+; 15 GPIO3 · strap (NC); 16 GPIO46 · strap (NC); 17 GPIO9 · ADC1_CH8; 18 GPIO10 · ADC1_CH9; 19 GPIO11; 20 GPIO12; GND 40; GPIO1 · ADC1_CH0 39; GPIO2 · ADC1_CH1 38; GPIO42 · MTMS 35; GPIO41 · MTDI 34; GPIO40 · MTDO 33; GPIO39 · MTCK 32; GPIO38 31; GPIO37 · PSRAM 30; GPIO36 · PSRAM 29; GPIO35 · PSRAM 28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

Sensor ↔ ESP32-S3 Signal Pinout
