Zer0-Dayy/Hydroponics-Monitoring-System/Documentation/Power Circuit Diagram.pdf

## LIPO Battery 3S

## 11.1V - 5200MAH 35C

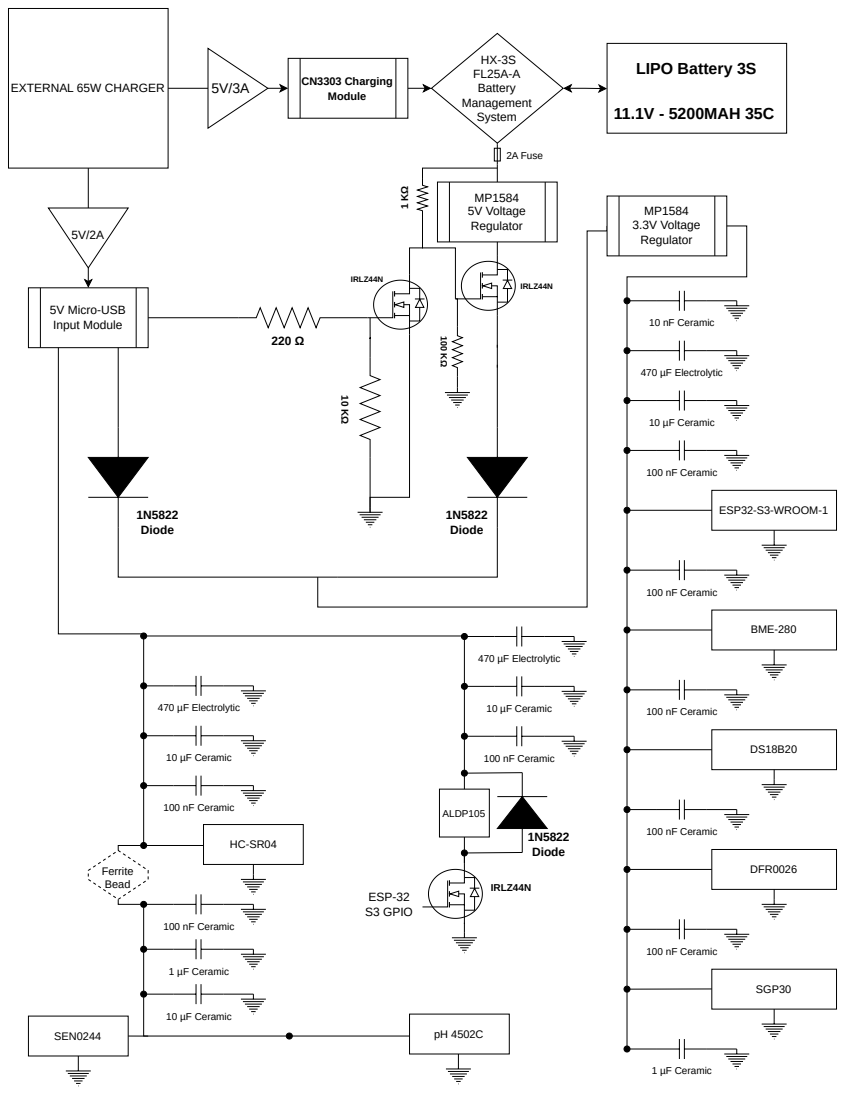
[picture p33: page 1]
EXTERNAL 65W CHARGER; 5V Micro-USB Input Module; CN3303 Charging Module; MP1584 5V Voltage Regulator; 1N5822 Diode; IRLZ44N; MP1584 3.3V Voltage Regulator; HX-3S FL25A-A Battery Management System; 10 nF Ceramic; 470 µF Electrolytic; 10 µF Ceramic; 100 nF Ceramic; ESP32-S3-WROOM-1; BME-280; DFR0026; SGP30; 1 µF Ceramic; SEN0244; ESP-32 S3 GPIO; ALDP105; Ferrite Bead; Diode; 2A Fuse
