Zer0-Dayy/Hydroponics-Monitoring-System/Documentation/Electrical System Diagram.pdf

## LIPO Battery 2S

## 7.4V - 2600MAH 25C

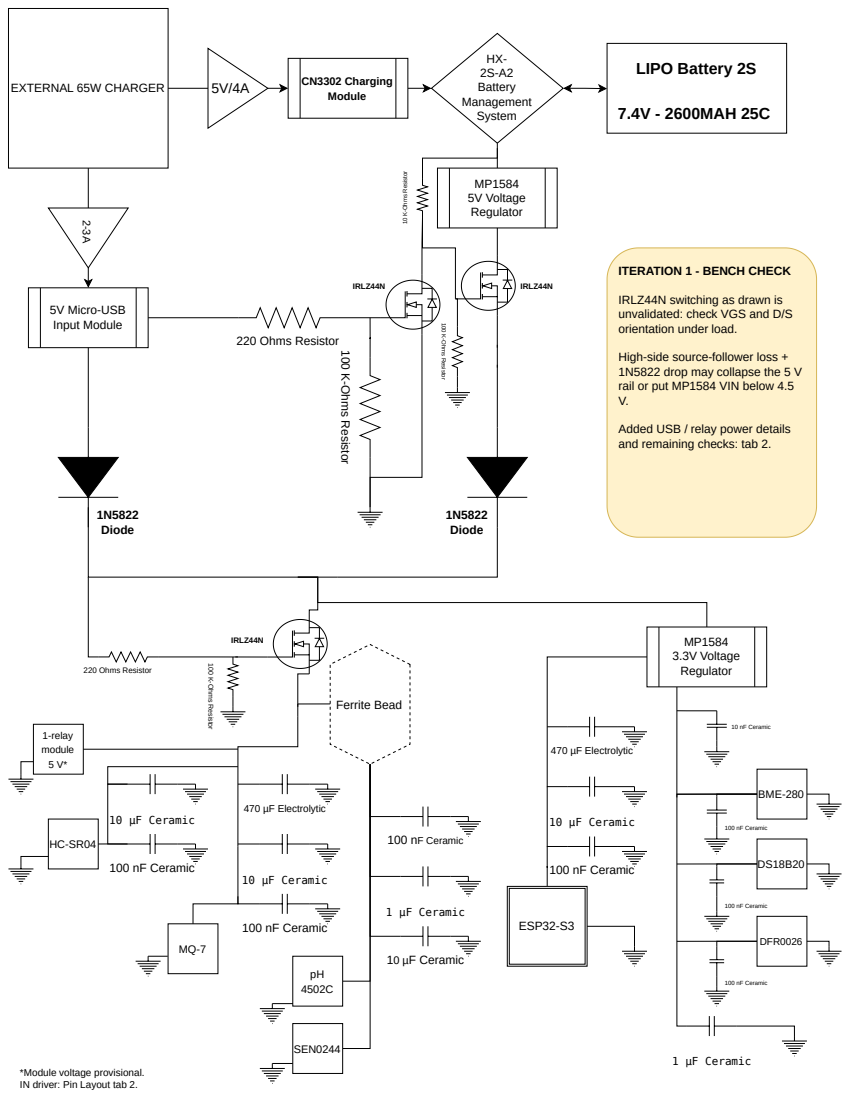
[picture p34: page 1]
EXTERNAL 65W CHARGER; 5V Micro-USB Input Module; CN3302 Charging Module; HX- 2S-A2 Battery Management System; MP1584 5V Voltage Regulator; 1N5822 Diode; 10 µF Ceramic; 470 µF Electrolytic; 100 nF Ceramic; 1 µF Ceramic; Ferrite Bead; SEN0244; 100 K-Ohms Resistor; 220 Ohms Resistor; IRLZ44N; MP1584 3.3V Voltage Regulator; ESP32-S3; BME-280; DFR0026; 10 nF Ceramic; 1-relay module 5 V*; 10 K-Ohms Resistor

ITERATION 1 - BENCH CHECK

IRLZ44N switching as drawn is
unvalidated: check VGS and D/S
orientation under load.

High-side source-follower loss +
1N5822 drop may collapse the 5 V
rail or put MP1584 VIN below 4.5

Added USB / relay power details
and remaining checks: tab 2.

*Module voltage provisional.
IN driver: Pin Layout tab 2.

# Power additions & first-iteration review

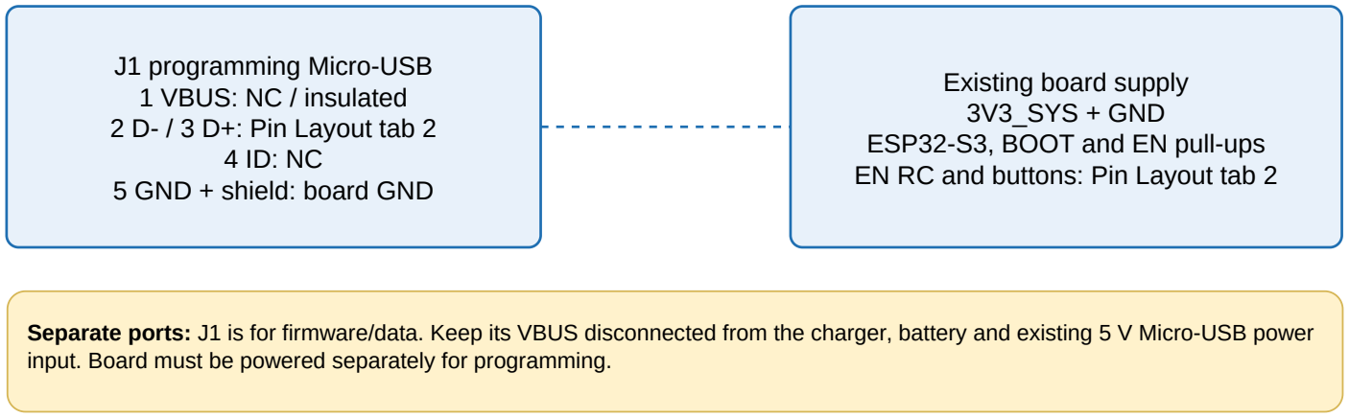
[picture p35: figure]
J1 programming Micro-USB 1 VBUS: NC / insulated 2 D- / 3 D+: Pin Layout tab 2 4 ID: NC 5 GND + shield: board GND; Existing board supply 3V3_SYS + GND ESP32-S3, BOOT and EN pull-ups EN RC and buttons: Pin Layout tab 2

Separate ports: J1 is for firmware/data. Keep its VBUS disconnected from the charger, battery and existing 5 V Micro-USB power input. Board must be powered separately for programming.

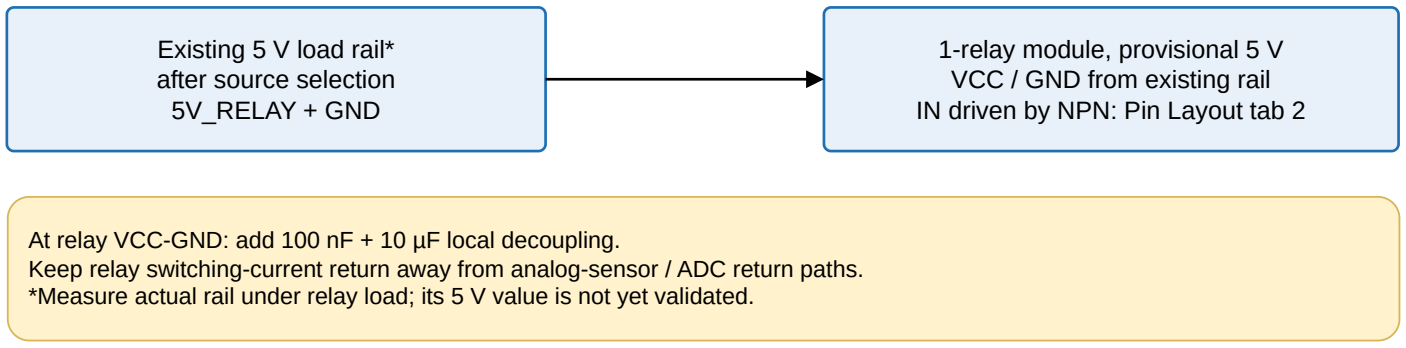
[picture p36: figure]
Existing 5 V load rail* after source selection 5V_RELAY + GND; 1-relay module, provisional 5 V VCC / GND from existing rail IN driven by NPN: Pin Layout tab 2

At relay VCC-GND: add 100 nF + 10 µF local decoupling.
Keep relay switching-current return away from analog-sensor / ADC return paths. *Measure actual rail under relay load; its 5 V value is not yet validated.

### 1. Power switch headroom - unresolved

N-channel devices used high-side need gate voltage above the source for low resistance. Check the three IRLZ44N stages as drawn. Gate threshold is not full conduction; record gate, source, drain and load voltage on USB and battery power.

2. 5 V rail and 3.3 V startup
MP1584 specifies VIN >= 4.5 V. Diode and MOSFET losses can violate that limit. Measure switchover, relay steps and Wi-Fi bursts; confirm stable 3.3 V and at least 500 mA supply capability for the ESP32-S3.

### 3. Charging and connectors

Confirm the charger actually provides each specified 5 V output concurrently. Check connector / cable current ratings, CN3302 2S charge setting, BMS B+/BM/B-/P terminals and balancing capability. A 65 W label alone does not establish 5 V / 4 A availability.

### 4. Bare-chip PCB work still required

These are block / signal diagrams. Confirm exact ESP32-S3 package and add all supply-pin decoupling, exposed-pad GND, required flash, 40 MHz crystal, RF matching / antenna and strap configuration before PCB layout.

### 5. Sensor and relay qualification

Verify actual module output voltages and common GND. MQ-7 heater cycling, ADC input range, pH calibration, relay trigger polarity / flyback and contact-load suppression remain bench checks. See the accompanying review notes for details.
