Zer0-Dayy/Hydroponics-Monitoring-System/PCB Design/Documentation/Assembly 1 To 1.pdf

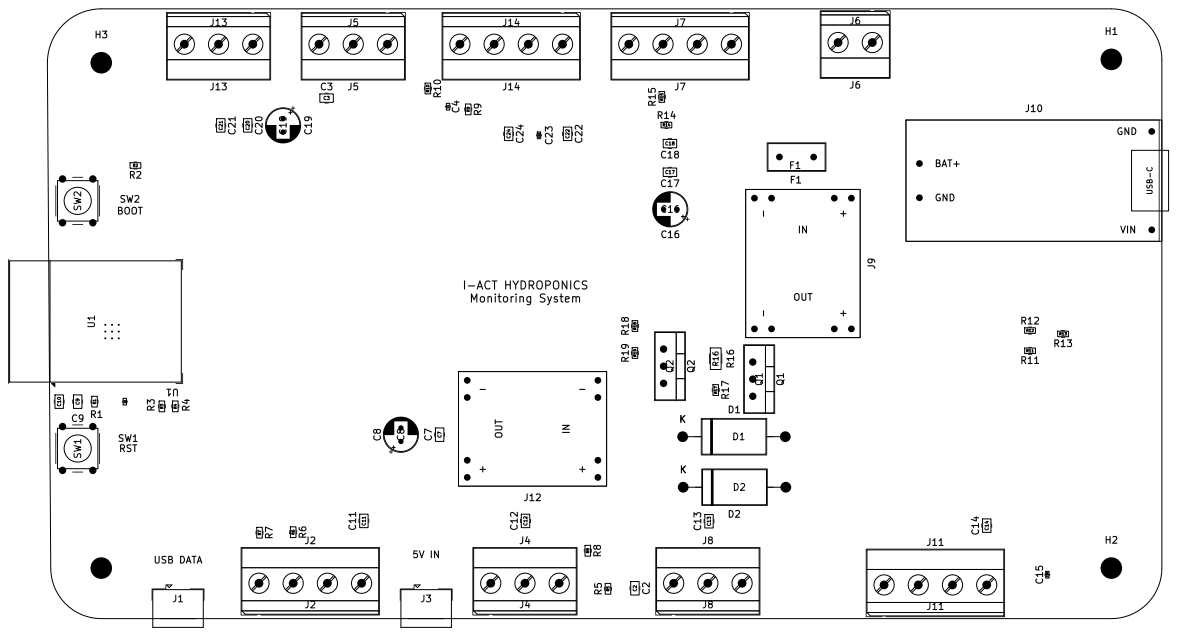
[picture p37: page 1]
