Zer0-Dayy/Hydroponics-Monitoring-System/PCB Design/Documentation/Back Copper.pdf

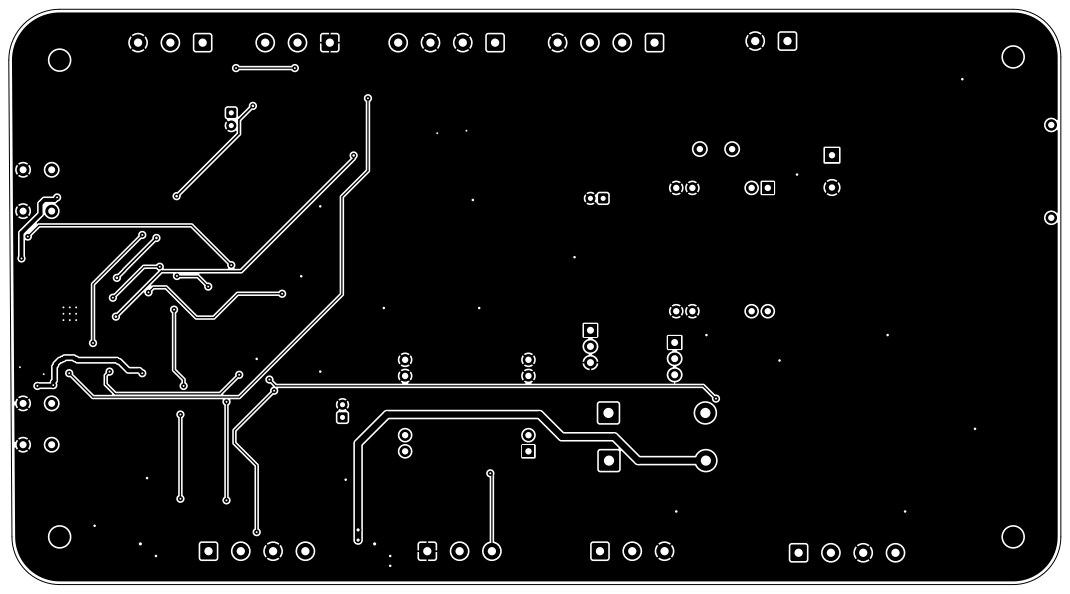
[picture p38: page 1]
