Zer0-Dayy/Hydroponics-Monitoring-System/PCB Design/Documentation/Back Markings 1 To 1.pdf

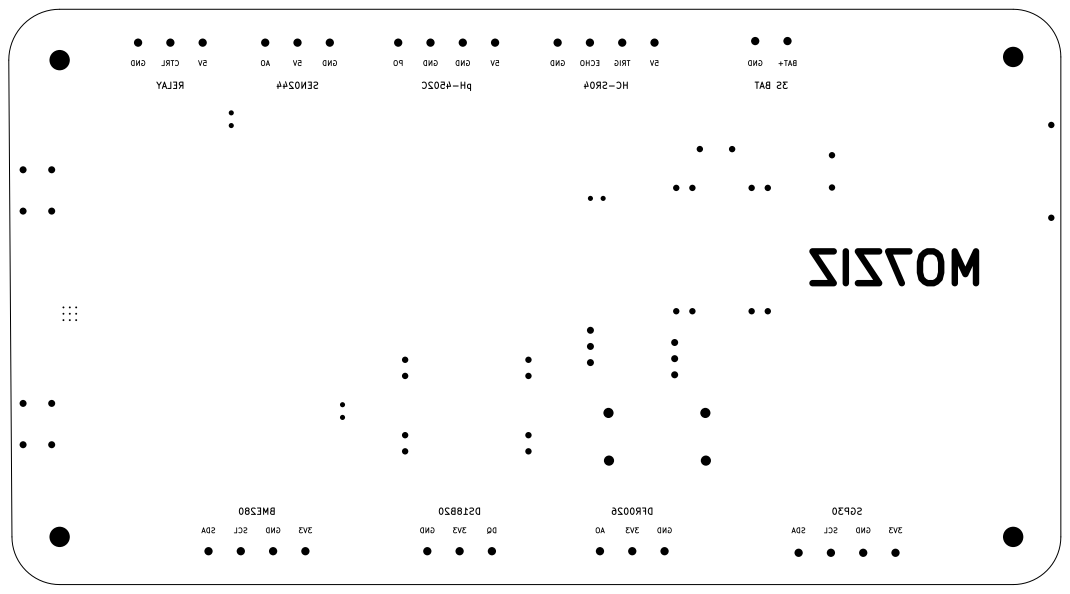
[picture p39: page 1]
