Zer0-Dayy/Hydroponics-Monitoring-System/PCB Design/Hardware/PCB Design.kicad_pcb

## KiCad design PCB Design/Hardware/PCB Design.kicad_pcb (2026-11-05)

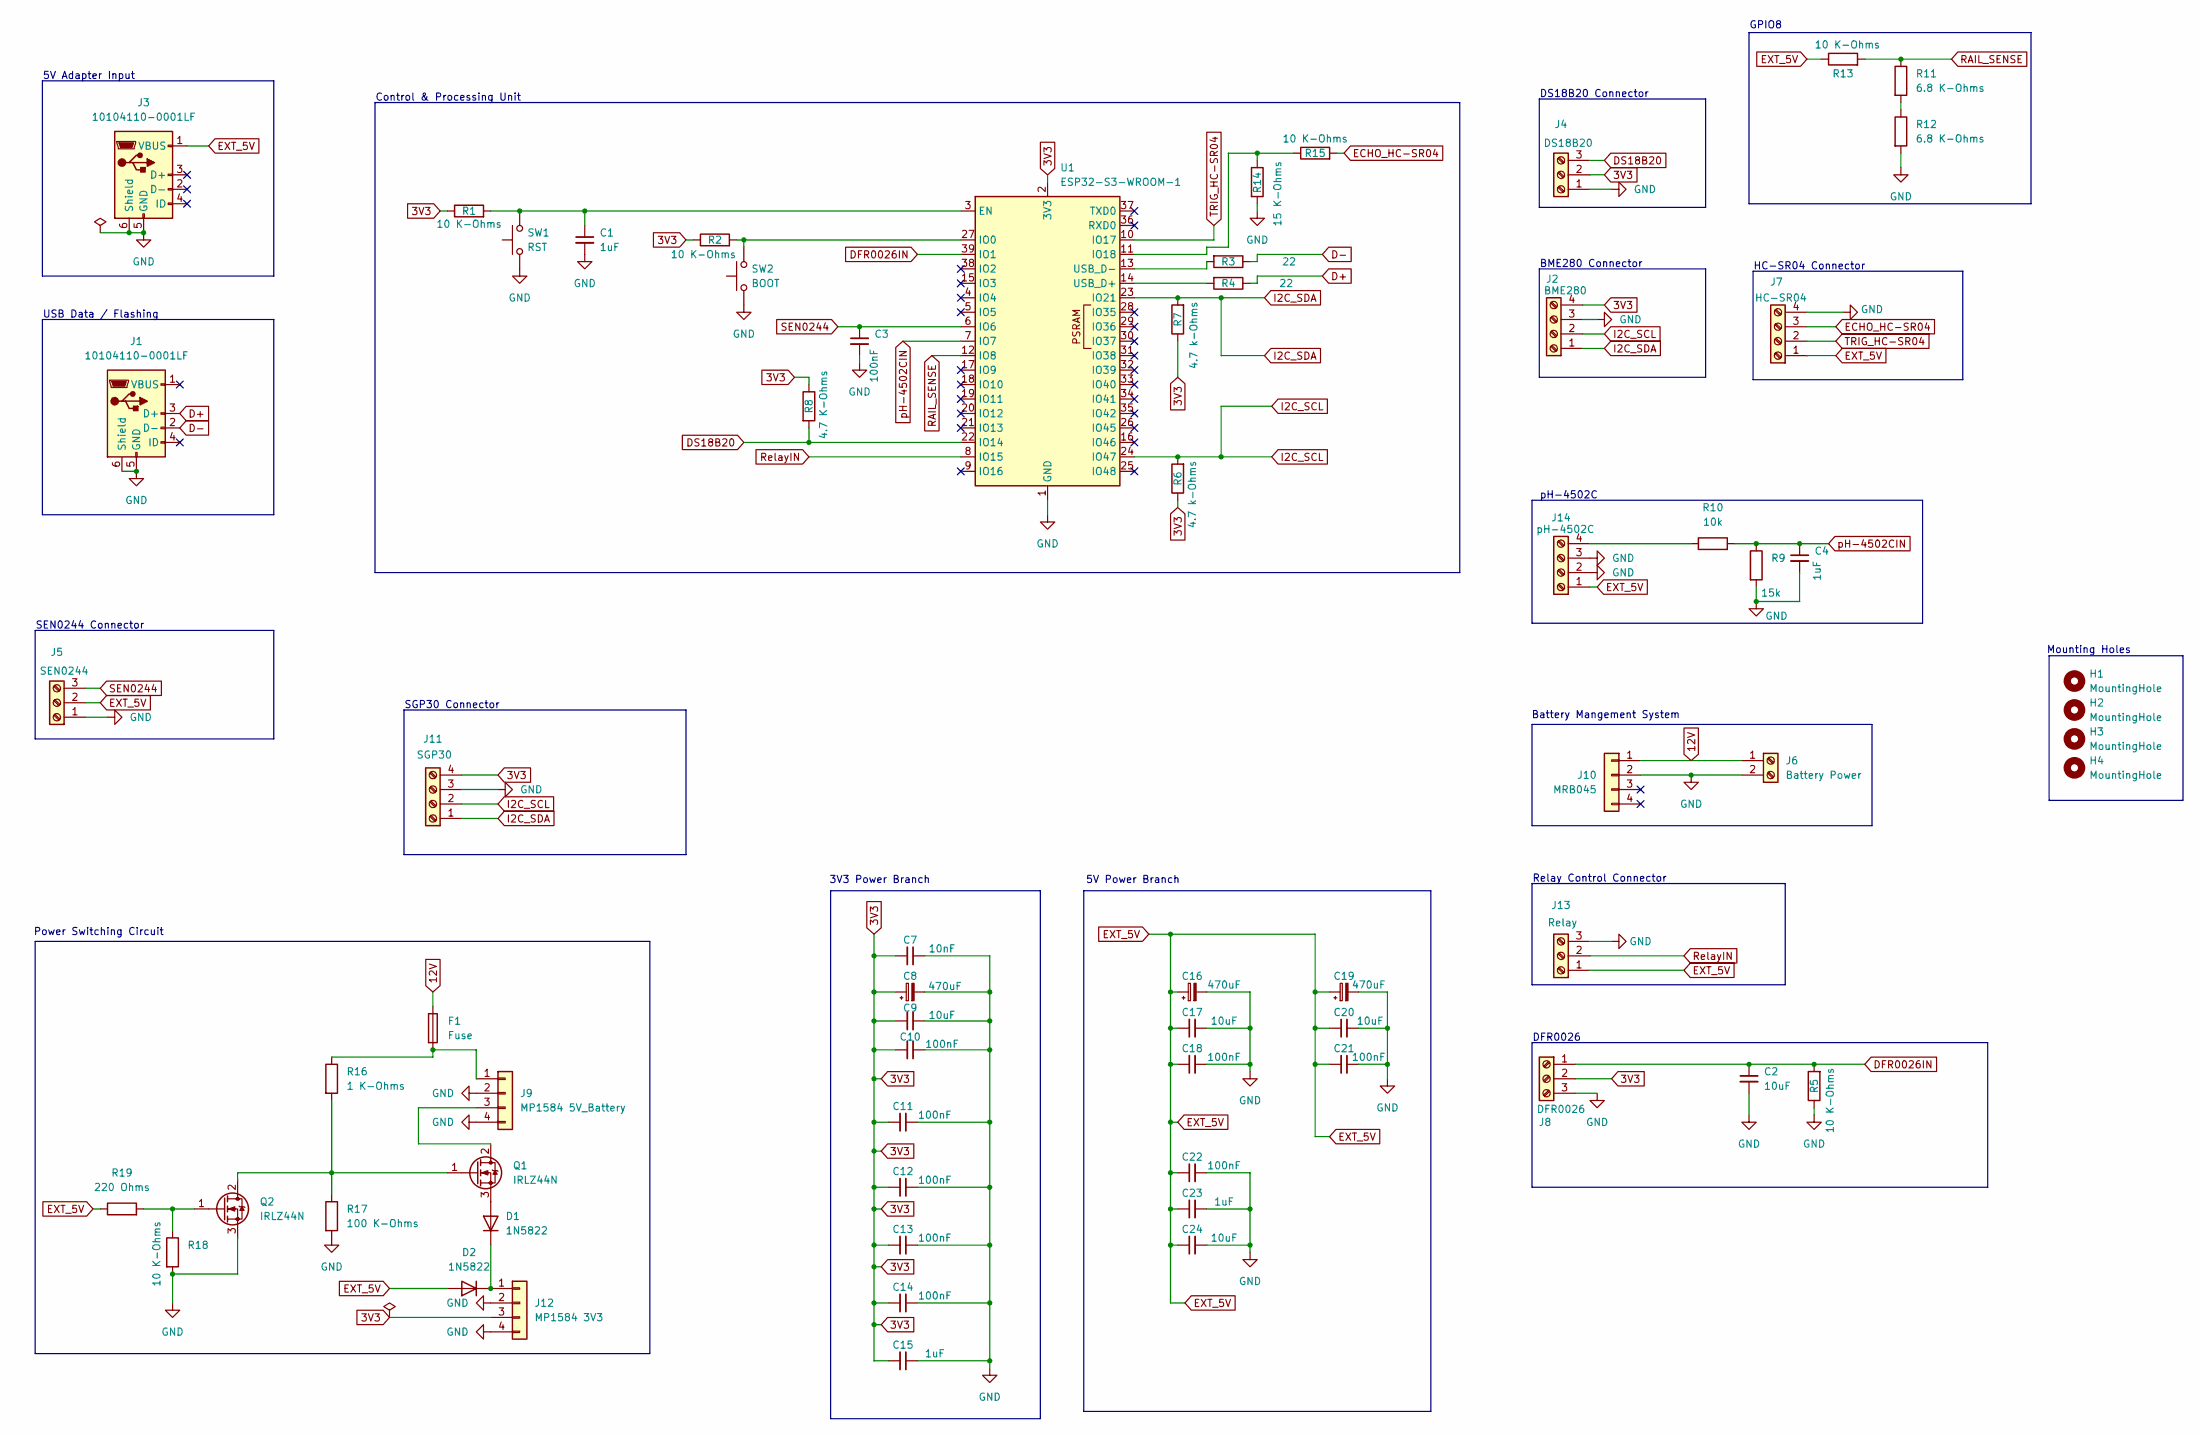
[picture p40: schematic PCB Design.kicad_sch]

Parts:
C1: 1uF; C_0402_1005Metric__C1
C2: 10uF; C_0805_2012Metric__C2
C3: 100nF; C_0805_2012Metric_Pad1.18x1.45mm_HandSolder__C3
C4: 1uF; C_0402_1005Metric__C4
C7: 10nF; C_0805_2012Metric__C7
C8: 470uF; CP_Radial_D5.0mm_P2.00mm__C8
C9: 10uF; C_0805_2012Metric__C9
C10: 100nF; C_0805_2012Metric__C10
C11: 100nF; C_0805_2012Metric__C11
C12: 100nF; C_0805_2012Metric__C12
C13: 100nF; C_0805_2012Metric__C13
C14: 100nF; C_0805_2012Metric__C14
C15: 1uF; C_0402_1005Metric__C15
C16: 470uF; CP_Radial_D5.0mm_P2.00mm__C16
C17: 10uF; C_0805_2012Metric__C17
C18: 100nF; C_0805_2012Metric__C18
C19: 470uF; CP_Radial_D5.0mm_P2.00mm__C19
C20: 10uF; C_0805_2012Metric__C20
C21: 100nF; C_0805_2012Metric__C21
C22: 100nF; C_0805_2012Metric__C22
C23: 1uF; C_0402_1005Metric__C23
C24: 10uF; C_0805_2012Metric__C24
D1: 1N5822; D_DO-201AD_P15.24mm_Horizontal__D1
D2: 1N5822; D_DO-201AD_P15.24mm_Horizontal__D2
F1: Fuse; Fuse_Littelfuse_395Series__F1
H1: MountingHole; MountingHole_3.2mm_M3__H1
H2: MountingHole; MountingHole_3.2mm_M3__H2
H3: MountingHole; MountingHole_3.2mm_M3__H3
H4: MountingHole; MountingHole_3.2mm_M3__H4
J1, J3: 10104110-0001LF; USB_Micro-B_Amphenol_10104110_Horizontal
J2: BME280; TerminalBlock_Phoenix_MKDS-1,5-4-5.08_1x04_P5.08mm_Horizont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
J4: DS18B20; TerminalBlock_Phoenix_MKDS-1,5-3-5.08_1x03_P5.08mm_Horizont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
J5: SEN0244; TerminalBlock_Phoenix_MKDS-1,5-3-5.08_1x03_P5.08mm_Horizont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
J6: Battery Power; TerminalBlock_Phoenix_MKDS-1,5-2-5.08_1x02_P5.08mm_Horizont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
J7: HC-SR04; TerminalBlock_Phoenix_MKDS-1,5-4-5.08_1x04_P5.08mm_Horizont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
J8: DFR0026; TerminalBlock_Phoenix_MKDS-1,5-3-5.08_1x03_P5.08mm_Horizont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
J9: MP1584 5V_Battery; MP1584EN_Module__J9
J10: MRB045; Charger_3S_TypeC_MRB045__J10
J11: SGP30; TerminalBlock_Phoenix_MKDS-1,5-4-5.08_1x04_P5.08mm_Horizont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
J12: MP1584 3V3; MP1584EN_Module__J12
J13: Relay; TerminalBlock_Phoenix_MKDS-1,5-3-5.08_1x03_P5.08mm_Horizont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
J14: pH-4502C; TerminalBlock_Phoenix_MKDS-1,5-4-5.08_1x04_P5.08mm_Horizont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
Q1: IRLZ44N; TO-220-3_Vertical__Q1
Q2: IRLZ44N; TO-220-3_Vertical__Q2
R1: 10 K-Ohms; R_0603_1608Metric__R1
R2: 10 K-Ohms; R_0603_1608Metric__R2
R3: 22; R_0603_1608Metric__R3
R4: 22; R_0603_1608Metric__R4
R5: 10 K-Ohms; R_0603_1608Metric__R5
R6: 4.7 k-Ohms; R_0603_1608Metric__R6
R7: 4.7 k-Ohms; R_0603_1608Metric__R7
R8: 4.7 K-Ohms; R_0603_1608Metric__R8
R9: 15k; R_0603_1608Metric__R9
R10: 10k; R_0603_1608Metric__R10
R11: 6.8 K-Ohms; R_0603_1608Metric__R11; Tolerance 1%
R12: 6.8 K-Ohms; R_0603_1608Metric__R12; Tolerance 1%
R13: 10 K-Ohms; R_0603_1608Metric__R13; Tolerance 1%
R14: 15 K-Ohms; R_0603_1608Metric__R14; Tolerance 1%
R15: 10 K-Ohms; R_0603_1608Metric__R15; Tolerance 1%
R16: 1 K-Ohms; R_1206_3216Metric__R16
R17: 100 K-Ohms; R_0603_1608Metric__R17
R18: 10 K-Ohms; R_0603_1608Metric__R18
R19: 220 Ohms; R_0603_1608Metric__R19
SW1: RST; SW_PUSH_6mm_H7.3mm__SW1
SW2: BOOT; SW_PUSH_6mm_H7.3mm__SW2
U1: ESP32-S3-WROOM-1; ESP32-S3-WROOM-1__U1

Connections:
3V3: C7.1, C8.1, C9.1, C10.1, C11.1, C12.1, C13.1, C14.1, C15.1, J2.4 (3V3), J4.2 (3V3), J8.2 (3V3), J11.4 (3V3), J12.3 (OUT+), R1.1, R2.1, R6.1, R7.1, R8.1, U1.2 (3V3)
12V: F1.1, J6.1, J10.1 (BAT+)
D+: J1.3 (D+), R4.1
D-: J1.2 (D-), R3.1
DFR0026IN: C2.1, J8.1 (SIGNAL), R5.2, U1.39 (IO1)
DS18B20: J4.3 (DQ), R8.2, U1.22 (IO14)
ECHO_HC-SR04: J7.3 (ECHO), R15.2
EXT_5V: C16.1, C17.1, C18.1, C19.1, C20.1, C21.1, C22.1, C23.1, C24.1, D2.2 (A), J3.1 (VBUS), J5.2 (3V3), J7.1 (5V), J13.1 (EXT_5V), J14.1 (EXT_5V), R13.1, R19.1
GND: C1.2, C2.2, C3.2, C4.2, C7.2, C8.2, C9.2, C10.2, C11.2, C12.2, C13.2, C14.2, C15.2, C16.2, C17.2, C18.2, C19.2, C20.2, C21.2, C22.2, C23.2, C24.2, J1.5 (GND), J1.6 (Shield), J2.3 (GND), J3.5 (GND), J3.6 (Shield), J4.1 (GND), J5.1 (GND), J6.2, J7.4 (GND), J8.3 (GND), J9.2 (IN-), J9.4 (OUT-), J10.2 (BAT-), J11.3 (GND), J12.2 (IN-), J12.4 (OUT-), J13.3 (GND), J14.2 (GND), J14.3 (GND), Q2.3 (S), R5.1, R9.2, R12.2, R14.2, R17.2, R18.2, SW1.1, SW2.1, U1.1 (GND), U1.40 (GND), U1.41 (GND)
I2C_SCL: J2.2 (SCL), J11.2 (SCL), R6.2, U1.24 (IO47)
I2C_SDA: J2.1 (SDA), J11.1 (SDA), R7.2, U1.23 (IO21)
unnamed: D1.2 (A), Q1.3 (S)
unnamed: D1.1 (K), D2.1 (K), J12.1 (IN+)
unnamed: F1.2, J9.1 (IN+), R16.1
unnamed: J9.3 (OUT+), Q1.2 (D)
unnamed: J14.4 (PO_ANALOG), R10.1
unnamed: Q1.1 (G), Q2.2 (D), R16.2, R17.1
unnamed: Q2.1 (G), R18.1, R19.2
unnamed: R11.2, R12.1
unnamed: C1.1, R1.2, SW1.2, U1.3 (EN)
unnamed: R2.2, SW2.2, U1.27 (IO0)
unnamed: R14.1, R15.1, U1.11 (IO18)
unnamed: R4.2, U1.14 (USB_D+)
unnamed: R3.2, U1.13 (USB_D-)
RAIL_SENSE: R11.1, R13.2, U1.12 (IO8)
RelayIN: J13.2 (RELAY_CTRL), U1.8 (IO15)
SEN0244: C3.1, J5.3 (AOUT), U1.6 (IO6)
TRIG_HC-SR04: J7.2 (TRIG), U1.10 (IO17)
pH-4502CIN: C4.1, R9.1, R10.2, U1.7 (IO7)

Notes on the sheet:
Control & Processing Unit
SEN0244 Connector
HC-SR04 Connector
3V3 Power Branch
SGP30 Connector
Power Switching Circuit
Mounting Holes
DFR0026
pH-4502C
BME280 Connector
Battery Mangement System
GPIO8
Relay Control Connector
DS18B20 Connector
5V Power Branch
USB Data / Flashing
5V Adapter Input

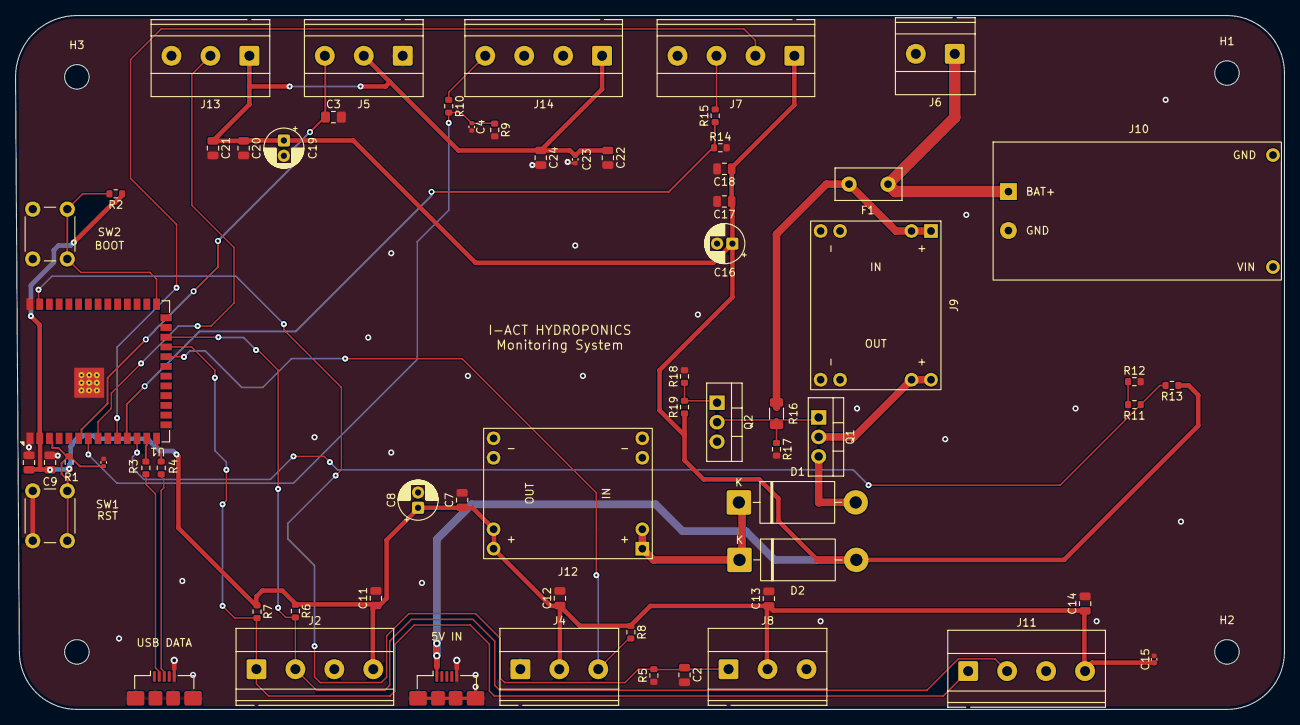
[picture p41: board PCB Design.kicad_pcb from above]

Board: 2 copper layers, 165.5 x 90.5 mm, 67 parts (0 on the bottom side), 29 nets.
