Zer0-Dayy/Hydroponics-Monitoring-System/(commit log)

2026-09-22 Minor Update To Redesign Specifications: Conductivity will still be measured via the old sensor due to time constraints.
2026-09-23 Add Flet BLE control app prototype
2026-09-23 Add ESP32-S3 BLE demo and page-scoped dashboard telemetry
2026-09-23 Default ESP demo build to original ESP32 target
2026-09-23 Fix Flet layout and Linux dock identity
    [InstallDesktop.py, Main.py]
2026-09-26 Initial Draft Of The Power Control System.
2026-09-27 Updated Power Delivery System according to currently available MOSFETs. It may be re-updated again if we get access/test more advanced SMD MOSFETs.
2026-09-27 Added a mechanism to unplug 5V sensors when using the battery backup system.
2026-09-27 Changed the name of the 'Ambient Light Sensor' to 'DFR0026' in the 'Electrical System Diagram' files.
2026-10-01 Fixed 'Electrical Circuit Diagram' and added a 'Pin Layout Diagram' for the ESP-32.
2026-10-14 Removed the old pin layout and eletrical system plan due to upcoming changes.
2026-10-16 New power circuit design after revision.
2026-10-17 Major overhaul of the Electrical circuit: Improved power delivery and UPS switching.
2026-10-24 Updated current relay module to Panasonic ALDP105.
2026-11-05 Major updates with a prototype PCB Design.
2026-11-05 New V1.5 revision of the PCB Design.
2026-11-11 Added the power analysis tree.
